samam624/ProjectTreebeard/MSV1/README.md

# MSV1: analog 555-timer probe

The first generation, from April 2026: an interdigitated comb electrode read by 555 timers, an RC
low-pass filter and a comparator. It showed soil moisture could be measured this way, and that the
analog output squeezed most of the useful range together.

| | |
| --- | --- |
| **Hardware** | [Probe PCB](hardware/) |
| **Write-up** | [Course report](<EEC284_Final_Paper (2).pdf>) (EEC 284, UC Davis) |
