samam624/ProjectTreebeard/MSV3/bootloader/README.md

# MSV3 recoverable OTA bootloader

`scripts/build_msv3_release.ps1` builds a board-specific Adafruit nRF52
bootloader from the pinned upstream 0.11.0 source and creates the production
application packages. The release configuration enables:

- single-bank application updates, using the Adafruit bootloader's default and bench-proven path;
- BLE recovery when no valid application exists (`DEFAULT_TO_OTA_DFU`);
- NIST P-256 signed DFU packages, with UF2 deliberately disabled;
- DFU compatibility tag `0x3356`, so generic Adafruit `0x0052` packages are rejected;
- the real active-high status LED on P1.10 and no nonexistent DFU buttons;
- SoftDevice S140 6.1.1 and its required internal-RC LFCLK boot path.

`DEFAULT_TO_OTA_DFU` currently makes automatic BLE recovery and bootloader USB CDC/DFU mutually
exclusive in the pinned upstream implementation. That is a known limitation, not the desired final
product behavior. The maintainer requires a future path that keeps both USB and BLE OTA while
preserving all recovery and authentication guarantees; see
`MSV3/docs/MSV3_USB_AND_BLE_OTA_COEXISTENCE_REQUIREMENT_2026-09-14.md`.

**Release 1.0.4 is the first build that addresses this, and it is BUILT BUT NOT INSTALLED.** No
probe runs it and none may until it passes the full acceptance list on probe 99. It runs **both
transports at once**: whenever the bootloader is in DFU mode and VBUSDETECT shows a cable, USB CDC
serial DFU is up for as long as the cable is there -- no timer, no window to miss, no mode to select
-- and BLE OTA runs on top of it rather than instead of it. With no cable, usb_init() is never
called and behavior is byte-for-byte 1.0.3. CDC only, never UF2: mass storage writes unsigned images
by definition and would route around signed-init verification, the device-type check and the version
floor. Mechanism, risks and the bench plan:
`MSV3/docs/MSV3_USB_AND_BLE_OTA_COEXISTENCE_DESIGN_2026-09-14.md`.

What made this safe is `dfu_transport_claim()`. Single-bank DFU erases the application before Init
authentication, and `dfu_register_callback()` holds a single `m_data_pkt_cb`, so two transports
feeding one bank would destroy the image with no recoverable copy on either side. The arbiter gives
the session to the first transport that presents traffic while the state machine is idle and refuses
the other until `dfu_init()` resets ownership -- the serial side silently consumes and drops the
packet so the host retries, the BLE side answers `NRF_ERROR_INVALID_STATE`. Do not add a third
caller of the DFU packet handlers without going through it.

The 1.0.4 patch is verified three ways, because they catch different failures. The source sentinel
(`MSV3_USB_BLE_COEXIST` in `src/main.c`) catches a patch that silently failed to apply. Two link-map
checks catch a patch that applied and still did not reach the binary -- one for
`msv3_usb_attach_if_vbus`, one for `dfu_transport_claim`. That second class is not hypothetical: the
first 1.0.4 build linked with no USB helper symbol at all because it had been inlined, exactly as
`check_dfu_mode()` already is. The helper is `noinline` for that reason. A source sentinel cannot
tell "compiled in" from "`#define` still sitting in the file".

Cost: FLASH 32,888 B (84.52%) on 1.0.3 to 33,208 B (85.34%) on 1.0.4, leaving about 5.7 KB in the
38 KB region. There is room for a fix, not for another feature.

MSV3 release 1.0.2 added an on-device monotonic application-version floor after a signed BLE
activation. Release 1.0.3 retains that protection and reserves the final eight bytes of RAM at
`0x2003FFF8` for the application's watchdog-loop recovery counter. The application linker reserves
the same address. Guard 2 must not be enabled with bootloader 1.0.2 or older.

That rule is now ENFORCED rather than merely written down, in two places. Every image
stamps `MSV3-GUARD2:1` or `MSV3-GUARD2:0` into itself, and `scripts/msv3_fleet.py` reads it
back out of a package: `ble_ota_update.py` refuses to transfer a guard-enabled image to a
probe whose `bootloader` in `MSV3/fleet.json` predates 1.0.3, and
`MSV3/scripts/arduino_msv3_probe.ps1` refuses to build one. Measured 2026-09-09 from
`vector[0]` of each release hex: 1.0.1 and 1.0.2 boot with MSP `0x20040000`, so the retained
record is the first memory their stacks descend into; 1.0.3 boots with MSP `0x2003FFF8`.
An image built before the marker existed carries none, and is accepted only on a bootloader
that already reserves the record, or when its image SHA-256 is pinned in that probe's
`legacy_package_sha256`.

The private key defaults to `MSV3/.secrets/msv3-dfu-signing-private.pem`, which
is ignored by Git. The generated bootloader contains its public key, so losing
the private key after the SWD pads are coated would make future signed updates
impossible. The build now fails if the key is missing instead of silently making
an incompatible one. Use `-GenerateSigningKey` only when deliberately establishing
a new trust root that will be installed over SWD, and make an offline backup before
coating a production board.

Generated release artifacts and a SHA-256 manifest go under
`MSV3/bootloader/generated/<version>/`. The future OTA package is signed. The
separately named `initial-install-from-stock` package is deliberately unsigned
because the existing stock bootloader cannot parse Adafruit's signed extended
init packet; use it exactly once to migrate an accessible board, then retain it
only as a factory/SWD-adjacent artifact.

The application version is explicit in every package. Stock Adafruit 0.11.0 and MSV3 1.0.1 do not
persist it. MSV3 1.0.2+ stores a monotonic floor in the bootloader settings page and refuses a
lower signed application after authenticating its init packet. Equality is deliberately allowed
so the exact known-good rescue package remains reinstallable. `MSV3/fleet.json` keeps a second,
host-side version floor and must be updated after every successful transfer.

Single-bank DFU erases the running application before writing its replacement, so
an interrupted update does not preserve the old application. It does remain
recoverable: an erased or invalid application makes the bootloader advertise its
BLE DFU service indefinitely. Release 1.0.0's experimental dual-bank image must not
be installed; on the bench it accepted and validated the application transfer but
failed the subsequent bank-0 boot validation.

Do not update this bootloader over BLE. Install it once over SWD before coating, finish
provisioning with a signed BLE application install so the anti-rollback floor is seeded, verify the
running DIS build ID and advancing wake counter, archive the equality-version rescue package, and
back up the signing key offline. The current production checklist is
`MSV3/docs/MSV3_FINAL_OTA_PRECOATING_HANDOFF_2026-09-08.md`.
