samam624/ProjectTreebeard/MSV4/hardware/MSV4_Probe_Enclosures/README.md

# MSV4 low-profile probe enclosures

This directory contains four printable, electronics-only enclosures derived
from the actual `../MSV4.step` assembly:

- **Integrated solar** - an MSV2-style lid with a bonded 36 x 30 mm panel
  recessed into its top.
- **Arm solar** - an MSV3-style articulated mount with two printable arms and
  a 36 x 30 mm panel frame.
- **Minimum-profile integrated solar** - a screwless two-piece enclosure with
  a thin closed back/base and a bonded solar lid. It has no gasket, screws,
  inserts, or moving parts. A PCB-shaped groove in the base registers the board
  during assembly.
- **Minimum-profile arm solar** - the same bonded, PCB-groove body fit with the
  proven external pivot bosses, arms, and panel frame. Its plain lid has no
  panel pocket. The body has no case screws or gasket; the articulated mount
  still uses its four pivot screws and inserts.

All four enclosure bases have a teardrop window centered over the upper D1 LED
package on the back of the PCB. The point faces upward toward the antenna/top
edge. Fill this window flush with optically clear epoxy after assembly to make
the status LED visible without leaving an open water path.

All variants leave the sensing blade exposed. Version 5 follows the actual PCB
shoulders into a 20.4 mm-wide neck around the 18 mm blade. In side profile, the
top and bottom faces slope down to a 3.0 mm-thick shell around the 1.6 mm PCB,
instead of ending in a full-thickness rectangular wall. The central body is
33.2 mm wide; only the front screw shoulder reaches 36.6 mm to carry the front
pair of M2 screws. Overall length is 53.7 mm.

Version 5.3 changes how the two screw-closed variants go together and how all
three look:

- The case screws go in from the back (the base, the face with the LED
  teardrop). Each head sits in a recessed 90-degree countersink in the base
  back, and the inserts are now in the lid. The lid top has no screw holes.
- The arm pivot bosses on the base and the pivot lugs on the panel frame are
  flat on the back of their part, so both print flat on the bed.
- The outer perimeter of every back and top face has a 45-degree chamfer:
  0.6 mm on the screw-case backs, 1.2 mm on the arm lid top, 0.8 mm on the
  integrated lid top, and 0.8 / 0.4 mm on the minimum-profile back / top. Each
  is as large as the screw-head recesses or the panel-pocket rim beside it
  allow; they are the `...Chamfer` parameters in the generator.

The top-side cavity roof is 7.0 mm above the PCB. Version 5.2 raised it from
4.0 mm because the battery actually fitted is a 3 mm-thick 301020-class cell
that rests on top-side components, not the 2 mm cell first assumed. The base is not sized around the battery: its floor follows the actual
bottom-side component envelope from `MSV4.step`, with 0.354 mm clearance below
the lowest SWD/LED geometry and a 1.2 mm closed floor. The battery belongs
above the PCB.

The renders below are from version 5 and show the earlier, 3 mm lower lids
with lid-side screws, round pivot mounts, and unchamfered edges.

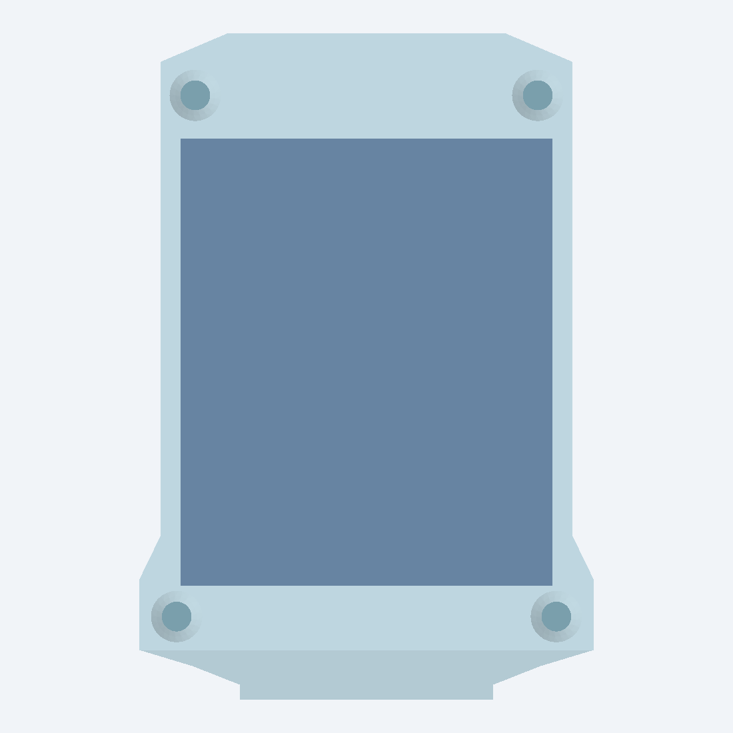
[picture p20: MSV4/hardware/MSV4_Probe_Enclosures/renders/integrated_v5_top.png]
Low-profile integrated solar enclosure


Low-profile arm solar enclosure

Minimum-profile integrated solar enclosure

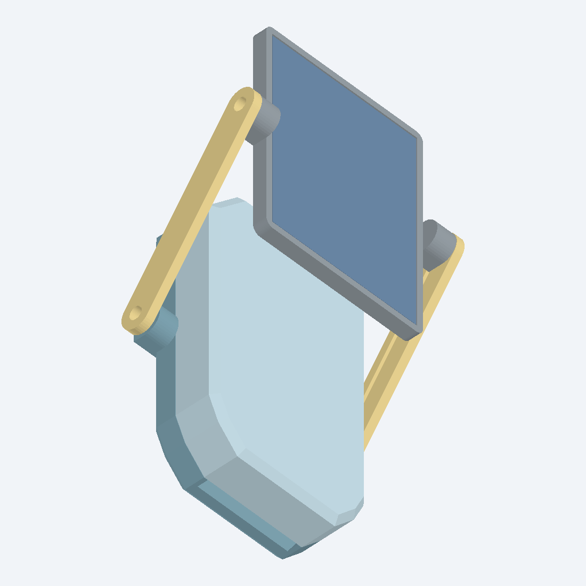
[picture p21: MSV4/hardware/MSV4_Probe_Enclosures/renders/minimum_profile_arm_v5_5_isometric.png]
Minimum-profile arm solar enclosure v5.5


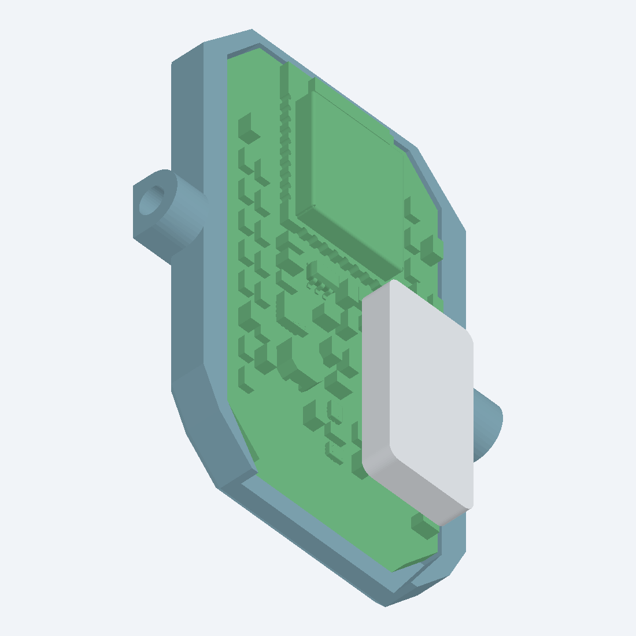
[picture p22: MSV4/hardware/MSV4_Probe_Enclosures/renders/minimum_profile_arm_v5_5_fit_open_isometric.png]
Minimum-profile arm open PCB fit check


## Deliverables

`output/` holds one drag-and-drop print file per enclosure and nothing else:

- `MSV4_arm_solar_PRINT.3mf`
- `MSV4_integrated_solar_PRINT.3mf`
- `MSV4_minimum_profile_solar_PRINT.3mf`
- `MSV4_minimum_profile_arm_solar_PRINT.3mf` - the minimum-profile body with the
  same proven PCB-shaped registration groove, four broad PCB support pads,
  pivot geometry, arms, and panel frame
  as the earlier variants (added 2026-10-30, not yet printed). The lid is plain
  at the arm-lid height with one 3 mm wire exit on the left. There are no case
  screws or gasket; tape the body closed for a fit test, then bond the seam.
  The normal release validator checks this variant and rejects the duplicate
  thin shelves/fins that were present in its first draft.

Each imports into Bambu Studio or OrcaSlicer as separate, named, pre-oriented
objects. See `PRINTING.md` before printing.

`output/reference/` holds everything else: the STEP bodies and assemblies, the
fit-check assemblies, the design and validation reports, and the optional TPU
gasket.

## Recommended development workflow

Start with the two reopenable, screw-closed versions while the electronics are
still being developed:

1. Print and test the **integrated solar** enclosure as the static-panel,
   non-arm baseline.
2. Print and test the **arm solar** enclosure to determine whether adjustable
   panel angle produces enough practical charging benefit to justify the extra
   parts, hardware, assembly time, and potential weather-sealing points.
3. Compare charging performance, placement flexibility, durability, water
   resistance, handling, and overall bulk while firmware, sensing behavior,
   battery operation, and solar charging are still being finalized.
4. Move to the permanently bonded **minimum-profile integrated solar**
   enclosure only after those systems are stable enough that routine access to
   the PCB is no longer needed.

The minimum-profile arm variant is the glued-seam/no-body-screw experiment. Do
not treat it as the default until one physical fit and leak test confirms it.

The normal assemblies contain the enclosure parts plus a clearly named
do-not-print solar-panel reference. The fit-check assemblies additionally
contain the corrected PCB and an illustrative 10 x 20 x 3 mm top-side battery
placement reference. The minimum-profile fit check also includes a red E73
antenna keepout reference. The STEP assemblies open directly in Fusion 360
and preserve separate assembly solids; no Fusion conversion is required.

## Design basis

The source STEP contains 233 solids. Its exported PCB substrate is 0.41148 mm
thick, while the MSV4 fabrication files specify 1.60 mm FR4. The fit-check
models preserve the top surface and move the bottom-side components down by
1.18852 mm. This avoids false clearances from the thin raw export.

The reconstructed 1.60 mm substrate is checked bidirectionally against the
original STEP footprint. The mismatch volume is 0 mm3. The validator also
checks the complete straight blade through both halves of the split throat;
the collision volume is 0 mm3 in both variants.

Measured and checked version 5.3 clearances are:

- 0.35 mm at each PCB side
- 3.898 mm above the tallest top component within the 7.0 mm roof envelope
- 0.354 mm below the lowest corrected bottom component
- 0.250 mm below the illustrative top-side battery placement
- 2.100 mm between that 3.2 mm battery reference and the internal roof; this
  spare headroom is intentional for the first fit print and is expected to be
  reduced afterwards
- 0.10 mm nominal PCB rail clamp interference
- 2.833 mm minimum arm sweep clearance over the lid
- 0 mm3 battery-to-component, panel-to-pocket, and reference-to-shell collision
- every screw-head recess wall closed against the back chamfer, and the lid
  top closed above all eight screws

The integrated-panel central case is 13.90 mm thick and the arm-mount central
case is 12.50 mm thick. The arm pivot bosses end on the base back plane and add
no thickness. These stacks retain a 1.2 mm closed
floor, a 1.0 mm arm-lid roof, and a 0.8 mm solar-pocket back wall, so the
extra battery room comes entirely from height: none of those skins had 3 mm
to give.

The minimum-profile enclosure is 13.65 mm thick overall and 32.4 x 50.2 mm in
plan. Its base provides a 1.0 mm closed back below the component cavity. The
groove follows the real PCB head and shoulder with 0.25 mm XY clearance. Four
3 x 4 mm rounded pads rise directly from the floor and support the bare PCB
underside at Z = -1.60 mm; they avoid the six bottom-side components clustered
near the LED end. The lowest corrected back-side component retains 0.304 mm
floor clearance. The panel ends at Y = 140.00 mm; the E73 antenna keepout begins at
Y = 140.75 mm, giving a checked 0.75 mm plan-view separation.

The minimum-profile arm body uses that same 32.4 x 50.2 mm plan, registration
groove, and four floor-tied support pads, with the proven pivot bosses bringing only the local maximum width to
40.2 mm. Its closed body is 12.25 mm thick. Validation finds 0 mm3 PCB,
component, base/lid, wire-path, or arm-sweep collision, and explicitly finds
0 mm3 of the rejected draft's duplicate interior shelves and compression fins.

The solar-panel pocket is 36.4 x 30.4 x 1.6 mm. The physical panel thickness
was not supplied. Measure it before committing to a final print and change
`solarPanelRecessDepth` in `design/generate_enclosures.mjs` if necessary.
Version 5.1 places the two 1.6 mm lead passages as a centered pair, 4.0 mm
apart, to match the rear terminals on the new 2.5 V panels. This centered
layout is shared by the integrated lid, minimum-profile lid, and arm frame.

On the arm variant, both leads enter the case through a single 3.0 mm hole in
the negative-X side wall of the lid at the pivot station, as on MSV3. It
replaces two 1.6 mm holes that stopped 0.05 mm short of the PCB compression
rail and so never opened into the cavity. The panel frame sits 3 mm higher
than in version 5.1 so the panel keeps its height above the taller lid.

The panel frame is 2.6 mm thick, too thin to hold an M2 insert, so its pivot
lugs cannot be flush with both faces. They are flat on the frame back and rise
2.8 mm above the panel face at the two side edges. The pivot axis is therefore
1.4 mm higher than in version 5.2 (Z = 18.4 mm), the frame itself has not
moved, and the arms are 0.8 mm longer between centers.

## Water resistance

The design keeps the useful MSV3 features: continuous PCB retention, a split
close-fit blade throat, blind insert pockets, base-owned arm pivots, covered
wire passages, and a gasket land. The lid is now one continuous top skin. This
removes the old two-level, scalloped roof that looked like an inverted tray.
With the screws entering from the back, that skin is also unbroken by
fasteners; the screw bores are open only on the base back.

The seal path is a 0.80 mm-wide by 0.55 mm-deep groove in the seam face of the
base. It moved there from the lid in version 5.3 because the lid's insert
pockets would have broken into it. Use silicone cord,
formed-in-place RTV, or the supplied 0.8 mm TPU gasket. The gasket is open only
at the blade exit, where the split throat must be sealed with neutral-cure RTV
or a suitable potting compound. Seal the panel perimeter and wire passages as
described in the print guide.

This is a waterproof-oriented FDM design, not an IP-rated housing. Leak-test an
empty enclosure before installing electronics.

Both minimum-profile enclosures have a closed back but no body gasket or case
fasteners.
After confirming the board is fully seated in its base groove, bond and seal
the complete base-to-lid seam with electronics-compatible epoxy or outdoor
polyurethane adhesive. Seal the panel perimeter, wire passages, probe exit,
and LED window before leak testing.

## Fasteners

The integrated and arm cases use:

- 4 x M2 x 8 mm, 90-degree countersunk flat-head screws (both versions)
- 4 x M2 heat-set inserts, nominally 3 mm OD x 3 mm long

The screws are driven from the back. Each head pocket in the base back is a
4.2 mm x 0.4 mm recess above a 90-degree countersink, so a standard 3.8 mm
head finishes level with or up to 0.3 mm below the back face. The insert
pilots are in the lid seam face: blind, 2.90 mm diameter x 3.20 mm deep, with
tip relief to 4.2 mm above the seam. The arm variant
adds four M2 x 5-6 mm pivot screws and four more inserts of the same size.
Insert brands vary; verify one sacrificial pocket before installing all of them.
The minimum-profile integrated enclosure uses no screws, inserts, gasket, or
other hardware; its lid is permanently bonded to the base. The minimum-profile
arm enclosure also bonds its lid, but still needs the four pivot screws and
inserts listed above for the articulated mount.

## Regeneration and verification

From this directory:

```powershell
node design/generate_enclosures.mjs
node tools/validate_enclosures.mjs
```

The validator checks solid counts, source-PCB fidelity, component collisions,
fastener openings, arm sweep, assembly overlap, and that every object in each
print file is a watertight mesh sitting on the bed. The current report is
`output/reference/MSV4_enclosure_validation_report.json`.

If native Fusion archives are desired later, run
`fusion/MSV4_Enclosure_Assemblies/MSV4_Enclosure_Assemblies.py` from Fusion's
Utilities > Scripts and Add-Ins dialog. It imports the checked STEP assemblies
and writes F3D plus Fusion-translated STEP files to
`output/reference/fusion_exports/`.
