samam624/ProjectTreebeard/docs/SWD_FLASHER.md

# ESP32-S3 as an SWD flasher for nRF52840

`arduino/MSV2_ESP32_SWD_Flasher` turns a spare ESP32-S3 devkit into a standalone
SWD debug adapter for nRF52840 targets — built for and bench-validated against
a bare Ebyte E73-2G4M08S1C module (the MCU used on MSV3), and equally usable
against XIAO nRF52840 Sense probes. It bit-bangs the ARM SWD protocol from
scratch on three GPIOs — no OpenOCD, no J-Link, no external debug probe
hardware needed. Useful for boards with no USB/DFU bootloader at all, or a
broken one.

**Status: fully working, end to end, on real hardware (2026-08-20).** On a
bare Ebyte E73-2G4M08S1C module (hand-held pad contact, no soldering):
`id`/`probe` confirmed a real, unprotected nRF52840 (`DPIDR = 0x2BA01477`,
`AP0 IDR = 0x24770011`, correct 1MB/4KB-page flash geometry); the chip's prior
content was an incomplete MBR-only fragment, not a working bootloader; a full
mass erase plus 5-region bootloader install (`pca10056_bootloader-0.11.0_s140_6.1.1.hex`)
completed with every segment verified; and after `run`, the chip booted into
the new bootloader and enumerated correctly as `NRF52BOOT` with matching
`INFO_UF2.TXT` (version, board ID, and SoftDevice all exactly as flashed). A
test application (`arduino/MSV3_E73_LED_Test`, blinks the D2 LED on P1.10)
was then compiled for `adafruit:nrf52:pca10056`, converted to `.uf2`, and
drag-and-dropped onto the `NRF52BOOT` drive — it booted and the LED blinked,
confirming the bootloader can actually accept and run new firmware, not just
enumerate. See "Bring-up history" below for the issues hit and fixed along
the way.

## Wiring

3.3V logic on both sides — no level shifting.

| ESP32-S3 GPIO | Signal | Target (nRF52840) |
|---|---|---|
| GPIO5 | SWCLK | SWCLK |
| GPIO6 | SWDIO | SWDIO |
| GPIO7 | nRESET | RESET |
| GND | GND | GND |

Do **not** connect target VDD to the ESP32-S3. The target keeps powering itself
(its own USB/battery) — this adapter only drives debug signals.

On a bare E73-2G4M08S1C module, SWDIO/SWCLK/RESET are castellated pads on the
module itself (check Ebyte's E73-2G4M08S1C datasheet pinout for exact pad
locations). On a XIAO nRF52840 Sense, they're unpopulated test points on the
underside of the board instead — check Seeed's pinout diagram for that case.

## Building and flashing the adapter itself

```powershell
.\scripts\arduino_swd_flasher.ps1 -Action compile
.\scripts\arduino_swd_flasher.ps1 -Action upload -Port COM3
```

Swap `COM3` for whatever `.\scripts\arduino_swd_flasher.ps1 -Action board-list`
reports — ports shift.

## Talking to it

It's a plain USB-serial command console at 115200 baud (native USB CDC, so a
reset is a real USB disconnect/reconnect — same caveat as the display receiver,
see `flash-esp32-display`). Use `scripts/serial_capture.py` if you need a
capture that survives a reset; a live interactive session (`arduino-cli monitor`
or a terminal program) is fine for the id/halt/rd/wr commands since those don't
reset the adapter itself.

```
help                    - list commands
id                      - connect (read-only) and report DPIDR / AP IDR / flash geometry
probe                   - loop checking for SWD contact, for hand-held wiring bring-up
halt                    - hardware-reset target, then halt the core
run                     - resume core execution, release debug
reset                   - pulse nRESET only, no SWD traffic
rd <hexaddr>            - read one 32-bit word
wr <hexaddr> <hexval>   - write one 32-bit word (raw, expert use — this is a
                          direct AHB bus write, no safety net)
erase CONFIRM           - mass-erase the entire target flash
flash <hexaddr> <declen> - receive <declen> raw bytes over serial (chunked,
                          acked), then erase+program+verify at <hexaddr>,
                          with live progress lines
mem                     - report free heap AND largest contiguous block
                          (the second number is what actually bounds
                          `flash`'s image buffer)
restart                 - soft-reboot this adapter (clears heap fragmentation
                          from a long interactive session; doesn't touch the
                          target)
```

### Hand-held test-point contact (no soldering)

If you're holding wire tips against a board's SWD test pads instead of
soldering, `id`/`erase`/`flash` aren't the right first tool — a momentary
contact drop mid-transaction just looks like a generic failure, with no signal
about whether the wiring is right or you just need to press harder. Use
`probe` instead: it retries a lightweight connect check ~7x/second and only
prints on a state change, so you can watch it live while adjusting pressure.

Open a live terminal against the port (`arduino-cli monitor -p COM3 -c
baudrate=115200`, or PuTTY, or the Arduino IDE's Serial Monitor — any of these
work fine here since, unlike a flash/reset capture, this is a plain ongoing
session with no port renumbering involved), type `probe`, then press the wires
against the pads:

```
probe: watching for SWD contact. Send any character to stop.
probe: still no response (attempt 20)
>>> CONTACT MADE (attempt 34) DPIDR = 0x2BA01477
>>> contact lost
>>> CONTACT MADE (attempt 41) DPIDR = 0x2BA01477
```

A real target should report the *same* DPIDR value every time contact is
made — if it comes back with different nonzero garbage on different attempts,
that's a wiring/contact problem (e.g. SWCLK and SWDIO swapped, or a marginal
short), not a working connection, even though `probe` reported "contact." Once
you're getting solid, repeatable contact, send Enter to stop `probe` and move
on to `id` for the full picture (flash size, page count, etc.).

### Typical bring-up sequence on a new target

1. Wire it up, power the target normally, run `id`. Confirm `DPIDR`, the AP CSW
   readback matches what was written, and FICR page size/flash size look like a
   real nRF52840 (1MB flash / 4KB pages), not `0xFFFFFFFF` (see APPROTECT note
   below).
2. `rd`/`wr` a scratch RAM address (e.g. `0x20000000`) to sanity-check memory
   access before touching flash.
3. `erase CONFIRM`, then `id` again to confirm the chip still responds.
4. Flash a real image (see below), or a small known-good test region with
   `flash <hexaddr> <declen>` first if you just want to sanity-check the write
   path.

### Flashing a compiled Arduino sketch (single region, address 0)

Export a `.bin` from `arduino-cli compile --export-binaries` — that's a flat
image meant to run from address 0, not an Intel HEX file with embedded
addresses, so `scripts/swd_flash_hex.py` doesn't apply here. Instead, issue
`flash 0 <length>` yourself in an interactive session and send the raw file
bytes right after the `flash: send raw binary now` prompt (any short script
that writes the file to the serial port works; match the byte count exactly,
since the device only reads that many bytes before returning to command mode).

This is only relevant for a chip with **no bootloader** (or one you're
deliberately bypassing). Once a target has a working bootloader installed
(see below), flashing new applications to *that* chip no longer needs SWD at
all — see "Flashing an application once the bootloader is installed" further
down.

### Flashing a bootloader (multi-region .hex, e.g. restoring USB/DFU)

A bootloader image isn't one flat block — it's several disjoint regions (MBR,
SoftDevice, bootloader code, a settings page, and a UICR register that tells
the chip's own MBR where the bootloader lives). `scripts/swd_flash_hex.py`
parses a `.hex` file into its contiguous segments and drives one `flash` call
per segment, handling addresses automatically:

```powershell
python scripts/swd_flash_hex.py --port COM3 --hex arduino/MSV2_ESP32_SWD_Flasher/bootloaders/pca10056_bootloader-0.11.0_s140_6.1.1.hex --mass-erase
```

That bundled hex is Nordic's generic **pca10056** (nRF52840-DK) board profile
from [Adafruit_nRF52_Bootloader](https://github.com/adafruit/Adafruit_nRF52_Bootloader)
(MIT licensed) — the right starting point for a **bare nRF52840 module with
no board-specific bootloader of its own** (this project's actual hardware is
an Ebyte E73-2G4M08S1C module, not a XIAO board — see
`bootloaders/README.md` for why `pca10056` and not a XIAO-specific build).
The same overall recipe (bit-banged SWD probe → mass erase → program the hex)
is independently confirmed working for bare E73-2G4M08S1C modules in
[this Nordic DevZone thread](https://devzone.nordicsemi.com/f/nordic-q-a/93841/first-time-noob---flashing-bootloader-onto-e73-2g4m08s1c-nrf52840-modules)
and (for a XIAO board specifically) in
[this bootloader-recovery write-up](https://www.pavelp.cz/posts/eng-xiao-nrf52840-bootloader-recovery/).
Every image built on this bootloader project writes the same 5-region shape:

| Address | Size | Contents |
|---|---|---|
| 0x00000000 | 2.8 KB | MBR |
| 0x00001000 | 149 KB | SoftDevice (S140 7.3.0) |
| 0x000F4000 | 33 KB | Bootloader code |
| 0x000FD800 | 88 B | Bootloader settings page |
| 0x10001014 | 8 B | UICR (bootloader address pointer) |

**Always mass-erase before writing a bootloader from scratch** (`--mass-erase`
above, or `erase CONFIRM` yourself first) — per the write-up above, skipping
this leaves whatever old application was at address 0 in place; it keeps
executing after the bootloader write and can corrupt the bootloader again.
This is why `flash`'s own per-call erase isn't a substitute: it only erases
the region it's about to write, not the rest of the chip.
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
