samam624/ProjectTreebeard/assets/plant_gifs/color_zigzag_pot.gif

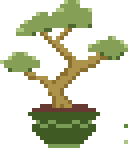
assets/plant_gifs/color_zigzag_pot.gif
