samam624/ProjectTreebeard/assets/plant_gifs/cup_plant.gif

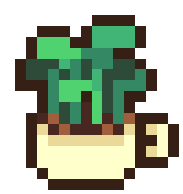
assets/plant_gifs/cup_plant.gif
