samam624/ProjectTreebeard/assets/plant_gifs/spindly.gif

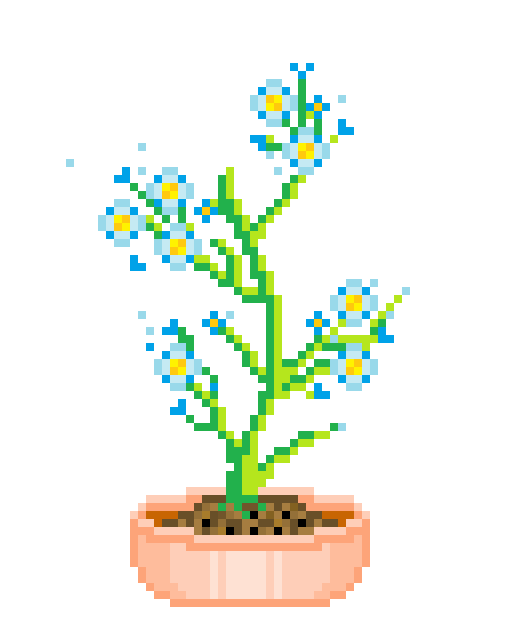
assets/plant_gifs/spindly.gif
