samam624/ProjectTreebeard/assets/plant_gifs/sprout_pot.gif

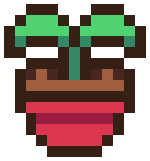
assets/plant_gifs/sprout_pot.gif
