samam624/ProjectTreebeard/cloud/docs/ALOCASIA_GP_WATERINGS_2026-10-11.png

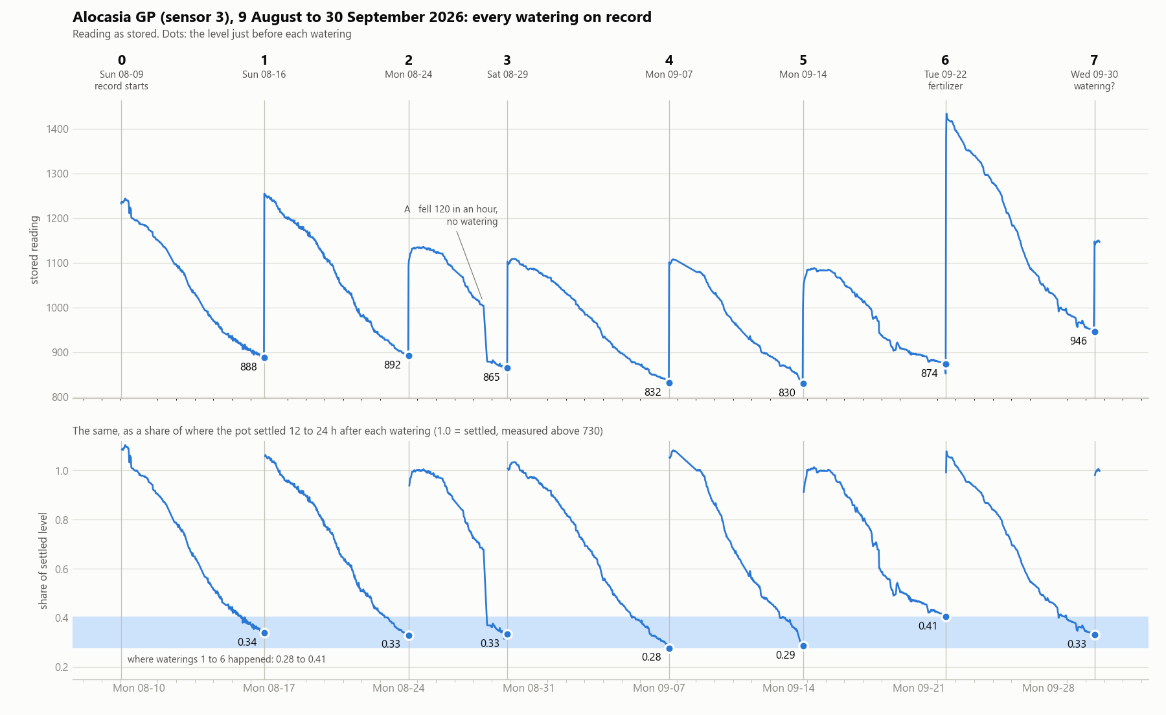
cloud/docs/ALOCASIA_GP_WATERINGS_2026-10-11.png
