samam624/ProjectTreebeard/cloud/docs/MOISTURE_PERCENT_DRYDOWNS_2026-10-11.png

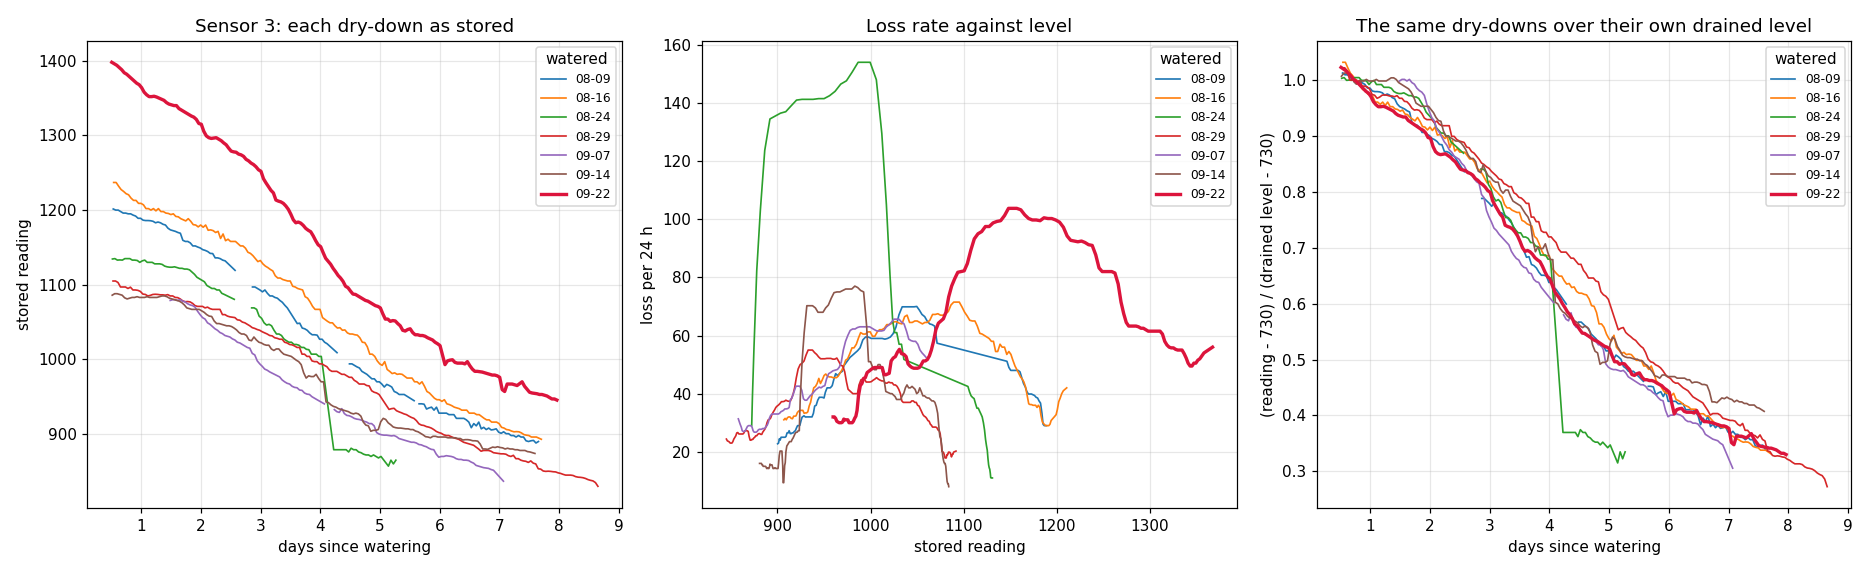
cloud/docs/MOISTURE_PERCENT_DRYDOWNS_2026-10-11.png
