samam624/ProjectTreebeard/cloud/web/plant-dashboard/assets/plant_gifs/cactus_cluster.gif

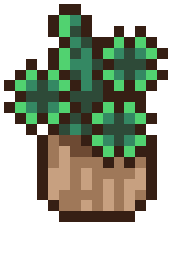
cloud/web/plant-dashboard/assets/plant_gifs/cactus_cluster.gif
