samam624/ProjectTreebeard/cloud/web/plant-dashboard/assets/plant_gifs/color_hanging_clump.gif

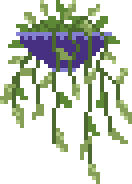
cloud/web/plant-dashboard/assets/plant_gifs/color_hanging_clump.gif
