samam624/ProjectTreebeard/data/sensor_logs/latest/sensor10_vs_mass.png

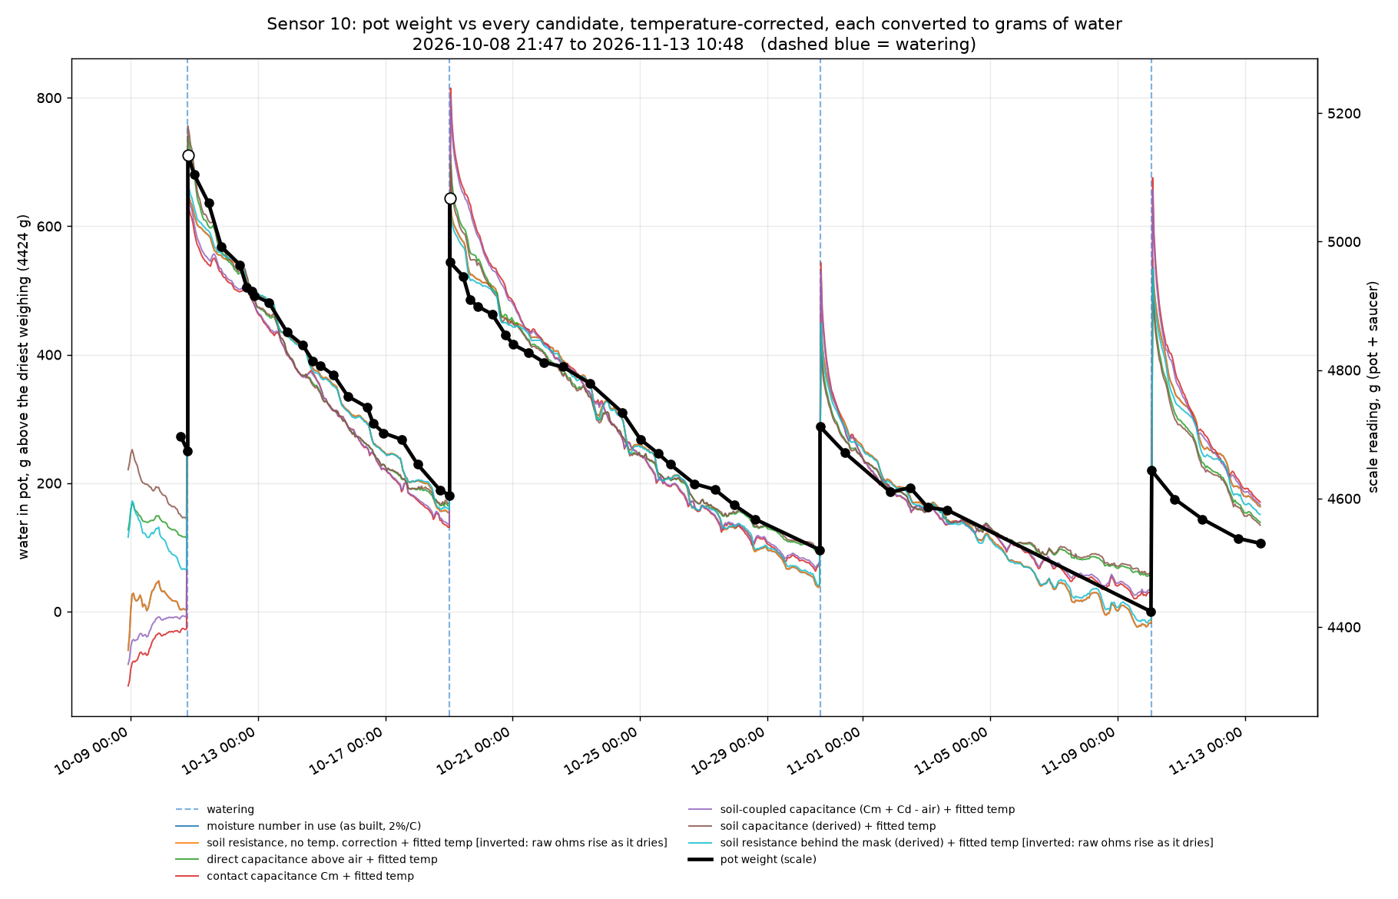
data/sensor_logs/latest/sensor10_vs_mass.png
