samam624/ProjectTreebeard/data/sensor_logs/latest/sensor11_mass_vs_moisture.png

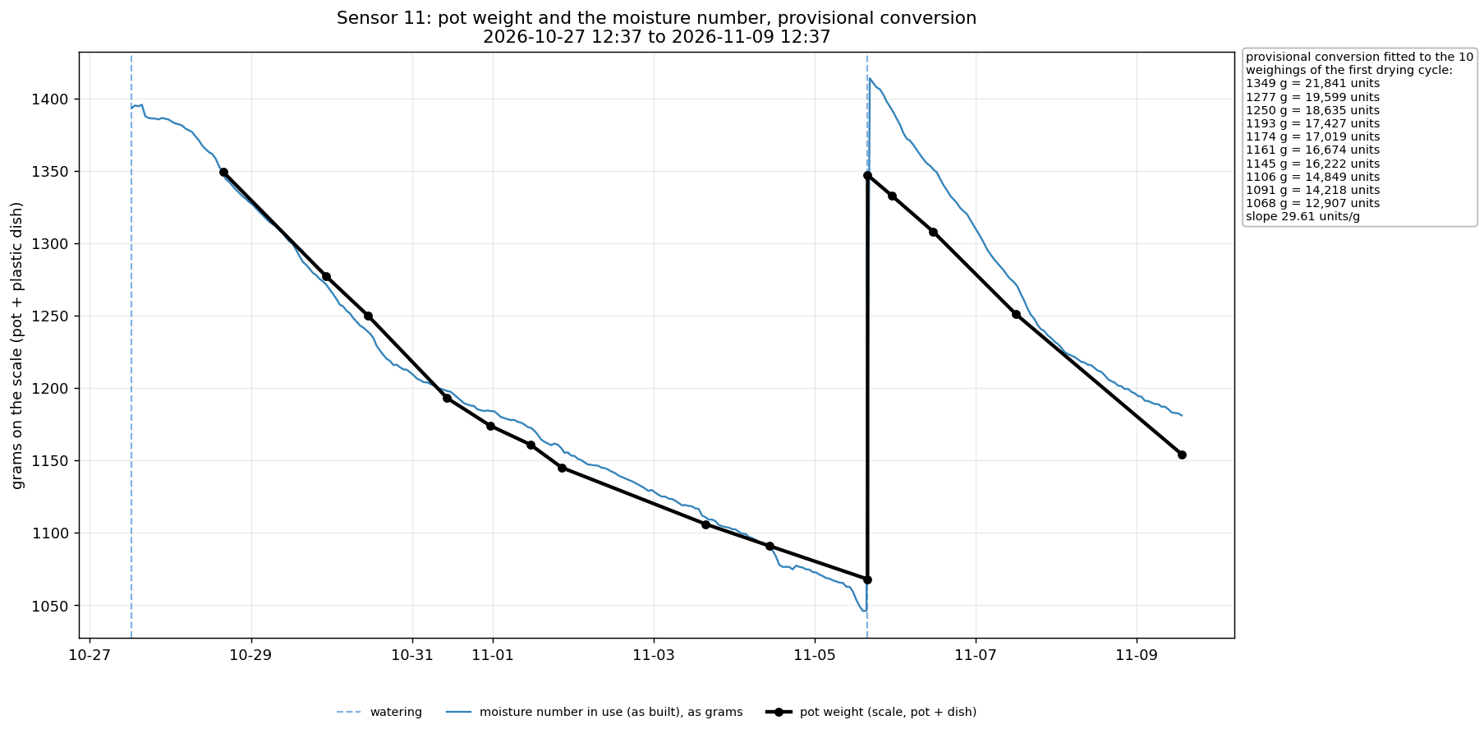
data/sensor_logs/latest/sensor11_mass_vs_moisture.png
