samam624/ProjectTreebeard/data/sensor_logs/msv4_cuptest_cm_vs_cd_2026-10-14.png

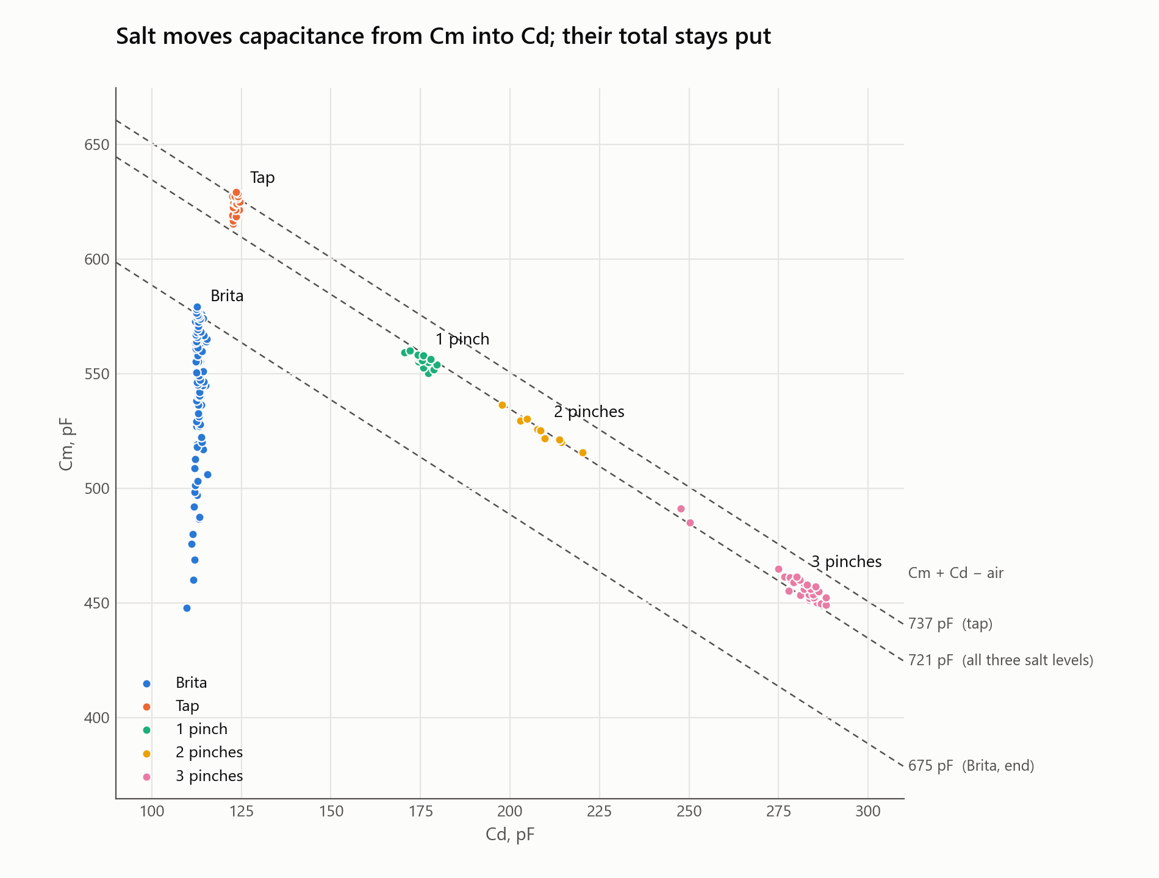
data/sensor_logs/msv4_cuptest_cm_vs_cd_2026-10-14.png
