samam624/ProjectTreebeard/data/sensor_logs/msv4_cuptest_salt_ladder_2026-10-14.png

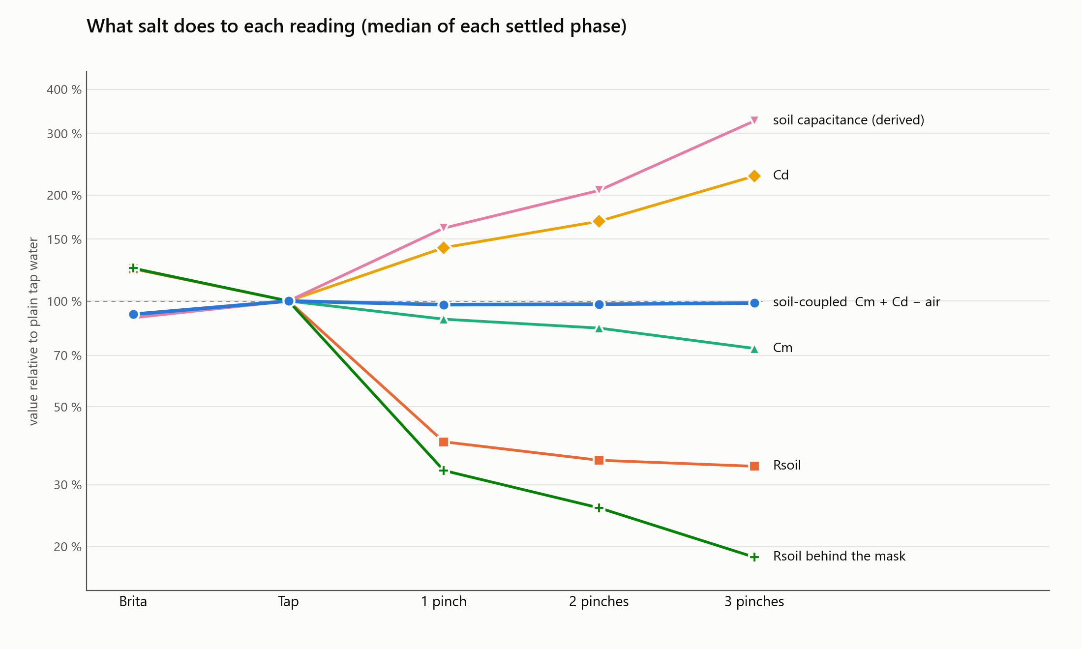
data/sensor_logs/msv4_cuptest_salt_ladder_2026-10-14.png
