samam624/ProjectTreebeard/data/sensor_logs/msv4_mass_vs_cm.png

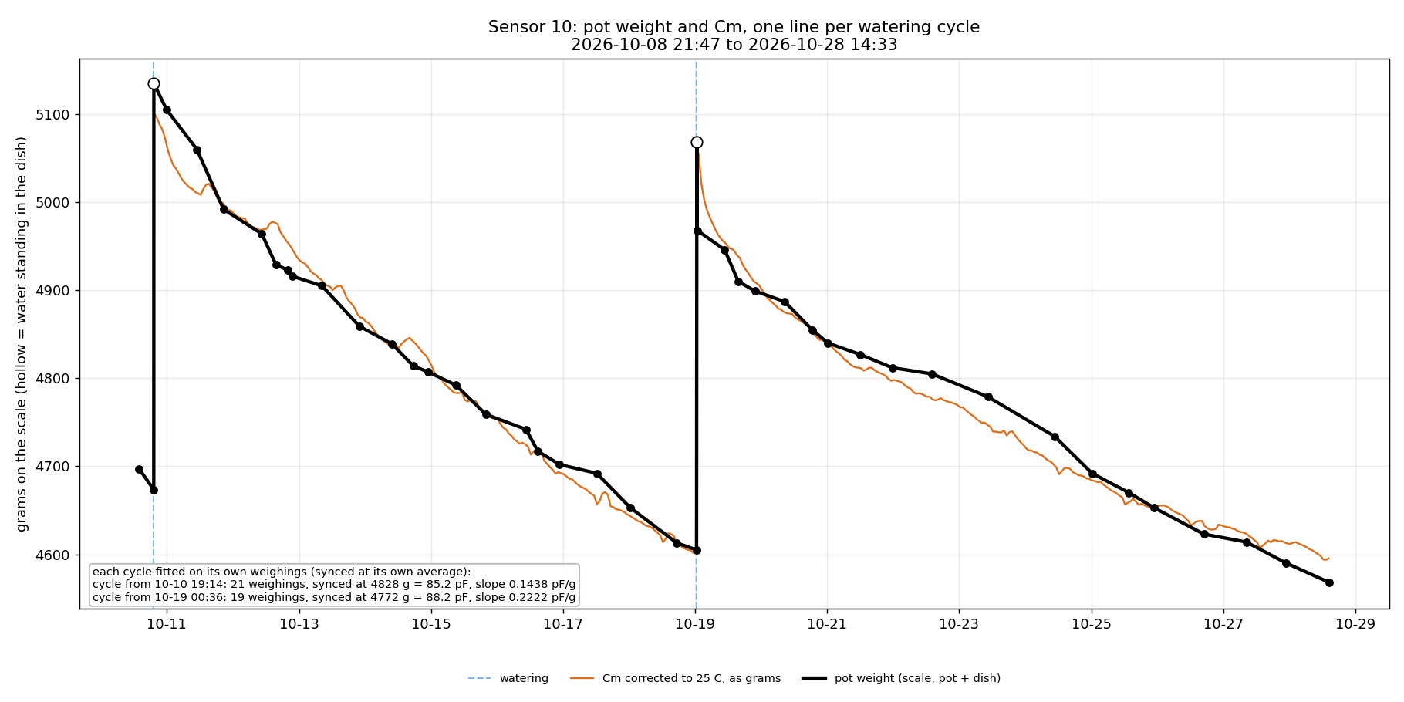
data/sensor_logs/msv4_mass_vs_cm.png
