samam624/ProjectTreebeard/data/sensor_logs/msv4_moisture_vs_mass.png

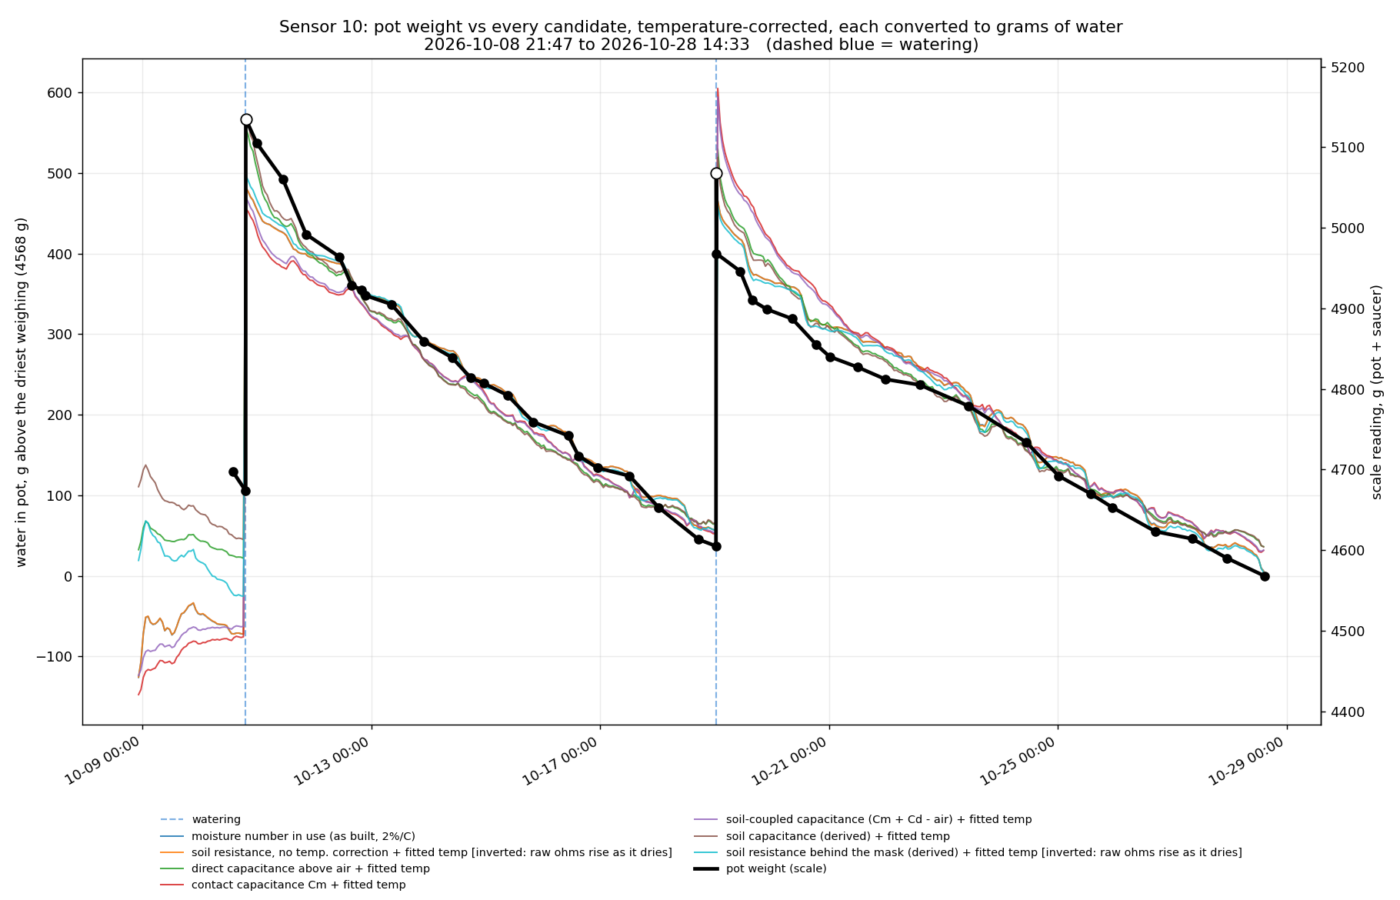
data/sensor_logs/msv4_moisture_vs_mass.png
