samam624/ProjectTreebeard/data/sensor_logs/msv4_moisture_vs_mass_2026-10-12d.png

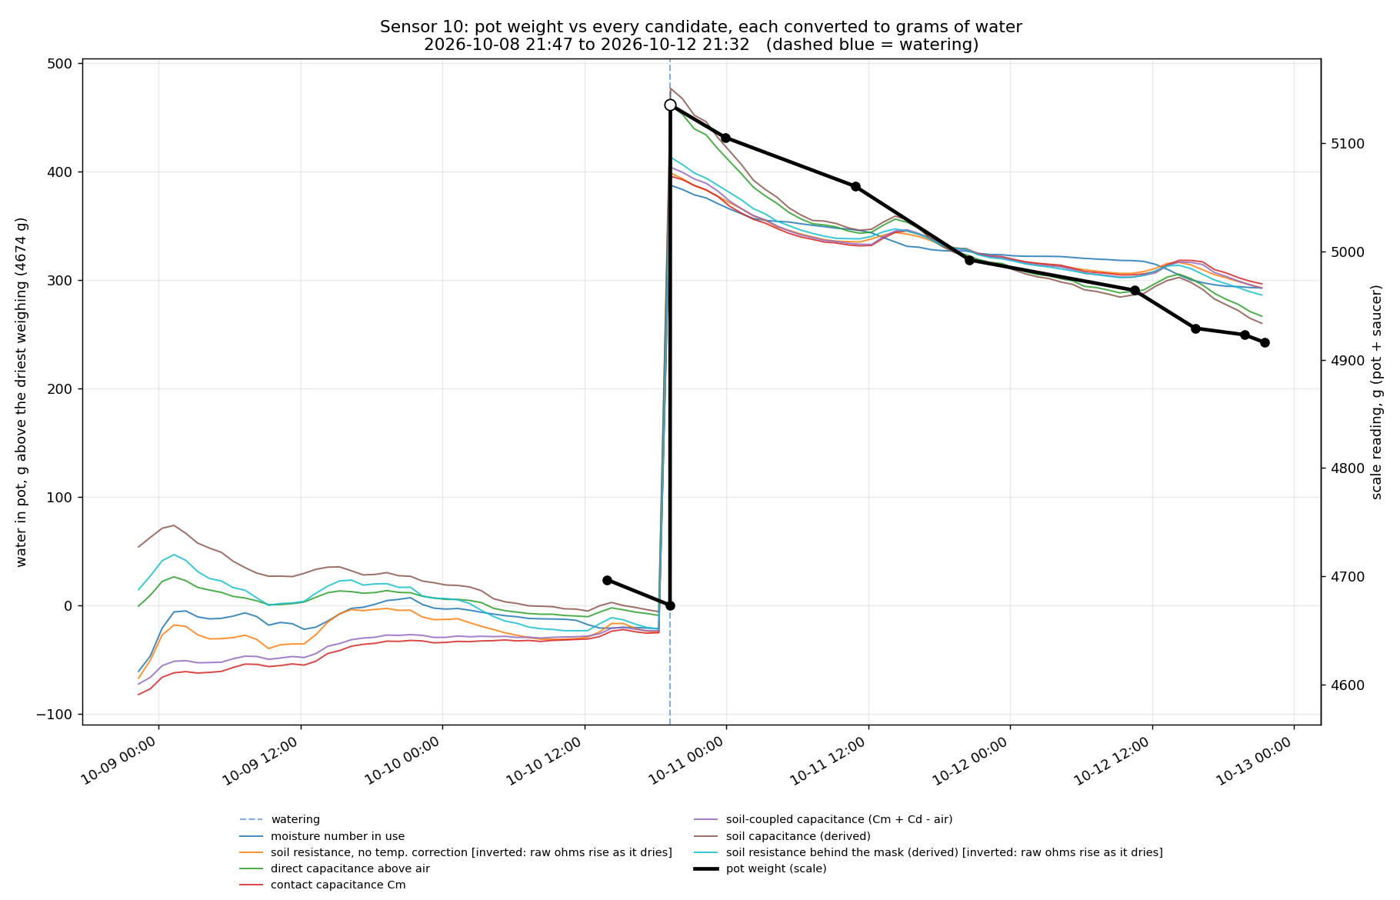
data/sensor_logs/msv4_moisture_vs_mass_2026-10-12d.png
