samam624/ProjectTreebeard/data/sensor_logs/msv4_moisture_vs_mass_corrected_2026-10-12.png

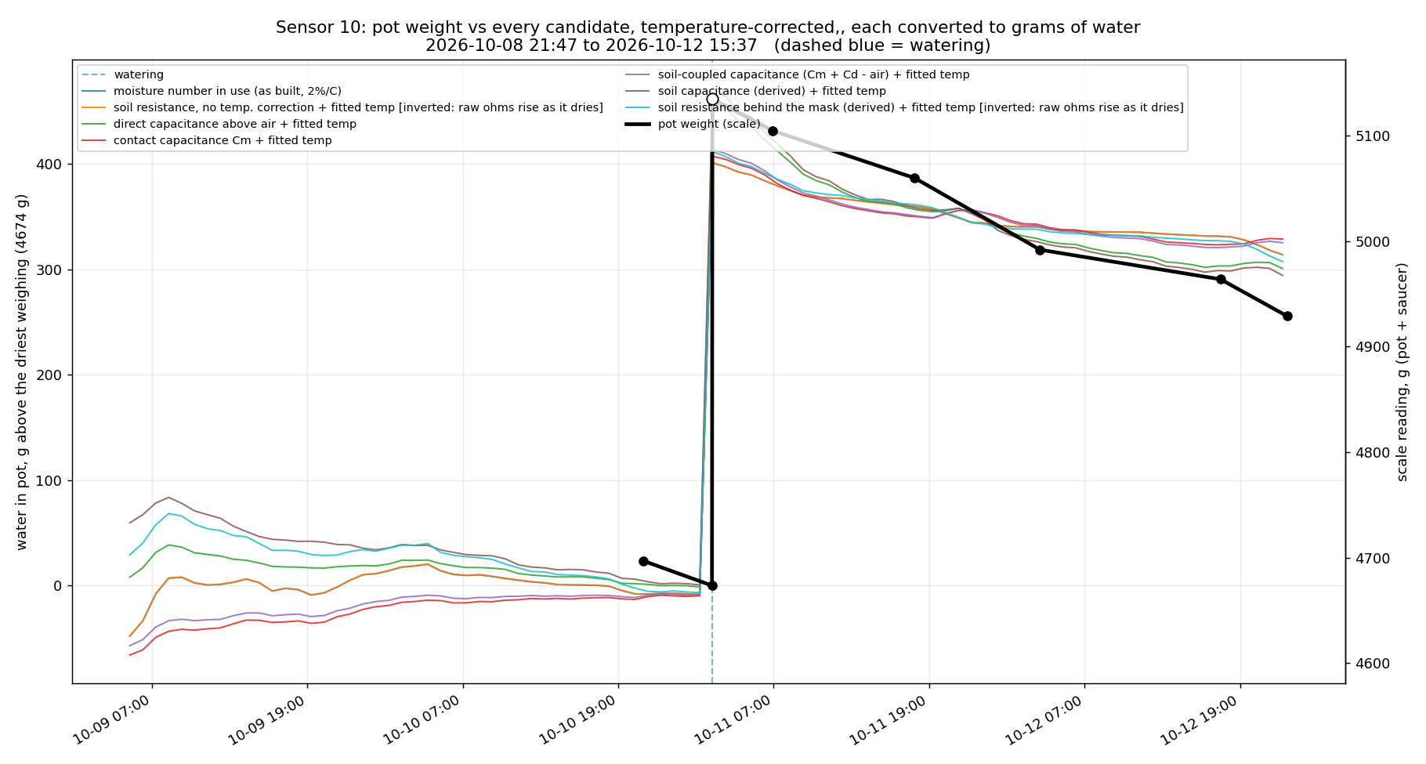
data/sensor_logs/msv4_moisture_vs_mass_corrected_2026-10-12.png
