samam624/ProjectTreebeard/data/sensor_logs/msv4_rawsweep_loop_2026-10-15.png

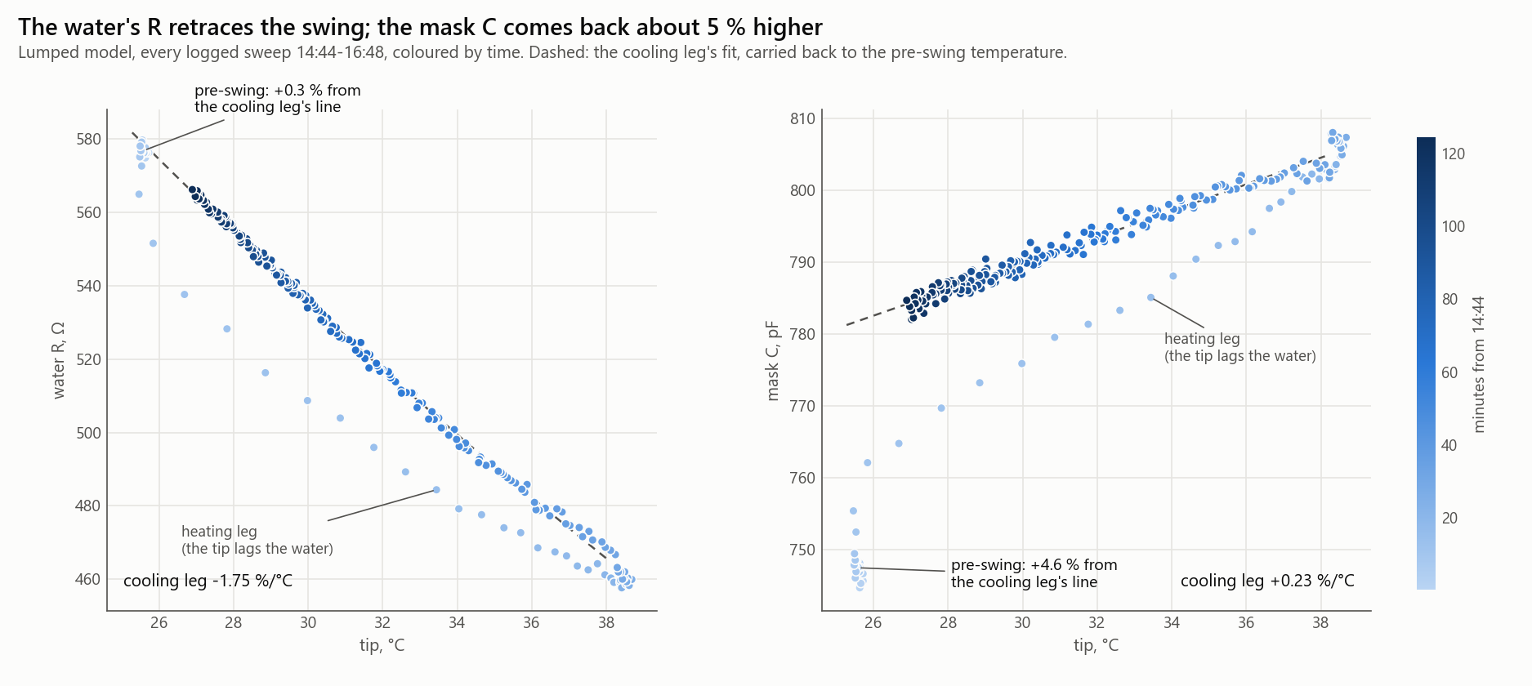
data/sensor_logs/msv4_rawsweep_loop_2026-10-15.png
