samam624/ProjectTreebeard/data/sensor_logs/msv4_sensor11_single_rc_sweeps.png

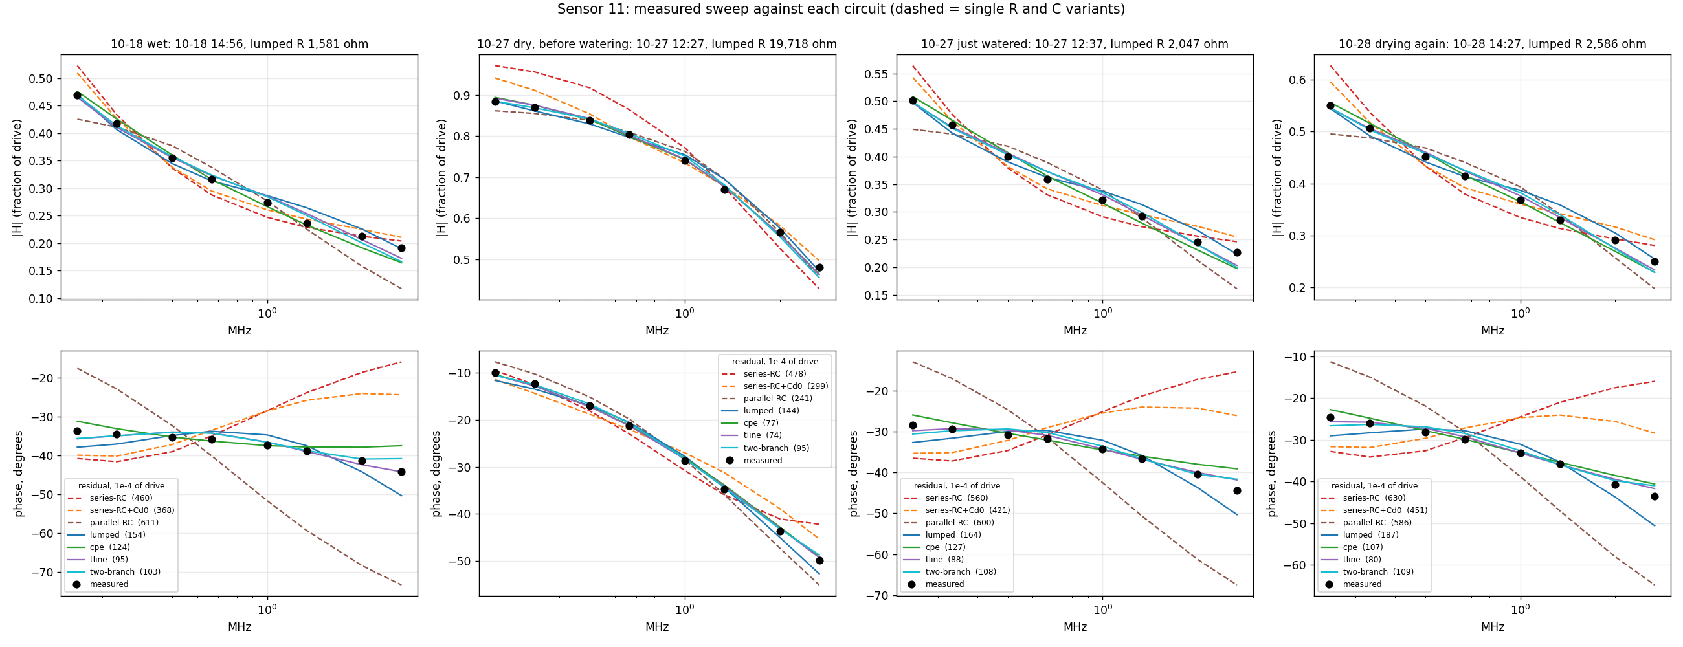
data/sensor_logs/msv4_sensor11_single_rc_sweeps.png
