samam624/ProjectTreebeard/data/sensor_logs/msv4_soil_cap_res_vs_water_clean_2026-10-14.png

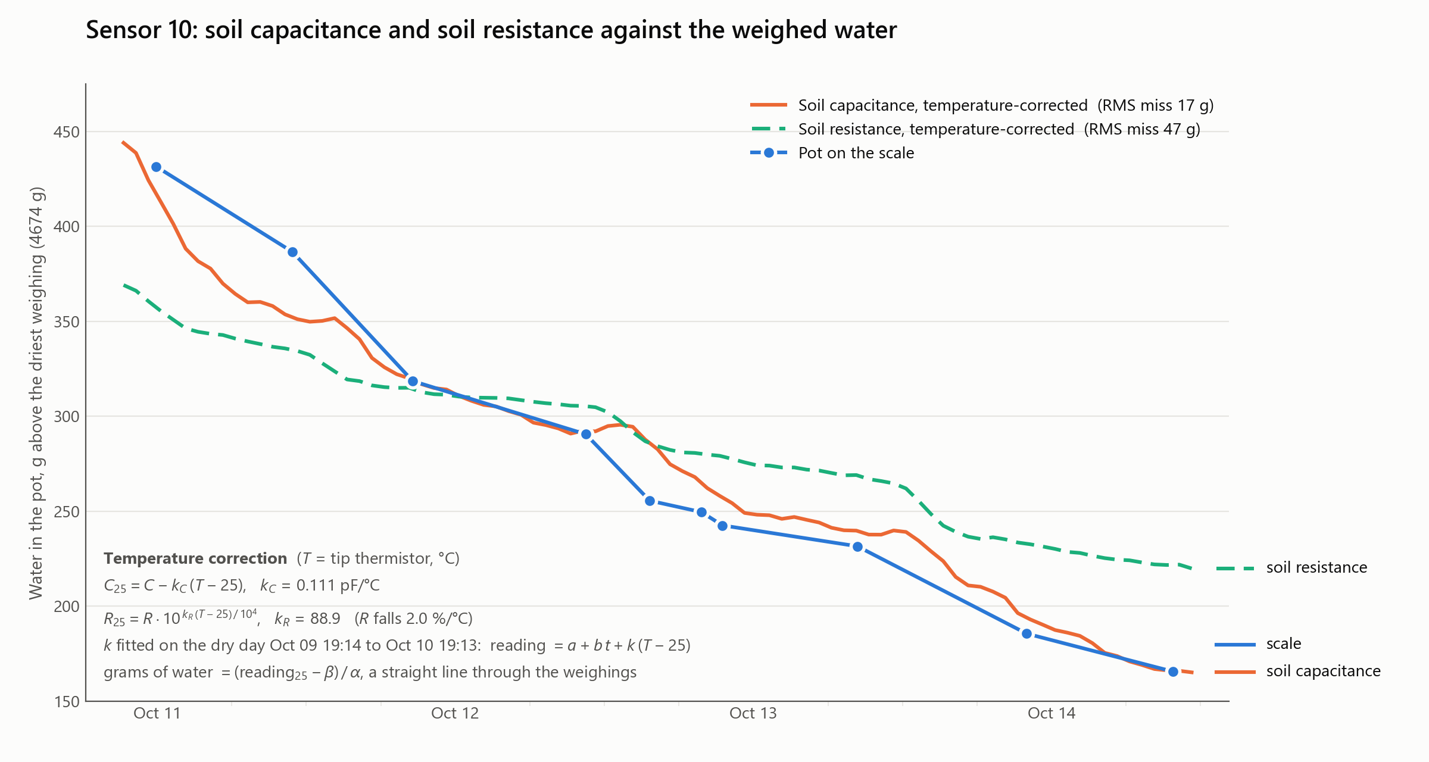
data/sensor_logs/msv4_soil_cap_res_vs_water_clean_2026-10-14.png
