samam624/ProjectTreebeard/DisplayCenter/assets/plant_gifs/monstera.gif

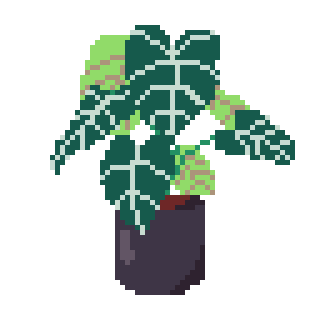
DisplayCenter/assets/plant_gifs/monstera.gif
