samam624/ProjectTreebeard/DisplayCenter/assets/YELL-ORG-RED-PLANTER.png

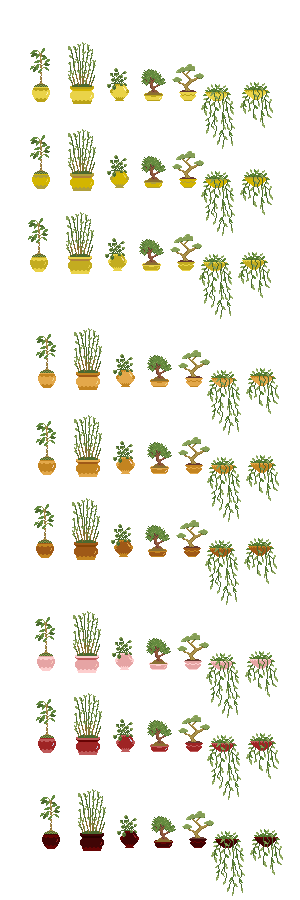
DisplayCenter/assets/YELL-ORG-RED-PLANTER.png
