samam624/ProjectTreebeard/DisplayCenter/docs/PUMP_DRIVER_SCHEMATIC.png

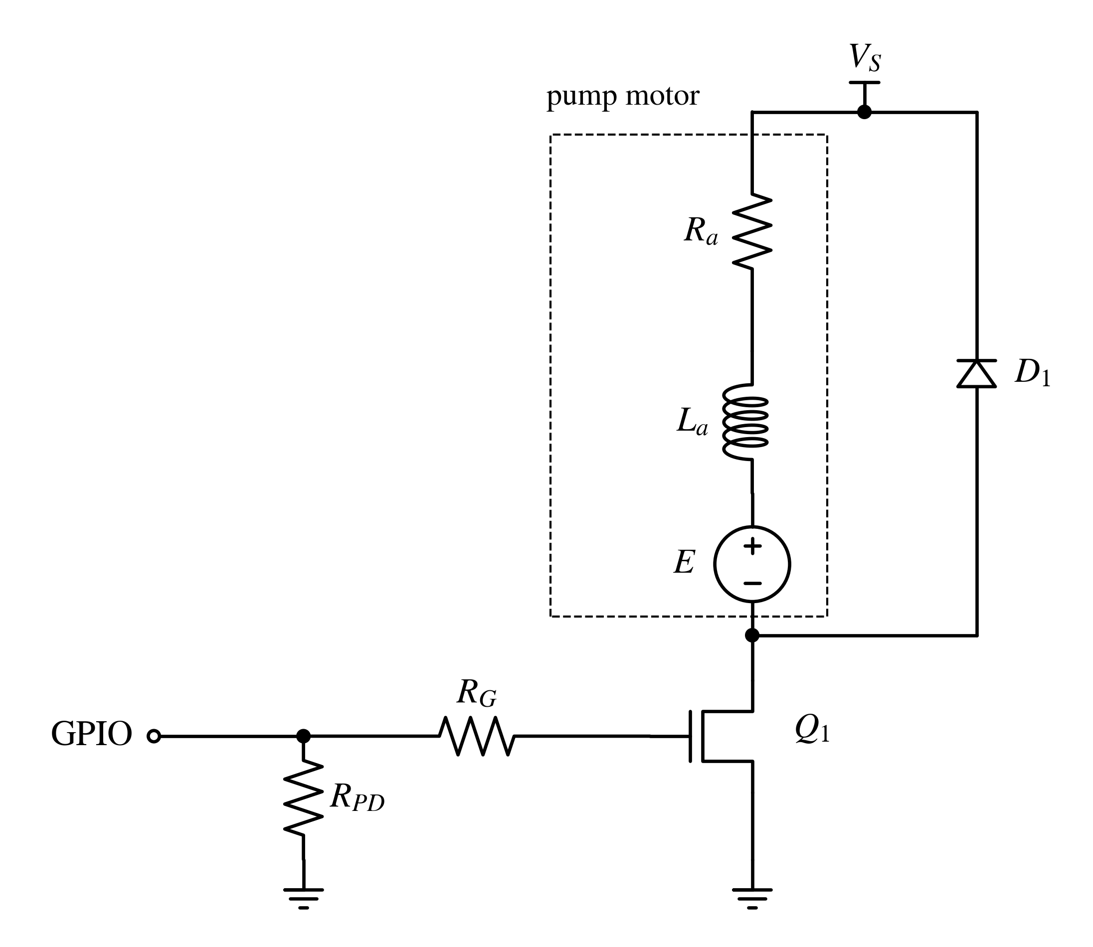
DisplayCenter/docs/PUMP_DRIVER_SCHEMATIC.png
