samam624/ProjectTreebeard/DisplayCenter/docs/WATER_NOW_DISPLAY_AS_BUILT_2026-10-11.png

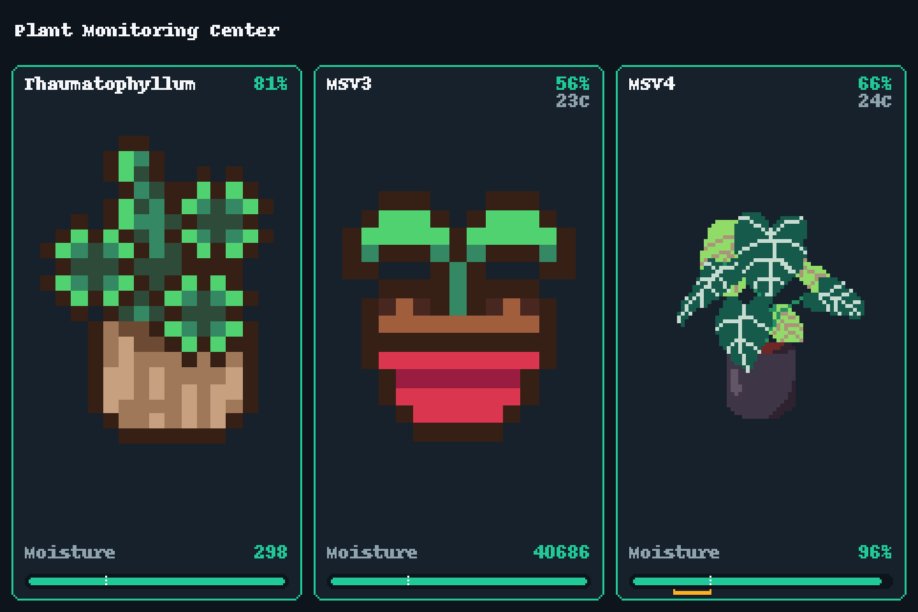
DisplayCenter/docs/WATER_NOW_DISPLAY_AS_BUILT_2026-10-11.png
