samam624/ProjectTreebeard/DisplayCenter/docs/WATER_NOW_METER_MOCKUP_2026-10-11.png

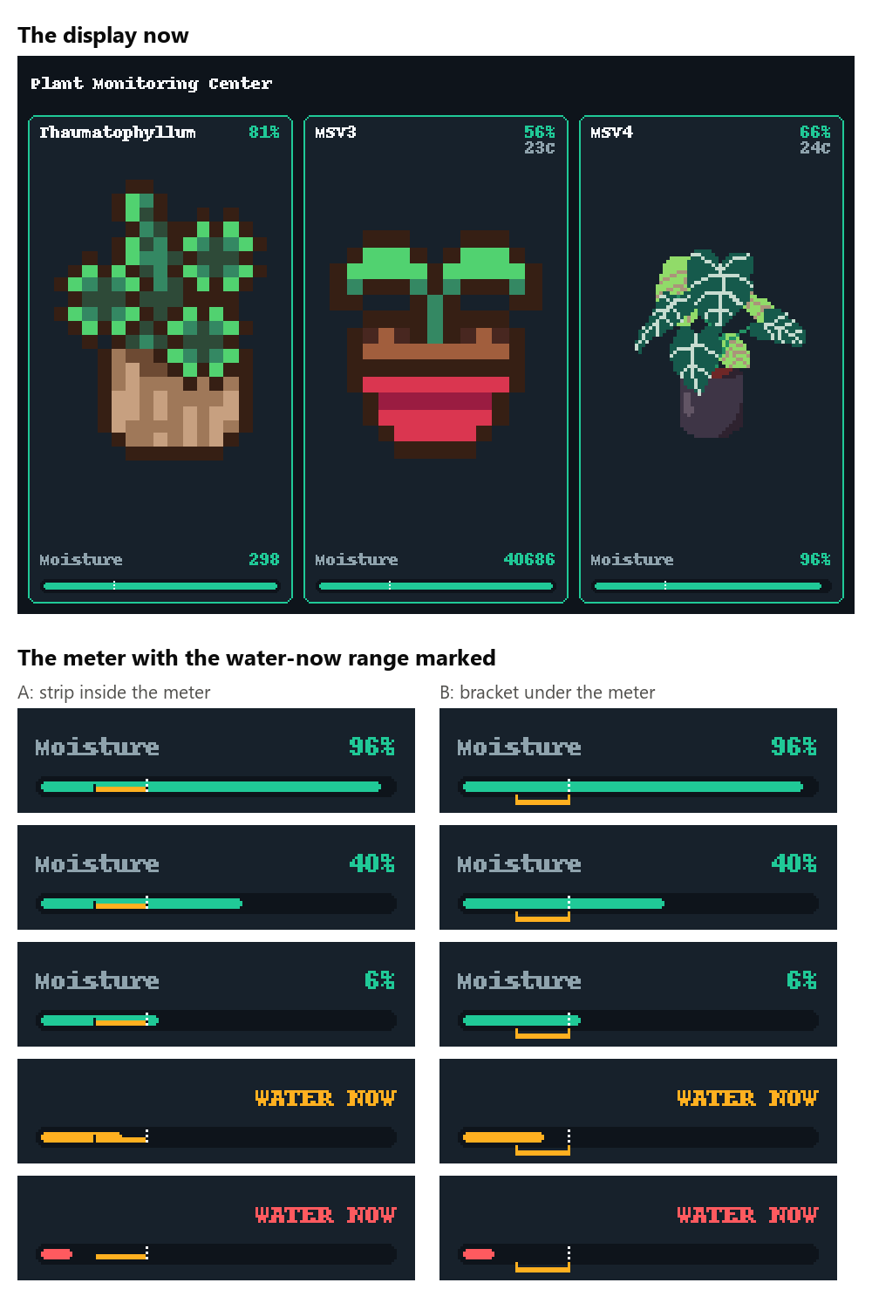
DisplayCenter/docs/WATER_NOW_METER_MOCKUP_2026-10-11.png
