samam624/ProjectTreebeard/DisplayCenter/esp32_plant_sprite_pack/isolated_pngs_original/cup_plant_frame_02.png

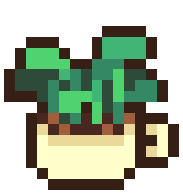
DisplayCenter/esp32_plant_sprite_pack/isolated_pngs_original/cup_plant_frame_02.png
