samam624/ProjectTreebeard/DisplayCenter/esp32_plant_sprite_pack/isolated_pngs_original/wide_planter_frame_01.png

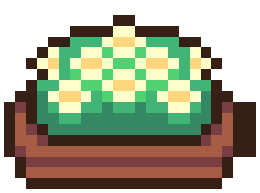
DisplayCenter/esp32_plant_sprite_pack/isolated_pngs_original/wide_planter_frame_01.png
