samam624/ProjectTreebeard/DisplayCenter/hardware/MSV2_ESP32_DisplayCenter/pcb/images/DisplayCenter_schematic_overview.png

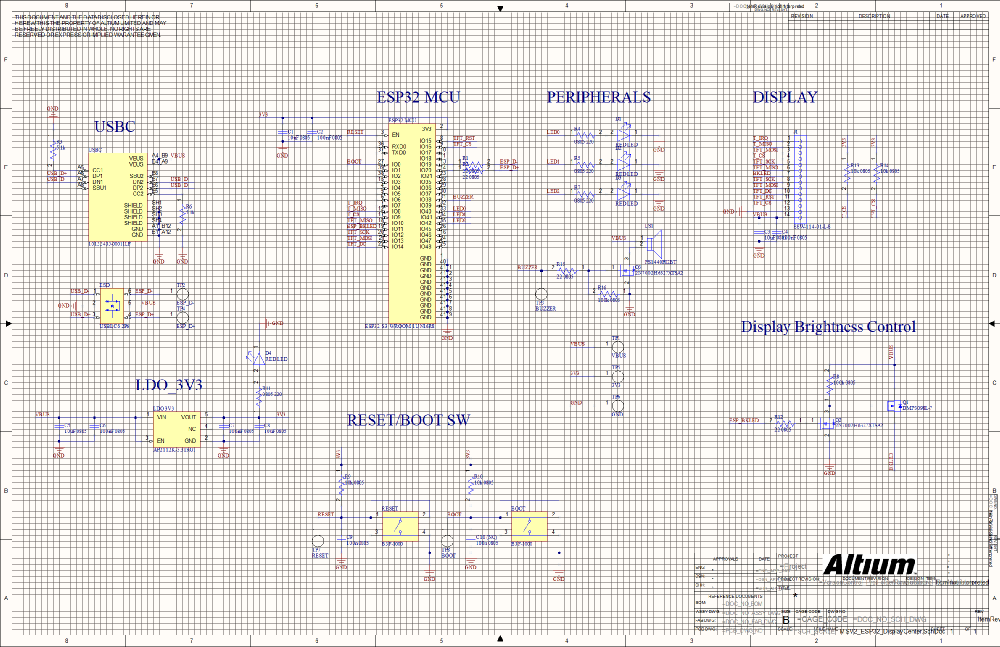
DisplayCenter/hardware/MSV2_ESP32_DisplayCenter/pcb/images/DisplayCenter_schematic_overview.png
