samam624/ProjectTreebeard/DisplayCenter/hardware/MSV2_ESP32_DisplayCenter/V2/design/renders/antenna_reference_bottom.png

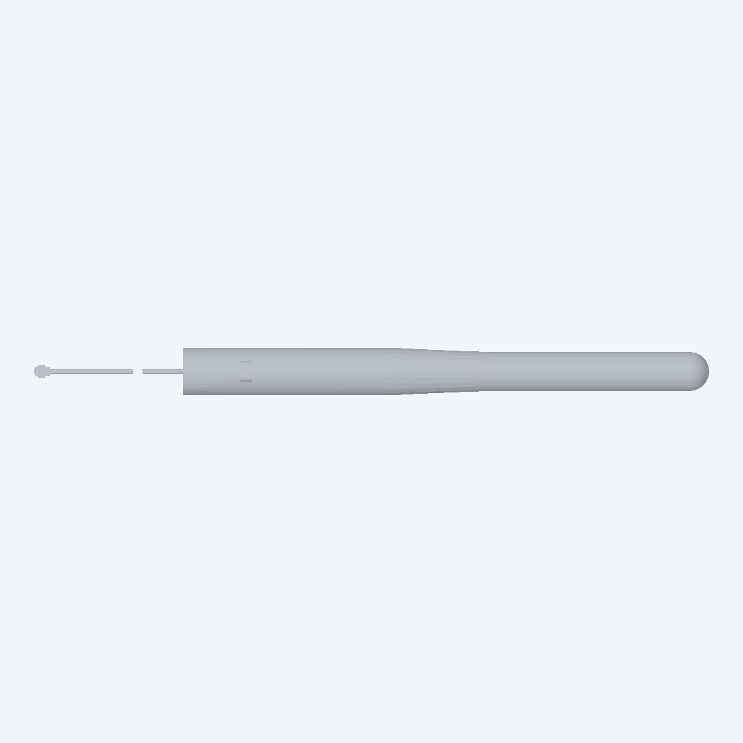
DisplayCenter/hardware/MSV2_ESP32_DisplayCenter/V2/design/renders/antenna_reference_bottom.png
