samam624/ProjectTreebeard/DisplayCenter/hardware/MSV2_ESP32_DisplayCenter/V2/design/renders/antenna_reference_isometric.png

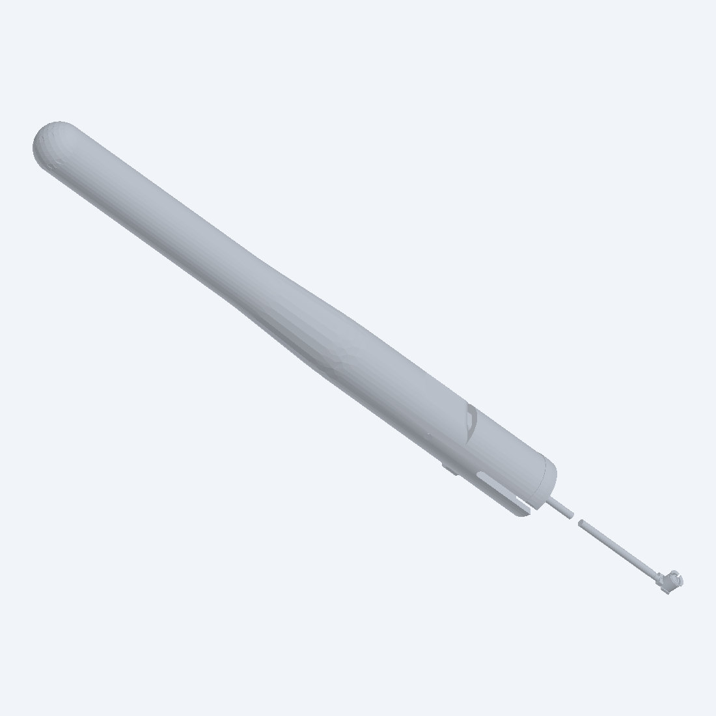
DisplayCenter/hardware/MSV2_ESP32_DisplayCenter/V2/design/renders/antenna_reference_isometric.png
