samam624/ProjectTreebeard/DisplayCenter/hardware/MSV2_ESP32_DisplayCenter/V2/design/renders/screen_bezel_top_reference_bottom.png

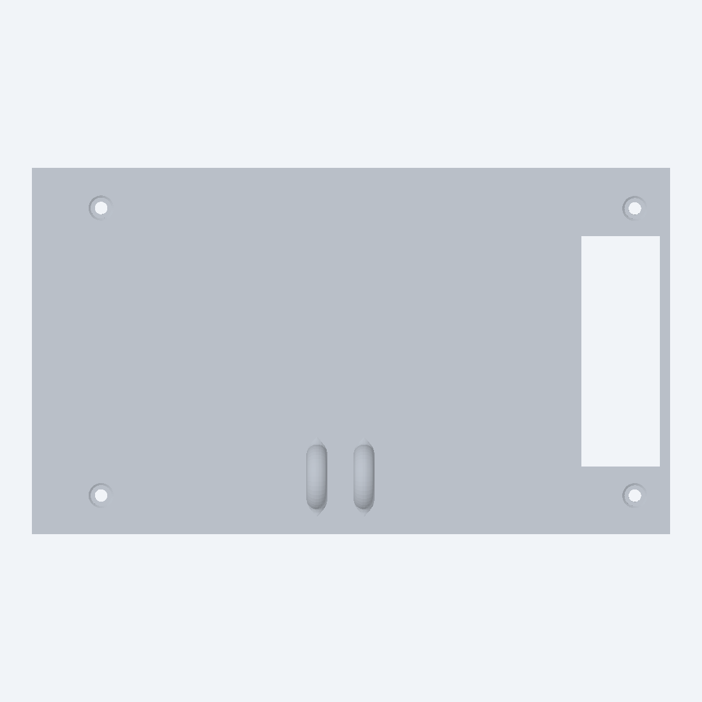
DisplayCenter/hardware/MSV2_ESP32_DisplayCenter/V2/design/renders/screen_bezel_top_reference_bottom.png
