samam624/ProjectTreebeard/DisplayCenter/hardware/MSV2_ESP32_DisplayCenter/V2/renders/desktop_deployed_v1_isometric.png

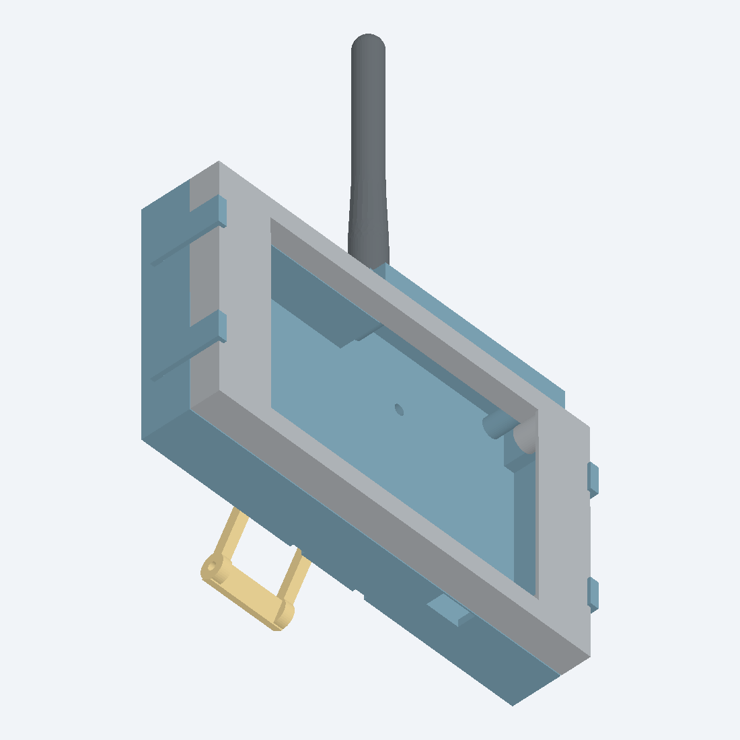
DisplayCenter/hardware/MSV2_ESP32_DisplayCenter/V2/renders/desktop_deployed_v1_isometric.png
