samam624/ProjectTreebeard/DisplayCenter/hardware/MSV2_ESP32_DisplayCenter/V2/renders/desktop_enclosure_p1s_pla_v1_isometric.png

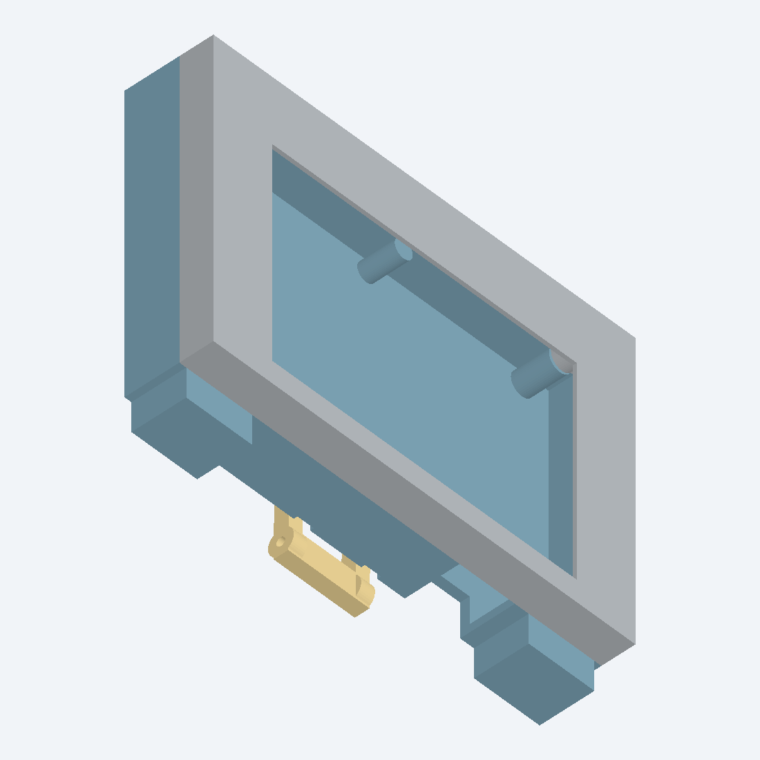
DisplayCenter/hardware/MSV2_ESP32_DisplayCenter/V2/renders/desktop_enclosure_p1s_pla_v1_isometric.png
