samam624/ProjectTreebeard/DisplayCenter/hardware/MSV2_ESP32_DisplayCenter/V2/renders/desktop_enclosure_v6_top.png

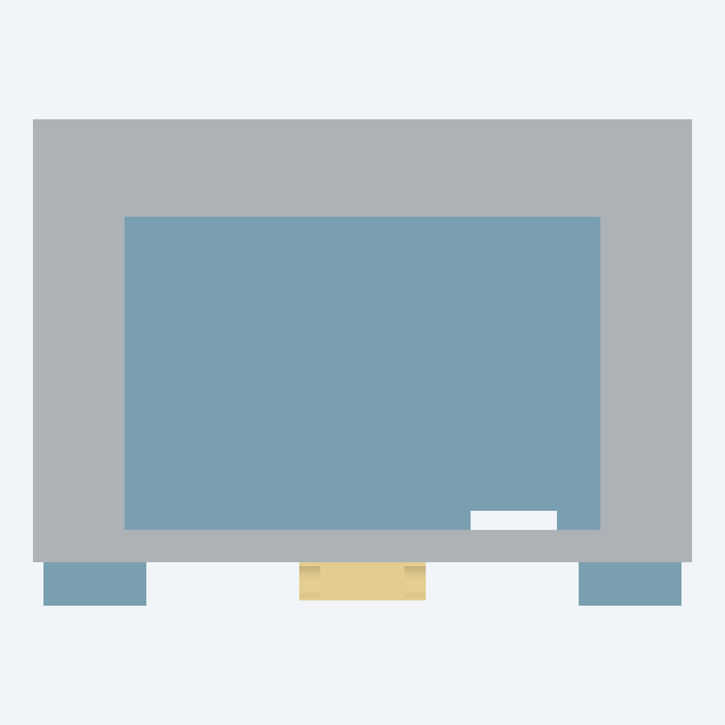
DisplayCenter/hardware/MSV2_ESP32_DisplayCenter/V2/renders/desktop_enclosure_v6_top.png
