samam624/ProjectTreebeard/DisplayCenter/hardware/MSV2_ESP32_DisplayCenter/V2/renders/desktop_fit_check_v1_bottom.png

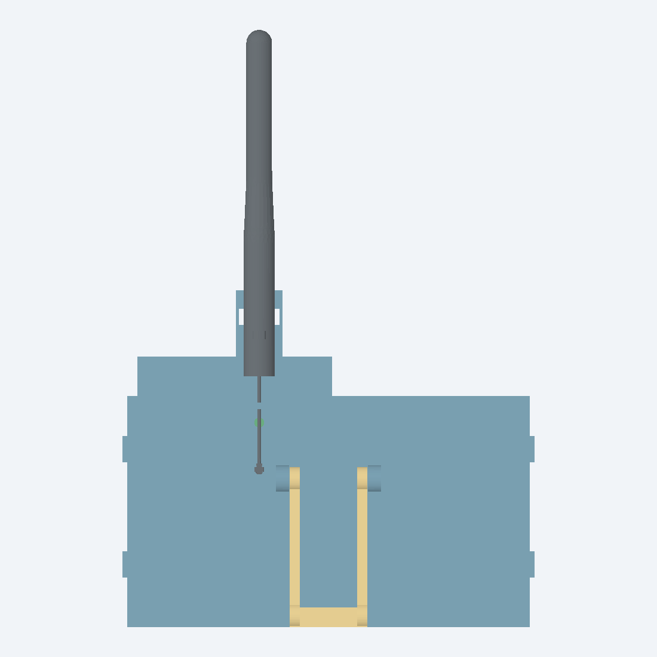
DisplayCenter/hardware/MSV2_ESP32_DisplayCenter/V2/renders/desktop_fit_check_v1_bottom.png
