samam624/ProjectTreebeard/esp32_plant_sprite_pack/isolated_pngs_original/cactus_cluster_frame_04.png

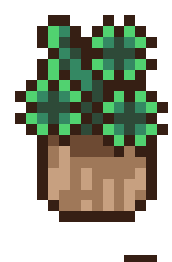
esp32_plant_sprite_pack/isolated_pngs_original/cactus_cluster_frame_04.png
