samam624/ProjectTreebeard/esp32_plant_sprite_pack/isolated_pngs_original/sprout_pot_frame_02.png

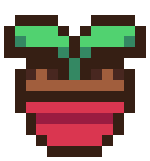
esp32_plant_sprite_pack/isolated_pngs_original/sprout_pot_frame_02.png
