samam624/ProjectTreebeard/esp32_plant_sprite_pack/isolated_pngs_original/wide_planter_frame_02.png

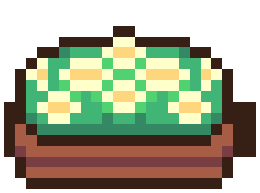
esp32_plant_sprite_pack/isolated_pngs_original/wide_planter_frame_02.png
