samam624/ProjectTreebeard/hardware/MSV2_ESP32_DisplayCenter/V2/renders/desktop_exploded_v1_bottom.png

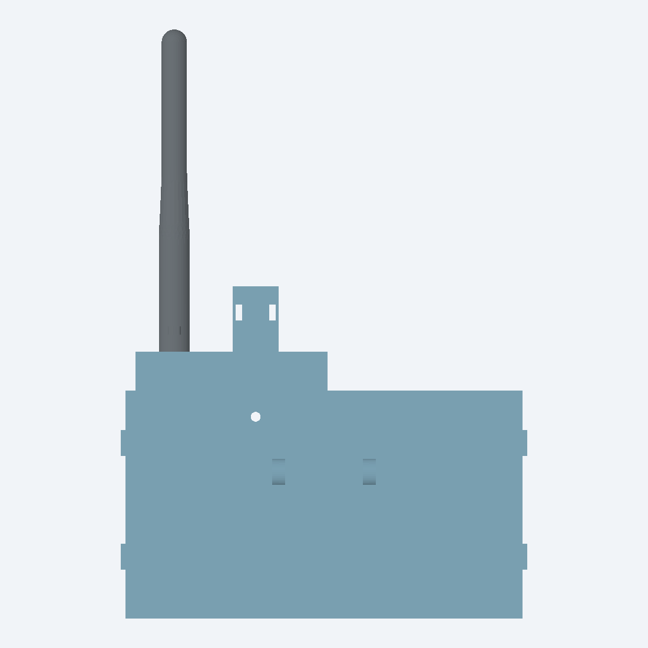
hardware/MSV2_ESP32_DisplayCenter/V2/renders/desktop_exploded_v1_bottom.png
