samam624/ProjectTreebeard/hardware/MSV2_ESP32_DisplayCenter/V2/renders/rear_shell_v1_isometric.png

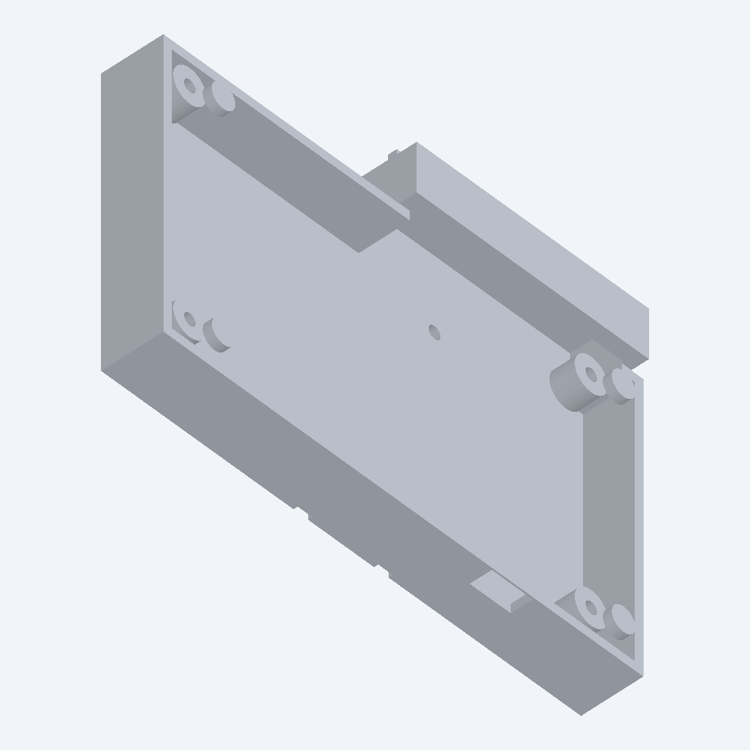
hardware/MSV2_ESP32_DisplayCenter/V2/renders/rear_shell_v1_isometric.png
