samam624/ProjectTreebeard/hardware/MSV3_Probe_PCB_Enclosure/renders/base_isometric.png

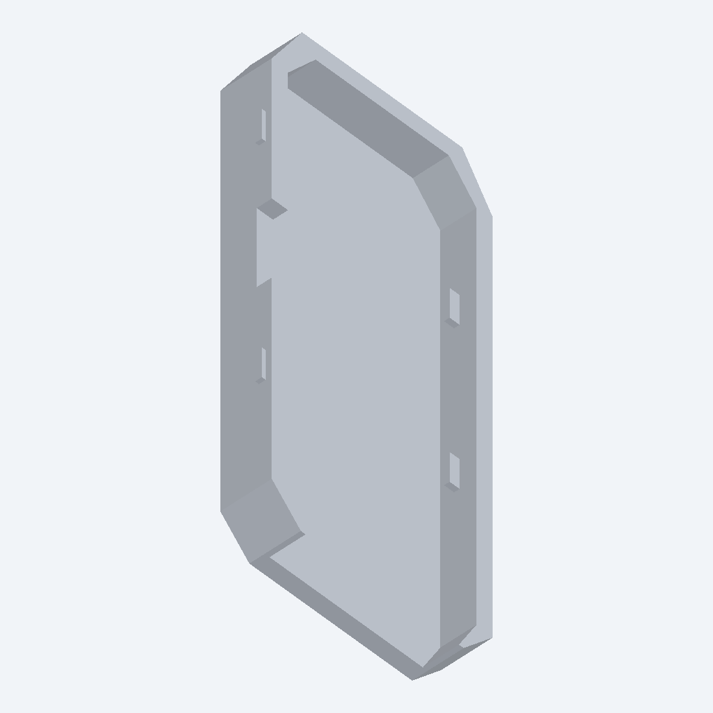
hardware/MSV3_Probe_PCB_Enclosure/renders/base_isometric.png
