samam624/ProjectTreebeard/hardware/MSV3_Probe_PCB_Enclosure/renders/exploded_isometric.png

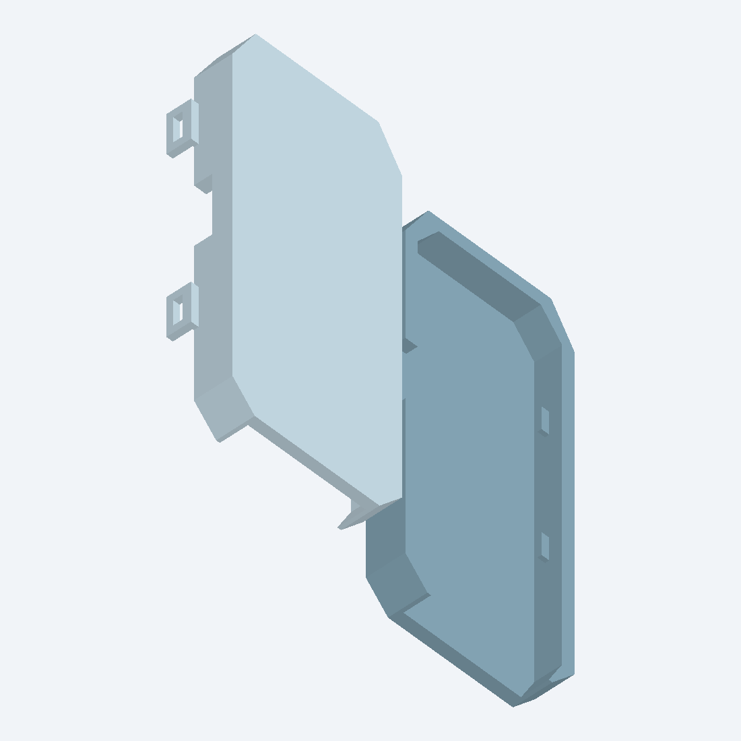
hardware/MSV3_Probe_PCB_Enclosure/renders/exploded_isometric.png
