samam624/ProjectTreebeard/hardware/MSV3_Probe_PCB_Enclosure/renders/exploded_solar_top.png

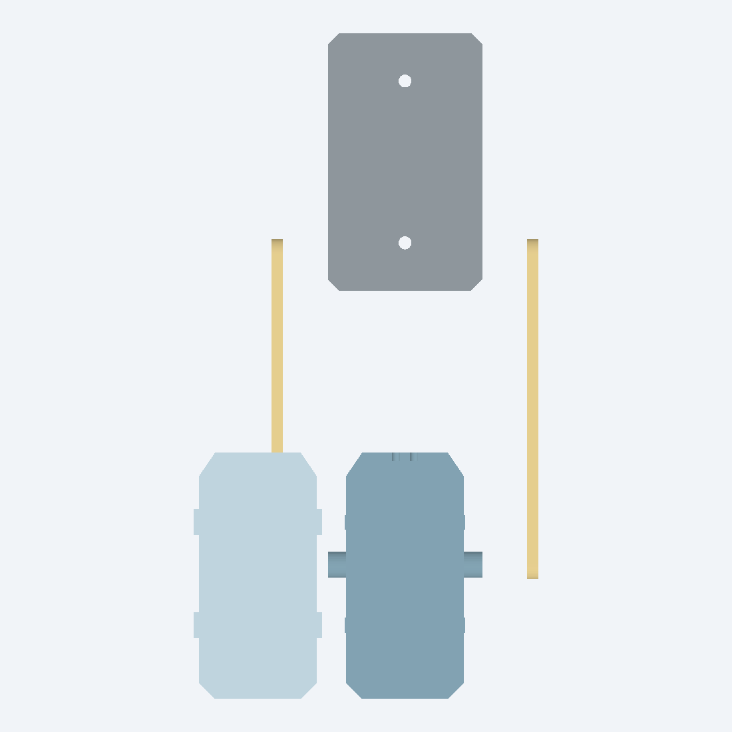
hardware/MSV3_Probe_PCB_Enclosure/renders/exploded_solar_top.png
