samam624/ProjectTreebeard/hardware/MSV3_Probe_PCB_Enclosure/renders/exploded_v5_bottom.png

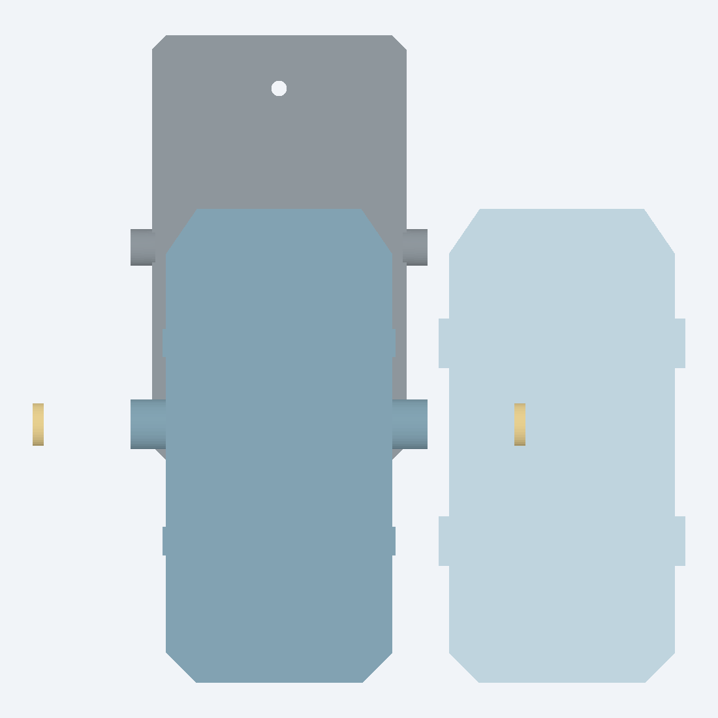
hardware/MSV3_Probe_PCB_Enclosure/renders/exploded_v5_bottom.png
