samam624/ProjectTreebeard/hardware/MSV3_Probe_PCB_Enclosure/renders/exploded_v7_bottom.png

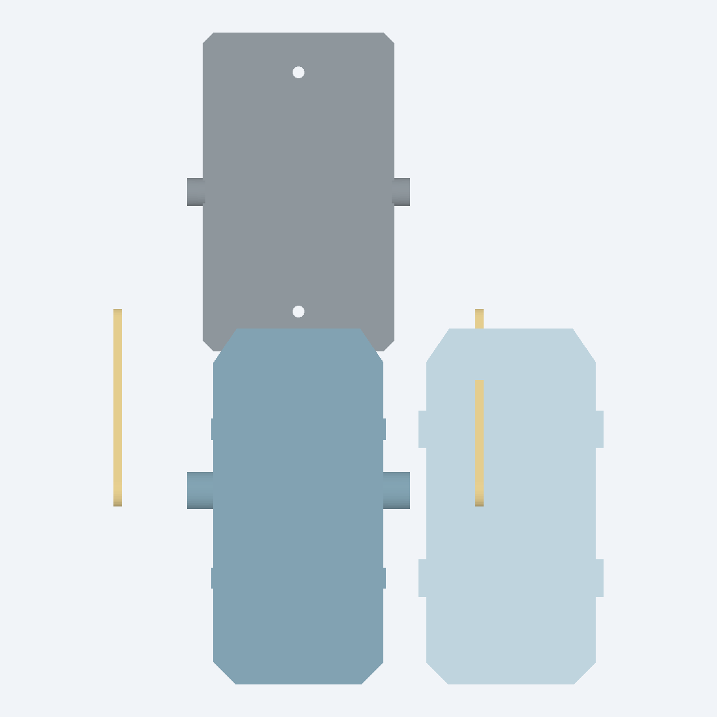
hardware/MSV3_Probe_PCB_Enclosure/renders/exploded_v7_bottom.png
