samam624/ProjectTreebeard/hardware/MSV3_Probe_PCB_Enclosure/renders/m2_blended_side_closure/blended_case_isometric.png

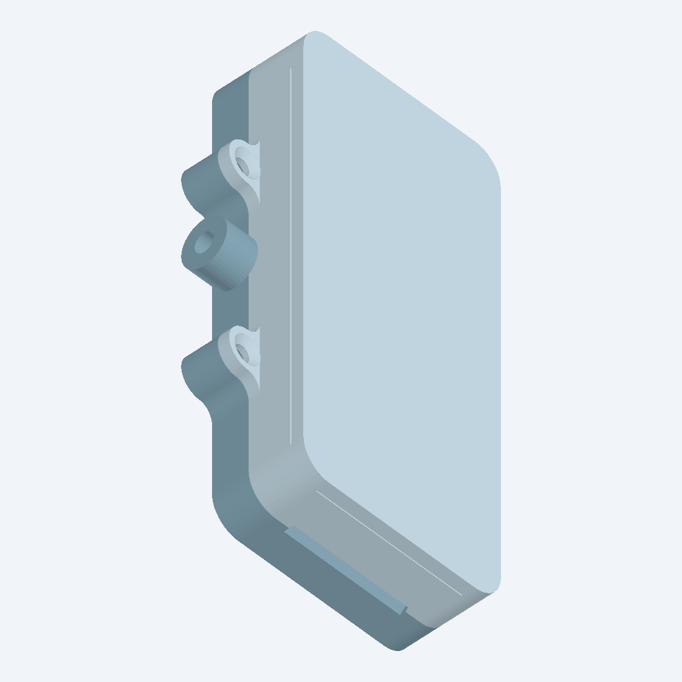
hardware/MSV3_Probe_PCB_Enclosure/renders/m2_blended_side_closure/blended_case_isometric.png
