samam624/ProjectTreebeard/hardware/MSV3_Probe_PCB_Enclosure/renders/pcb_top.png

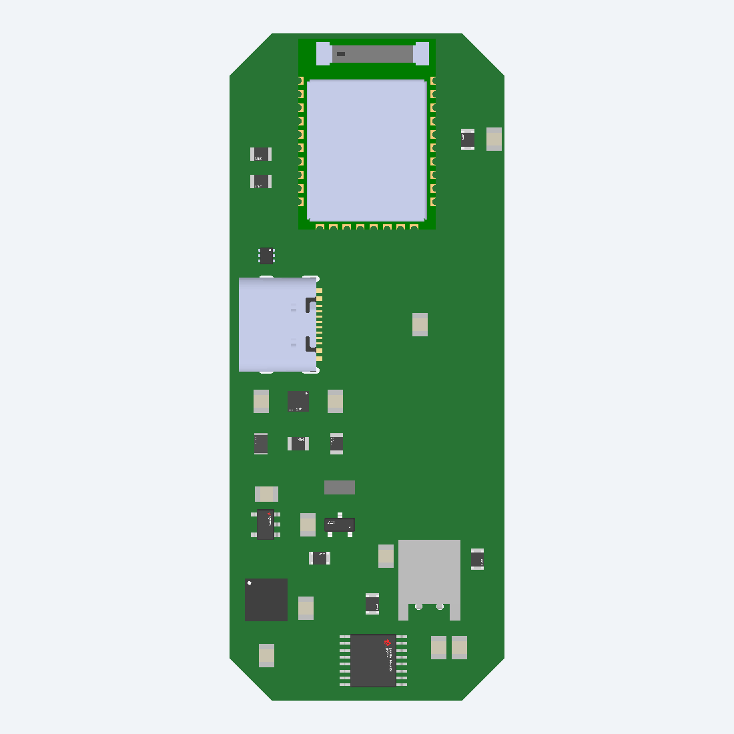
hardware/MSV3_Probe_PCB_Enclosure/renders/pcb_top.png
