samam624/ProjectTreebeard/MSV2/hardware/images/MSV2_schematic.png

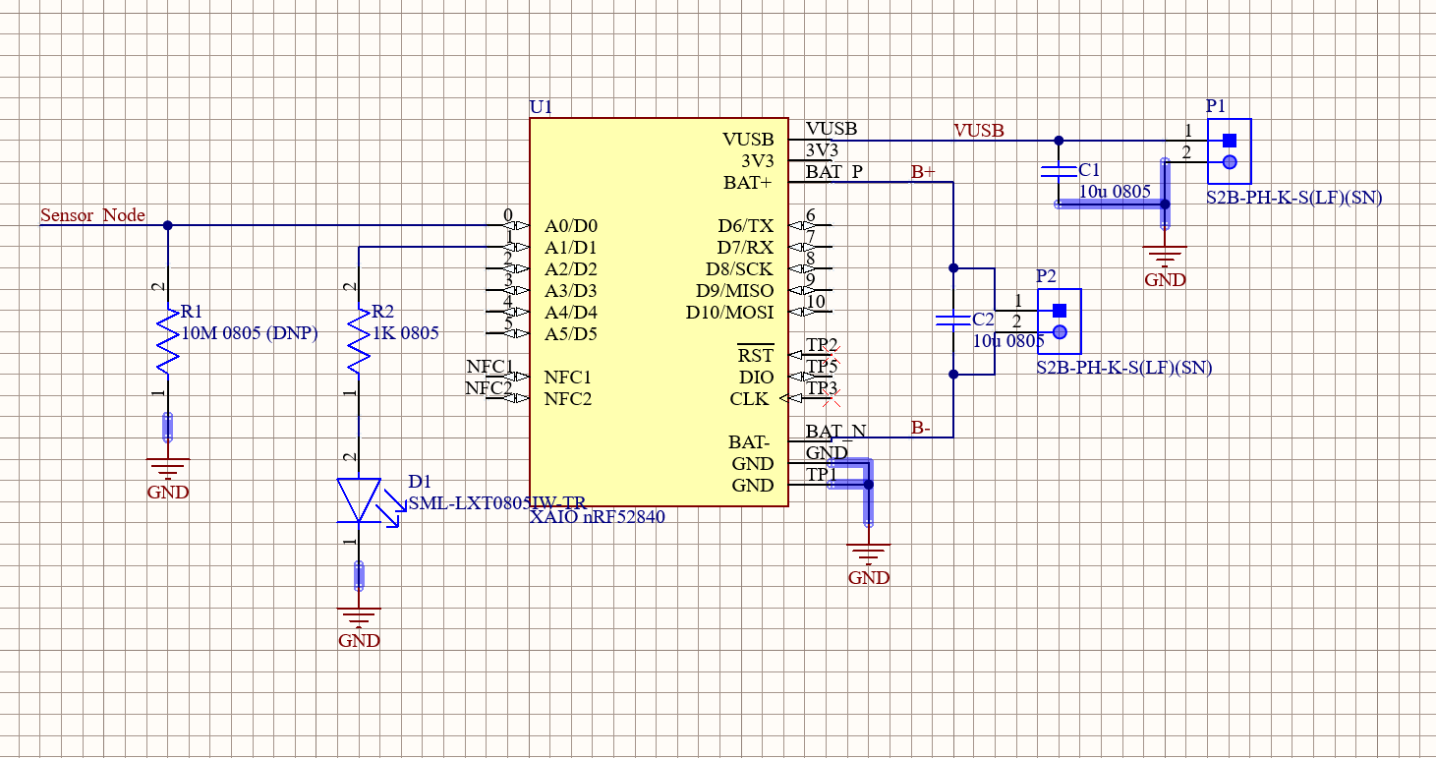
MSV2/hardware/images/MSV2_schematic.png
