samam624/ProjectTreebeard/MSV3/docs/MSV3_ALOCASIA_ELECTRODE_VS_CIRCUIT_2026-09-29.png

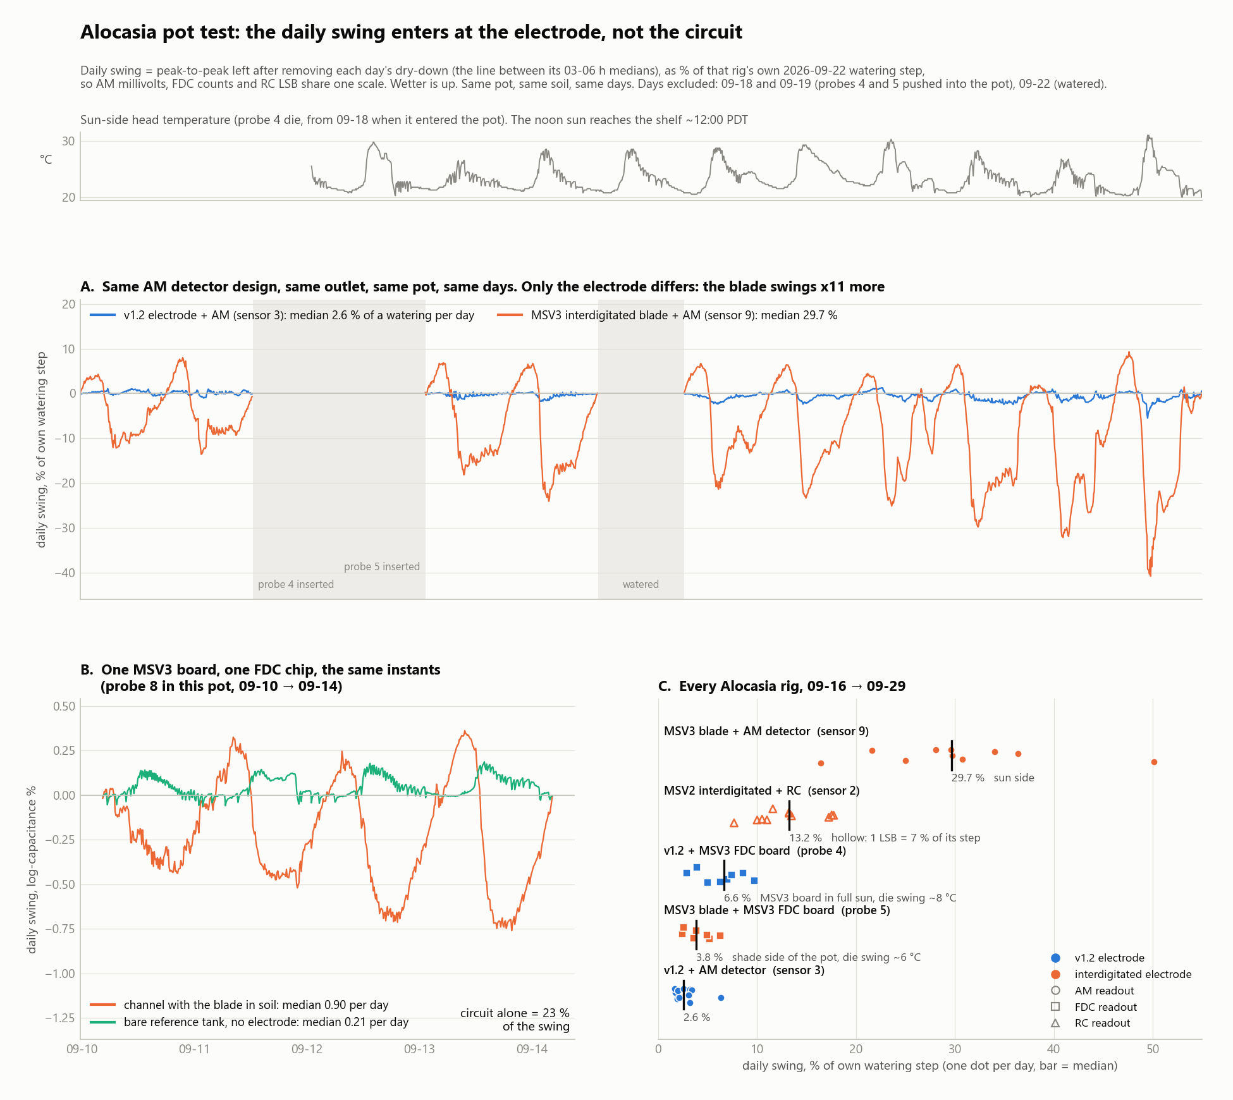
MSV3/docs/MSV3_ALOCASIA_ELECTRODE_VS_CIRCUIT_2026-09-29.png
