samam624/ProjectTreebeard/MSV3/docs/MSV3_MULTIPROBE_DAILY_SHAPES_2026-09-24.png

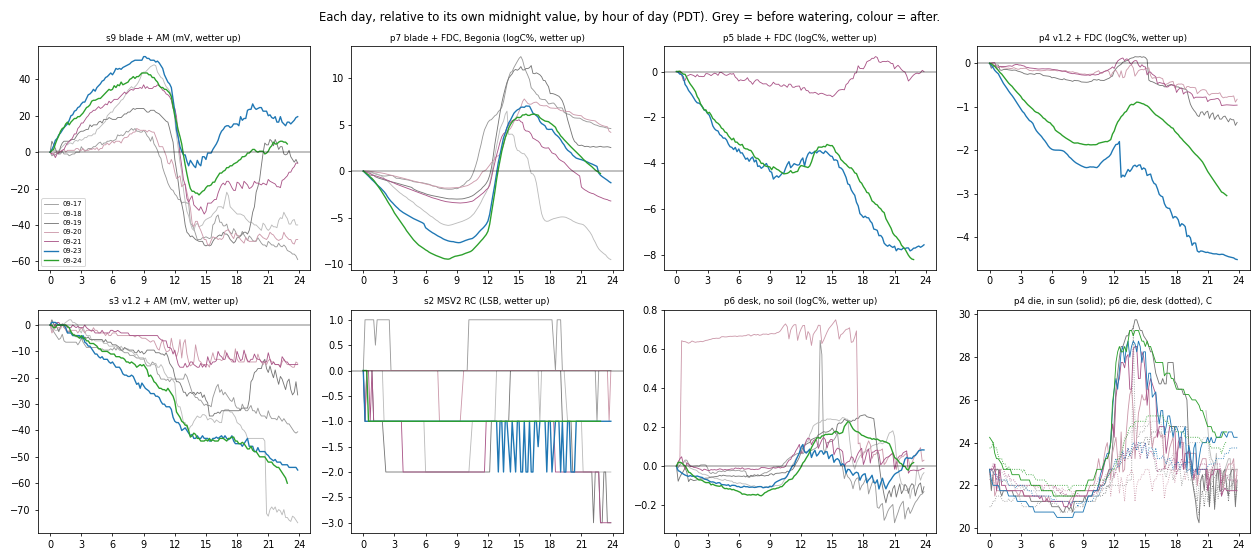
MSV3/docs/MSV3_MULTIPROBE_DAILY_SHAPES_2026-09-24.png
