samam624/ProjectTreebeard/MSV3/docs/MSV3_PROBE_BACK_ORIGINAL.png

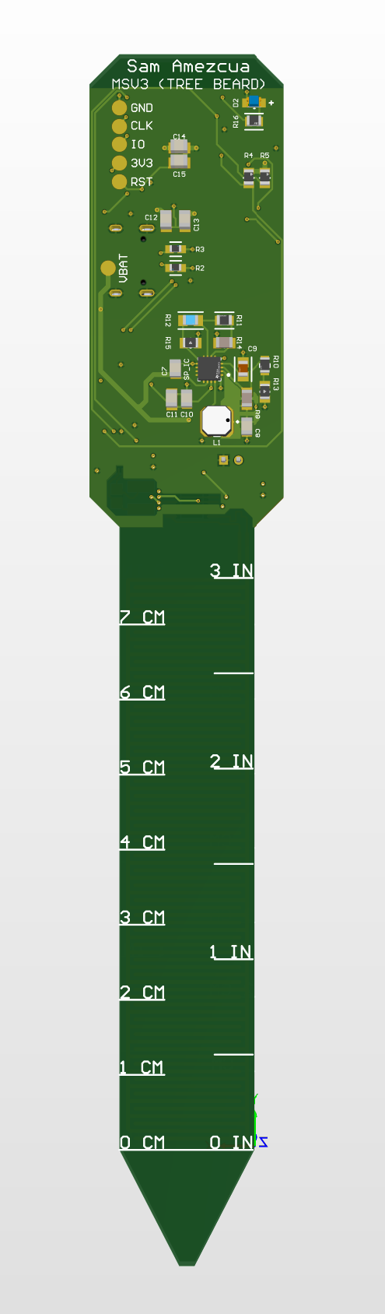
MSV3/docs/MSV3_PROBE_BACK_ORIGINAL.png
