samam624/ProjectTreebeard/MSV3/hardware/MSV3_Probe_PCB/images/MSV3_bq25504_solar_charger.png

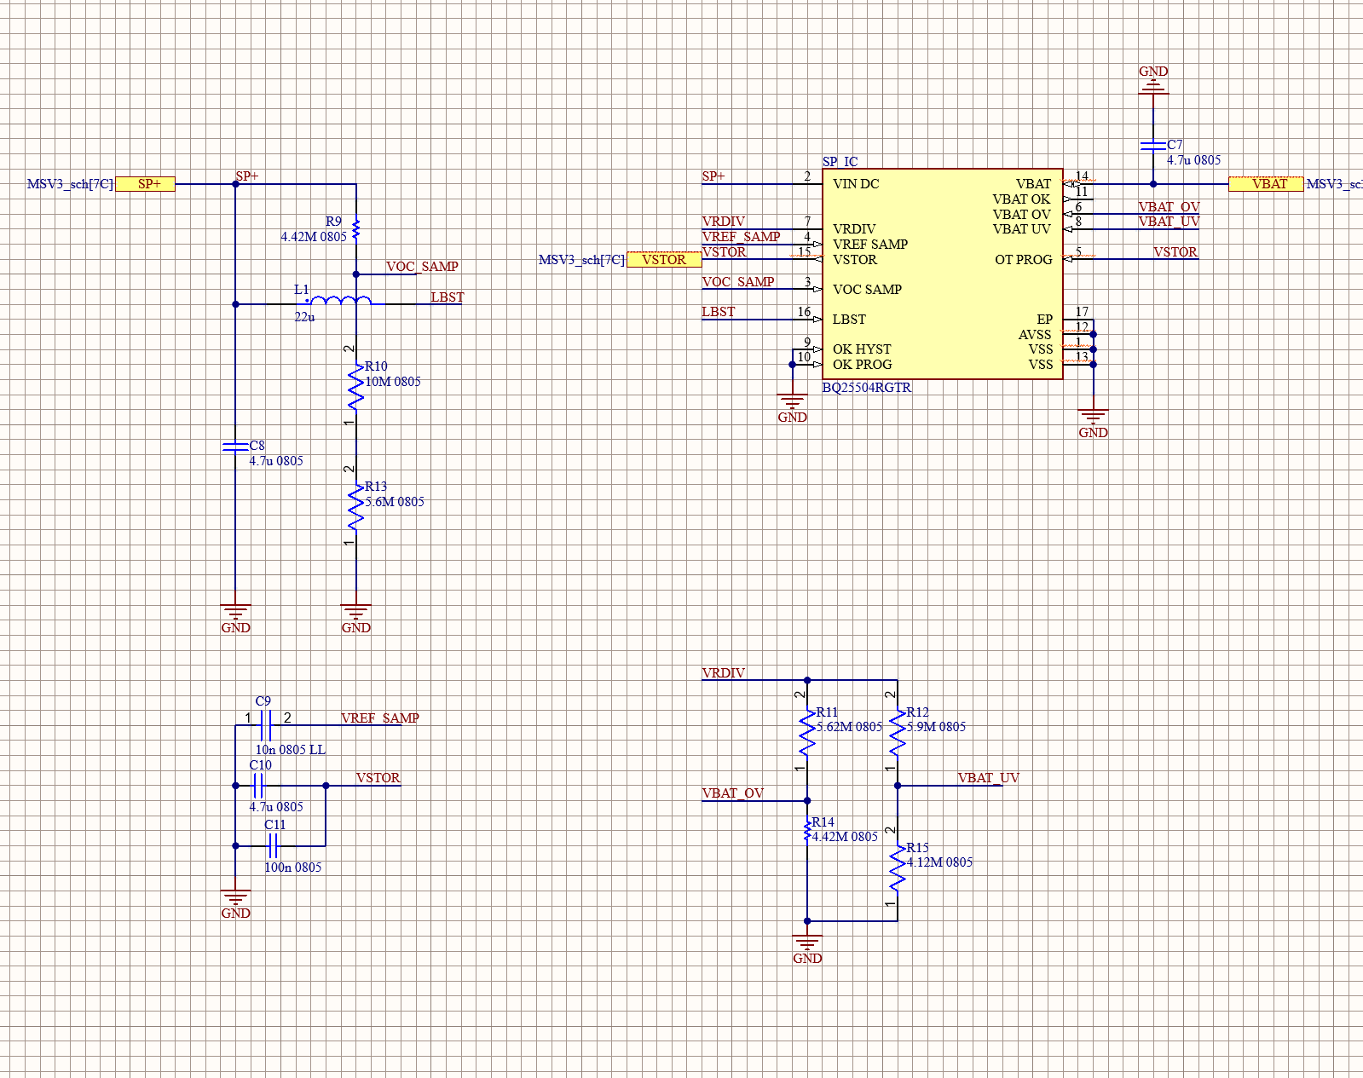
MSV3/hardware/MSV3_Probe_PCB/images/MSV3_bq25504_solar_charger.png
