samam624/ProjectTreebeard/MSV3/hardware/MSV3_Probe_PCB/images/MSV3_electrode_swap_mux.png

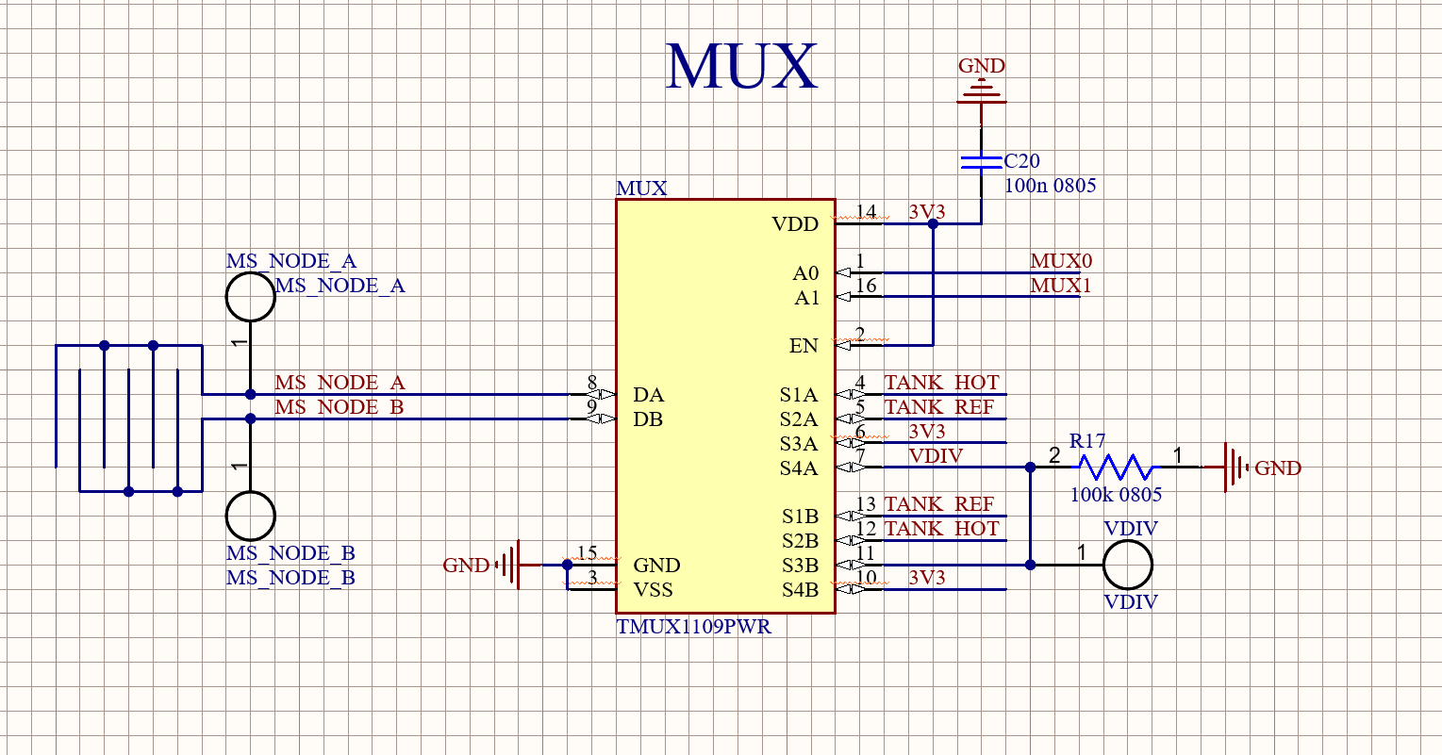
MSV3/hardware/MSV3_Probe_PCB/images/MSV3_electrode_swap_mux.png
