samam624/ProjectTreebeard/MSV3/hardware/MSV3_Probe_PCB/images/MSV3_pcb_3d_annotated.png

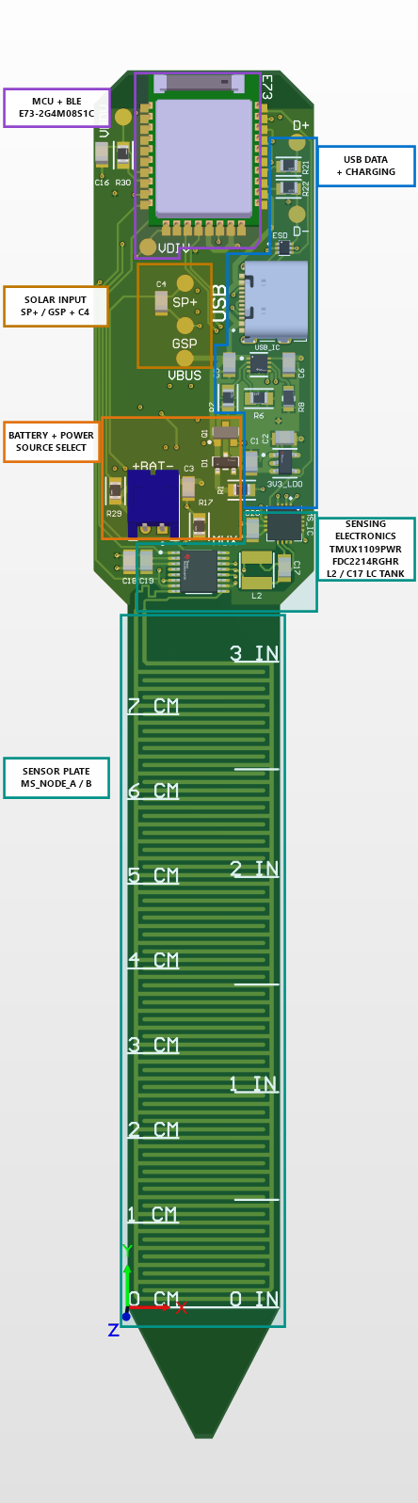
MSV3/hardware/MSV3_Probe_PCB/images/MSV3_pcb_3d_annotated.png
