samam624/ProjectTreebeard/MSV3/hardware/MSV3_Probe_PCB_Enclosure/renders/exploded_solar_bottom.png

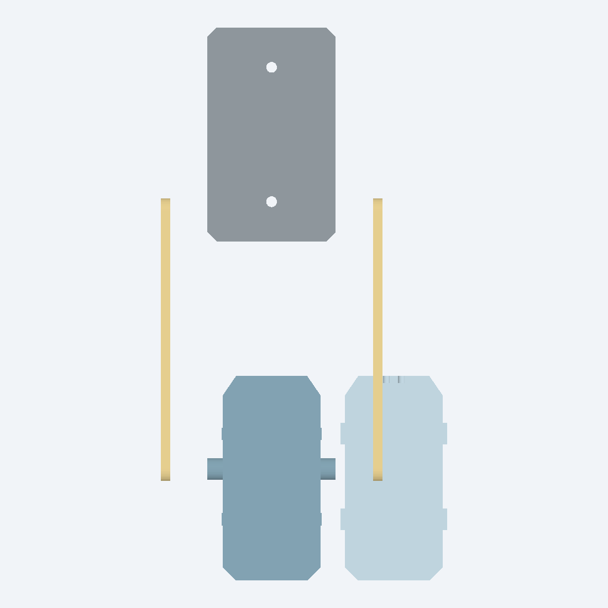
MSV3/hardware/MSV3_Probe_PCB_Enclosure/renders/exploded_solar_bottom.png
