samam624/ProjectTreebeard/MSV3/hardware/MSV3_Probe_PCB_Enclosure/renders/m2_blended_side_closure_v6/closed_v6_top.png

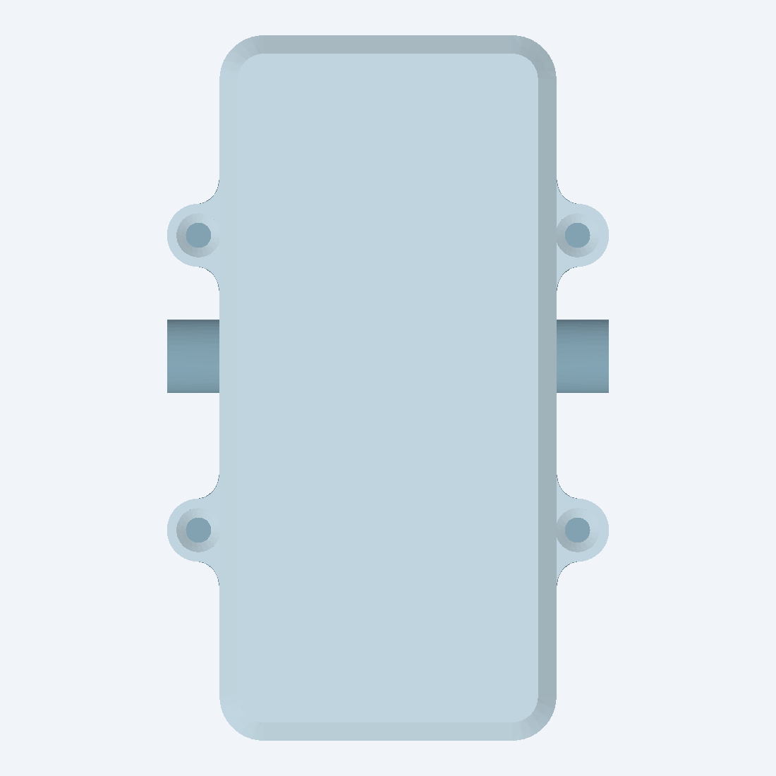
MSV3/hardware/MSV3_Probe_PCB_Enclosure/renders/m2_blended_side_closure_v6/closed_v6_top.png
