samam624/ProjectTreebeard/MSV3/hardware/MSV3_Probe_PCB_Enclosure/renders/solar_frame_v5_isometric.png

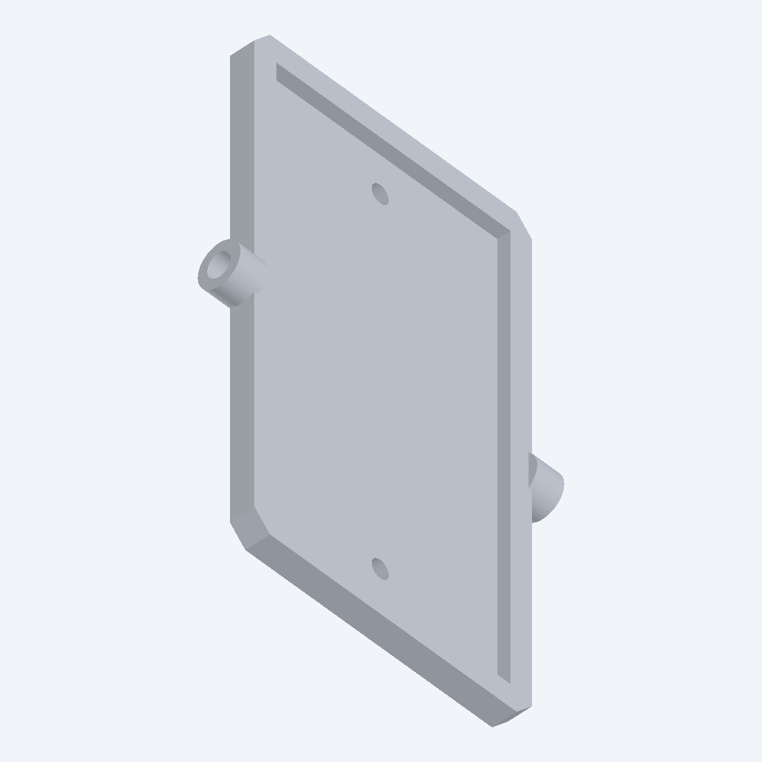
MSV3/hardware/MSV3_Probe_PCB_Enclosure/renders/solar_frame_v5_isometric.png
