samam624/ProjectTreebeard/MSV4/docs/ELECTRODE_CROSS_SECTIONS_2026-09-30_SLIDE.png

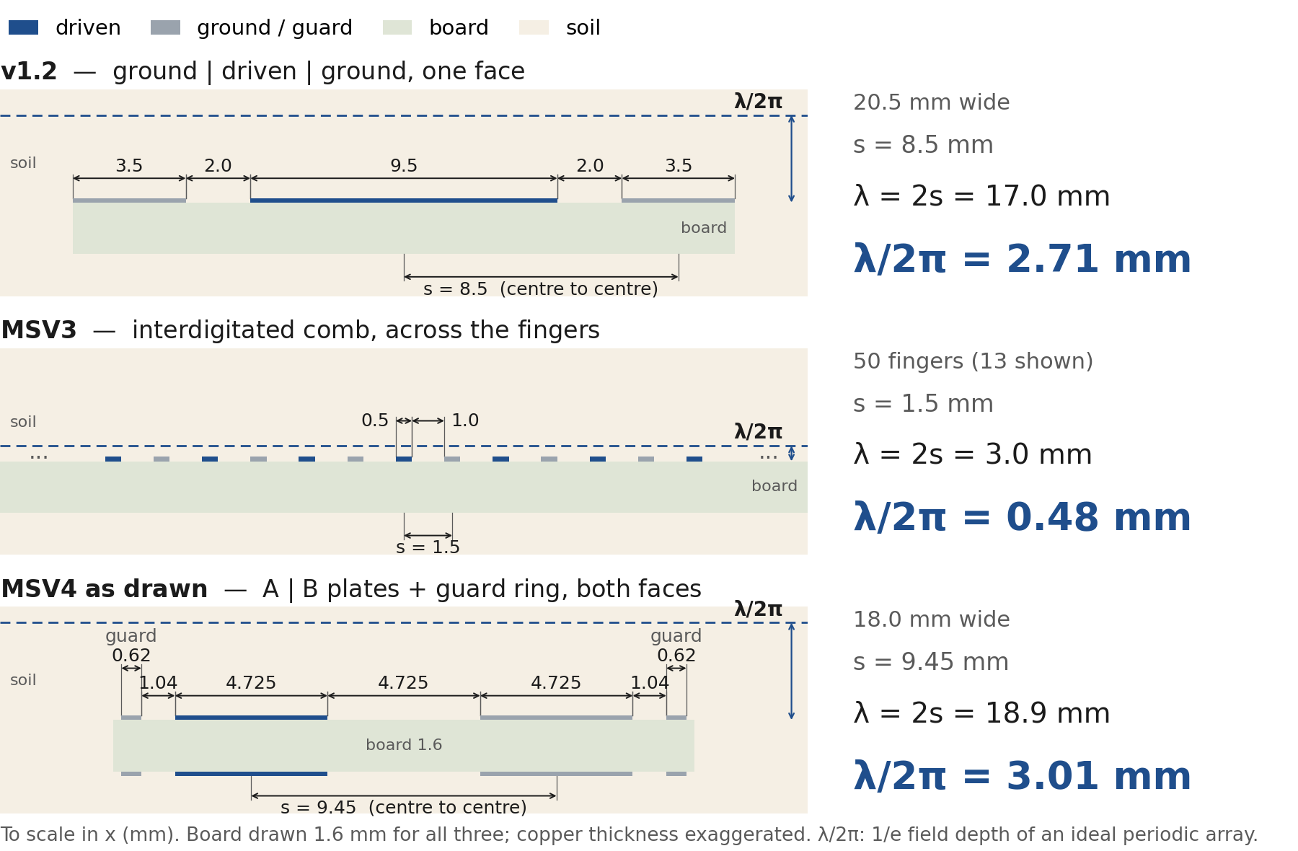
MSV4/docs/ELECTRODE_CROSS_SECTIONS_2026-09-30_SLIDE.png
