samam624/ProjectTreebeard/MSV4/docs/MSV4_SENSING_DEPTH_EQUATION_VS_SIM_2026-09-30.png

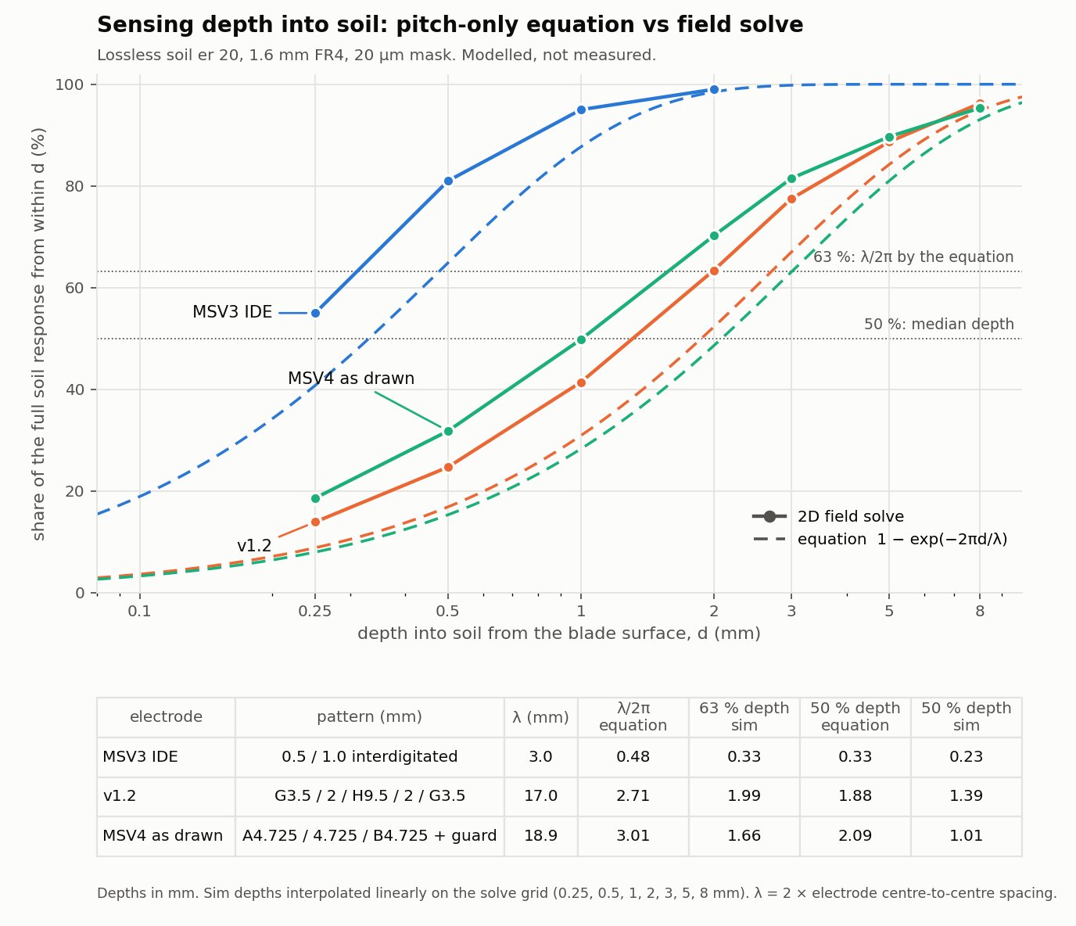
MSV4/docs/MSV4_SENSING_DEPTH_EQUATION_VS_SIM_2026-09-30.png
