samam624/ProjectTreebeard/MSV4/docs/msv4_sensor10_daily_staircase_2026-10-27.png

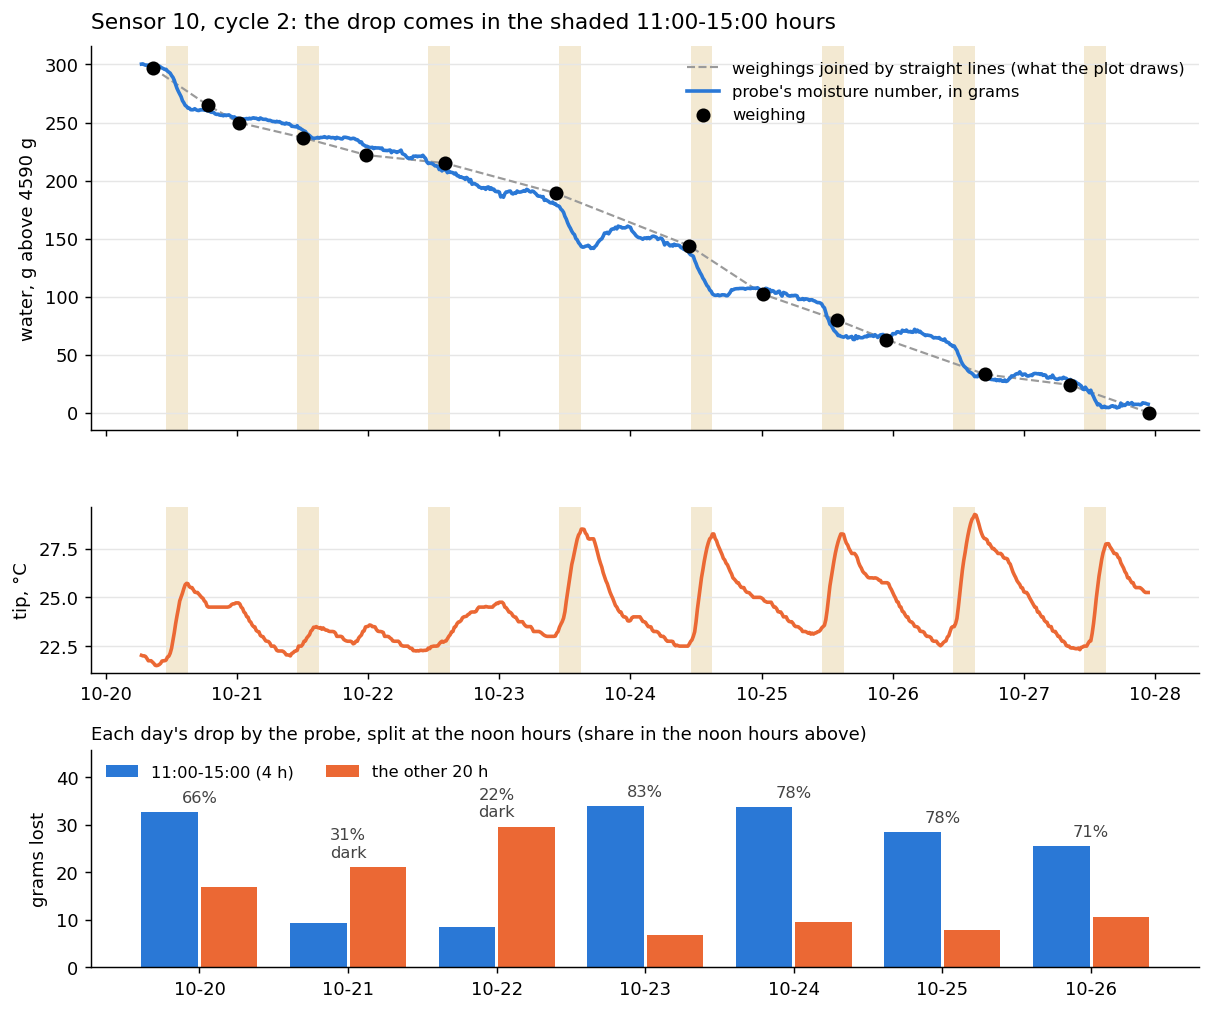
MSV4/docs/msv4_sensor10_daily_staircase_2026-10-27.png
