samam624/ProjectTreebeard/MSV4/docs/msv4_sensor11_cycle_2026-10-27.png

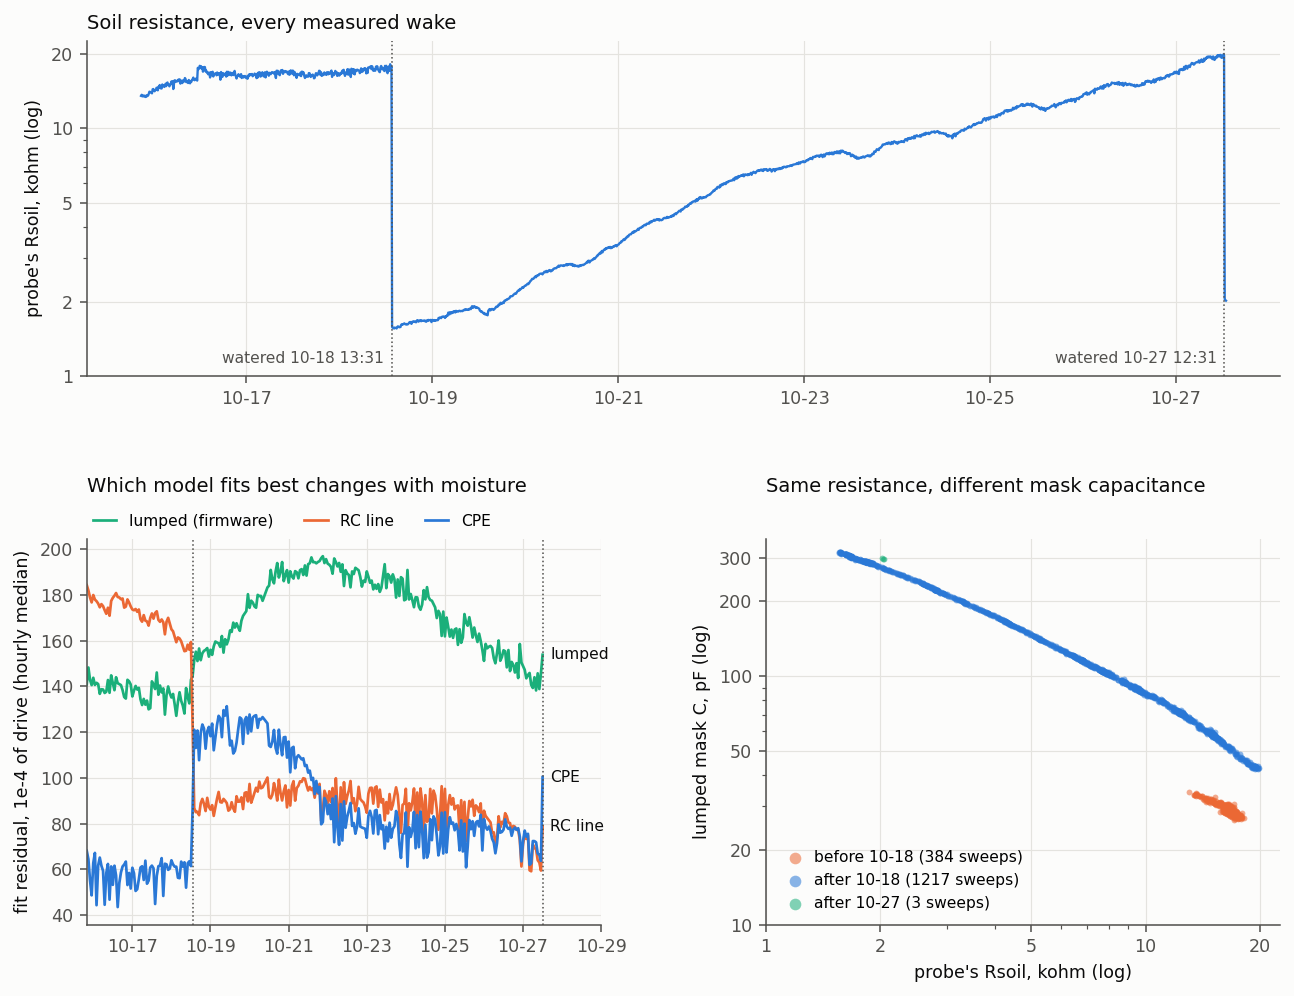
MSV4/docs/msv4_sensor11_cycle_2026-10-27.png
