samam624/ProjectTreebeard/MSV4/docs/MSV4_SENSOR_SMALL_SIGNAL_SCHEMATIC.png

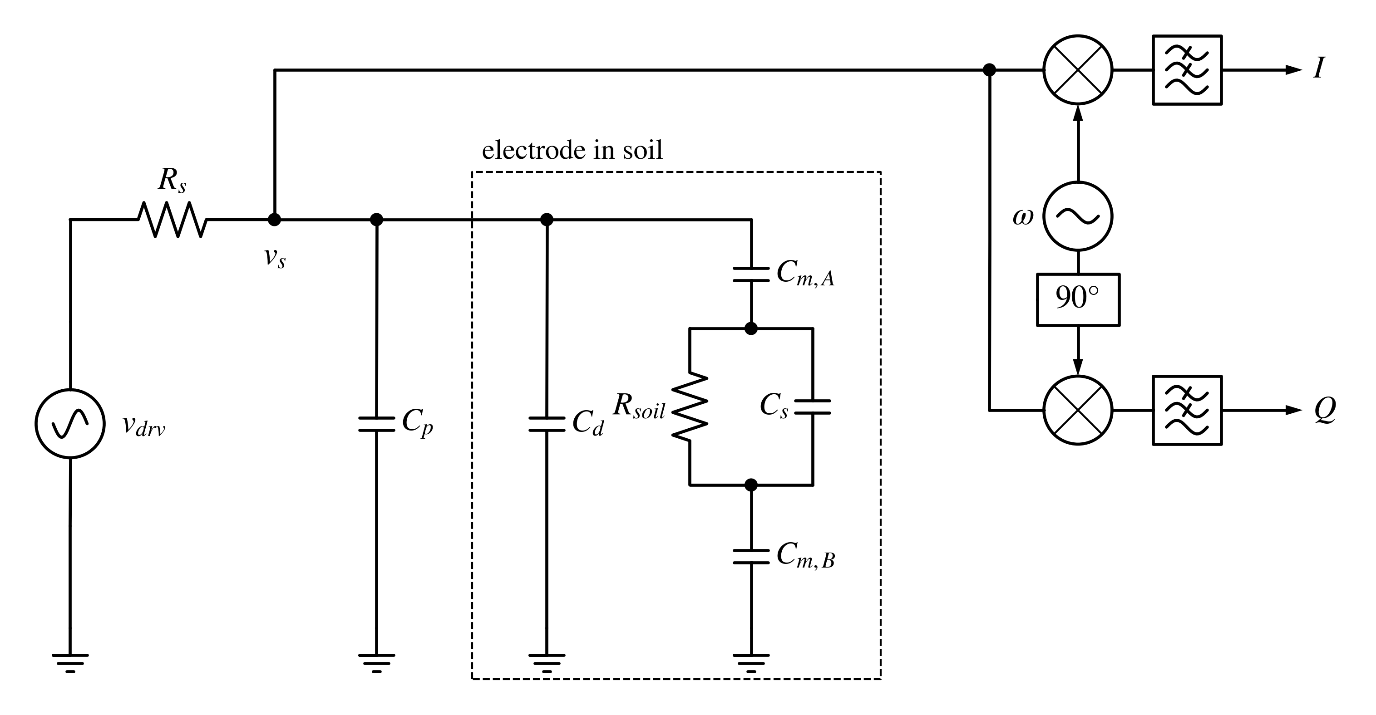
MSV4/docs/MSV4_SENSOR_SMALL_SIGNAL_SCHEMATIC.png
