samam624/ProjectTreebeard/MSV4/docs/MSV4_SMALL_SIGNAL_MODEL_IQ_2026-09-29.png

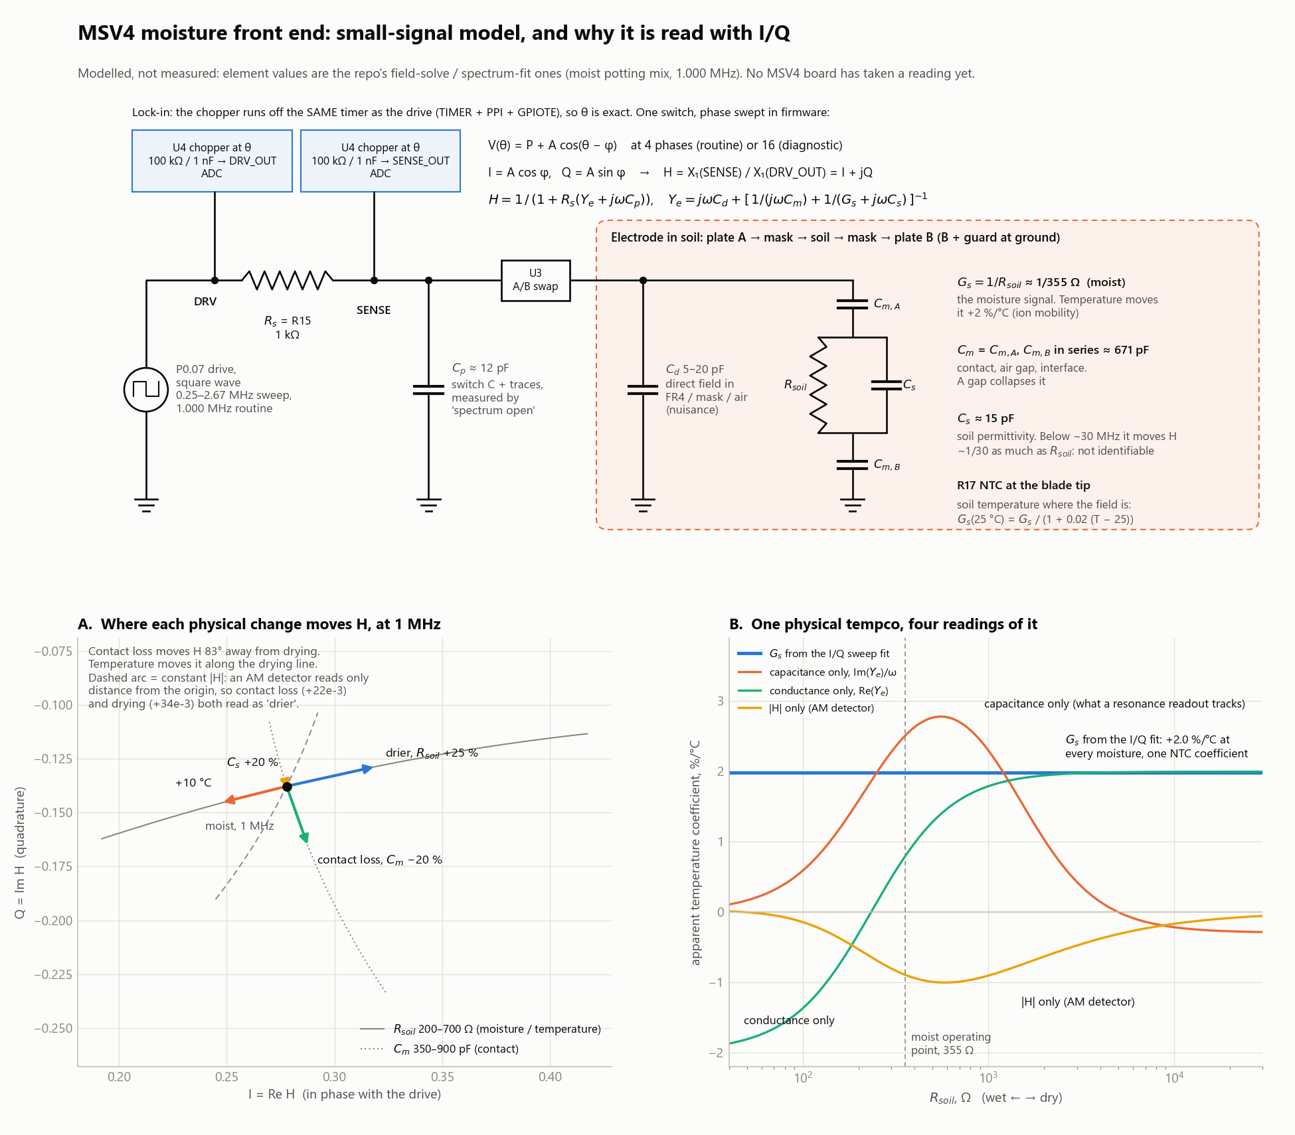
MSV4/docs/MSV4_SMALL_SIGNAL_MODEL_IQ_2026-09-29.png
