samam624/ProjectTreebeard/MSV4/hardware/MSV4_Probe_Enclosures/renders/arm_v5_fit_top.png

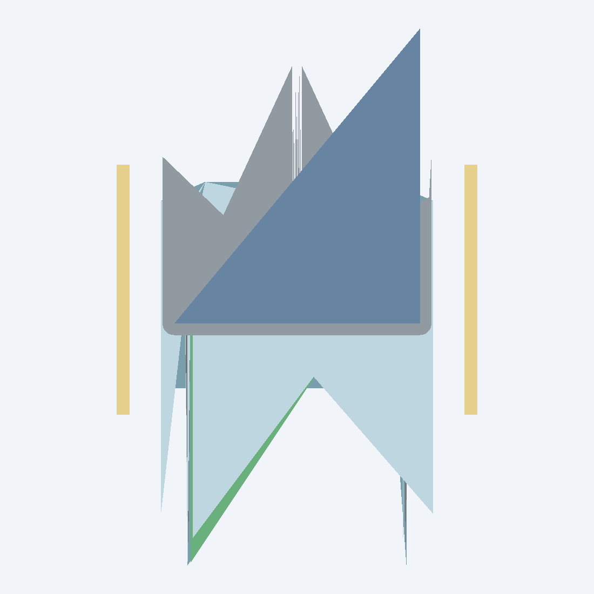
MSV4/hardware/MSV4_Probe_Enclosures/renders/arm_v5_fit_top.png
