samam624/ProjectTreebeard/MSV4/hardware/MSV4_Probe_Enclosures/renders/minimum_profile_arm_v5_5_fit_open_top.png

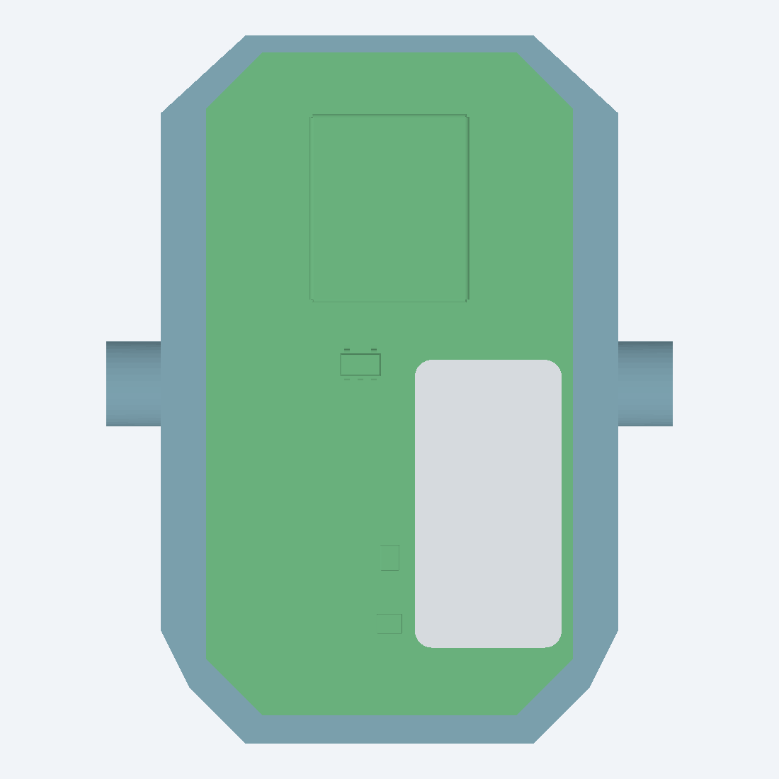
MSV4/hardware/MSV4_Probe_Enclosures/renders/minimum_profile_arm_v5_5_fit_open_top.png
