samam624/ProjectTreebeard/MSV4/hardware/MSV4_Probe_Enclosures/renders/minimum_profile_v5_fit_isometric.png

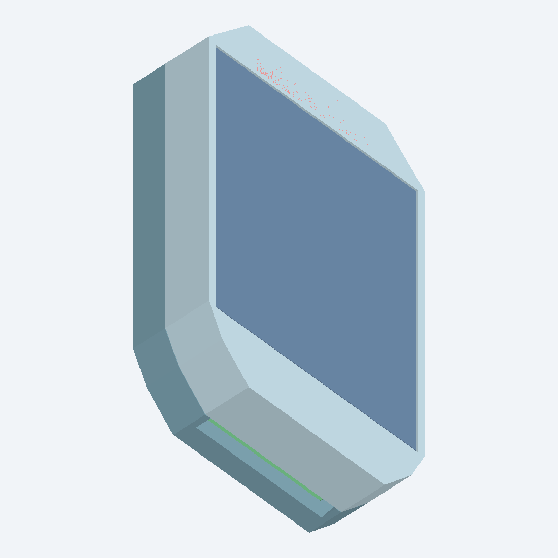
MSV4/hardware/MSV4_Probe_Enclosures/renders/minimum_profile_v5_fit_isometric.png
