samam624/ProjectTreebeard/MSV4/hardware/MSV4_Probe_PCB/images/MSV4_pcb_3d_detail.png

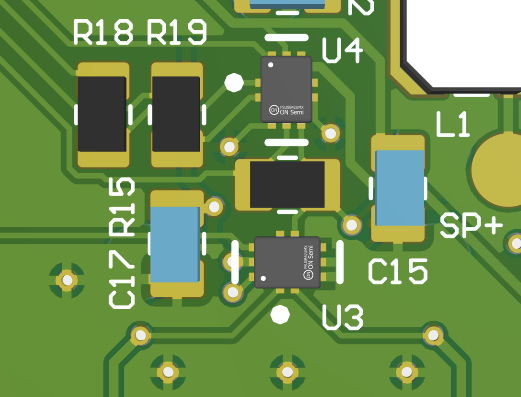
MSV4/hardware/MSV4_Probe_PCB/images/MSV4_pcb_3d_detail.png
