samam624/ProjectTreebeard/MSV4/hardware/MSV4_Probe_PCB/images/MSV4_schematic_overview.png

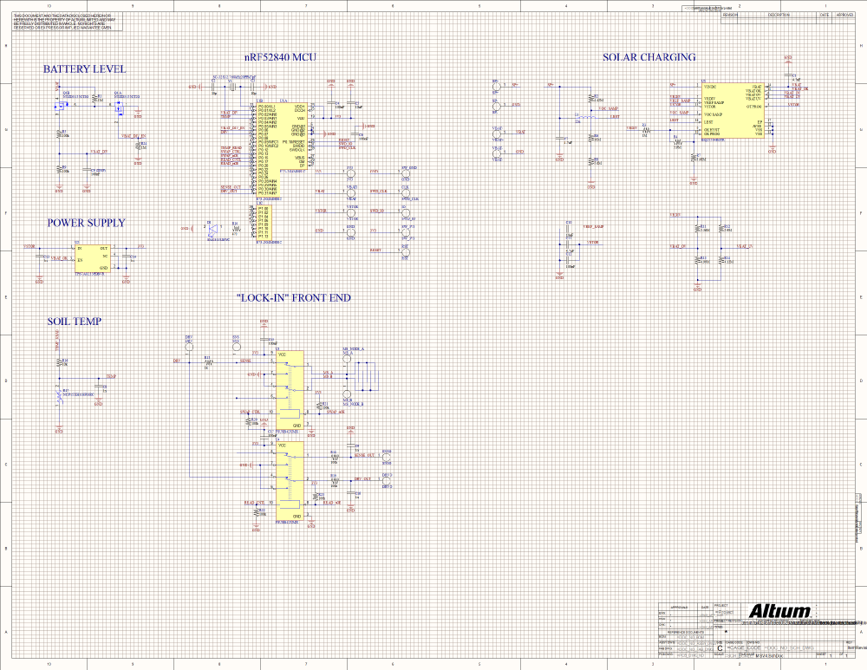
MSV4/hardware/MSV4_Probe_PCB/images/MSV4_schematic_overview.png
