samam624/ProjectTreebeard/MSV4/hardware/MSV4_Probe_PCB/images/MSV4_tip_ntc_3d.png

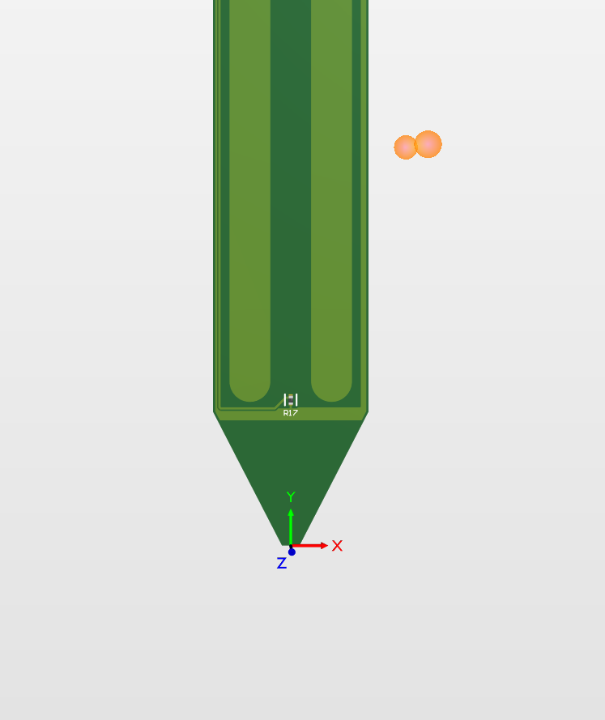
MSV4/hardware/MSV4_Probe_PCB/images/MSV4_tip_ntc_3d.png
