samam624/ProjectTreebeard/scripts/fixtures/msv2-pairing-qr.png

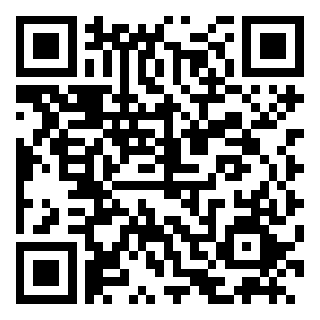
scripts/fixtures/msv2-pairing-qr.png
