samam624/ProjectTreebeard/web/plant-dashboard/assets/plant_gifs/color_hanging_vine.gif

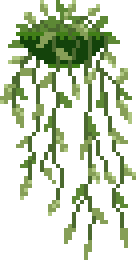
web/plant-dashboard/assets/plant_gifs/color_hanging_vine.gif
