samam624/ProjectTreebeard/hardware/procurement/lcsc_verified_parts.csv

Class | Value | Package | Spec | LCSC Part # | Manufacturer | Manufacturer Part Number | Status | Verified | Notes
C0G | 10pF | 0805 | 50V 5% C0G | C107107 | YAGEO | CC0805JRNPO9BN100 | in stock (515k) | 2026-09-19 | backup Walsin C123640. DEAD: Samsung C1785 CL21C100JBANNNC went Not Available 2026-09-19
C0G | 1nF | 0805 | 50V 5% C0G | C62774 | YAGEO | CC0805JRNPO9BN102 | in stock (991350; MOQ/multiple 50; $0.0097 at 50) | 2026-10-11 | backup Walsin C152850. DEAD: Samsung CL21C102JBCNNNL C19578151 Not Available
C0G | 10nF | 0805 | 50V 5% C0G | C97905 | muRata | GRM2195C1H103JA01D | ordered MSV3 2026-07-31 and MSV4 2026-09-19 | 2026-09-19 | low leakage (BQ25504 VREF_SAMP). backup muRata C441760 GRM2195C1H103FA01D (1%). DEAD: TDK C20487925 backordered
X7R | 100nF | 0805 | 50V 10% X7R | C49678 | YAGEO | CC0805KRX7R9BB104 | in stock (9.8M) | 2026-09-19
X7R | 1uF | 0805 | 50V 10% X7R | C28323 | Samsung Electro-Mechanics | CL21B105KBFNNNE | in stock | 2026-09-19
X7R | 10nF | 0805 | 50V 10% X7R | C83170 | YAGEO | CC0805KRX7R9BB103 | ordered 2026-07-31 | 2026-07-31 | NOT for low-leakage/timing nodes - use the C0G row
X5R | 4.7uF | 0805 | 25V 10% X5R | C1779 | Samsung Electro-Mechanics | CL21A475KAQNNNE | in stock (1.9M) | 2026-09-19
X5R | 10uF | 0805 | 16V 10% X5R | C1713 | Samsung Electro-Mechanics | CL21A106KOQNNNE | in stock (517k) | 2026-09-19
R | 470 ohm | 0805 | 1% 0.125W | C17710 | UNI-ROYAL | 0805W8F4700T5E | in stock (2.4M) | 2026-09-19 | JLC basic
R | 1k ohm | 0805 | 1% 0.125W | C2907232 | FOJAN | FRC0805F1001TS | in stock (7.8M) | 2026-09-19
R | 10k ohm | 0805 | 1% 0.125W | C2907219 | FOJAN | FRC0805F1002TS | in stock (6.9M) | 2026-09-19
R | 100k ohm | 0805 | 1% 0.125W | C149504 | UNI-ROYAL | 0805W8F1003T5E | in stock (3.5M) | 2026-09-19
R | 1M ohm | 0805 | 1% 0.125W | C2933280 | FOJAN | FRC0805F1004TS | in stock (2.1M) | 2026-09-19
R | 3.48M ohm | 0805 | 1% 0.125W | C483097 | YAGEO | RC0805FR-073M48L | in stock | 2026-09-19
R | 4.12M ohm | 0805 | 1% 0.125W | C55174802 | FOJAN | FRC0805F4124TS | in stock (4.8k) | 2026-09-19 | also Walsin C367866 WR08W4124FTL (ordered 2026-07-31)
R | 4.42M ohm | 0805 | 1% 0.125W | C483142 | YAGEO | RC0805FR-074M42L | in stock (3.8k) | 2026-09-19 | also RALEC C332857 (ordered 2026-07-31)
R | 4.99M ohm | 0805 | 1% 0.125W | C2091880 | VISHAY | CRCW08054M99FKEA | in stock (9.4k) | 2026-09-19
R | 5.36M ohm | 0805 | 1% 0.125W | C483171 | YAGEO | RC0805FR-075M36L | in stock (500) | 2026-09-19 | low stock - recheck
R | 5.6M ohm | 0805 | 1% 0.125W | C2933468 | FOJAN | FRC0805F5604TS | ordered 2026-07-31 | 2026-07-31
R | 5.9M ohm | 0805 | 1% 0.125W | C3013223 | FOJAN | FRC0805F5904TS | in stock (3.9k) | 2026-09-19 | also VISHAY C313940 (ordered 2026-07-31)
R | 10M ohm | 0805 | 1% 0.125W | C26108 | UNI-ROYAL | 0805W8F1005T5E | in stock (216k) | 2026-09-19 | LCSC text match once returned a 10 milliohm shunt (C51934136) for "10M ohm" - never order this row without the C-number
EXACT | NTC 10k B3380 | 0402 | Murata NCP15 | C77131 | muRata | NCP15XH103F03RC | in stock (296k) | 2026-09-19 | Arrow lists NRND
EXACT | 22uH 650mA | 4x4 mm | Coilcraft LPS4018 | C5278935 | Coilcraft | LPS4018-223MRC | in stock (4.2k) | 2026-09-19 | manufacturer is Coilcraft (not Bourns)
EXACT | NTZD3155CT2G | SOT-563 | N+P MOSFET | C895156 | onsemi | NTZD3155CT2G | in stock (1.9k) | 2026-09-19
EXACT | TPS7A0233PDBVR | SOT-23-5 | 3.3V LDO | C2887324 | Texas Instruments | TPS7A0233PDBVR | in stock (9k) | 2026-09-19
EXACT | FSUSB42UMX | UMLP-10 | analog switch | C11145 | onsemi | FSUSB42UMX | in stock (20312; MOQ 1; $0.3453 at 10) | 2026-10-11
EXACT | BQ25504RGTR | VQFN-16 | harvester | C2876746 | Texas Instruments | BQ25504RGTR | in stock (225) | 2026-09-19 | RGTT = C157471 same die
EXACT | SC-32S 32.768kHz | 3215 | crystal 7pF 20ppm | C97604 | Seiko | SC-32S32.768KHZ20PPM7PF | in stock (151305; MOQ/multiple 5; $0.1888 at 5) | 2026-10-11
EXACT | E73-2G4M08S1C | 18x13 mm | nRF52840 ceramic ant | C356849 | EBYTE | E73-2G4M08S1C | BACKORDERED | 2026-09-19 | buy from Ebyte store; pick the 2G4M08S1C variant (nRF52840 ceramic 13x18)
EXACT | ESP32-S3-WROOM-1U-N16R8 | SMD module | U.FL | C3013946 | Espressif | ESP32-S3-WROOM-1U-N16R8 | ordered 2026-09-19 | 2026-09-19
EXACT | 2N7002 | SOT-23 | N-MOSFET | C8545 | JSCJ | 2N7002 | in stock | 2026-09-19
EXACT | AP2112K-3.3TRG1 | SOT-23-5 | 3.3V LDO | C51118 | Diodes Inc. | AP2112K-3.3TRG1 | in stock (131k) | 2026-09-19
EXACT | B3F-1000 | THT 6x6 | tact switch | C93157 | OMRON | B3F-1000 | in stock | 2026-09-19
EXACT | 2.4GHz PCB antenna | 50x10 mm | IPEX gen 1 (U.FL) | C454914 | ZIISOR (Ebyte) | TX2400-PCB-5010 | in stock (176) | 2026-09-19 | DEAD: HJ Tech C1693678 and C1509197 (404 / no match)
EXACT | Blue LED | 0805 | 3.3V rail with 470 ohm | C497961 | HONGLITRONIC | HL-PSC-2012H203BC | ordered 2026-07-31 | 2026-07-31 | proven on MSV3; alt NationStar C84259 NCD0805B2. DEAD: Bivar SM0805UBWC C5919230 backordered
EXACT | USBLC6-2P6 | SOT-666 | USB ESD | C15999 | ST | USBLC6-2P6 | ordered 2026-07-31 | 2026-07-31
