samam624/ProjectTreebeard/generated/MSV4.csv

Comment | Designator | Footprint | LCSC Part # | Quantity | Manufacturer | Manufacturer Part Number | Description | Component Type | Resistance | Capacitance | Tolerance | Power Rating | Voltage Rating | Dielectric | TCR | Technology | Package | Procurement Class | Do Not Substitute | Lifecycle | Supplier | Supplier Part Number
4.7uF 10% 25V X5R 0805 MLCC | C1, C7, C11 | TB_C_0805_2012M |  | 3 |  |  | Generic 0805 MLCC preset; edit Capacitance only for normal use | Capacitor |  | 4.7uF | 10% |  | 25V | X5R |  | MLCC | 0805 (2012 Metric) | Commodity - fuzzy match until BOM freeze | No
10p 5% 50V C0G/NP0 0805 MLCC | C2, C3 | TB_C_0805_2012M |  | 2 |  |  | Generic 0805 MLCC preset; edit Capacitance only for normal use | Capacitor |  | 10p | 5% |  | 50V | C0G/NP0 |  | MLCC | 0805 (2012 Metric) | Commodity - fuzzy match until BOM freeze | No
100nF 10% 50V X7R 0805 MLCC | C4, C6, C12, C15, C17 | TB_C_0805_2012M |  | 5 |  |  | Generic 0805 MLCC preset; edit Capacitance only for normal use | Capacitor |  | 100nF | 10% |  | 50V | X7R |  | MLCC | 0805 (2012 Metric) | Commodity - fuzzy match until BOM freeze | No
10uF 10% 16V X5R 0805 MLCC | C5 | TB_C_0805_2012M |  | 1 |  |  | Generic 0805 MLCC preset; edit Capacitance only for normal use | Capacitor |  | 10uF | 10% |  | 16V | X5R |  | MLCC | 0805 (2012 Metric) | Commodity - fuzzy match until BOM freeze | No
1n 5% 50V C0G/NP0 0805 MLCC | C8, C9, C16 | TB_C_0805_2012M |  | 3 |  |  | Generic 0805 MLCC preset; edit Capacitance only for normal use | Capacitor |  | 1n | 5% |  | 50V | C0G/NP0 |  | MLCC | 0805 (2012 Metric) | Commodity - fuzzy match until BOM freeze | No
10nF 5% 50V C0G/NP0 0805 MLCC | C10 | TB_C_0805_2012M |  | 1 |  |  | Generic 0805 MLCC preset; edit Capacitance only for normal use | Capacitor |  | 10nF | 5% |  | 50V | C0G/NP0 |  | MLCC | 0805 (2012 Metric) | Commodity - fuzzy match until BOM freeze | No
1u 10% 50V X7R 0805 MLCC | C13, C14 | TB_C_0805_2012M |  | 2 |  |  | Generic 0805 MLCC preset; edit Capacitance only for normal use | Capacitor |  | 1u | 10% |  | 50V | X7R |  | MLCC | 0805 (2012 Metric) | Commodity - fuzzy match until BOM freeze | No
SM0805UBWC | D1 | FP-SM0805UBWC-MFG |  | 1 | Bivar | SM0805UBWC | LED BLUE CLEAR 0805 SMD |  |  |  |  |  |  |  |  |  |  | Exact manufacturer part | Yes | Volume Production | DigiKey | 492-1330-6-ND
LPS4018-223MRC | L1 | IND_LPS4018-223MRC |  | 1 | Bourns | LPS4018-223MRC | 22 uH Shielded Drum Core Inductor 650 mA 360mOhm Max Nonstandard |  |  |  |  |  |  |  |  |  |  | Exact manufacturer part | Yes
NTZD3155CT2G | Q1 | ONSC-SOT-563-6-463A-01_V |  | 1 | onsemi | NTZD3155CT2G | Small Signal MOSFET, Complementary 20 V, 540 mA / -430 mA, with ESD Protection, 6-Pin SOT-563, Pb-Free, Tape and Reel |  |  |  |  |  |  |  |  |  |  | Exact manufacturer part | Yes | Volume Production | Arrow Electronics | NTZD3155CT2G
1M 1% 0.125W 150V 100ppm/C 0805 thick-film resistor | R1, R3, R24 | TB_R_0805_2012M |  | 3 |  |  | Generic 0805 thick-film resistor; edit Resistance only for normal use | Resistor | 1M |  | 1% | 0.125W | 150V |  | 100ppm/C | Thick Film | 0805 (2012 Metric) | Commodity - fuzzy match until BOM freeze | No
4.42M 1% 0.125W 150V 100ppm/C 0805 thick-film resistor | R2 | TB_R_0805_2012M |  | 1 |  |  | Generic 0805 thick-film resistor; edit Resistance only for normal use | Resistor | 4.42M |  | 1% | 0.125W | 150V |  | 100ppm/C | Thick Film | 0805 (2012 Metric) | Commodity - fuzzy match until BOM freeze | No
5.9M 1% 0.125W 150V 100ppm/C 0805 thick-film resistor | R4, R12 | TB_R_0805_2012M |  | 2 |  |  | Generic 0805 thick-film resistor; edit Resistance only for normal use | Resistor | 5.9M |  | 1% | 0.125W | 150V |  | 100ppm/C | Thick Film | 0805 (2012 Metric) | Commodity - fuzzy match until BOM freeze | No
100k 1% 0.125W 150V 100ppm/C 0805 thick-film resistor | R5, R9, R18, R19, R20, R21, R22, R23 | TB_R_0805_2012M |  | 8 |  |  | Generic 0805 thick-film resistor; edit Resistance only for normal use | Resistor | 100k |  | 1% | 0.125W | 150V |  | 100ppm/C | Thick Film | 0805 (2012 Metric) | Commodity - fuzzy match until BOM freeze | No
10M 1% 0.125W 150V 100ppm/C 0805 thick-film resistor | R6 | TB_R_0805_2012M |  | 1 |  |  | Generic 0805 thick-film resistor; edit Resistance only for normal use | Resistor | 10M |  | 1% | 0.125W | 150V |  | 100ppm/C | Thick Film | 0805 (2012 Metric) | Commodity - fuzzy match until BOM freeze | No
3.48M 1% 0.125W 150V 100ppm/C 0805 thick-film resistor | R7 | TB_R_0805_2012M |  | 1 |  |  | Generic 0805 thick-film resistor; edit Resistance only for normal use | Resistor | 3.48M |  | 1% | 0.125W | 150V |  | 100ppm/C | Thick Film | 0805 (2012 Metric) | Commodity - fuzzy match until BOM freeze | No
5.6M 1% 0.125W 150V 100ppm/C 0805 thick-film resistor | R8 | TB_R_0805_2012M |  | 1 |  |  | Generic 0805 thick-film resistor; edit Resistance only for normal use | Resistor | 5.6M |  | 1% | 0.125W | 150V |  | 100ppm/C | Thick Film | 0805 (2012 Metric) | Commodity - fuzzy match until BOM freeze | No
470 1% 0.125W 150V 100ppm/C 0805 thick-film resistor | R10 | TB_R_0805_2012M |  | 1 |  |  | Generic 0805 thick-film resistor; edit Resistance only for normal use | Resistor | 470 |  | 1% | 0.125W | 150V |  | 100ppm/C | Thick Film | 0805 (2012 Metric) | Commodity - fuzzy match until BOM freeze | No
5.36M 1% 0.125W 150V 100ppm/C 0805 thick-film resistor | R11 | TB_R_0805_2012M |  | 1 |  |  | Generic 0805 thick-film resistor; edit Resistance only for normal use | Resistor | 5.36M |  | 1% | 0.125W | 150V |  | 100ppm/C | Thick Film | 0805 (2012 Metric) | Commodity - fuzzy match until BOM freeze | No
4.99M 1% 0.125W 150V 100ppm/C 0805 thick-film resistor | R13 | TB_R_0805_2012M |  | 1 |  |  | Generic 0805 thick-film resistor; edit Resistance only for normal use | Resistor | 4.99M |  | 1% | 0.125W | 150V |  | 100ppm/C | Thick Film | 0805 (2012 Metric) | Commodity - fuzzy match until BOM freeze | No
4.12M 1% 0.125W 150V 100ppm/C 0805 thick-film resistor | R14 | TB_R_0805_2012M |  | 1 |  |  | Generic 0805 thick-film resistor; edit Resistance only for normal use | Resistor | 4.12M |  | 1% | 0.125W | 150V |  | 100ppm/C | Thick Film | 0805 (2012 Metric) | Commodity - fuzzy match until BOM freeze | No
1k 1% 0.125W 150V 100ppm/C 0805 thick-film resistor | R15 | TB_R_0805_2012M |  | 1 |  |  | Generic 0805 thick-film resistor; edit Resistance only for normal use | Resistor | 1k |  | 1% | 0.125W | 150V |  | 100ppm/C | Thick Film | 0805 (2012 Metric) | Commodity - fuzzy match until BOM freeze | No
10k 1% 0.125W 150V 100ppm/C 0805 thick-film resistor | R16 | TB_R_0805_2012M |  | 1 |  |  | Generic 0805 thick-film resistor; edit Resistance only for normal use | Resistor | 10k |  | 1% | 0.125W | 150V |  | 100ppm/C | Thick Film | 0805 (2012 Metric) | Commodity - fuzzy match until BOM freeze | No
NCP15XH103F03RC | R17 | FP-NCP15-NCU15-0_05-IPC_C |  | 1 | Murata | NCP15XH103F03RC | NTC Thermistor for Temperature Sensor, 0402, 10kO, 1%, 0.1mA, 5V |  |  |  |  |  |  |  |  |  |  | Exact manufacturer part | Yes | Not Recommended for New Design | Arrow Electronics | NCP15XH103F03RC
E73-2G4M08S1C | U1 | E73-2G4M08S1C |  | 1 | EBYTE | E73-2G4M08S1C | nRF52840 2.4GHZ SMD Wireless Module |  |  |  |  |  |  |  |  |  |  | Exact manufacturer part | Yes
TPS7A0233PDBVR | U2 | FP-DBV0005A-IPC_B |  | 1 | Texas Instruments | TPS7A0233PDBVR | IC REG LINEAR 3.3V 200MA SOT23-5 |  |  |  |  |  |  |  |  |  |  | Exact manufacturer part | Yes | Volume Production | Mouser | 595-TPS7A0233PDBVR
FSUSB42UMX | U3, U4 | FP-523BC-MFG |  | 2 | onsemi | FSUSB42UMX | IC USB SWITCH DPDT 10UMLP |  |  |  |  |  |  |  |  |  |  | Exact manufacturer part | Yes | Volume Production | Arrow Electronics | FSUSB42UMX
BQ25504RGTR | U | FP-RGT0016C-IPC_B |  | 1 | Texas Instruments | BQ25504RGTR | IC ENERGY HARV CTRLR BATT 16QFN |  |  |  |  |  |  |  |  |  |  | Exact manufacturer part | Yes | Volume Production | Arrow Electronics | BQ25504RGTR
SC-32S32.768kHz20PPM7pF | Y1 | SC-32S_SMD3215_2P | C97604 | 1 | Seiko | SC-32S32.768KHZ20PPM7PF | 32.768 kHz 7 pF +/-20 ppm SMD3215-2P crystal resonator |  |  |  |  |  |  |  |  |  |  | Exact manufacturer part | Yes | Unknown | LCSC | C97604
