samam624/ProjectTreebeard/hardware/MSV2_ESP32_DisplayCenter/V2/output/MSV3_display_fit_check_assembly.step

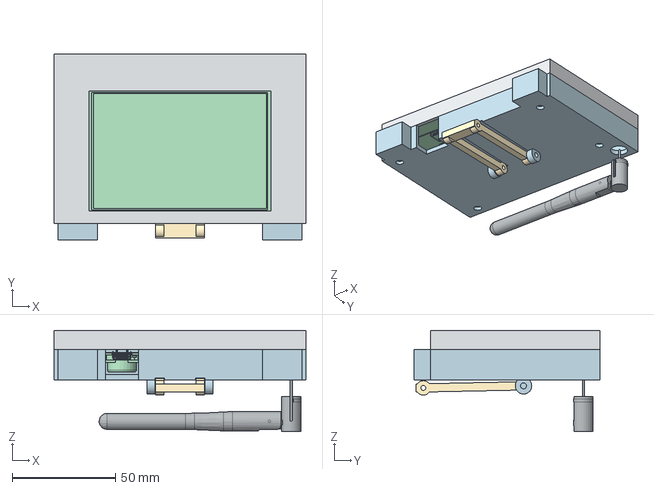
[picture p144: CAD file, 2026-08-20]
hardware/MSV2_ESP32_DisplayCenter/V2/output/MSV3_display_fit_check_assembly.step
122.0 x 90.0 x 49.1 mm
