samam624/ProjectTreebeard/hardware/MSV3_Probe_PCB_Enclosure/3D Print/MSV3_brain_enclosure_assembly_MSV3_brain_enclosure_assembly_MSV3 Solar Panel Frame_1_Body1.stl

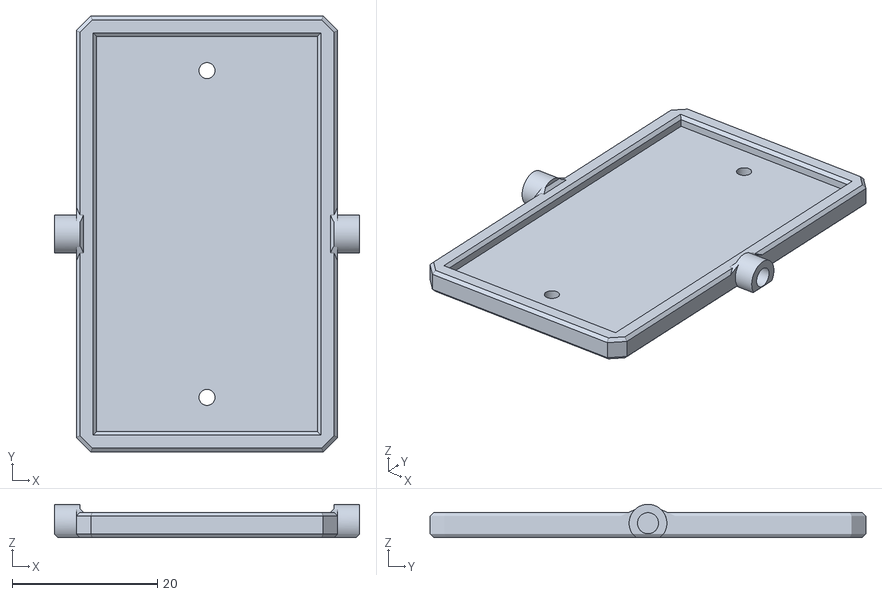
[picture p145: CAD file, 2026-08-20]
hardware/MSV3_Probe_PCB_Enclosure/3D Print/MSV3_brain_enclosure_assembly_MSV3_brain_enclosure_assembly_MSV3 Solar Panel Frame_1_Body1.stl
42.0 x 60.0 x 4.60
