samam624/ProjectTreebeard/hardware/MSV3_Probe_PCB_Enclosure/MSV3_brain_enclosure_assembly.step

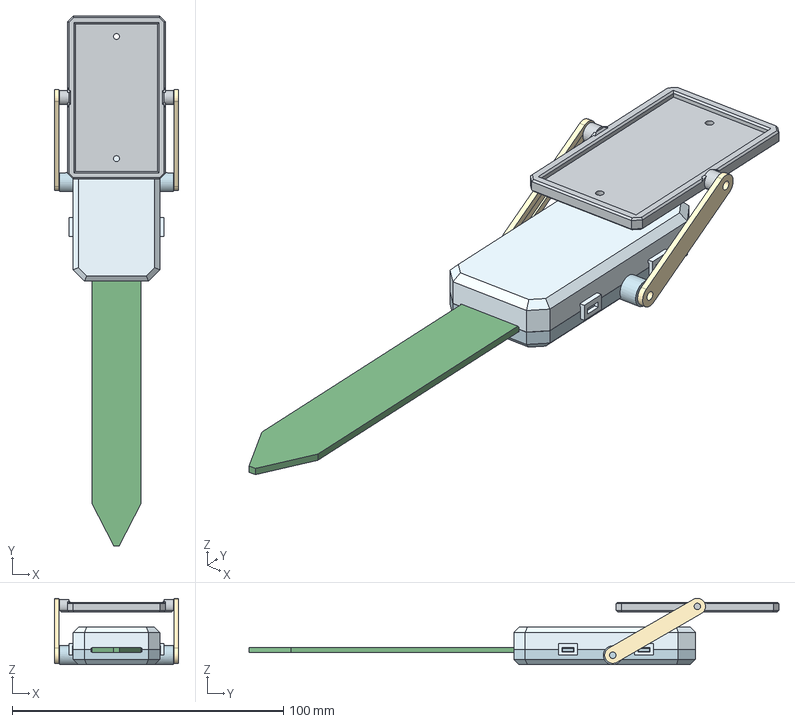
[picture p146: CAD file, 2026-08-24]
hardware/MSV3_Probe_PCB_Enclosure/MSV3_brain_enclosure_assembly.step
45.7 x 195.2 x 24.5 mm
