samam624/ProjectTreebeard/hardware/MSV3_Probe_PCB_Enclosure/3D Print/MSV3_brain_enclosure_assembly_MSV3_brain_enclosure_assembly_MSV3 Brain Enclosure Base_1_Body1.3mf

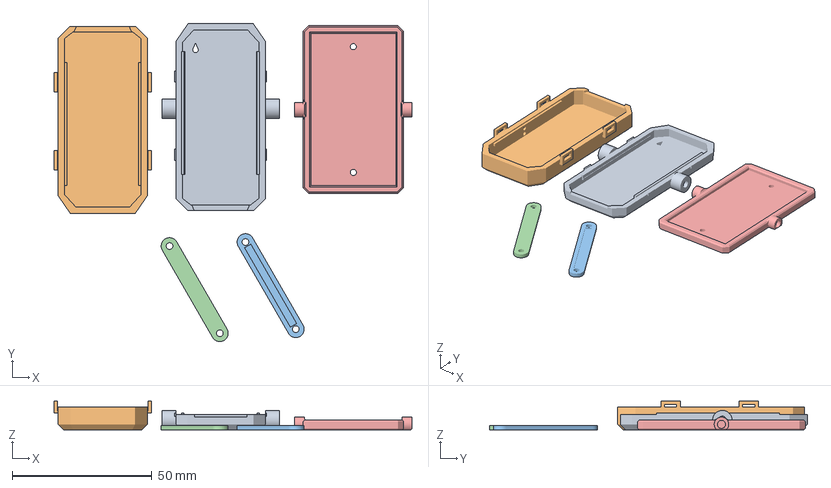
[picture p148: CAD file, 2026-08-20]
hardware/MSV3_Probe_PCB_Enclosure/3D Print/MSV3_brain_enclosure_assembly_MSV3_brain_enclosure_assembly_MSV3 Brain Enclosure Base_1_Body1.3mf
128.1 x 113.9 x 10.4 mm
MSV3_brain_enclosure_assembly_MSV3_brain_enclosure_assembly_MSV3 Brain Enclosure Base_1_Body1.stl
MSV3_brain_enclosure_assembly_MSV3_brain_enclosure_assembly_MSV3 Brain Enclosure Lid_1_Body1.stl
MSV3_brain_enclosure_assembly_MSV3_brain_enclosure_assembly_MSV3 Solar Arm Left_1_Body1.stl
MSV3_brain_enclosure_assembly_MSV3_brain_enclosure_assembly_MSV3 Solar Arm Right_1_Body1.stl
MSV3_brain_enclosure_assembly_MSV3_brain_enclosure_assembly_MSV3 Solar Panel Frame_1_Body1.stl
