samam624/ProjectTreebeard/MSV3/hardware/MSV3_Probe_PCB_Enclosure/3D Print/MSV3_brain_enclosure_assembly_MSV3_brain_enclosure_assembly_MSV3 Solar Arm Left_1_Body1.stl

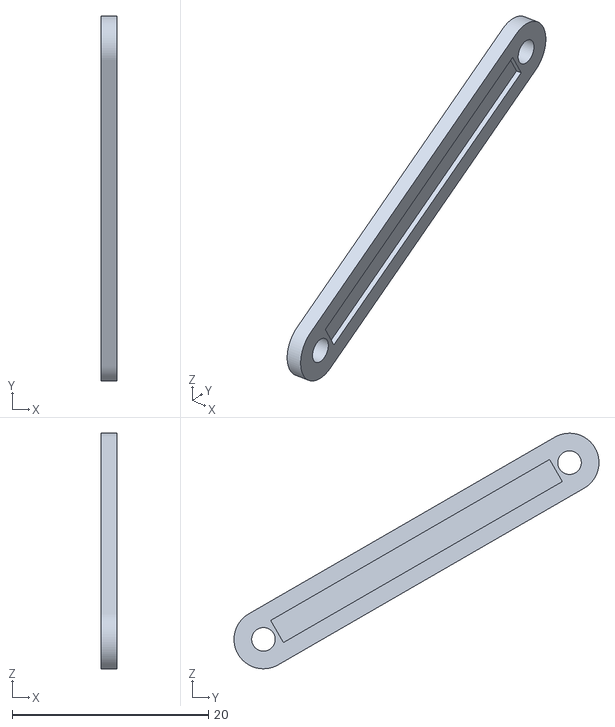
[picture p149: CAD file, 2026-08-29]
MSV3/hardware/MSV3_Probe_PCB_Enclosure/3D Print/MSV3_brain_enclosure_assembly_MSV3_brain_enclosure_assembly_MSV3 Solar Arm Left_1_Body1.stl
1.60 x 37.2 x 24.0
