samam624/ProjectTreebeard/hardware/MSV3_Probe_PCB_Enclosure/3D Print/MSV3_brain_enclosure_assembly_MSV3_brain_enclosure_assembly_MSV3 Solar Arm Right_1_Body1.stl

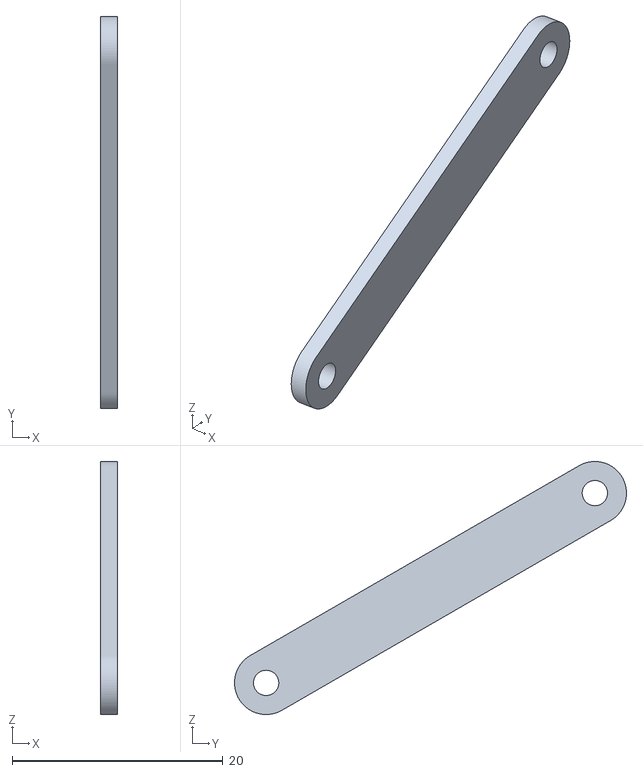
[picture p150: CAD file, 2026-08-20]
hardware/MSV3_Probe_PCB_Enclosure/3D Print/MSV3_brain_enclosure_assembly_MSV3_brain_enclosure_assembly_MSV3 Solar Arm Right_1_Body1.stl
1.60 x 37.2 x 24.0
