samam624/ProjectTreebeard/hardware/MSV3_Probe_PCB_Enclosure/3D Print/MSV3_brain_enclosure_assembly_MSV3_brain_enclosure_assembly_MSV3 Brain Enclosure Lid_1_Body1.stl

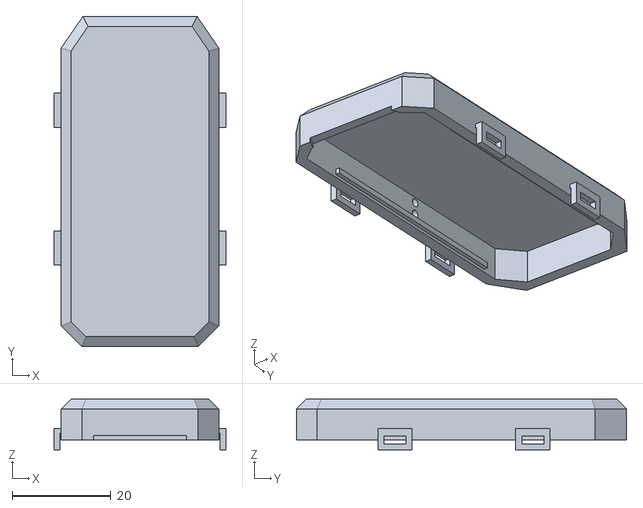
[picture p152: CAD file, 2026-08-20]
hardware/MSV3_Probe_PCB_Enclosure/3D Print/MSV3_brain_enclosure_assembly_MSV3_brain_enclosure_assembly_MSV3 Brain Enclosure Lid_1_Body1.stl
34.9 x 67.0 x 10.4
