samam624/ProjectTreebeard/MSV4/hardware/MSV4_Probe_Enclosures/output/reference/MSV4_minimum_profile_integrated_solar_assembly.step

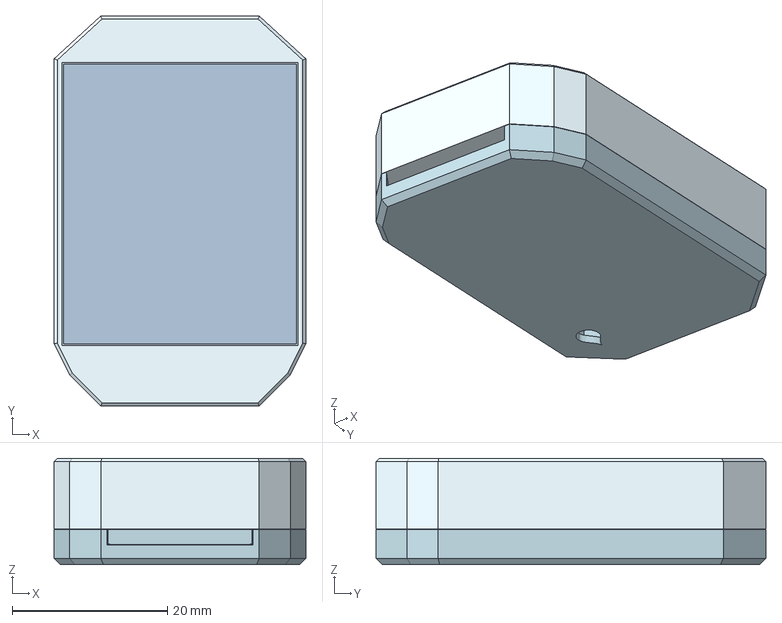
[picture p153: CAD file, 2026-11-03]
MSV4/hardware/MSV4_Probe_Enclosures/output/reference/MSV4_minimum_profile_integrated_solar_assembly.step
32.4 x 50.2 x 13.7 mm
