samam624/ProjectTreebeard/DisplayCenter/hardware/MSV2_ESP32_DisplayCenter/V2/output/MSV3_display_fit_check_assembly.step

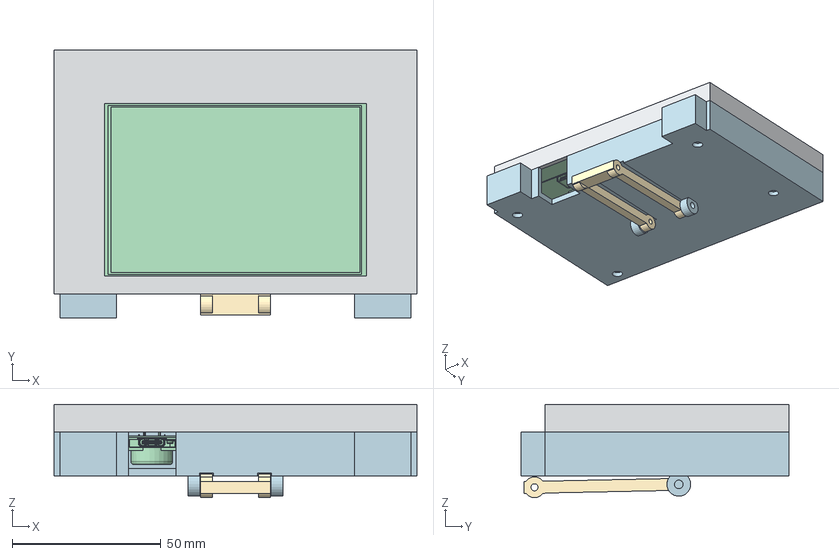
[picture p154: CAD file, 2026-09-25]
DisplayCenter/hardware/MSV2_ESP32_DisplayCenter/V2/output/MSV3_display_fit_check_assembly.step
122.0 x 90.0 x 31.4 mm
