samam624/ProjectTreebeard/MSV4/hardware/MSV4_Probe_Enclosures/output/reference/MSV4_minimum_profile_arm_solar_enclosure_assembly.step

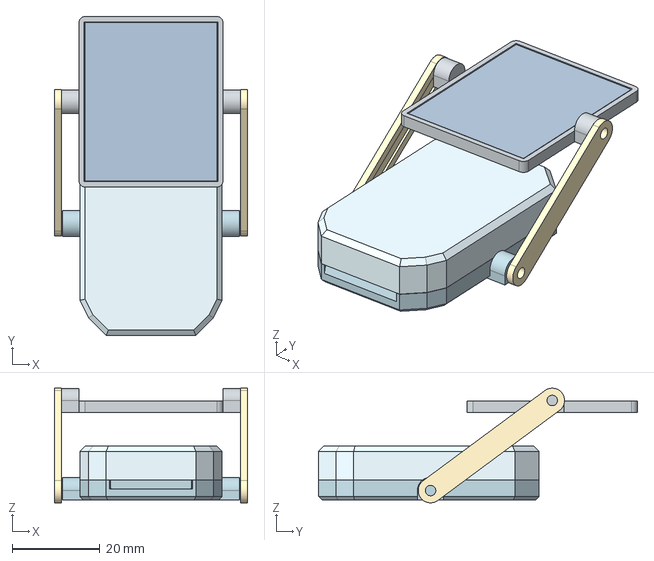
[picture p155: CAD file, 2026-11-03]
MSV4/hardware/MSV4_Probe_Enclosures/output/reference/MSV4_minimum_profile_arm_solar_enclosure_assembly.step
44.0 x 72.6 x 26.1 mm
