samam624/ProjectTreebeard/MSV3/hardware/MSV3_Probe_PCB_Enclosure/output/MSV3_brain_enclosure_assembly.step

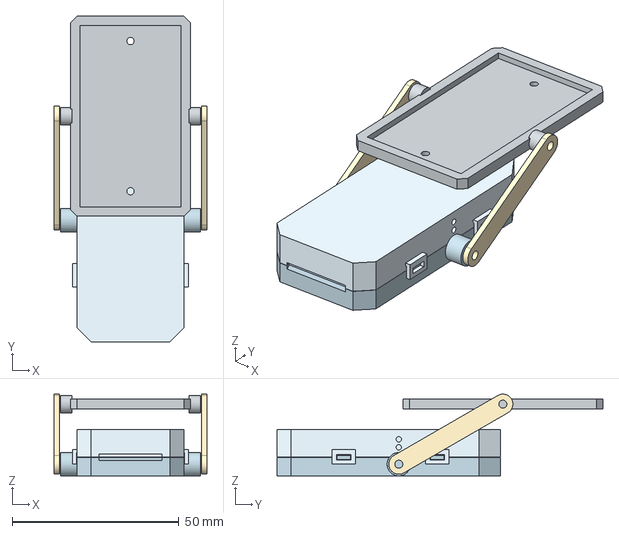
[picture p156: CAD file, 2026-11-14]
MSV3/hardware/MSV3_Probe_PCB_Enclosure/output/MSV3_brain_enclosure_assembly.step
45.7 x 97.7 x 24.5 mm
