samam624/ProjectTreebeard/MSV4/hardware/MSV4_Probe_Enclosures/output/reference/MSV4_integrated_solar_enclosure_assembly.step

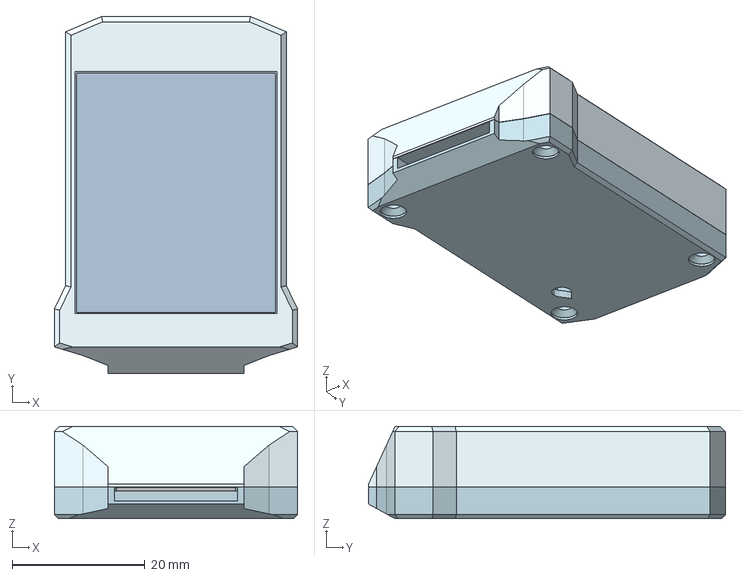
[picture p157: CAD file, 2026-10-09]
MSV4/hardware/MSV4_Probe_Enclosures/output/reference/MSV4_integrated_solar_enclosure_assembly.step
36.6 x 53.7 x 13.9 mm
