samam624/ProjectTreebeard/MSV4/hardware/MSV4_Probe_Enclosures/output/MSV4_integrated_solar_enclosure_assembly.step

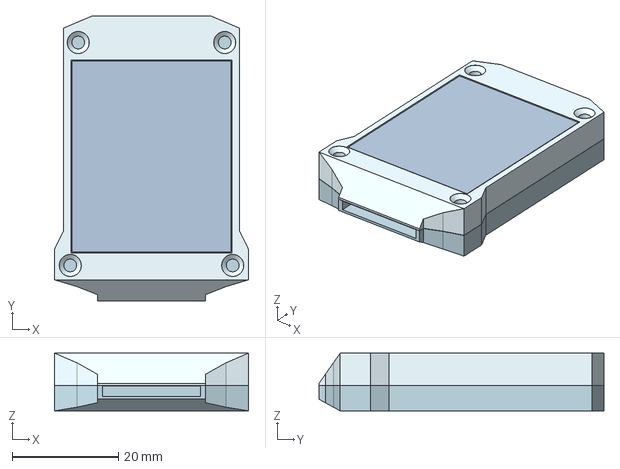
[picture p158: CAD file, 2026-10-01]
MSV4/hardware/MSV4_Probe_Enclosures/output/MSV4_integrated_solar_enclosure_assembly.step
36.6 x 53.7 x 10.9 mm
