samam624/ProjectTreebeard/MSV4/hardware/MSV4_Probe_Enclosures/output/MSV4_arm_solar_enclosure_assembly.step

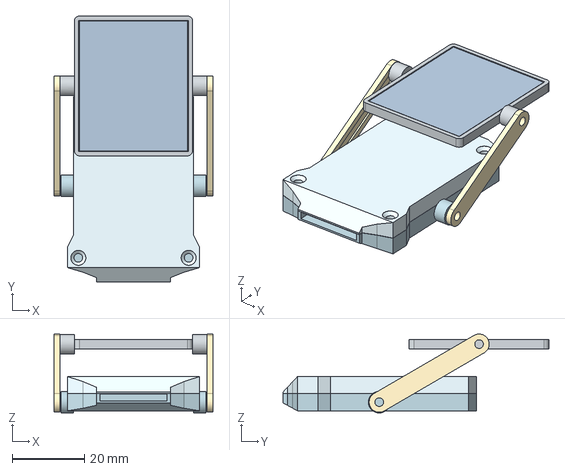
[picture p160: CAD file, 2026-10-01]
MSV4/hardware/MSV4_Probe_Enclosures/output/MSV4_arm_solar_enclosure_assembly.step
44.0 x 73.8 x 21.9 mm
