samam624/ProjectTreebeard/MSV4/hardware/MSV4_Probe_Enclosures/output/reference/MSV4_arm_solar_enclosure_assembly.step

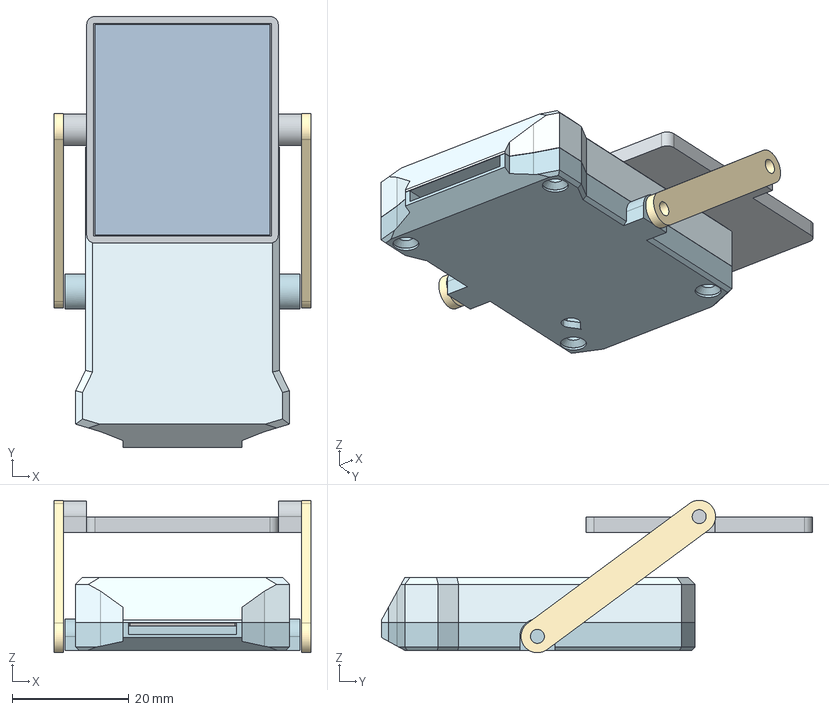
[picture p161: CAD file, 2026-10-09]
MSV4/hardware/MSV4_Probe_Enclosures/output/reference/MSV4_arm_solar_enclosure_assembly.step
44.0 x 73.8 x 26.1 mm
