samam624/ProjectTreebeard/DisplayCenter/hardware/MSV2_ESP32_DisplayCenter/3D_Print/base_enclosure_bot.3mf

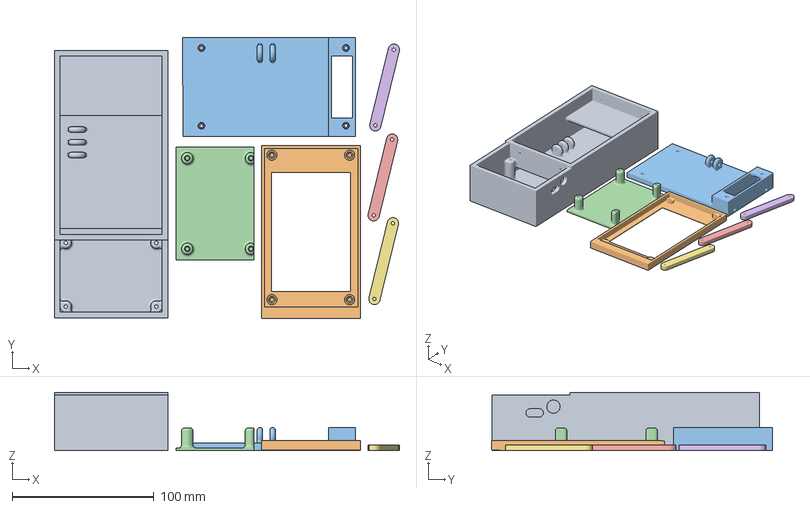
[picture p162: CAD file, 2026-11-14]
DisplayCenter/hardware/MSV2_ESP32_DisplayCenter/3D_Print/base_enclosure_bot.3mf
243.7 x 198.4 x 41.2 mm
base_enclosure_bot.stl
display_enclosure_top.stl
display_enclosure_bot.stl
base_enclosure_top.stl
lower_arm_L.stl x 3
