samam624/ProjectTreebeard/DisplayCenter/hardware/MSV2_ESP32_DisplayCenter/V2/MSV3_desktop_display.step

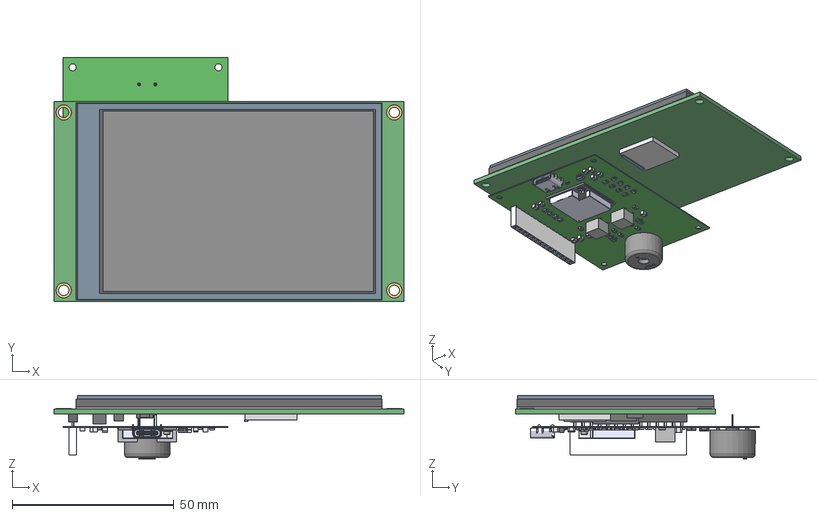
[picture p163: CAD file, 2026-08-29]
DisplayCenter/hardware/MSV2_ESP32_DisplayCenter/V2/MSV3_desktop_display.step
108.0 x 75.3 x 19.5 mm
