samam624/ProjectTreebeard/DisplayCenter/hardware/MSV2_ESP32_DisplayCenter/V2/output/MSV3_display_front_cover.step

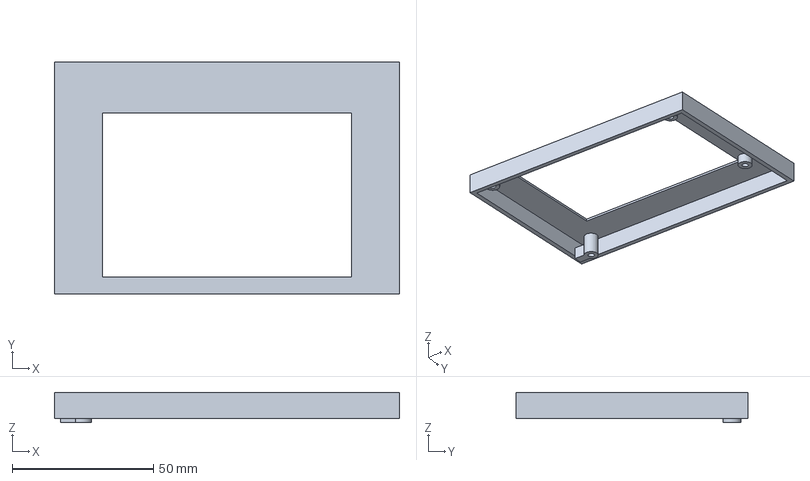
[picture p164: CAD file, 2026-09-25]
DisplayCenter/hardware/MSV2_ESP32_DisplayCenter/V2/output/MSV3_display_front_cover.step
122.0 x 82.0 x 10.6 mm
