samam624/ProjectTreebeard/hardware/MSV2_ESP32_DisplayCenter/3D_Print/display_enclosure_top_81326.stl

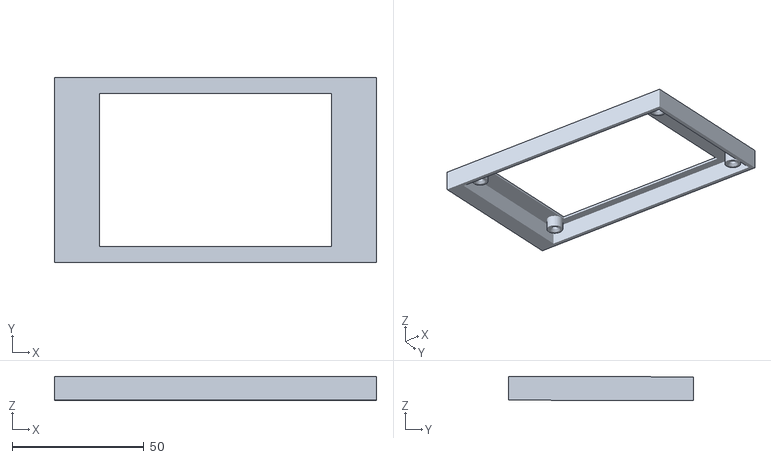
[picture p165: CAD file, 2026-08-13]
hardware/MSV2_ESP32_DisplayCenter/3D_Print/display_enclosure_top_81326.stl
122.0 x 70.0 x 9.18
