samam624/ProjectTreebeard/hardware/MSV2_ESP32_DisplayCenter/V2/design/reference_solids/screen_bezel_top.step

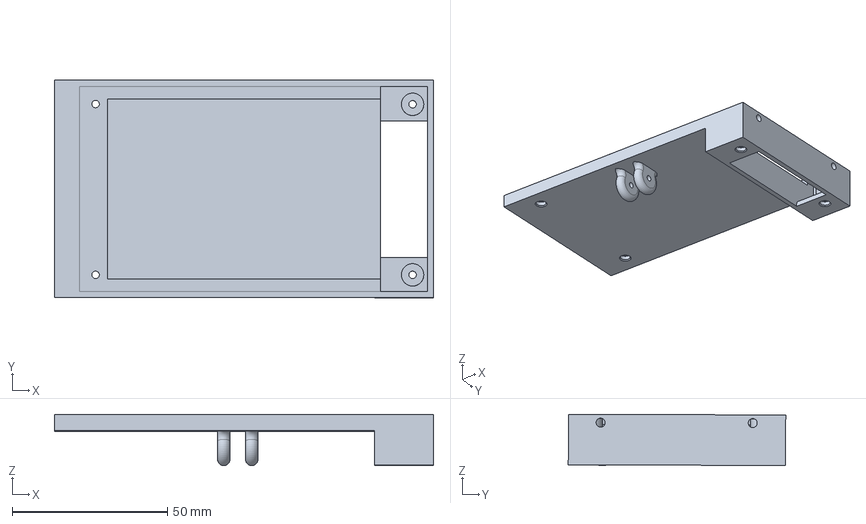
[picture p166: CAD file, 2026-08-20]
hardware/MSV2_ESP32_DisplayCenter/V2/design/reference_solids/screen_bezel_top.step
122.0 x 70.0 x 16.5 mm
