samam624/ProjectTreebeard/hardware/MSV2_ESP32_DisplayCenter/V2/MSV3_desktop_display_test.step

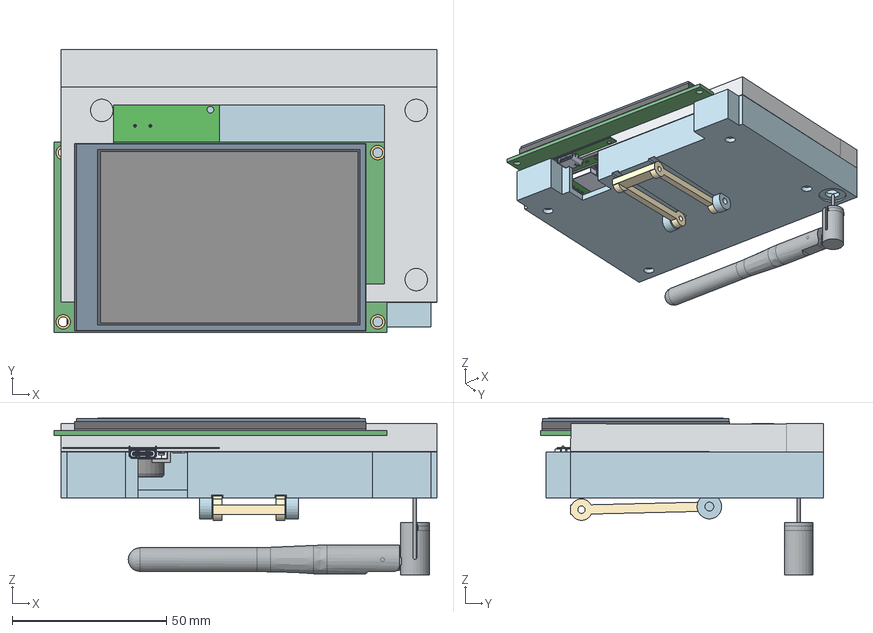
[picture p167: CAD file, 2026-08-20]
hardware/MSV2_ESP32_DisplayCenter/V2/MSV3_desktop_display_test.step
124.3 x 91.8 x 50.9 mm
