samam624/ProjectTreebeard/hardware/MSV3_Probe_PCB_Enclosure/output/m2_blended_side_closure/MSV3_brain_enclosure_base_M2_blended_side_inserts_print.stl

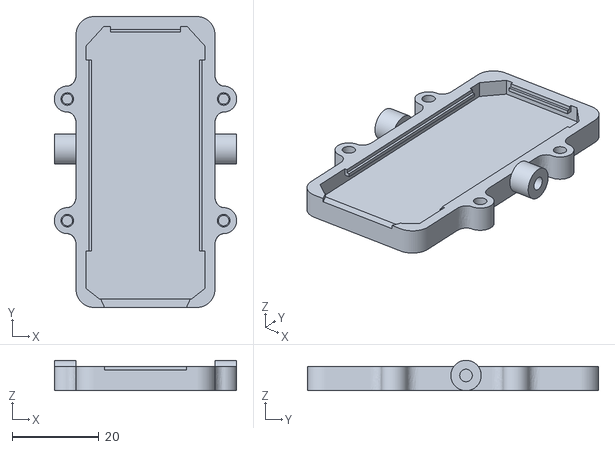
[picture p168: CAD file, 2026-08-24]
hardware/MSV3_Probe_PCB_Enclosure/output/m2_blended_side_closure/MSV3_brain_enclosure_base_M2_blended_side_inserts_print.stl
42.0 x 67.0 x 7.00
