samam624/ProjectTreebeard/MSV3/hardware/MSV3_Probe_PCB_Enclosure/MSV3_Probe_PCB.step

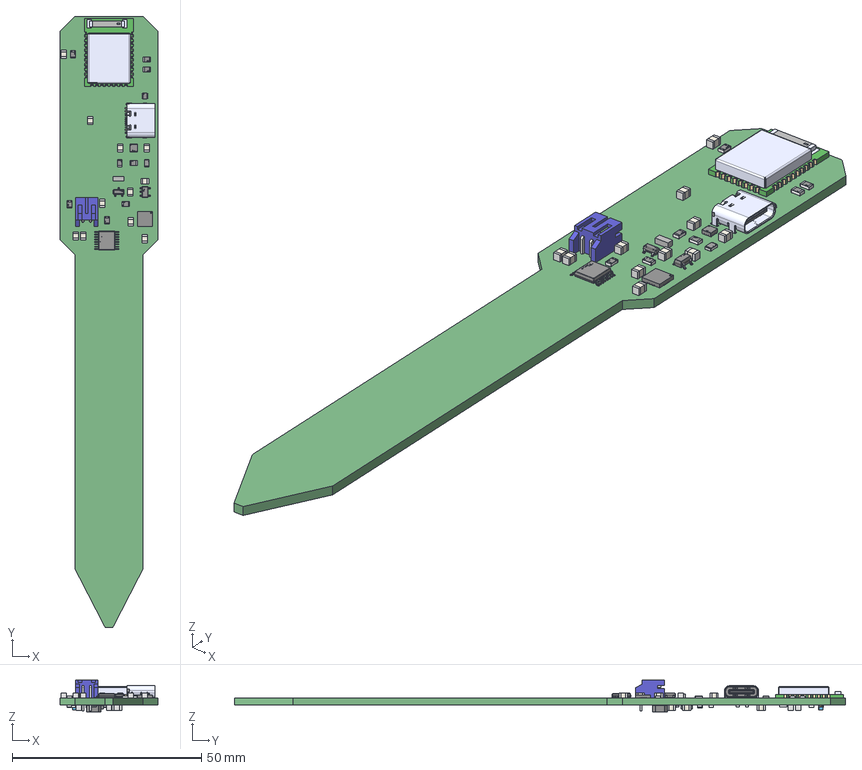
[picture p169: CAD file, 2026-08-29]
MSV3/hardware/MSV3_Probe_PCB_Enclosure/MSV3_Probe_PCB.step
26.0 x 161.5 x 8.41 mm
