samam624/ProjectTreebeard/MSV3/hardware/MSV3_Probe_PCB_Enclosure/output/m2_blended_side_closure/MSV3_M2_BACK_VIEW_LEFT_OPPOSITE_USB_V6_slicer_pack/MSV3_base_BACK_VIEW_LEFT_WIRES_WATER_DROP_V6_print.stl

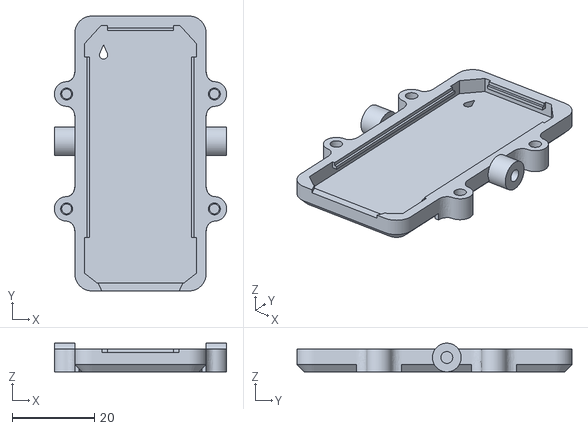
[picture p170: CAD file, 2026-11-14]
MSV3/hardware/MSV3_Probe_PCB_Enclosure/output/m2_blended_side_closure/MSV3_M2_BACK_VIEW_LEFT_OPPOSITE_USB_V6_slicer_pack/MSV3_base_BACK_VIEW_LEFT_WIRES_WATER_DROP_V6_print.stl
42.0 x 67.0 x 7.00
