samam624/ProjectTreebeard/MSV3/hardware/MSV3_Probe_PCB_Enclosure/output/MSV3_brain_enclosure_exploded.step

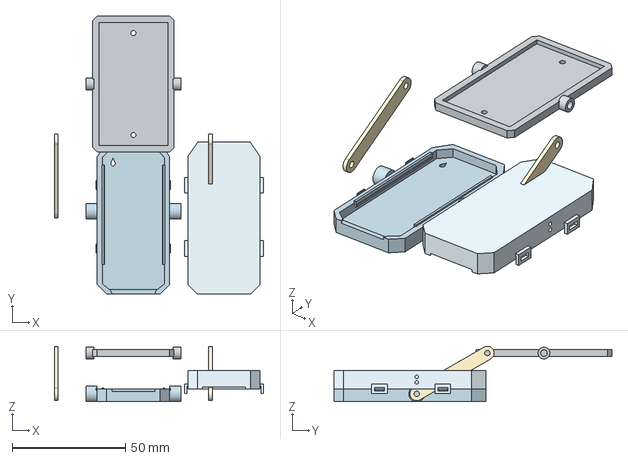
[picture p172: CAD file, 2026-11-14]
MSV3/hardware/MSV3_Probe_PCB_Enclosure/output/MSV3_brain_enclosure_exploded.step
92.3 x 122.7 x 24.5 mm
