samam624/ProjectTreebeard/MSV4/hardware/MSV4_Probe_Enclosures/output/MSV4_minimum_profile_arm_solar_PRINT.3mf

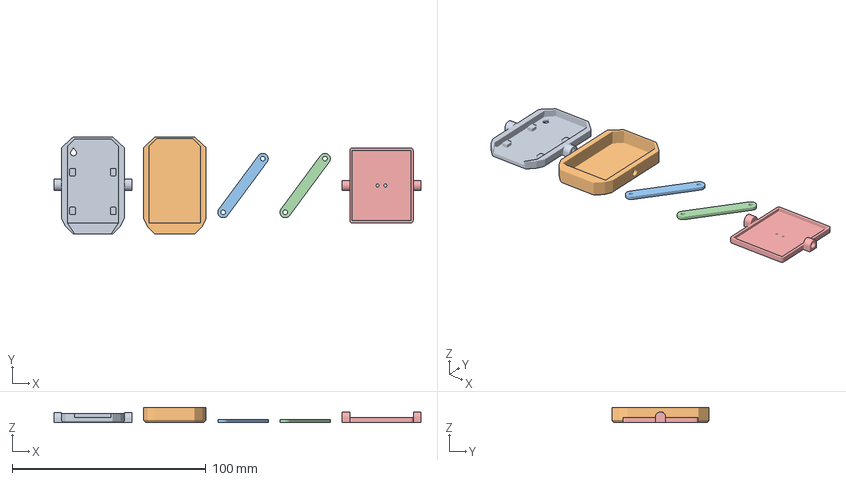
[picture p173: CAD file, 2026-11-03]
MSV4/hardware/MSV4_Probe_Enclosures/output/MSV4_minimum_profile_arm_solar_PRINT.3mf
189.6 x 50.2 x 7.70 mm
Base
Lid
Solar Arm Left
Solar Arm Right
Solar Panel Frame
