samam624/ProjectTreebeard/MSV4/hardware/MSV4_Probe_Enclosures/output/reference/minimum_profile_arm_v5_5/MSV4_minimum_profile_arm_lid_v5_5_print.stl

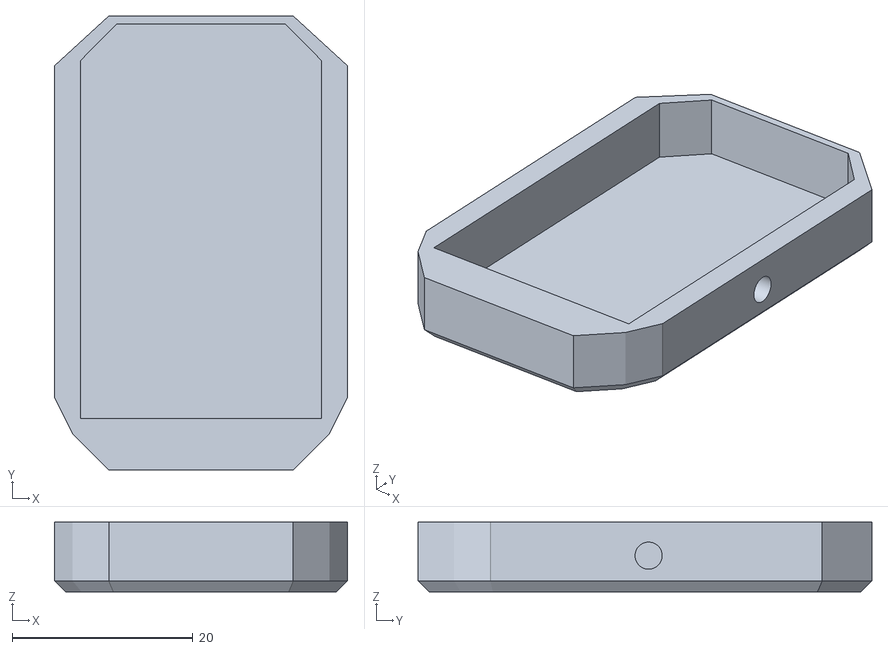
[picture p174: CAD file, 2026-11-03]
MSV4/hardware/MSV4_Probe_Enclosures/output/reference/minimum_profile_arm_v5_5/MSV4_minimum_profile_arm_lid_v5_5_print.stl
32.4 x 50.2 x 7.70
