samam624/ProjectTreebeard/MSV4/hardware/MSV4_Probe_Enclosures/output/reference/MSV4_minimum_profile_arm_solar_enclosure_fit_check_open.step

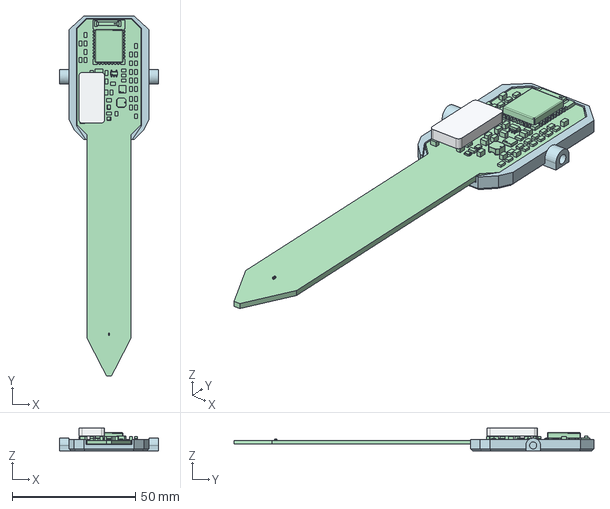
[picture p175: CAD file, 2026-11-03]
MSV4/hardware/MSV4_Probe_Enclosures/output/reference/MSV4_minimum_profile_arm_solar_enclosure_fit_check_open.step
40.2 x 146.2 x 9.15 mm
