samam624/ProjectTreebeard/DisplayCenter/hardware/MSV2_ESP32_DisplayCenter/V2/display_enclosure.step

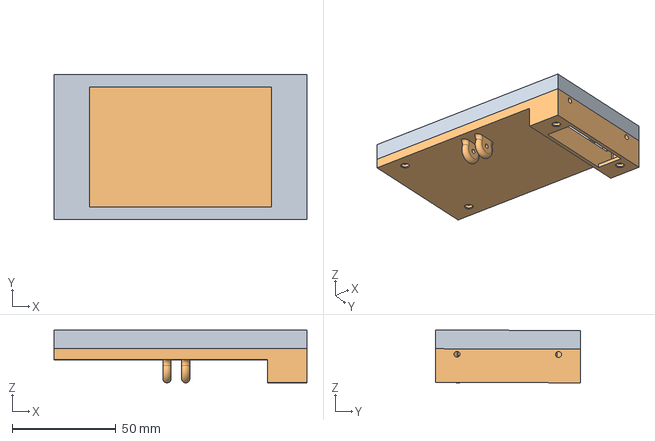
[picture p176: CAD file, 2026-08-29]
DisplayCenter/hardware/MSV2_ESP32_DisplayCenter/V2/display_enclosure.step
122.0 x 70.0 x 25.5 mm
