samam624/ProjectTreebeard/DisplayCenter/hardware/MSV2_ESP32_DisplayCenter/V2/output/MSV3_display_rear_shell.step

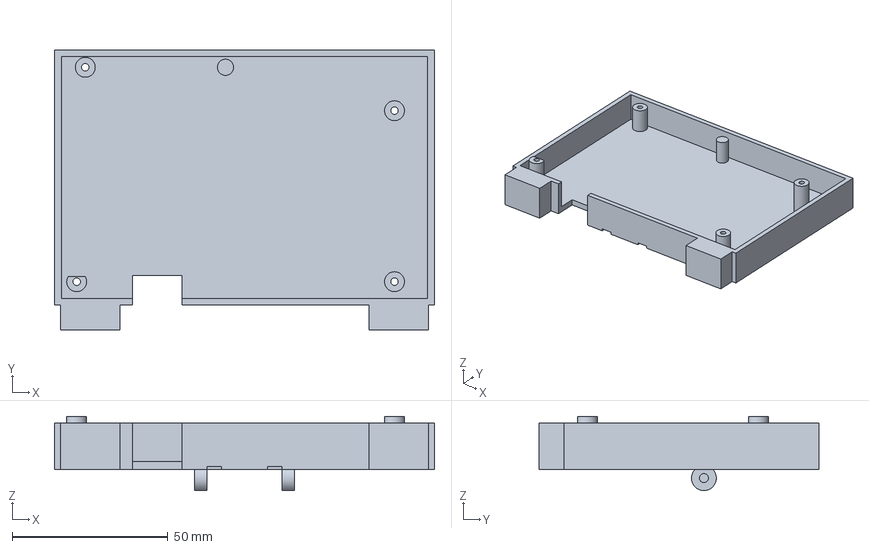
[picture p177: CAD file, 2026-09-25]
DisplayCenter/hardware/MSV2_ESP32_DisplayCenter/V2/output/MSV3_display_rear_shell.step
122.0 x 90.0 x 23.8 mm
