samam624/ProjectTreebeard/MSV3/hardware/MSV3_Probe_PCB_Enclosure/output/MSV3_brain_enclosure_base_print.stl

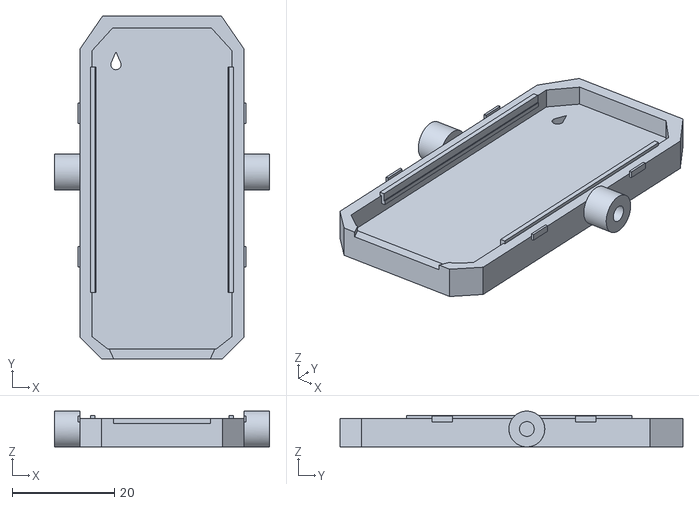
[picture p179: CAD file, 2026-11-14]
MSV3/hardware/MSV3_Probe_PCB_Enclosure/output/MSV3_brain_enclosure_base_print.stl
42.0 x 67.0 x 7.00
