samam624/ProjectTreebeard/MSV4/hardware/MSV4_Probe_Enclosures/output/MSV4_minimum_profile_solar_PRINT.3mf

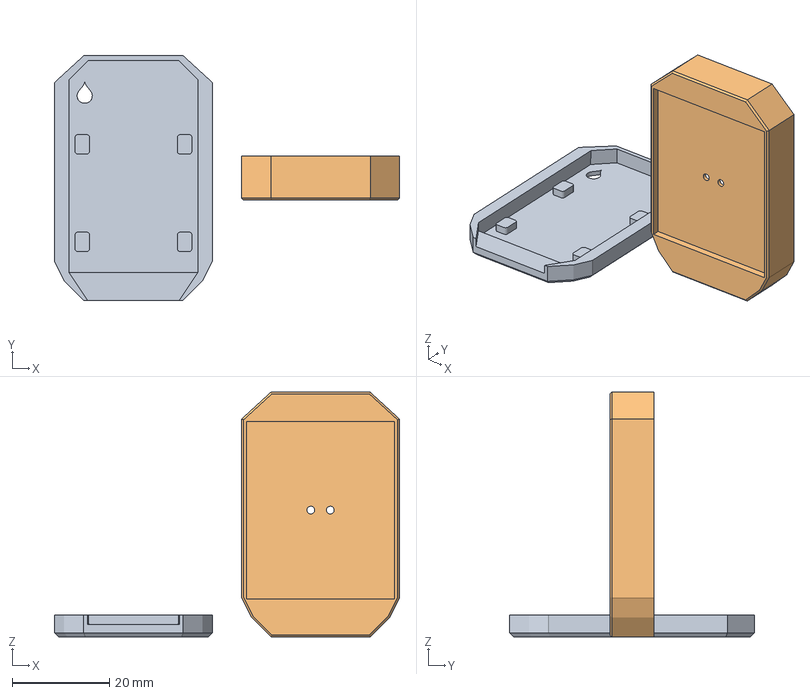
[picture p180: CAD file, 2026-11-03]
MSV4/hardware/MSV4_Probe_Enclosures/output/MSV4_minimum_profile_solar_PRINT.3mf
70.8 x 50.2 x 50.2 mm
Base
Lid
