samam624/ProjectTreebeard/MSV4/hardware/MSV4_Probe_Enclosures/output/reference/minimum_profile_arm_v5_5/MSV4_solar_arm_right_v5_5_print.stl

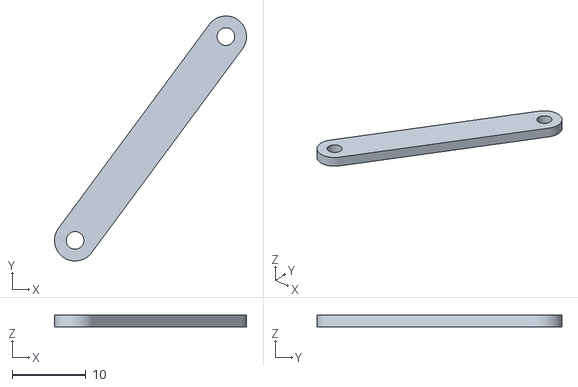
[picture p181: CAD file, 2026-11-03]
MSV4/hardware/MSV4_Probe_Enclosures/output/reference/minimum_profile_arm_v5_5/MSV4_solar_arm_right_v5_5_print.stl
26.1 x 33.3 x 1.60
