samam624/ProjectTreebeard/DisplayCenter/hardware/MSV2_ESP32_DisplayCenter/3D_Print/display_enclosure_top.stl

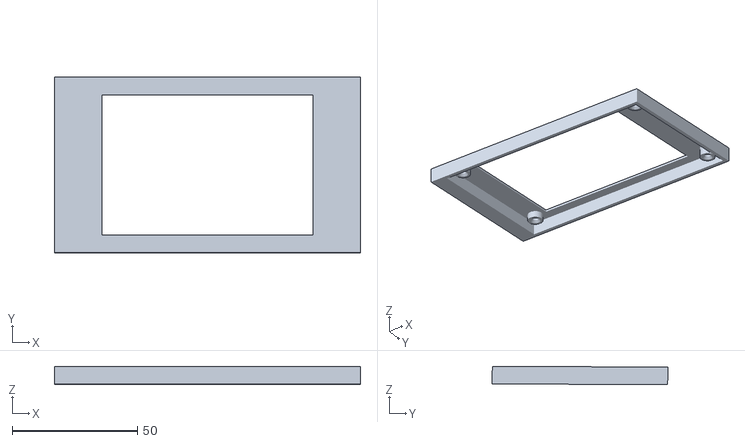
[picture p183: CAD file, 2026-08-29]
DisplayCenter/hardware/MSV2_ESP32_DisplayCenter/3D_Print/display_enclosure_top.stl
122.0 x 70.0 x 7.18
