samam624/ProjectTreebeard/DisplayCenter/hardware/MSV2_ESP32_DisplayCenter/V2/output/p1s_0p4_pla_v1/MSV2_DisplayCenter_P1S_0p4_PLA_front_and_stand_v1.3mf

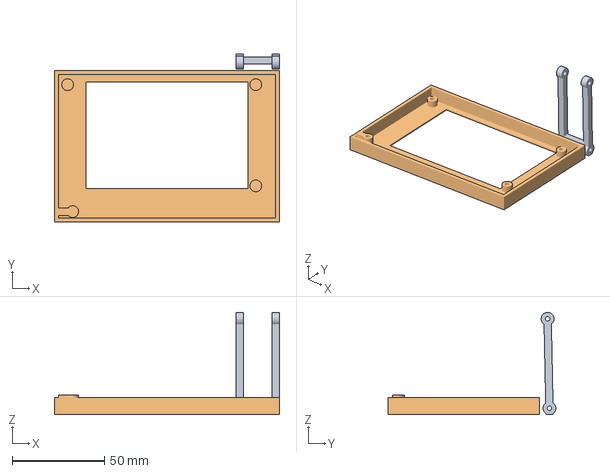
[picture p184: CAD file, 2026-09-25]
DisplayCenter/hardware/MSV2_ESP32_DisplayCenter/V2/output/p1s_0p4_pla_v1/MSV2_DisplayCenter_P1S_0p4_PLA_front_and_stand_v1.3mf
122.0 x 91.0 x 55.5 mm
MSV3_display_kickstand_print.stl
MSV3_display_front_cover_print.stl
