samam624/ProjectTreebeard/hardware/MSV2_ESP32_DisplayCenter/3D_Print/base_enclosure_top.stl

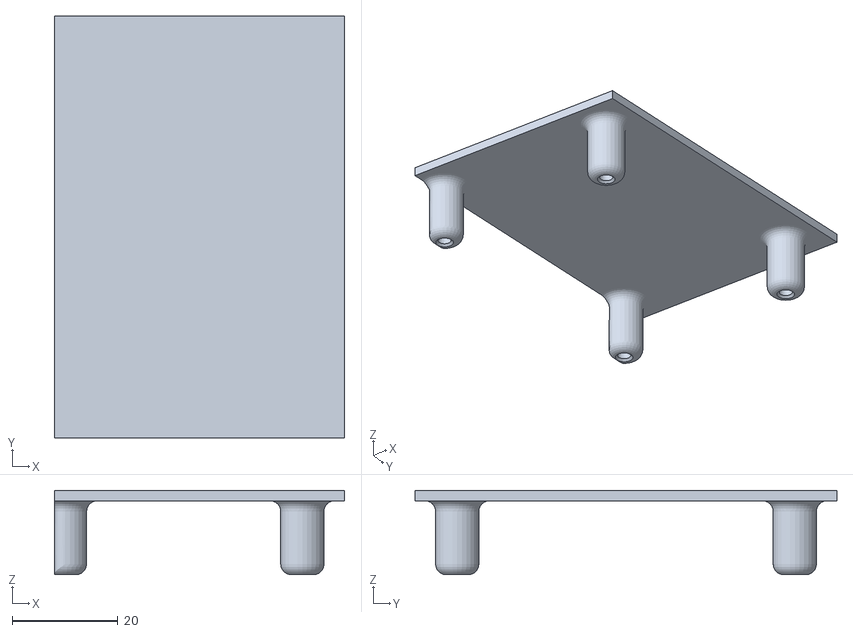
[picture p185: CAD file, 2026-07-28]
hardware/MSV2_ESP32_DisplayCenter/3D_Print/base_enclosure_top.stl
55.0 x 80.0 x 16.0
