samam624/ProjectTreebeard/hardware/MSV2_ESP32_DisplayCenter/V2/output/MSV3_display_enclosure_deployed.step

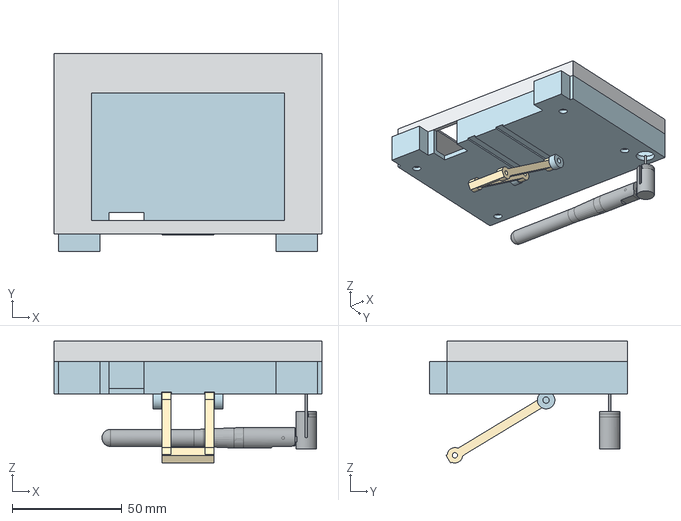
[picture p186: CAD file, 2026-08-20]
hardware/MSV2_ESP32_DisplayCenter/V2/output/MSV3_display_enclosure_deployed.step
122.0 x 90.0 x 55.5 mm
