samam624/ProjectTreebeard/hardware/MSV3_Probe_PCB_Enclosure/output/MSV3_solar_panel_frame_print.stl

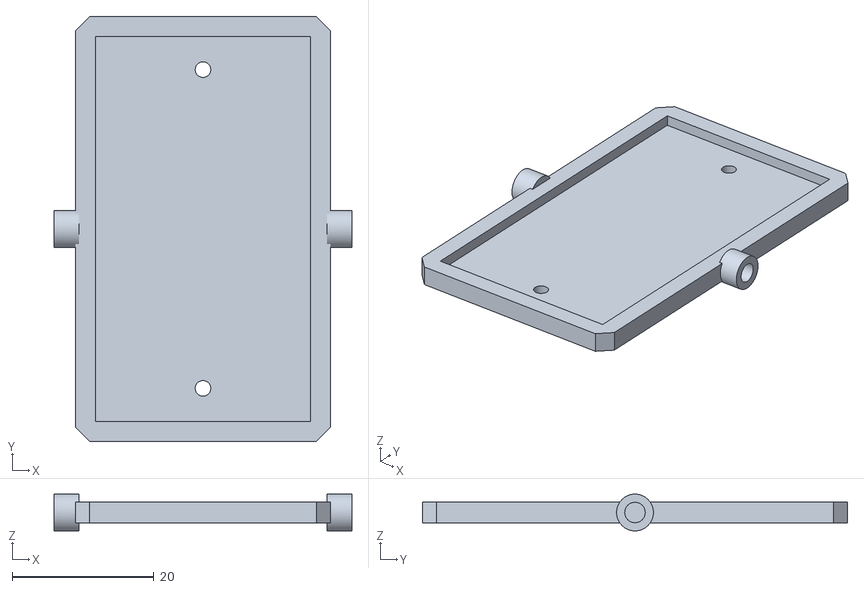
[picture p187: CAD file, 2026-08-20]
hardware/MSV3_Probe_PCB_Enclosure/output/MSV3_solar_panel_frame_print.stl
42.0 x 60.0 x 5.20
