samam624/ProjectTreebeard/MSV3/hardware/MSV3_Probe_PCB_Enclosure/output/m2_blended_side_closure/MSV3_brain_enclosure_fit_check_M2_blended_side.step

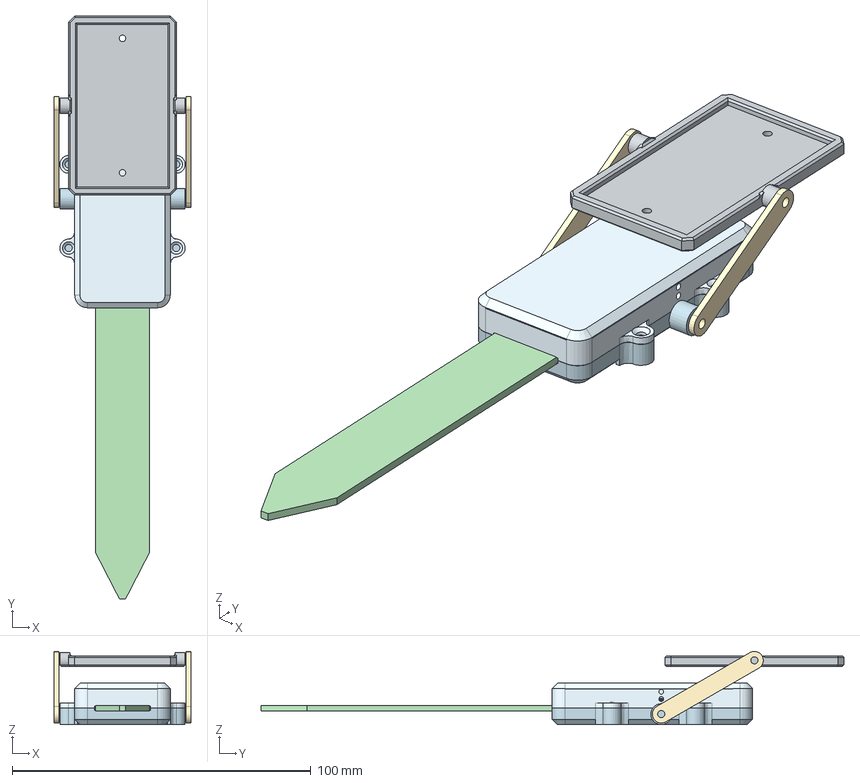
[picture p188: CAD file, 2026-11-14]
MSV3/hardware/MSV3_Probe_PCB_Enclosure/output/m2_blended_side_closure/MSV3_brain_enclosure_fit_check_M2_blended_side.step
45.7 x 195.2 x 24.5 mm
