samam624/ProjectTreebeard/MSV4/hardware/MSV4_Probe_Enclosures/output/MSV4_arm_solar_PRINT.3mf

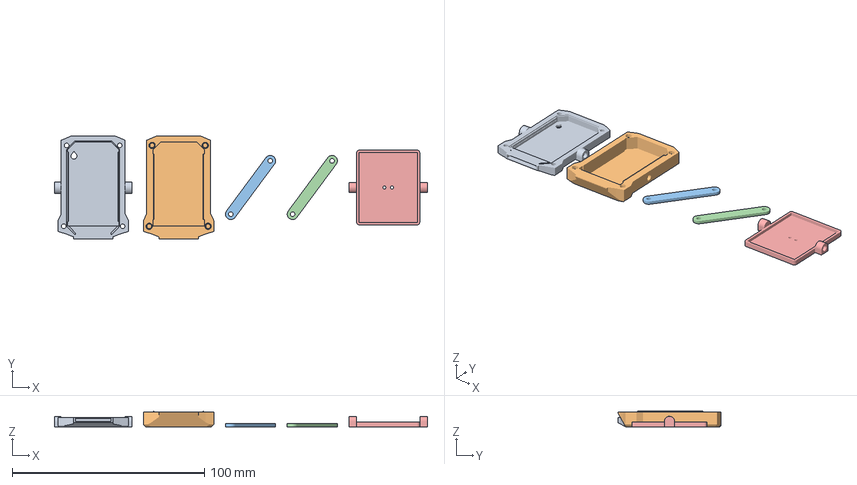
[picture p189: CAD file, 2026-10-09]
MSV4/hardware/MSV4_Probe_Enclosures/output/MSV4_arm_solar_PRINT.3mf
193.8 x 53.7 x 8.10 mm
Base
Lid
Solar Arm Left
Solar Arm Right
Solar Panel Frame
