samam624/ProjectTreebeard/MSV4/hardware/MSV4_Probe_Enclosures/output/reference/minimum_profile_arm_v5_5/MSV4_solar_panel_frame_v5_5_print.stl

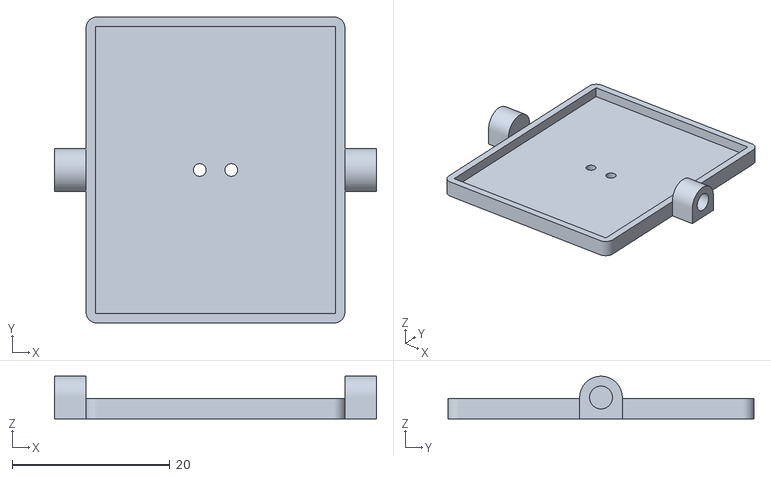
[picture p190: CAD file, 2026-11-03]
MSV4/hardware/MSV4_Probe_Enclosures/output/reference/minimum_profile_arm_v5_5/MSV4_solar_panel_frame_v5_5_print.stl
40.8 x 38.8 x 5.40
