samam624/ProjectTreebeard/MSV4/hardware/MSV4_Probe_Enclosures/output/reference/MSV4_minimum_profile_arm_solar_base.step

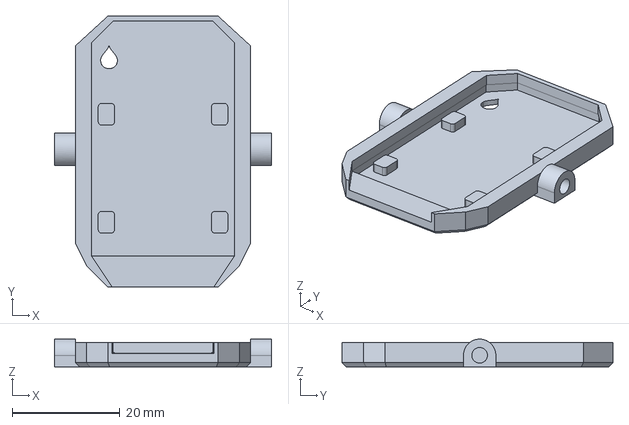
[picture p191: CAD file, 2026-11-03]
MSV4/hardware/MSV4_Probe_Enclosures/output/reference/MSV4_minimum_profile_arm_solar_base.step
40.2 x 50.2 x 5.15 mm
