samam624/ProjectTreebeard/DisplayCenter/hardware/MSV2_ESP32_DisplayCenter/3D_Print/lower_arm_L.stl

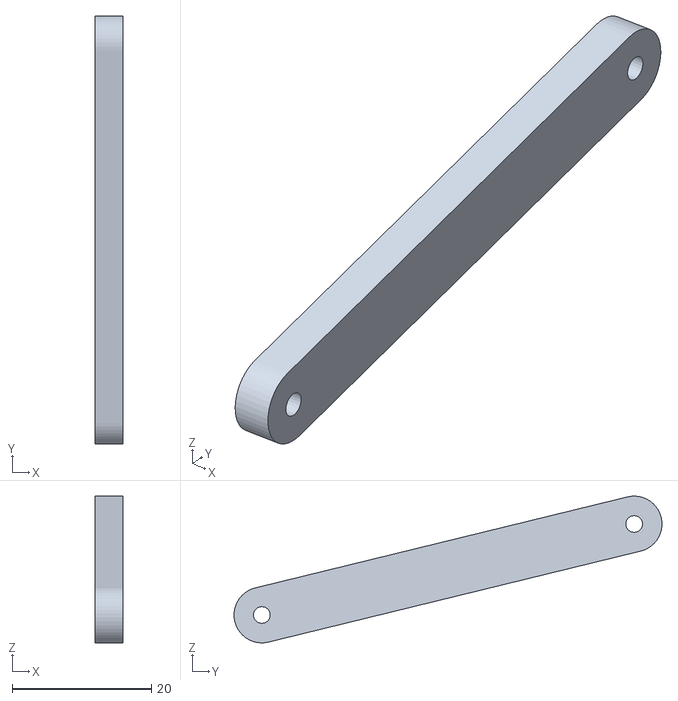
[picture p192: CAD file, 2026-08-29]
DisplayCenter/hardware/MSV2_ESP32_DisplayCenter/3D_Print/lower_arm_L.stl
4.00 x 61.4 x 21.1
