samam624/ProjectTreebeard/hardware/MSV2_ESP32_DisplayCenter/3D_Print/base_enclosure_bot.stl

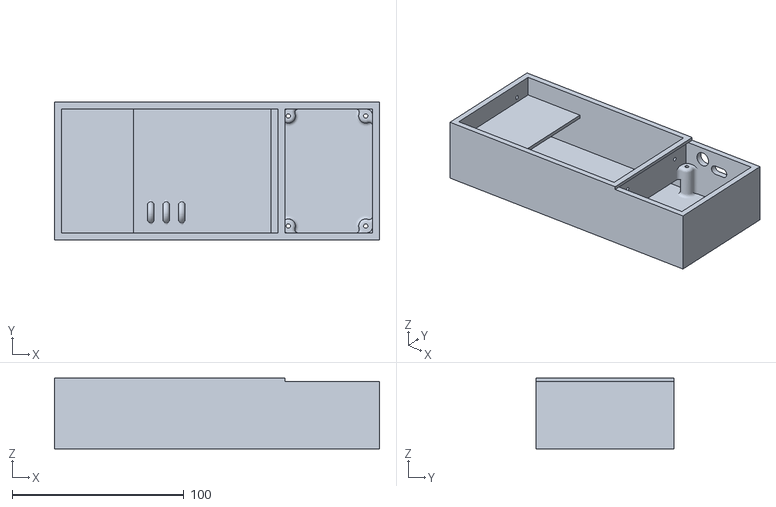
[picture p193: CAD file, 2026-07-28]
hardware/MSV2_ESP32_DisplayCenter/3D_Print/base_enclosure_bot.stl
189.0 x 80.0 x 41.2
