samam624/ProjectTreebeard/hardware/MSV2_ESP32_DisplayCenter/V2/output/MSV3_display_enclosure_exploded.step

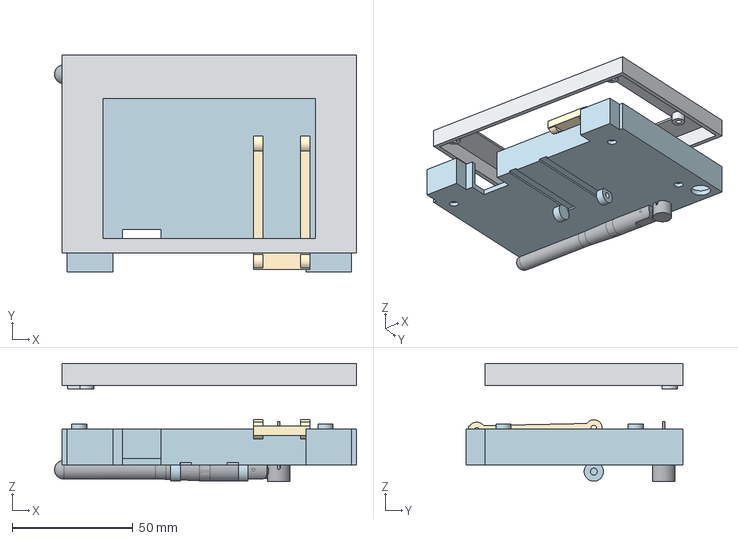
[picture p194: CAD file, 2026-08-20]
hardware/MSV2_ESP32_DisplayCenter/V2/output/MSV3_display_enclosure_exploded.step
125.2 x 90.0 x 49.1 mm
