samam624/ProjectTreebeard/MSV3/hardware/MSV3_Probe_PCB_Enclosure/output/m2_blended_side_closure/MSV3_brain_enclosure_case_closed_M2_blended_side.step

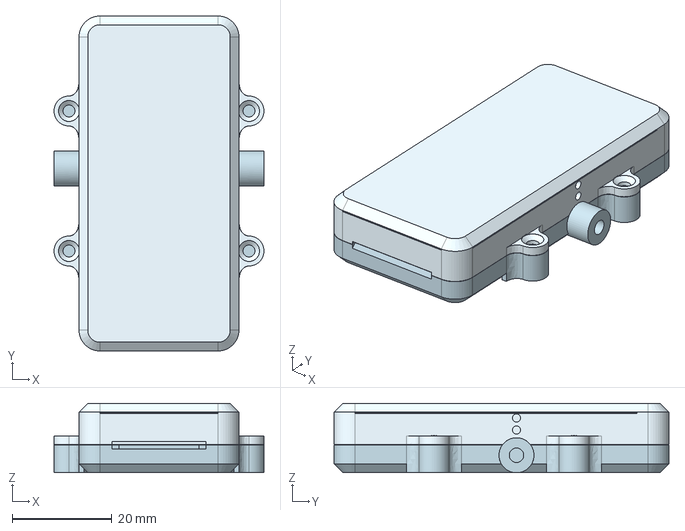
[picture p195: CAD file, 2026-11-14]
MSV3/hardware/MSV3_Probe_PCB_Enclosure/output/m2_blended_side_closure/MSV3_brain_enclosure_case_closed_M2_blended_side.step
42.0 x 67.0 x 13.9 mm
