samam624/ProjectTreebeard/MSV4/hardware/MSV4_Probe_Enclosures/output/MSV4_integrated_solar_PRINT.3mf

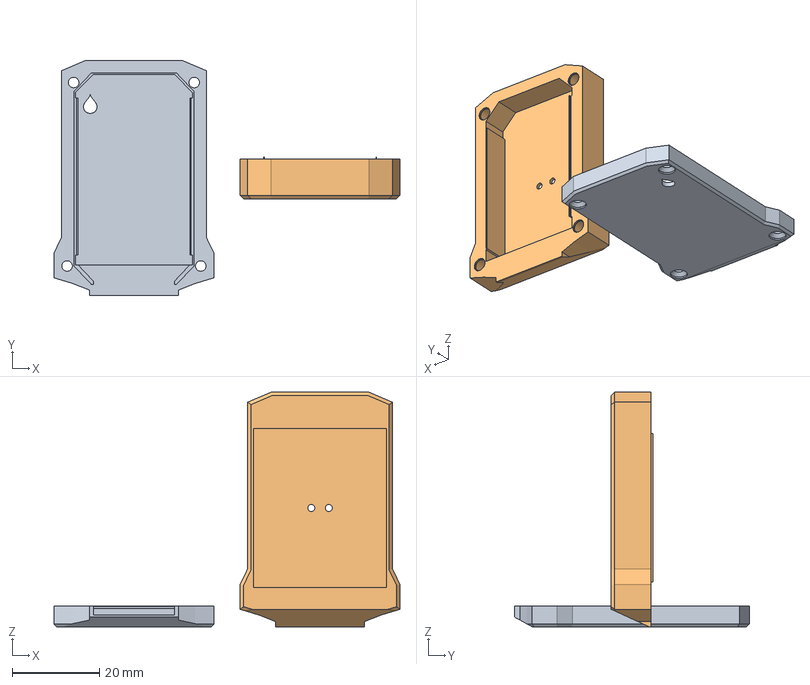
[picture p196: CAD file, 2026-10-09]
MSV4/hardware/MSV4_Probe_Enclosures/output/MSV4_integrated_solar_PRINT.3mf
79.2 x 53.7 x 53.7 mm
Base
Lid
