samam624/ProjectTreebeard/DisplayCenter/hardware/MSV2_ESP32_DisplayCenter/3D_Print/upper_arm.stl

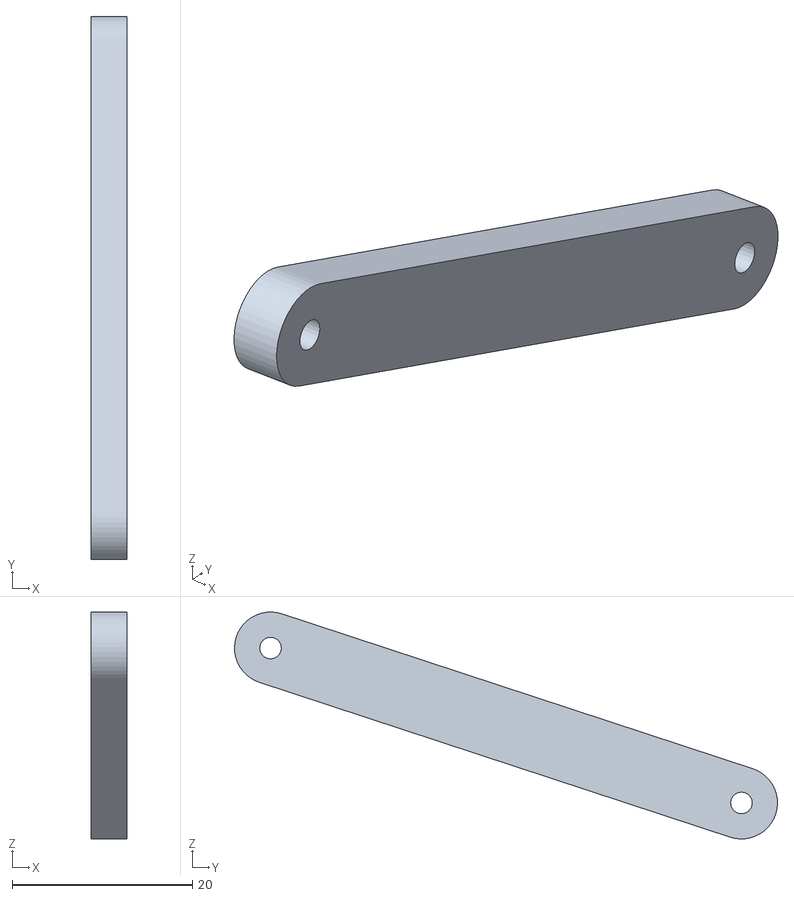
[picture p198: CAD file, 2026-08-29]
DisplayCenter/hardware/MSV2_ESP32_DisplayCenter/3D_Print/upper_arm.stl
4.00 x 60.2 x 25.2
