samam624/ProjectTreebeard/DisplayCenter/hardware/MSV2_ESP32_DisplayCenter/V2/output/MSV3_display_kickstand.step

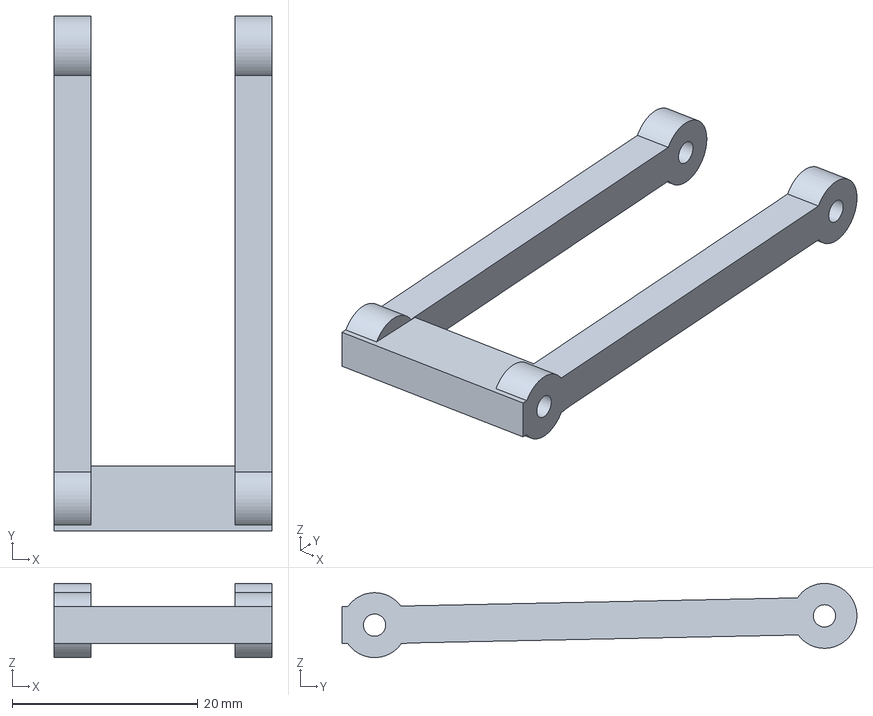
[picture p199: CAD file, 2026-09-25]
DisplayCenter/hardware/MSV2_ESP32_DisplayCenter/V2/output/MSV3_display_kickstand.step
23.5 x 55.5 x 8.00 mm
