samam624/ProjectTreebeard/MSV3/hardware/MSV3_Probe_PCB_Enclosure/output/MSV3_brain_enclosure_lid.step

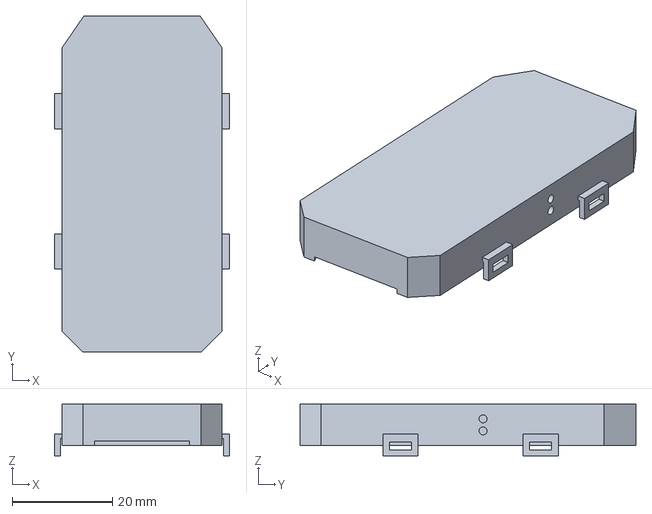
[picture p200: CAD file, 2026-11-14]
MSV3/hardware/MSV3_Probe_PCB_Enclosure/output/MSV3_brain_enclosure_lid.step
34.9 x 67.0 x 10.3 mm
