samam624/ProjectTreebeard/MSV4/hardware/MSV4_Probe_Enclosures/output/MSV4_solar_arm_left.step

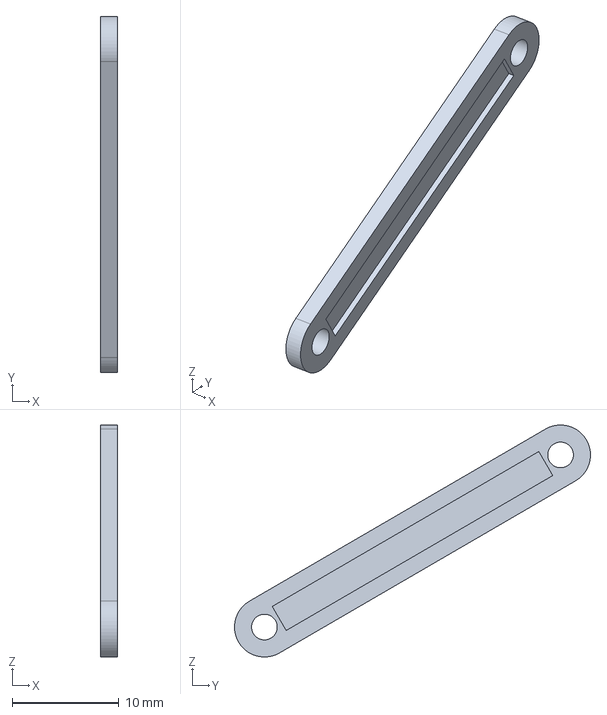
[picture p201: CAD file, 2026-10-01]
MSV4/hardware/MSV4_Probe_Enclosures/output/MSV4_solar_arm_left.step
1.60 x 33.3 x 21.7 mm
