samam624/ProjectTreebeard/DisplayCenter/hardware/MSV2_ESP32_DisplayCenter/3D_Print/MSV2_ESP32_DisplayCenter.step

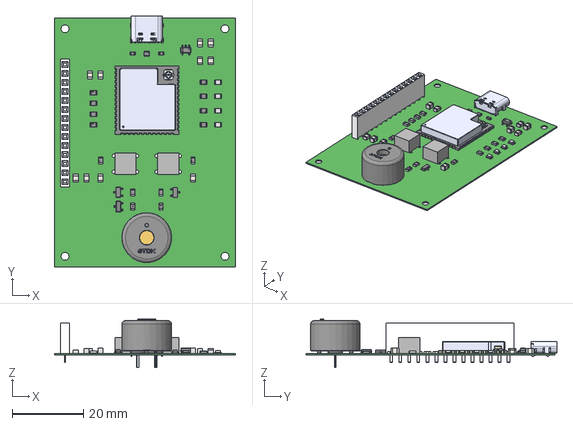
[picture p203: CAD file, 2026-08-29]
DisplayCenter/hardware/MSV2_ESP32_DisplayCenter/3D_Print/MSV2_ESP32_DisplayCenter.step
51.0 x 70.6 x 13.5 mm
