samam624/ProjectTreebeard/DisplayCenter/hardware/MSV2_ESP32_DisplayCenter/V2/output/MSV3_display_kickstand_print.stl

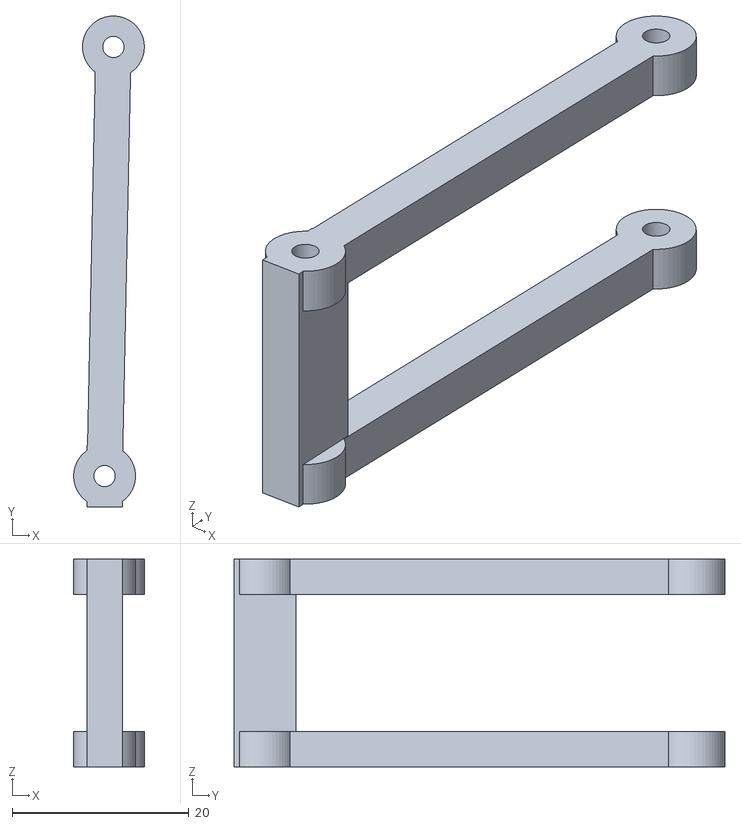
[picture p205: CAD file, 2026-08-29]
DisplayCenter/hardware/MSV2_ESP32_DisplayCenter/V2/output/MSV3_display_kickstand_print.stl
8.00 x 55.5 x 23.5
