samam624/ProjectTreebeard/MSV4/hardware/MSV4_Probe_Enclosures/output/MSV4_arm_solar_enclosure_fit_check.step

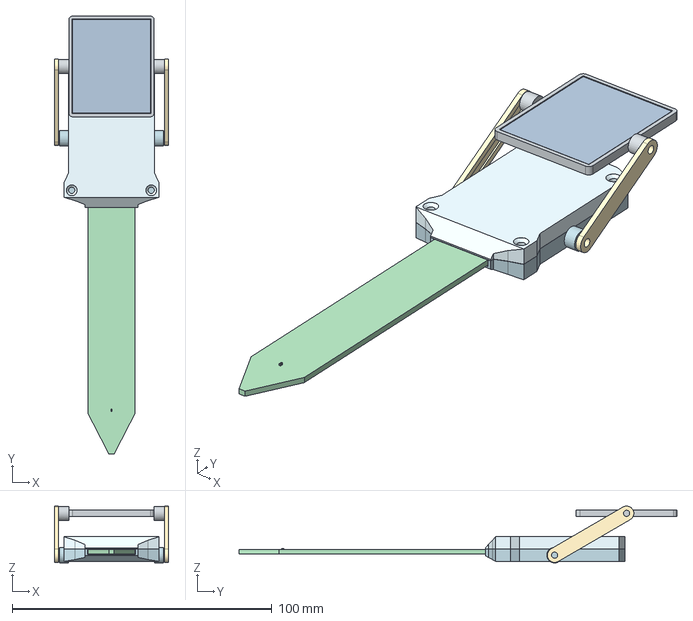
[picture p206: CAD file, 2026-10-01]
MSV4/hardware/MSV4_Probe_Enclosures/output/MSV4_arm_solar_enclosure_fit_check.step
44.0 x 168.6 x 21.9 mm
