samam624/ProjectTreebeard/MSV4/hardware/MSV4_Probe_Enclosures/output/reference/MSV4_minimum_profile_integrated_solar_fit_check.step

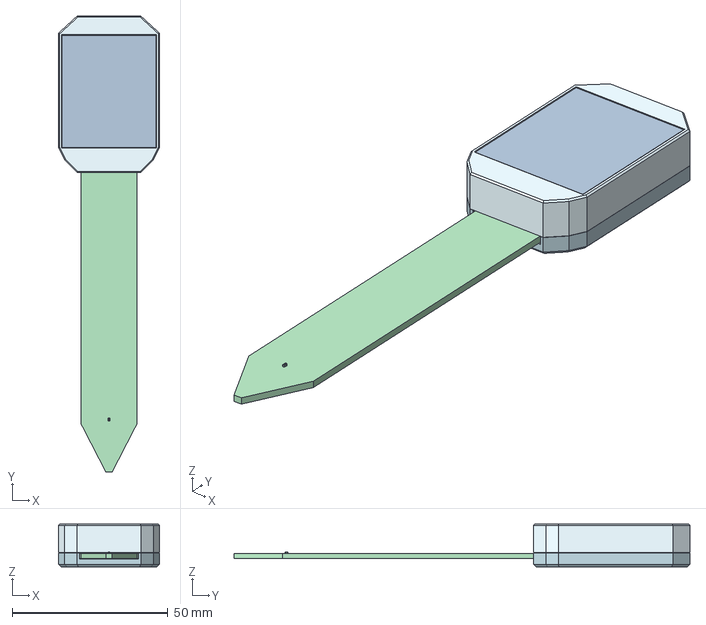
[picture p207: CAD file, 2026-11-03]
MSV4/hardware/MSV4_Probe_Enclosures/output/reference/MSV4_minimum_profile_integrated_solar_fit_check.step
32.4 x 146.2 x 13.7 mm
