samam624/ProjectTreebeard/DisplayCenter/hardware/MSV2_ESP32_DisplayCenter/V2/output/MSV3_display_pcb_alignment_check.step

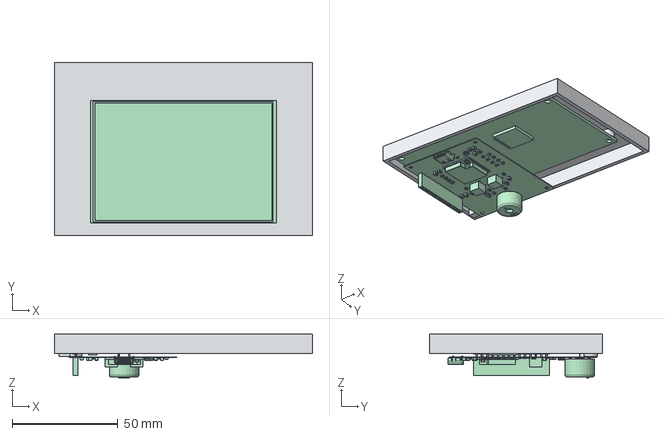
[picture p208: CAD file, 2026-08-29]
DisplayCenter/hardware/MSV2_ESP32_DisplayCenter/V2/output/MSV3_display_pcb_alignment_check.step
122.0 x 82.0 x 20.6 mm
