samam624/ProjectTreebeard/MSV4/hardware/MSV4_Probe_Enclosures/output/reference/MSV4_integrated_solar_base.step

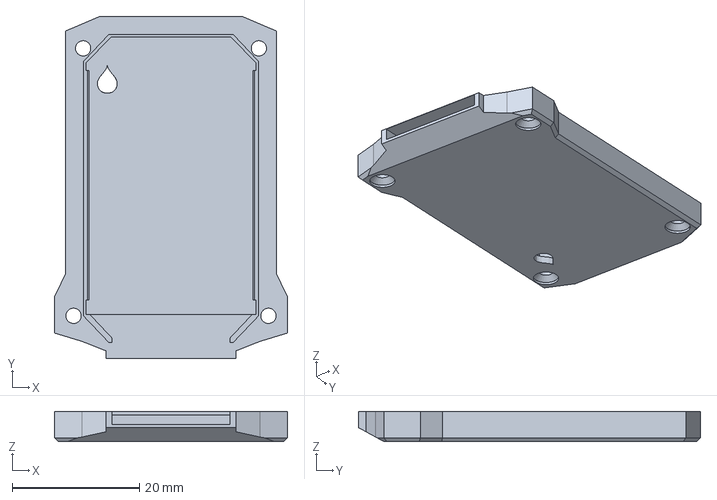
[picture p210: CAD file, 2026-10-09]
MSV4/hardware/MSV4_Probe_Enclosures/output/reference/MSV4_integrated_solar_base.step
36.6 x 53.7 x 4.75 mm
