samam624/ProjectTreebeard/DisplayCenter/hardware/MSV2_ESP32_DisplayCenter/V2/output/MSV3_display_antenna_positioned.step

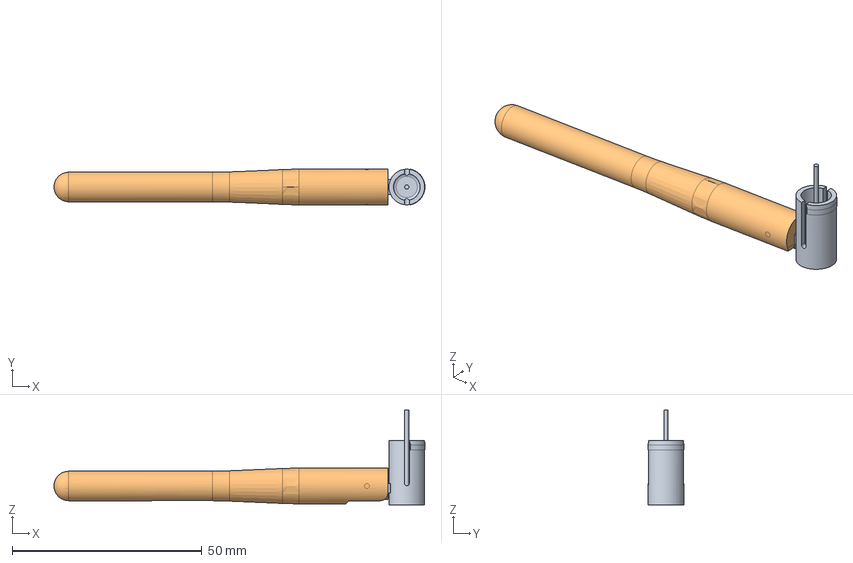
[picture p211: CAD file, 2026-08-29]
DisplayCenter/hardware/MSV2_ESP32_DisplayCenter/V2/output/MSV3_display_antenna_positioned.step
97.8 x 9.40 x 25.0 mm
