samam624/ProjectTreebeard/MSV4/hardware/MSV4_Probe_Enclosures/output/MSV4_case_gasket.step

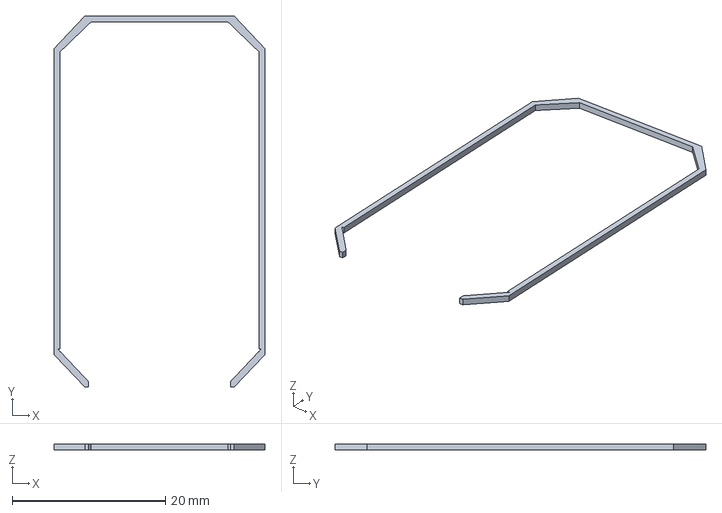
[picture p212: CAD file, 2026-10-01]
MSV4/hardware/MSV4_Probe_Enclosures/output/MSV4_case_gasket.step
27.5 x 48.4 x 0.8 mm
