samam624/ProjectTreebeard/MSV4/hardware/MSV4_Probe_Enclosures/output/MSV4_minimum_profile_integrated_solar_lid.step

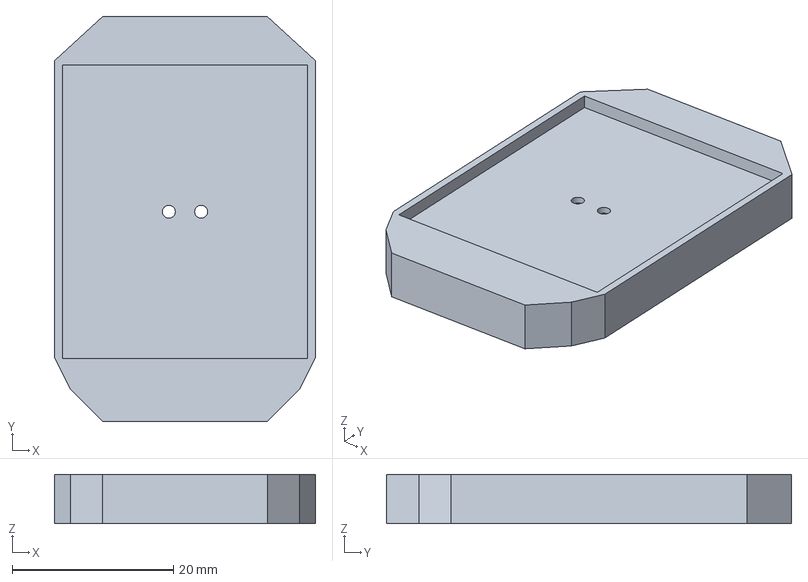
[picture p213: CAD file, 2026-10-01]
MSV4/hardware/MSV4_Probe_Enclosures/output/MSV4_minimum_profile_integrated_solar_lid.step
32.4 x 50.2 x 6.10 mm
