samam624/ProjectTreebeard/MSV4/hardware/MSV4_Probe_Enclosures/output/reference/MSV4_arm_solar_enclosure_fit_check.step

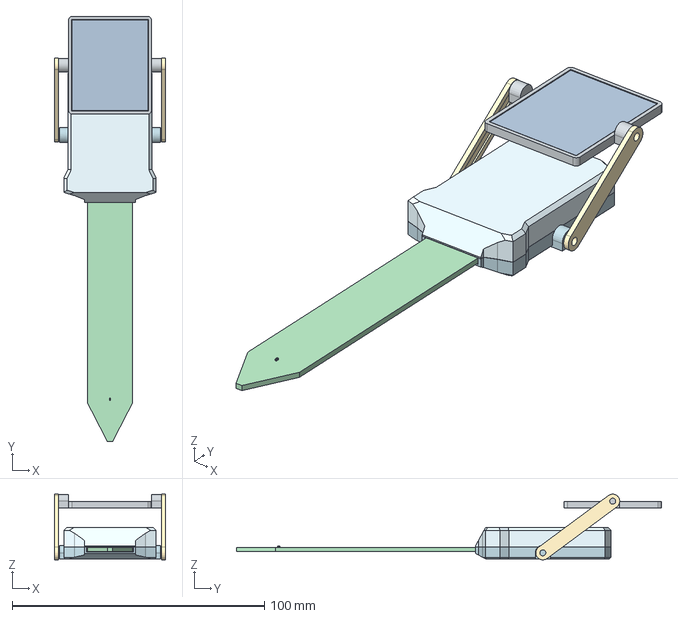
[picture p214: CAD file, 2026-10-09]
MSV4/hardware/MSV4_Probe_Enclosures/output/reference/MSV4_arm_solar_enclosure_fit_check.step
44.0 x 168.6 x 26.1 mm
