samam624/ProjectTreebeard/MSV4/hardware/MSV4_Probe_Enclosures/output/MSV4_integrated_solar_enclosure_fit_check.step

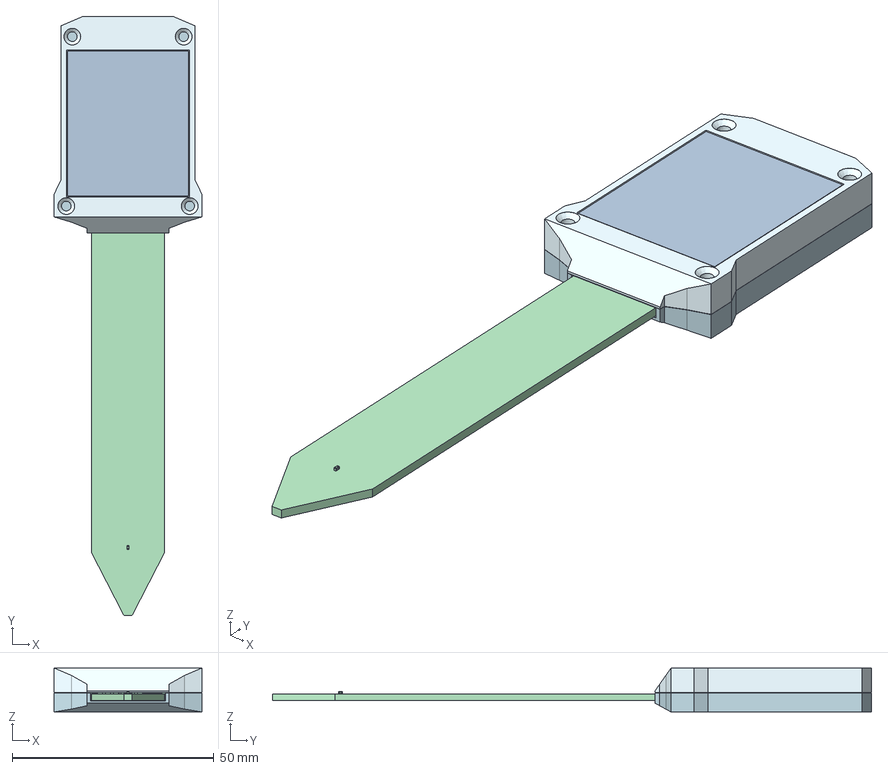
[picture p215: CAD file, 2026-10-01]
MSV4/hardware/MSV4_Probe_Enclosures/output/MSV4_integrated_solar_enclosure_fit_check.step
36.6 x 148.5 x 10.9 mm
