samam624/ProjectTreebeard/MSV4/hardware/MSV4_Probe_Enclosures/output/reference/MSV4_integrated_solar_lid.step

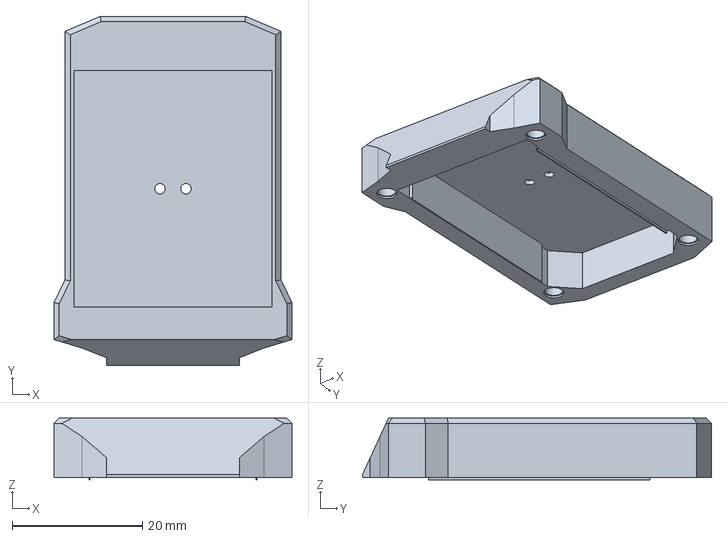
[picture p216: CAD file, 2026-10-09]
MSV4/hardware/MSV4_Probe_Enclosures/output/reference/MSV4_integrated_solar_lid.step
36.6 x 53.7 x 9.50 mm
