samam624/ProjectTreebeard/MSV4/hardware/MSV4_Probe_Enclosures/output/MSV4_arm_solar_lid.step

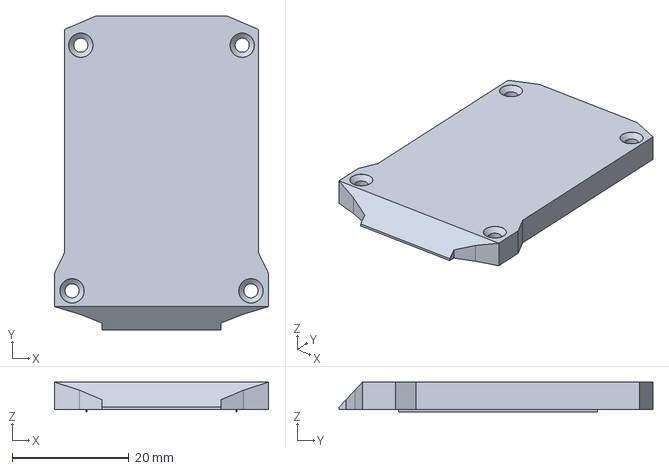
[picture p217: CAD file, 2026-10-01]
MSV4/hardware/MSV4_Probe_Enclosures/output/MSV4_arm_solar_lid.step
36.6 x 53.7 x 5.10 mm
