samam624/ProjectTreebeard/MSV4/hardware/MSV4_Probe_Enclosures/output/reference/MSV4_minimum_profile_integrated_solar_lid.step

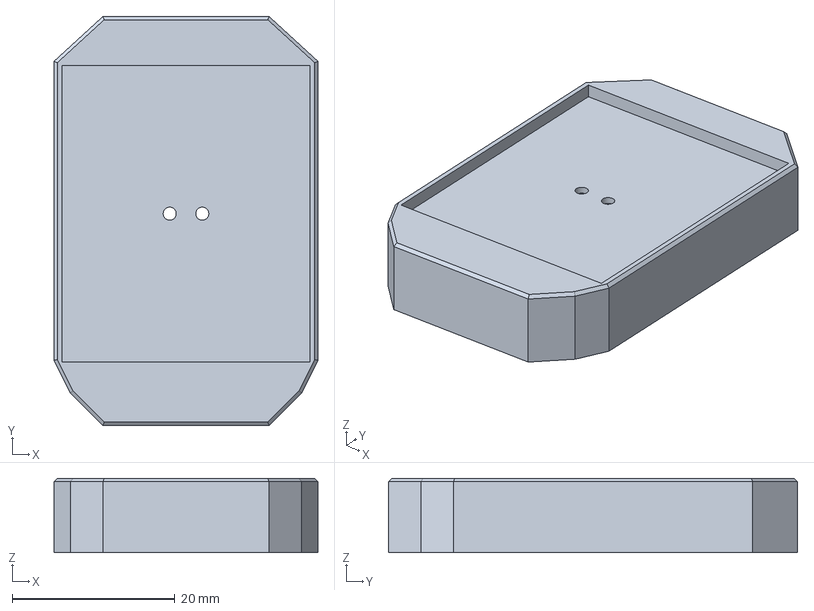
[picture p219: CAD file, 2026-10-09]
MSV4/hardware/MSV4_Probe_Enclosures/output/reference/MSV4_minimum_profile_integrated_solar_lid.step
32.4 x 50.2 x 9.10 mm
