samam624/ProjectTreebeard/MSV4/hardware/MSV4_Probe_Enclosures/output/MSV4_minimum_profile_integrated_solar_fit_check.step

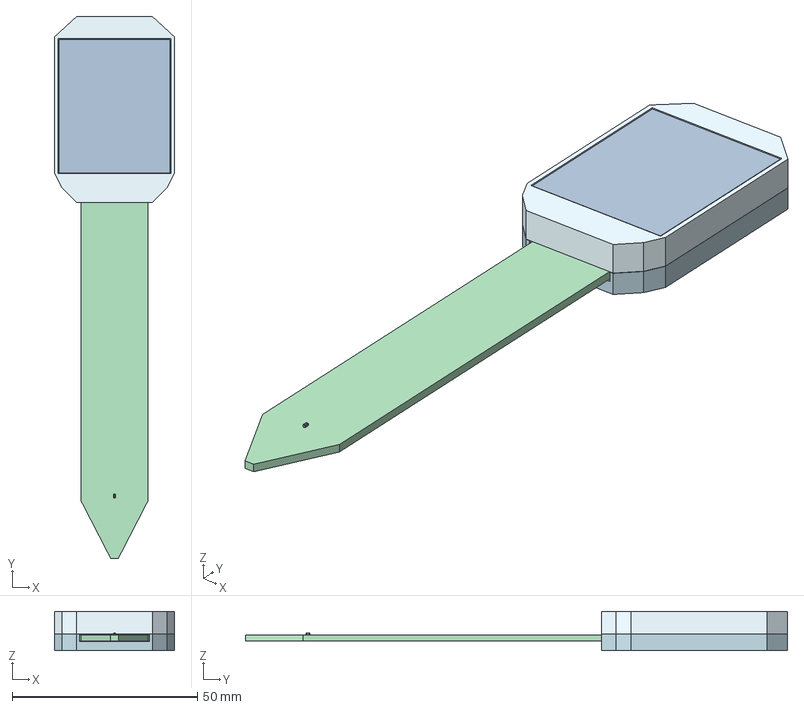
[picture p220: CAD file, 2026-10-01]
MSV4/hardware/MSV4_Probe_Enclosures/output/MSV4_minimum_profile_integrated_solar_fit_check.step
32.4 x 146.2 x 10.7 mm
