samam624/ProjectTreebeard/MSV4/hardware/MSV4_Probe_Enclosures/output/reference/MSV4_arm_solar_lid.step

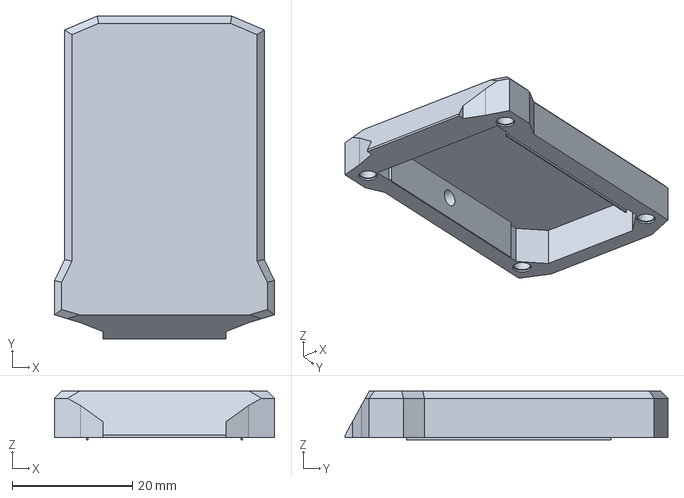
[picture p221: CAD file, 2026-10-09]
MSV4/hardware/MSV4_Probe_Enclosures/output/reference/MSV4_arm_solar_lid.step
36.6 x 53.7 x 8.10 mm
