samam624/ProjectTreebeard/MSV4/hardware/MSV4_Probe_Enclosures/output/MSV4_arm_solar_base.step

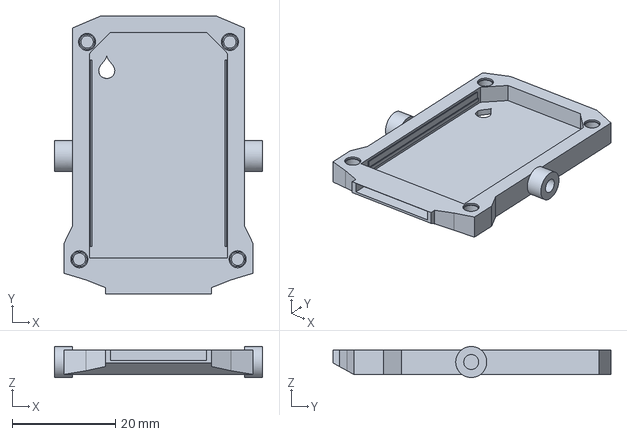
[picture p222: CAD file, 2026-10-01]
MSV4/hardware/MSV4_Probe_Enclosures/output/MSV4_arm_solar_base.step
40.2 x 53.7 x 5.99 mm
