samam624/ProjectTreebeard/MSV4/hardware/MSV4_Probe_Enclosures/output/reference/MSV4_integrated_solar_enclosure_fit_check.step

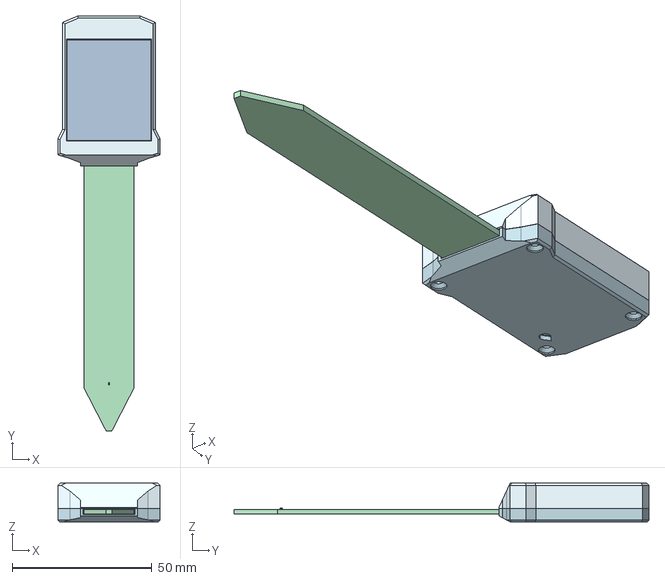
[picture p223: CAD file, 2026-10-09]
MSV4/hardware/MSV4_Probe_Enclosures/output/reference/MSV4_integrated_solar_enclosure_fit_check.step
36.6 x 148.5 x 13.9 mm
