samam624/ProjectTreebeard/MSV4/hardware/MSV4_Probe_Enclosures/output/MSV4_integrated_solar_lid_rear_edge_print.stl

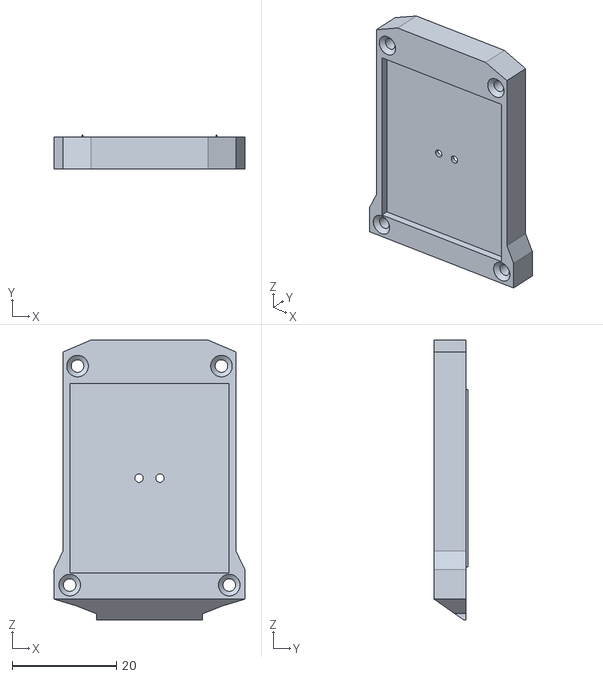
[picture p224: CAD file, 2026-10-01]
MSV4/hardware/MSV4_Probe_Enclosures/output/MSV4_integrated_solar_lid_rear_edge_print.stl
36.6 x 6.50 x 53.7
