samam624/ProjectTreebeard/MSV4/hardware/MSV4_Probe_Enclosures/output/reference/MSV4_arm_solar_base.step

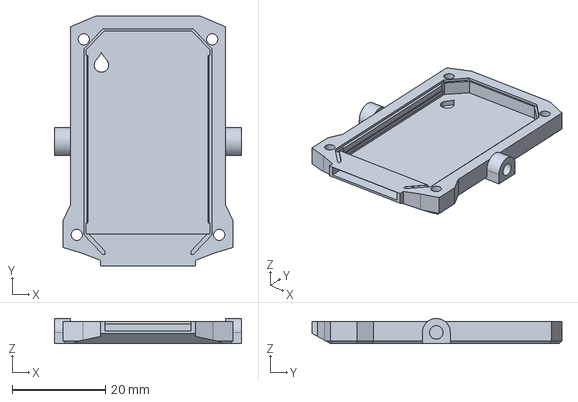
[picture p225: CAD file, 2026-10-09]
MSV4/hardware/MSV4_Probe_Enclosures/output/reference/MSV4_arm_solar_base.step
40.2 x 53.7 x 5.40 mm
