samam624/ProjectTreebeard/MSV4/hardware/MSV4_Probe_Enclosures/output/MSV4_integrated_solar_base_print.stl

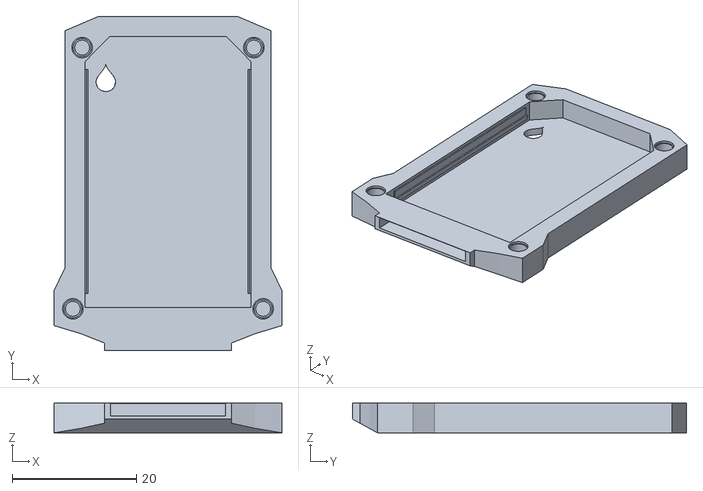
[picture p226: CAD file, 2026-09-25]
MSV4/hardware/MSV4_Probe_Enclosures/output/MSV4_integrated_solar_base_print.stl
36.6 x 53.7 x 4.75
