samam624/ProjectTreebeard/(list of files, cad)

Other CAD files:
DisplayCenter/hardware/MSV2_ESP32_DisplayCenter/V2/output/p1s_0p4_pla_v1/MSV3_display_front_cover_print.stl
MSV3/hardware/MSV3_Probe_PCB_Enclosure/3D Print/MSV3_enclosure_V1.gcode.3mf
DisplayCenter/hardware/MSV2_ESP32_DisplayCenter/3D_Print/P1S_MSV2_DisplayCenterEnclosure.gcode.3mf
DisplayCenter/hardware/MSV2_ESP32_DisplayCenter/V2/output/p1s_0p4_pla_v1/MSV2_DisplayCenter_P1S_0p4_PLA_rear_shell_v1.3mf
hardware/MSV2_ESP32_DisplayCenter/3D_Print/display_enclosure_bot_081326.stl
hardware/MSV2_ESP32_DisplayCenter/V2/design/reference_solids/front_screen_bezel.step
hardware/MSV2_ESP32_DisplayCenter/V2/output/MSV3_display_front_cover_print.stl
MSV3/hardware/MSV3_Probe_PCB_Enclosure/output/m2_blended_side_closure/MSV3_M2_BACK_VIEW_LEFT_OPPOSITE_USB_V6_slicer_pack/MSV3_solar_arm_USB_SIDE_SOLID_V6_print.stl
MSV3/hardware/MSV3_Probe_PCB_Enclosure/output/m2_blended_side_closure/MSV3_M2_blended_side_slicer_pack/MSV3_solar_panel_frame_M2_blended_side_print.stl
DisplayCenter/hardware/MSV2_ESP32_DisplayCenter/V2/output/MSV3_display_rear_shell_print.stl
MSV3/hardware/MSV3_Probe_PCB_Enclosure/output/m2_blended_side_closure/MSV3_M2_blended_side_slicer_pack/MSV3_brain_enclosure_base_M2_blended_side_inserts_print.stl
MSV3/hardware/MSV3_Probe_PCB_Enclosure/output/MSV3_solar_arm_left.step
MSV3/hardware/MSV3_Probe_PCB_Enclosure/output/MSV3_brain_enclosure_base.step
hardware/MSV2_ESP32_DisplayCenter/3D_Print/display_enclosure_bot.stl
MSV3/hardware/MSV3_Probe_PCB_Enclosure/output/m2_blended_side_closure/MSV3_brain_enclosure_lid_M2_blended_side_countersunk.step
MSV4/hardware/MSV4_Probe_Enclosures/output/reference/MSV4_minimum_profile_arm_solar_lid.step
hardware/MSV2_ESP32_DisplayCenter/3D_Print/MSV2_ESP32_DisplayCenter.gcode.3mf
MSV3/hardware/MSV3_Probe_PCB_Enclosure/output/m2_blended_side_closure/MSV3_brain_enclosure_base_M2_blended_side_inserts.step
MSV3/hardware/MSV3_Probe_PCB_Enclosure/output/MSV3_solar_arm_right_print.stl
MSV4/hardware/MSV4_Probe_Enclosures/output/MSV4_solar_panel_frame_print.stl
hardware/MSV2_ESP32_DisplayCenter/3D_Print/lower_arm_R.stl
MSV3/hardware/MSV3_Probe_PCB_Enclosure/output/m2_blended_side_closure/MSV3_solar_arm_right_M2_blended_side_print.stl
MSV3/hardware/MSV3_Probe_PCB_Enclosure/output/MSV3_solar_arm_left_print.stl
DisplayCenter/hardware/MSV2_ESP32_DisplayCenter/V2/output/MSV3_display_front_bezel_print.stl
MSV3/hardware/MSV3_Probe_PCB_Enclosure/output/m2_blended_side_closure/MSV3_solar_arm_left_M2_blended_side_print.stl
MSV4/hardware/MSV4_Probe_Enclosures/output/MSV4_minimum_profile_integrated_solar_base.step
MSV3/hardware/MSV3_Probe_PCB_Enclosure/output/MSV3_solar_arm_right.step
MSV3/hardware/MSV3_Probe_PCB_Enclosure/output/MSV3_brain_enclosure_lid_print.stl
MSV4/hardware/MSV4_Probe_Enclosures/output/reference/MSV4_solar_panel_frame.step
DisplayCenter/hardware/MSV2_ESP32_DisplayCenter/V2/output/MSV3_display_front_bezel_reference.step
MSV3/hardware/MSV3_Probe_PCB_Enclosure/output/MSV3_solar_panel_frame.step
MSV4/hardware/MSV4_Probe_Enclosures/output/reference/MSV4_solar_arm_right.step
MSV4/hardware/MSV4_Probe_Enclosures/output/reference/MSV4_solar_arm_left.step
MSV4/hardware/MSV4_Probe_Enclosures/output/reference/MSV4_case_gasket.step
MSV4/hardware/MSV4_Probe_Enclosures/output/MSV4_solar_panel_frame.step
MSV4/hardware/MSV4_Probe_Enclosures/output/MSV4_integrated_solar_lid.step
MSV4/hardware/MSV4_Probe_Enclosures/output/reference/MSV4_case_gasket_TPU_optional.3mf
MSV4/hardware/MSV4_Probe_Enclosures/output/MSV4_minimum_profile_integrated_solar_lid_rear_edge_print.stl
MSV4/hardware/MSV4_Probe_Enclosures/output/MSV4_arm_solar_base_print.stl
MSV4/hardware/MSV4_Probe_Enclosures/output/MSV4_case_gasket_TPU_print.stl
MSV4/hardware/MSV4_Probe_Enclosures/output/MSV4_solar_arm_left_print.stl
MSV4/hardware/MSV4_Probe_Enclosures/output/MSV4_minimum_profile_integrated_solar_base_print.stl
DisplayCenter/hardware/MSV2_ESP32_DisplayCenter/3D_Print/MSV2_ESP32_DisplayCenter.3mf
DisplayCenter/hardware/MSV2_ESP32_DisplayCenter/V2/design/reference_solids/previous_rear_shell.step
hardware/MSV2_ESP32_DisplayCenter/V2/design/reference_solids/previous_rear_cover.step
hardware/MSV3_Probe_PCB_Enclosure/3D Print/MSV3_brain_enclosure_assembly_MSV3_brain_enclosure_assembly_MSV3 Brain Enclosure Base_1_Body1.stl
hardware/MSV3_Probe_PCB_Enclosure/output/MSV3_brain_enclosure_base_print.stl
hardware/MSV3_Probe_PCB_Enclosure/output/MSV3_solar_arm_left_print.stl
hardware/MSV3_Probe_PCB_Enclosure/output/MSV3_solar_arm_right.step
hardware/MSV3_Probe_PCB_Enclosure/output/MSV3_solar_arm_right_print.stl
hardware/MSV3_Probe_PCB_Enclosure/output/m2_blended_side_closure/MSV3_brain_enclosure_assembly_M2_blended_side.step
hardware/MSV3_Probe_PCB_Enclosure/output/m2_blended_side_closure/MSV3_brain_enclosure_lid_M2_blended_side_countersunk_print.stl
hardware/MSV3_Probe_PCB_Enclosure/output/m2_blended_side_closure/MSV3_solar_arm_right_M2_blended_side_print.stl
