samam624/ProjectTreebeard/DisplayCenter/docs/DISPLAYCENTER_BUILD2_ASSEMBLY_GUIDE_2026-11-11.html

DisplayCenter controller PCB · BOM of 2026-07-14 · second build

# DisplayCenter, build two

One receiver board: count what's left, kit it in placement order, paste and reflow the SMD parts, hand-solder the four through-hole parts, then power, flash and check it against the receiver already running. Ticks, bench readings and notes save to this page.

One board · ESP32-S3-WROOM-1U

Connecting to this page's store…

0/0

Steps done

36

SMD parts · paste + reflow

4

Through-hole · by iron

1

DNP pad, C10

## Watch for

- Start the enclosure print before you solder. The two plates take about 6 h 54 min on the P1S. Stage 10 has the details.
- 22 Ω and 220 Ω both come four to a board, both 0805. R1 R2 R12 R15 are 22 Ω; R4 R5 R7 R11 are 220 Ω (the LED resistors). Keep the two strips apart and labelled.
- Q1 is the P-channel DMP3098L, in the same SOT-23 as the two 2N7002s at Q2/Q3. Place it from its own bag first.
- Four parts are the last one in stock after build one: the USB-C receptacle, USBLC6-2P6, DMP3098L and AP2112K (the LCSC order added 2 spare AP2112Ks). Drop one of the others and the build waits for an order.
- R3 and R6 are 0603 (5.1 kΩ, USB-C CC). Everything else passive is 0805.
- C10 stays empty (marked NC on the silkscreen, beside BOOT). TP1–TP8 are bare test pads.
- The receiver on COM16 is the live one. Find the new board's port before uploading, and never point the upload at COM16.
- Antenna on the U.FL before the firmware runs. The 1U module has no antenna of its own, and the firmware starts BLE and Wi-Fi at boot.

## Bench notes

Anything odd: rework, a swapped part, the new receiver ID, a reading you want to come back to.

Bench notes

DisplayCenter/hardware/MSV2_ESP32_DisplayCenter/pcb/DisplayCenter_controller_fabrication_2026-07-14.zip (BOM .csv) pcb/images/DisplayCenter_pcb_layout.png · DisplayCenter_schematic_overview.png MSV4/procurement/MSV4_pull_from_MSV3_stock_5boards_2026-09-19.md (DigiKey leftovers) · MSV4_LCSC_order_5boards_2026-09-19.csv DisplayCenter/docs/ESP32_DISPLAY_FLASHING.md · DisplayCenter/README.md V2/output/p1s_0p4_pla_v1/PRINT_IN_BAMBU_STUDIO.md
