samam624/ProjectTreebeard/MSV4/docs/MSV4_BOARD_BUILD_CHECKLIST_2026-09-30.html

MSV4 probe PCB · final netlist 2026-09-18 · 5 boards on hand

# Build one board, bring it up, then the rest

Kit, place, reflow, power, flash and bring up one MSV4 board before committing parts to the other four. Ticks, bench readings and notes save to this page per board, and readings outside the expected range are flagged.

Board 1 2 3 4 5

Connecting to this page's store…

1

Board

0/0

Steps done

50

Parts / board

1

DNP pad, leave empty

## Watch for

- The pad labelled DNP stays empty. It is the 100 nF on VBAT_DIV; firmware reads the divider 2 ms after switching it on and assumes no cap.
- C10 must be the C0G 10 nF (Murata, MSV3 stock). It holds the MPPT reference, so leakage becomes charging error.
- Nine MΩ values sit next to each other on the BQ25504 ladders. Pull them in labelled strips.
- D1 is the MSV3 stock LED, not the footprint's part. Check its cathode mark before placing.
- Bench power needs an SP input, at 3.0 V or less. A cell alone never starts the BQ25504.
- SWD only through swd_flash_hex.py, which waits for 3 s of steady contact. No bare serial commands to the flasher.

## Bench notes

Anything odd: rework, a swapped part, a reading you want to come back to. Saved per board.

Bench notes

MSV4/hardware/reference/netlist/MSV4_sch_2026-09-18_final.NET COMPONENT_INDEX.md · PIN_NET_REFERENCE.md MSV4/docs/MSV4_BLE_BRINGUP_FIRMWARE_2026-09-18.md · MSV4_LAB_UI.md MSV4/procurement/MSV4_pull_from_MSV3_stock_5boards_2026-09-19.md
