samam624/ProjectTreebeard/DisplayCenter/hardware/MSV2_ESP32_DisplayCenter/V2/design/renders/pcb_assembly_reference_top.png

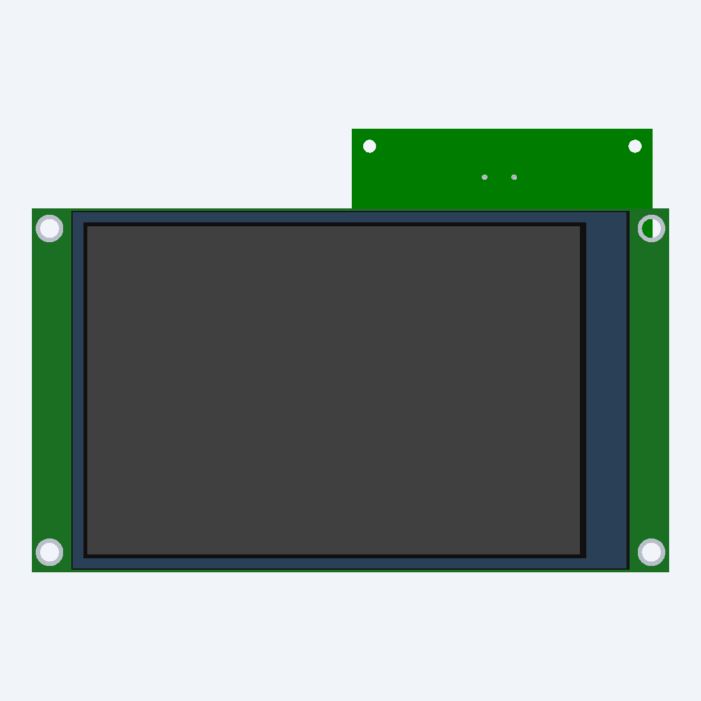
DisplayCenter/hardware/MSV2_ESP32_DisplayCenter/V2/design/renders/pcb_assembly_reference_top.png
