samam624/ProjectTreebeard/hardware/MSV2_ESP32_DisplayCenter/V2/design/renders/pcb_assembly_reference_isometric.png

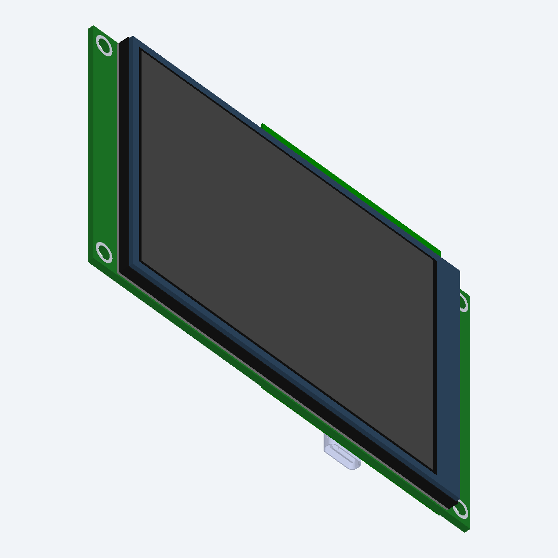
hardware/MSV2_ESP32_DisplayCenter/V2/design/renders/pcb_assembly_reference_isometric.png
