samam624/ProjectTreebeard/hardware/MSV3_Probe_PCB_Enclosure/renders/assembly_folded_v7_top.png

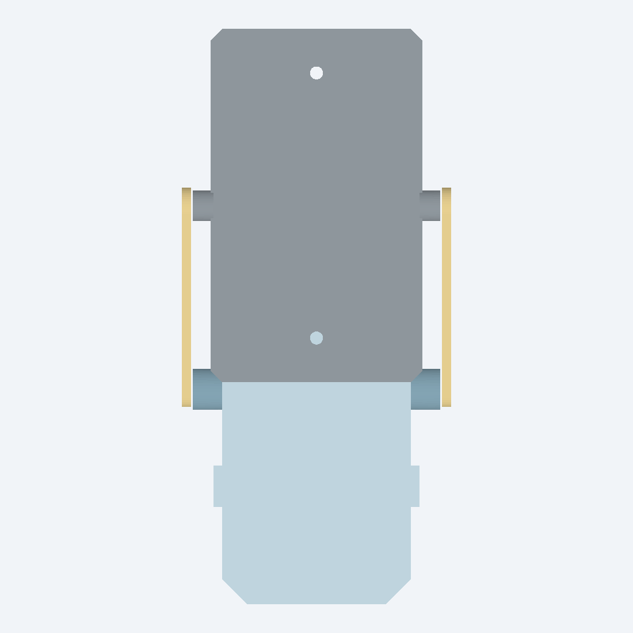
hardware/MSV3_Probe_PCB_Enclosure/renders/assembly_folded_v7_top.png
