samam624/ProjectTreebeard/hardware/MSV3_Probe_PCB_Enclosure/renders/assembly_solar_isometric.png

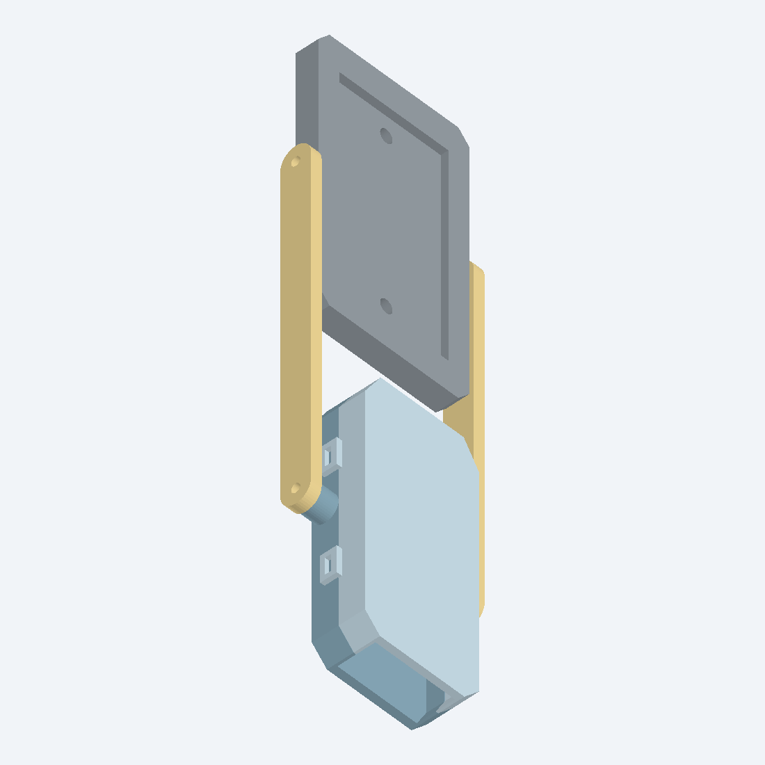
hardware/MSV3_Probe_PCB_Enclosure/renders/assembly_solar_isometric.png
