samam624/ProjectTreebeard/MSV3/hardware/MSV3_Probe_PCB_Enclosure/renders/assembly_folded_v7_isometric.png

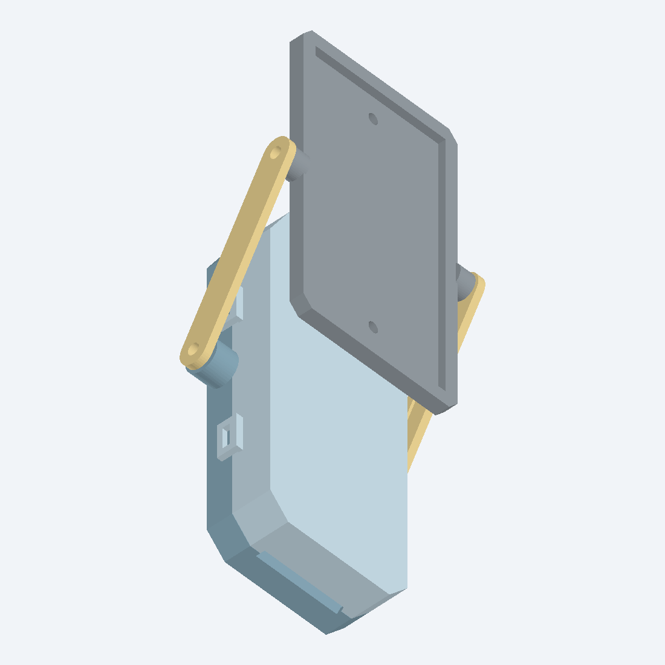
MSV3/hardware/MSV3_Probe_PCB_Enclosure/renders/assembly_folded_v7_isometric.png
