samam624/ProjectTreebeard/MSV4/generated/spectrum_fit_validation_2026-09-23.txt

MSV4 spectrum-fit validation against the 2D field solve -- 2026-09-23
Generated by: python MSV4/scripts/test_msv4_spectrum_fit.py field

Truth is the distributed 2D field solve (msv4_electrode_fieldsolve.py), not the lumped model,
so it carries the model error that makes Cs unidentifiable. Both fits see identical data.
dRsoil is each fit measured against its OWN baseline row.

Decision it supports: drop Cs, ship the 3-parameter fit. See the firmware comment block in
MSV4_Probe_Bringup_BLE.ino and the identifiability proof in test_msv4_spectrum_fit.py.

=== stage 2: truth generated from the 2D field solve (distributed physics) ===

baseline  (er 15, 0.020)
  4-param (current)      Rsoil    347.1 ohm  Cm   679.4 pF  Cs  20.91 pF  Cd 41.25 pF  rms 9.53e-03
  3-param (Cs=0)         Rsoil    368.8 ohm  Cm   659.2 pF  Cs   0.00 pF  Cd 61.53 pF  rms 9.53e-03

er +10%   (er 16.5)     
  4-param (current)      Rsoil    359.7 ohm  Cm   667.7 pF  Cs  10.32 pF  Cd 53.10 pF  rms 9.47e-03   dRsoil  +3.61%
  3-param (Cs=0)         Rsoil    370.9 ohm  Cm   657.5 pF  Cs   0.00 pF  Cd 63.27 pF  rms 9.47e-03   dRsoil  +0.55%

sigma +10% (0.022)      
  4-param (current)      Rsoil    318.3 ohm  Cm   684.9 pF  Cs  24.75 pF  Cd 40.71 pF  rms 8.53e-03   dRsoil  -8.32%
  3-param (Cs=0)         Rsoil    341.7 ohm  Cm   661.0 pF  Cs   0.00 pF  Cd 64.60 pF  rms 8.53e-03   dRsoil  -7.36%

5 um air gap            
  4-param (current)      Rsoil    318.2 ohm  Cm   386.4 pF  Cs  60.73 pF  Cd  0.00 pF  rms 4.80e-03   dRsoil  -8.34%
  3-param (Cs=0)         Rsoil    426.1 ohm  Cm   333.9 pF  Cs   0.00 pF  Cd 52.48 pF  rms 4.80e-03   dRsoil +15.51%

  Read the dRsoil column: Rsoil MUST move with sigma and MUST NOT move with er.
  Cm must collapse on the gap row. Whichever fit does that is the one to ship.
