samam624/ProjectTreebeard/MSV3/docs/MSV3_FOUR_BOARD_SWD_BRINGUP_2026-08-28.md

# MSV3 Four-Board SWD Bring-Up + EC-Check Analog Fix (2026-08-28)

> **2026-08-30 source warning:** The field production sketch was corrected to wait on
> `STATUS.CH0_UNREADCONV` after a temporary global-DRDY implementation stopped advertisements.
> The currently modified `MSV3_Probe_Bringup_Test.ino` still calls `fdcWaitForDrdy()` without
> explicitly enabling `ERROR_CONFIG.DRDY_2INT`. Reconcile it with the production readiness logic
> before treating its FDC read/stream/wake commands as authoritative. This warning concerns the
> current working-tree edit, not the 2026-08-28 binaries used for the four-board results below.

## Summary

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

## Four-board SWD + USB bring-up results

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

## `scripts/swd_flash_hex.py` — `--bootloader` one-shot mode

```powershell
python scripts/swd_flash_hex.py --port COM3 --bootloader
```

> **Superseded 2026-09-06.** Bare `--bootloader` is now an error. It defaulted to the STOCK
> Adafruit image, which on an MSV3 fleet probe would replace a signed bootloader and its
> anti-rollback floor with one that has neither. The 2026-08-28 run below was correct at the
> time — these were fresh boards being brought up on the stock loader. Today write either
> `--msv3 <version>` or `--bootloader --stock-bootloader`.

```powershell
```

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

Full detail: `docs/SWD_FLASHER.md`.

## EC-check (`DIV_NODE`/`VDIV`) analog fix

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

`arduino/MSV3_Probe_Bringup_Test/MSV3_Probe_Bringup_Test.ino` changes:

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

## Per-board hardware findings

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

## Testing methodology note

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

## Open items

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
