samam624/ProjectTreebeard/MSV3/docs/idrive-tuning-2026-09-03/fdcstream_raw.csv

idrive_code | sample_index | data_ch0 | status
16 | 0 | 20012933 | 0x8
16 | 1 | 20012891 | 0x8
16 | 2 | 20013378 | 0x8
16 | 3 | 20013416 | 0x8
16 | 4 | 20013256 | 0x8
16 | 5 | 20013327 | 0x8
16 | 6 | 20013445 | 0x8
16 | 7 | 20013359 | 0x8
16 | 8 | 20013298 | 0x8
16 | 9 | 20013455 | 0x8
16 | 10 | 20013397 | 0x8
16 | 11 | 20013682 | 0x8
16 | 12 | 20013279 | 0x8
16 | 13 | 20013416 | 0x8
16 | 14 | 20013199 | 0x8
16 | 15 | 20013084 | 0x8
16 | 16 | 20012971 | 0x8
16 | 17 | 20013023 | 0x8
16 | 18 | 20013294 | 0x8
16 | 19 | 20013416 | 0x8
16 | 20 | 20013307 | 0x8
16 | 21 | 20013071 | 0x8
16 | 22 | 20013019 | 0x8
16 | 23 | 20013042 | 0x8
16 | 24 | 20013237 | 0x8
16 | 25 | 20013009 | 0x8
16 | 26 | 20013241 | 0x8
16 | 27 | 20013317 | 0x8
16 | 28 | 20013269 | 0x8
16 | 29 | 20013227 | 0x8
16 | 30 | 20013189 | 0x8
16 | 31 | 20013227 | 0x8
16 | 32 | 20013074 | 0x8
16 | 33 | 20013241 | 0x8
16 | 34 | 20013084 | 0x8
16 | 35 | 20013269 | 0x8
16 | 36 | 20013327 | 0x8
16 | 37 | 20013260 | 0x8
16 | 38 | 20013596 | 0x8
16 | 39 | 20013426 | 0x8
16 | 40 | 20013625 | 0x8
16 | 41 | 20013644 | 0x8
16 | 42 | 20013928 | 0x8
16 | 43 | 20013563 | 0x8
16 | 44 | 20013829 | 0x8
16 | 45 | 20013455 | 0x8
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
