samam624/ProjectTreebeard/data/sensor_logs/msv4_moisture_validation.png

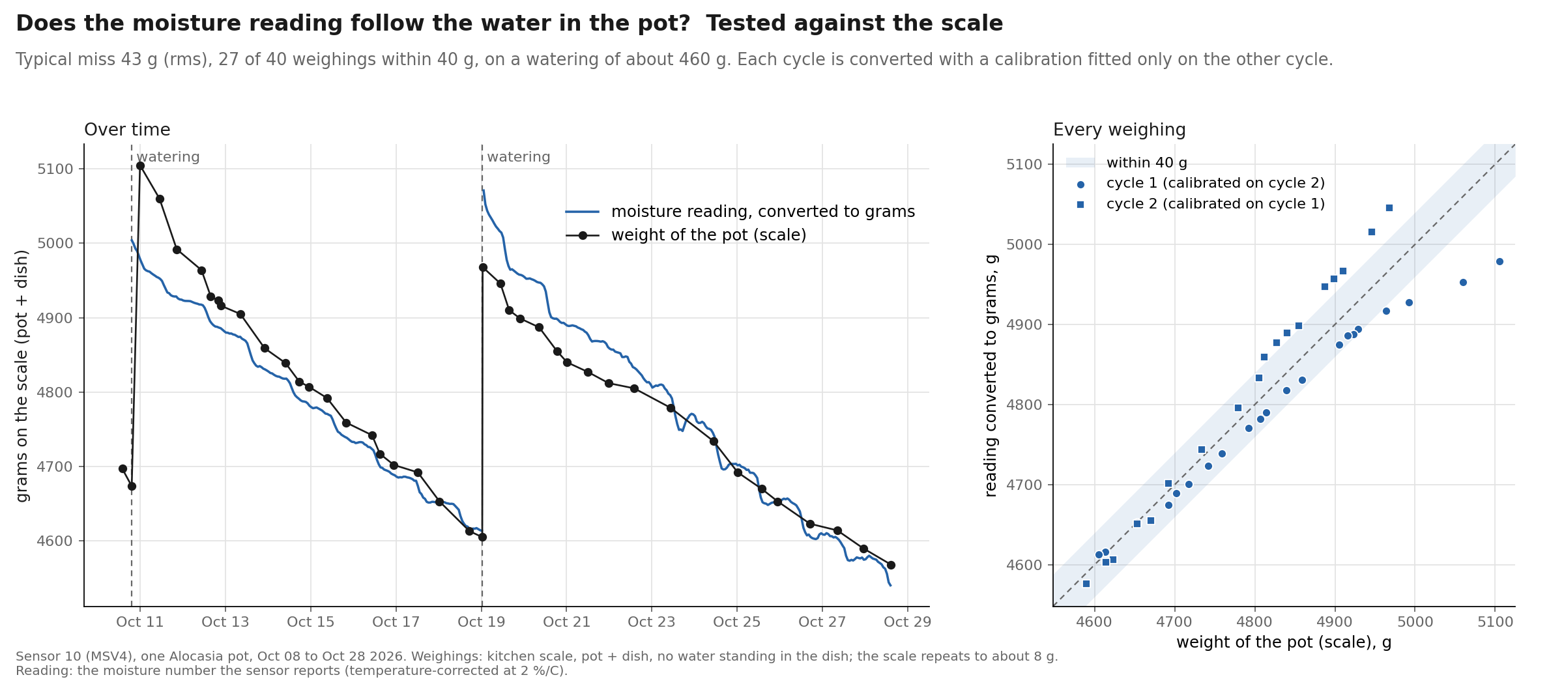
data/sensor_logs/msv4_moisture_validation.png
