samam624/ProjectTreebeard/MSV4/docs/ELECTRODE_CROSS_SECTIONS_2026-09-30.pdf

/2 = 2.71 mm

## v1.2 ground | driven | ground, single-sided

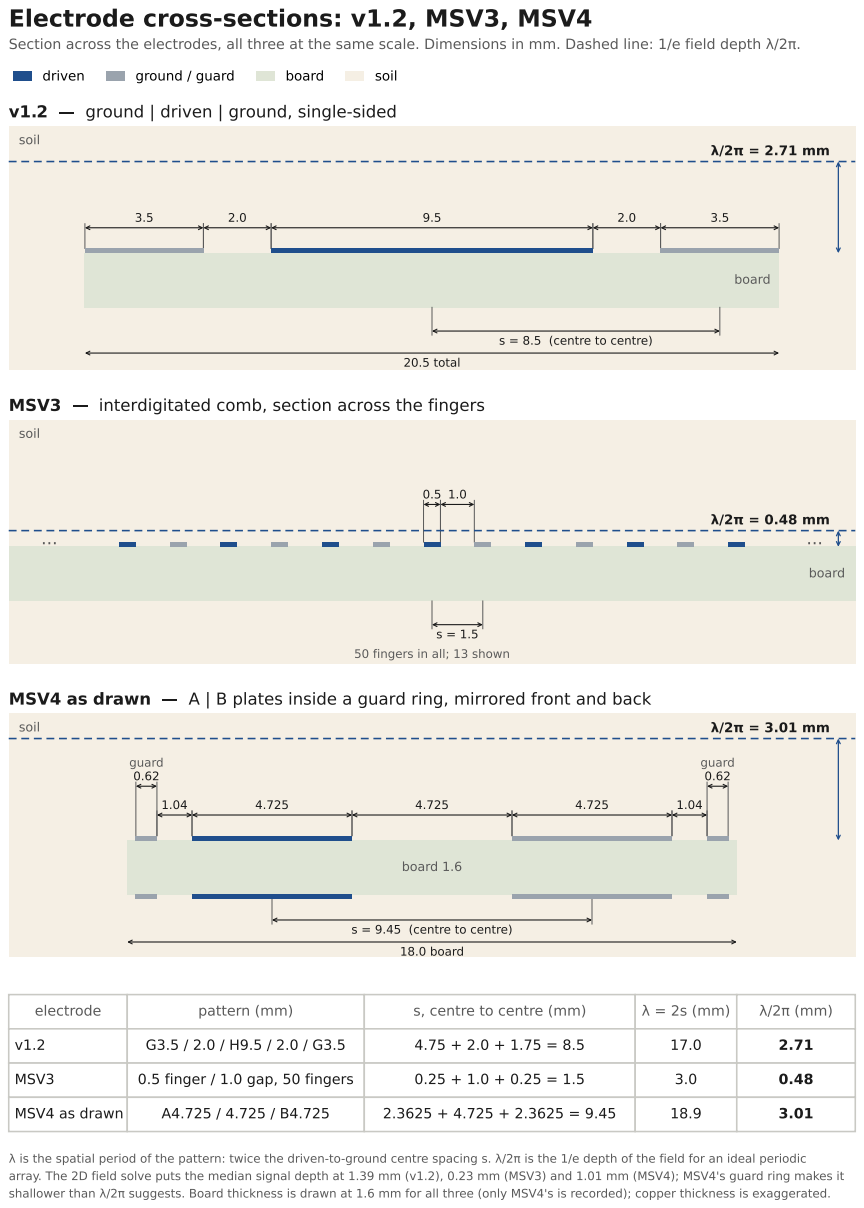
[picture p240: page 1]
soil; board; 20.5 total; MSV3; interdigitated comb, section across the fingers; board 1.6; guard; 18.0 board; MSV4 as drawn; A | B plates inside a guard ring, mirrored front and back; electrode; pattern (mm); s, centre to centre (mm); 0.5 finger / 1.0 gap, 50 fingers; driven; ground / guard

Electrode cross-sections: v1.2, MSV3, MSV4

Section across the electrodes, all three at the same scale. Dimensions in mm. Dashed line: 1/e field depth /2 .

s = 8.5 (centre to centre)

50 fingers in all; 13 shown

s = 9.45 (centre to centre)

is the spatial period of the pattern: twice the driven-to-ground centre spacing s. /2 is the 1/e depth of the field for an ideal periodic
array. The 2D field solve puts the median signal depth at 1.39 mm (v1.2), 0.23 mm (MSV3) and 1.01 mm (MSV4); MSV4's guard ring makes it
shallower than /2 suggests. Board thickness is drawn at 1.6 mm for all three (only MSV4's is recorded); copper thickness is exaggerated.
