samam624/ProjectTreebeard/MSV3/hardware/MSV3_Probe_PCB/MSV3_schematic_export_2026-07-26.pdf

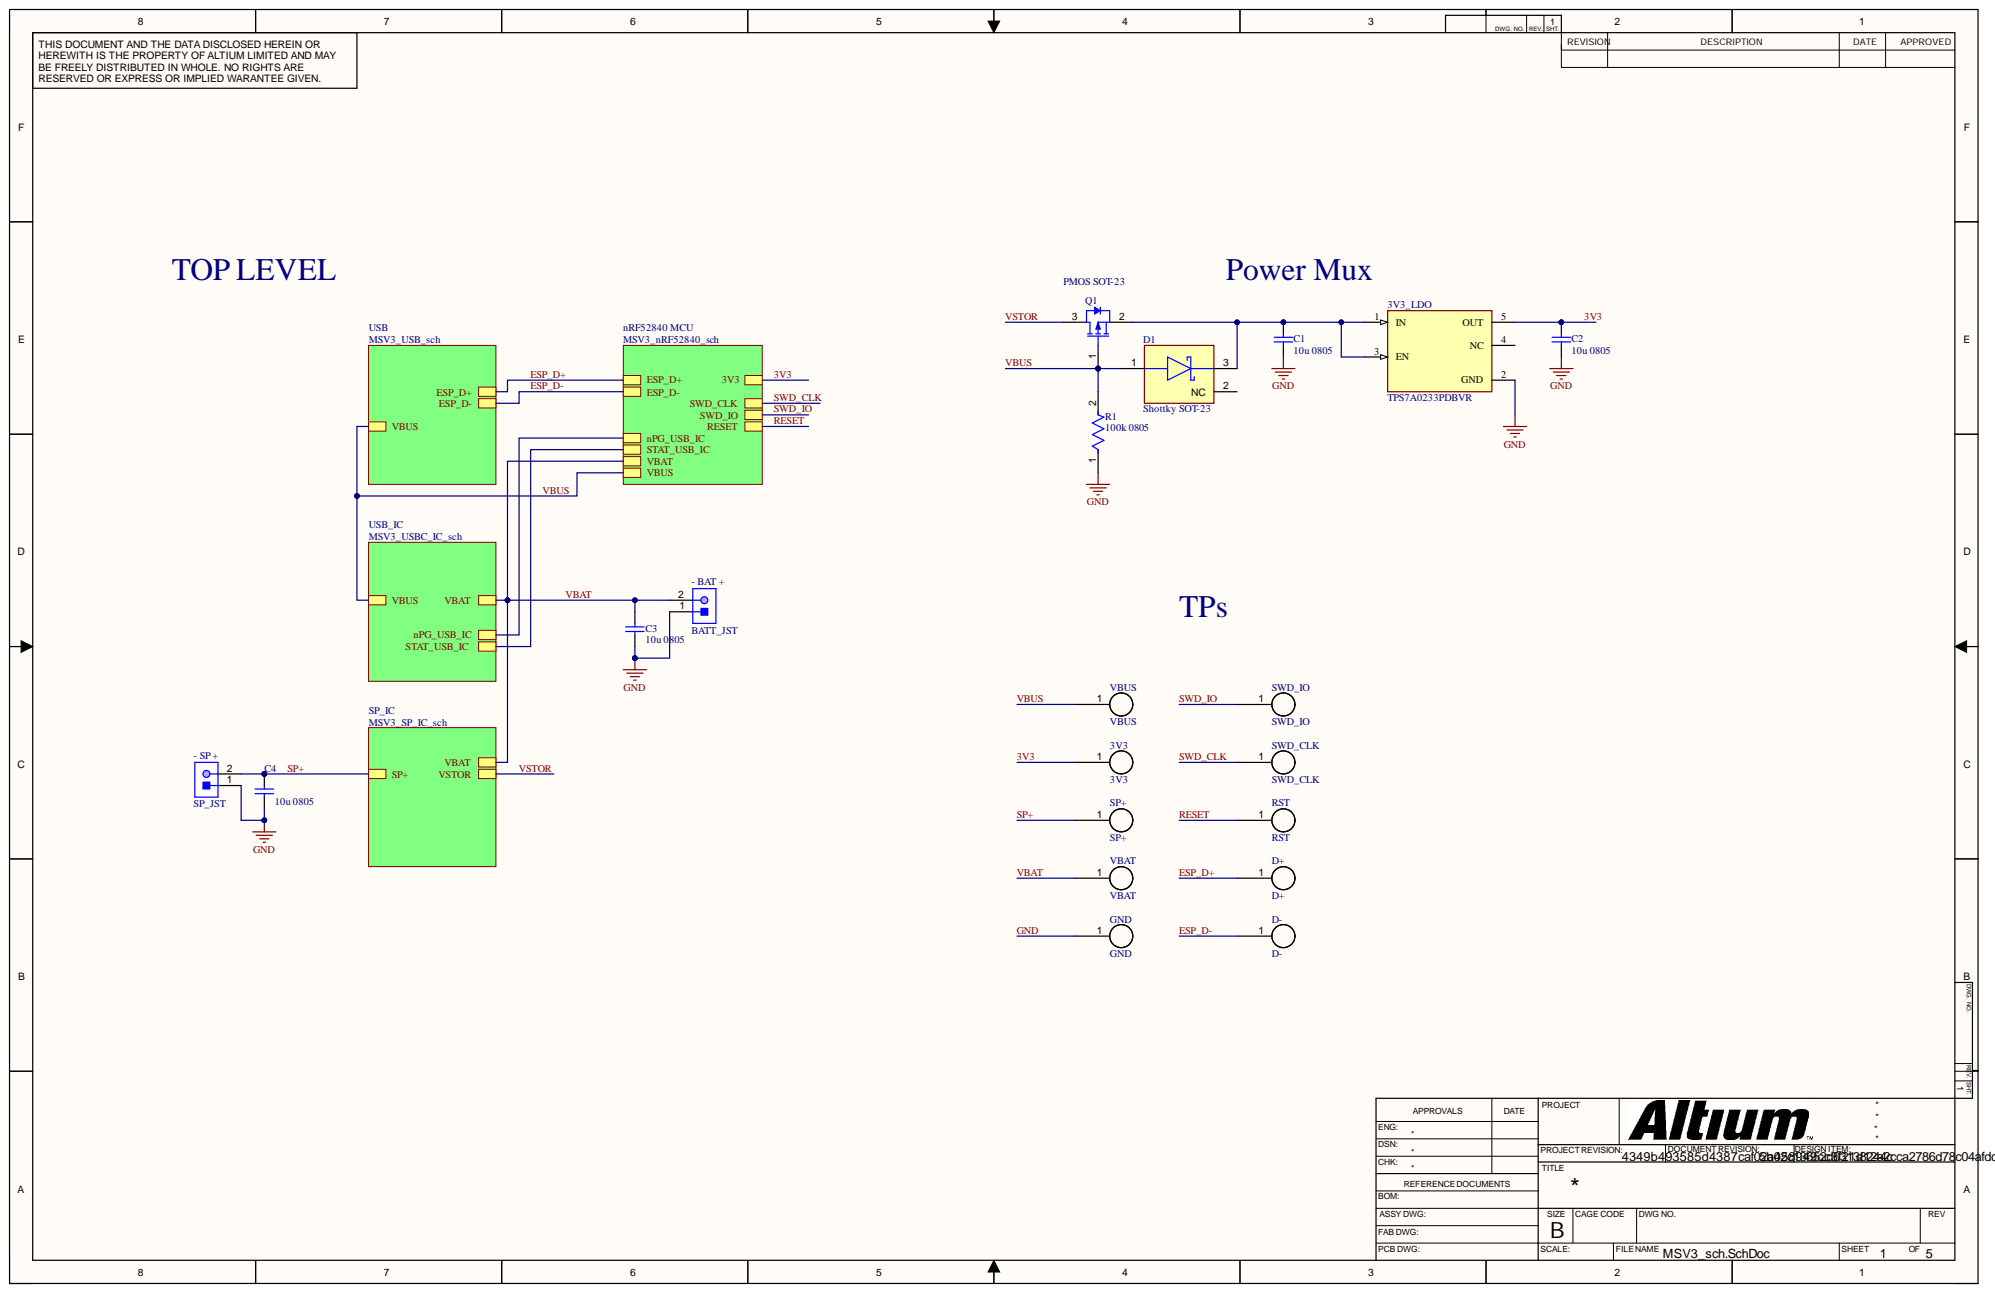
[picture p241: page 1]

8 | 7 | 6 | 5 | 4 | 3 | DWG. NO. | REV. | 1 SHT. | 2 | 1

THIS DOCUMENT AND THE DATA DISCLOSED HEREIN OR HEREWITH IS THE PROPERTY OF ALTIUM LIMITED AND MAY BE FREELY DISTRIBUTED IN WHOLE. NO RIGHTS ARE RESERVED OR EXPRESS OR IMPLIED WARANTEE GIVEN. | Power Mux PMOS SOT-23 Q1 3V3_LDO | REVISION | DESCRIPTION | DATE | APPROVED

VBUS

USB_IC MSV3_USBC_IC_sch | VBAT

REV. SHT. DWG. NO.

DATE | PROJECT | * * APPROVALS * *

ENG: *
CHK: * | | TITLE *

DSN: * | | PROJECT REVISION: | DOCUMENT REVISION: | DESIGN ITEM:

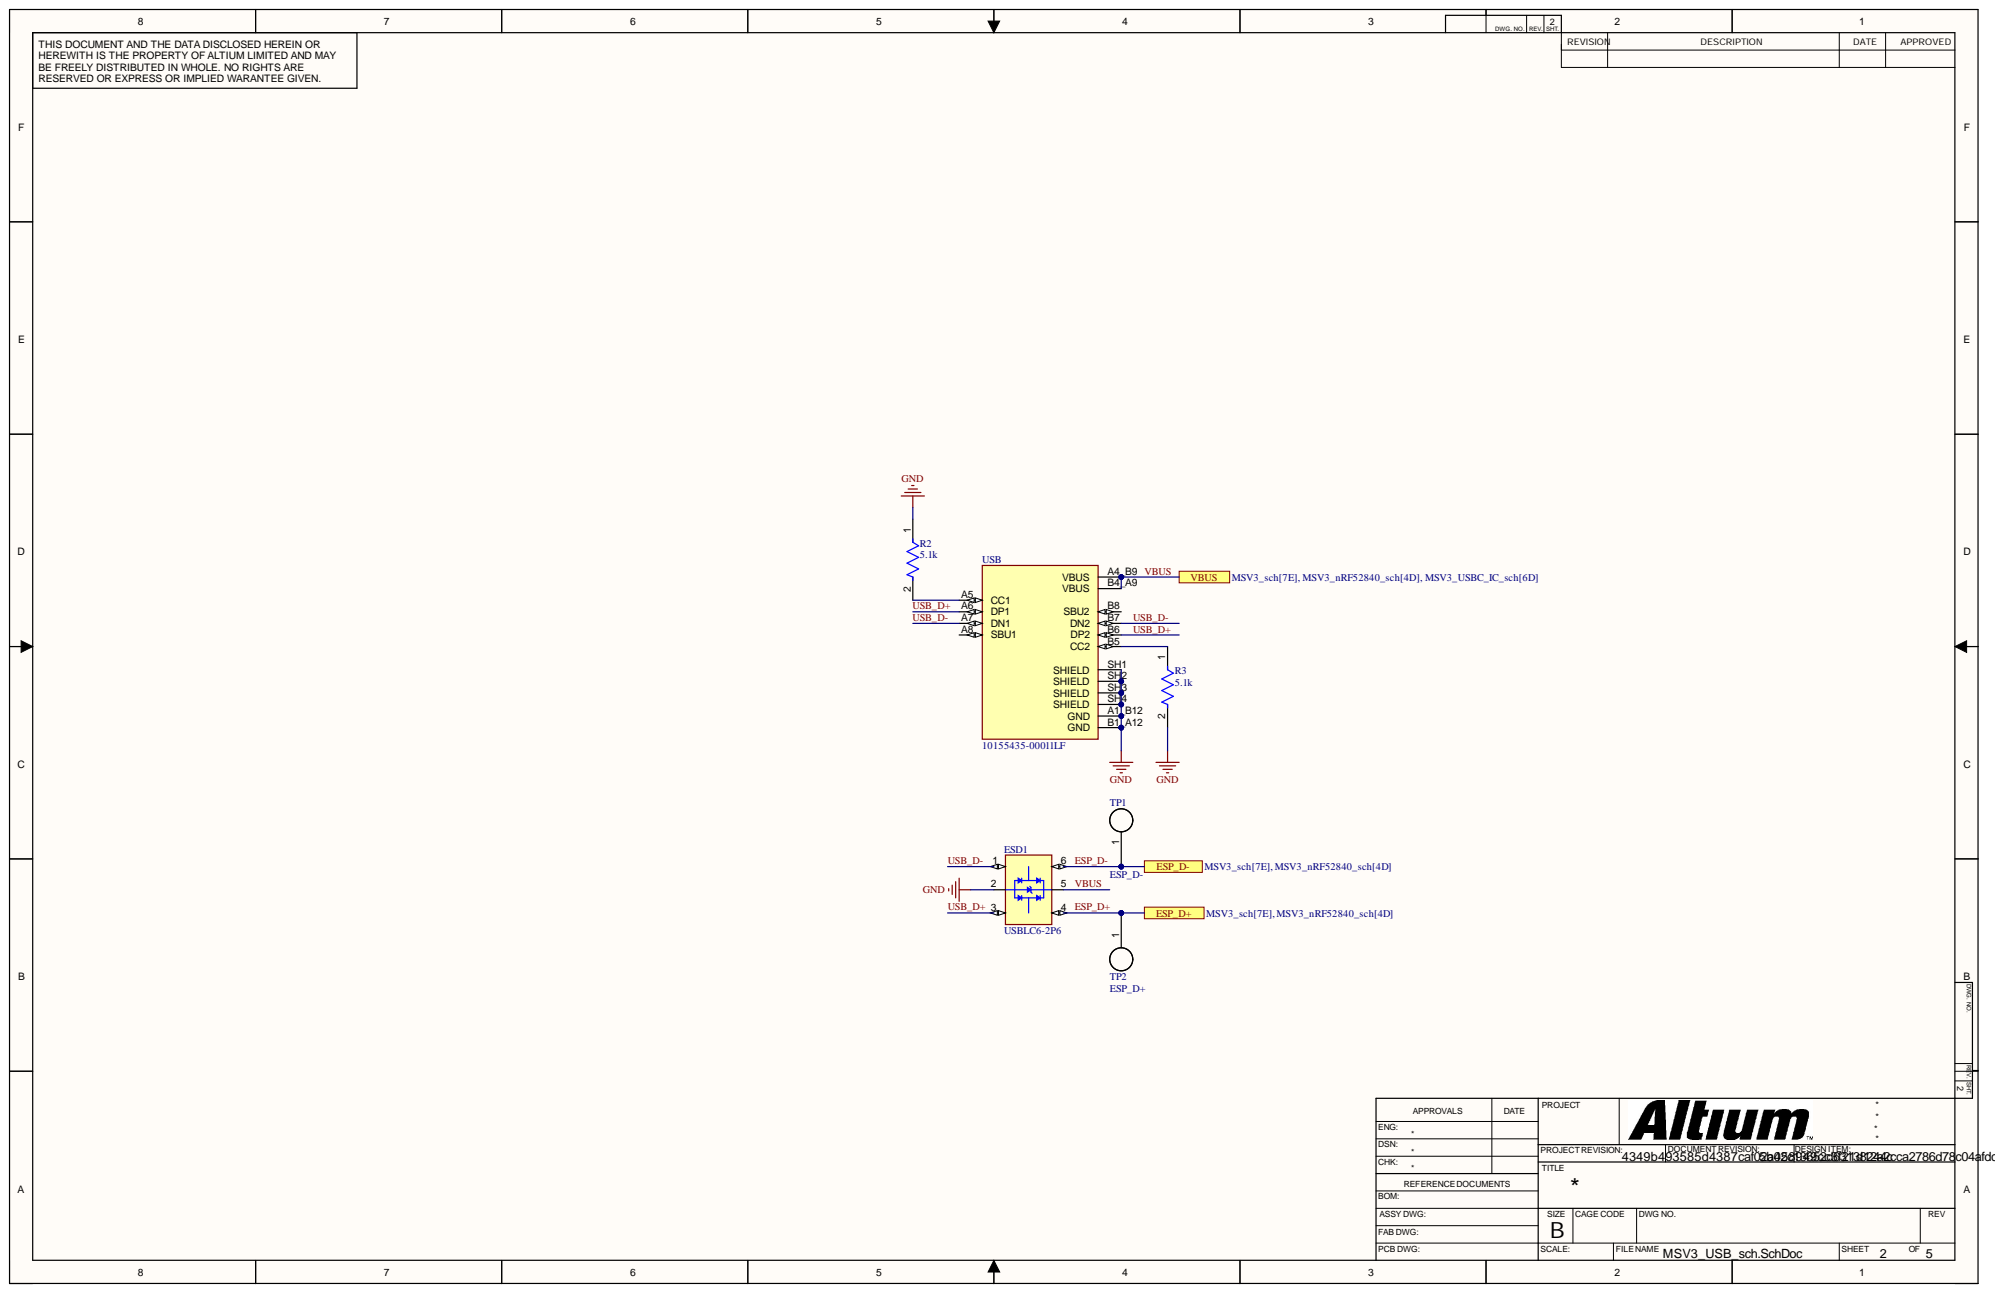
[picture p242: page 2]

8 | 7 | 6 | 5 | 4 | 3 | DWG. NO. | REV. | 2 SHT. | 2 | 1

THIS DOCUMENT AND THE DATA DISCLOSED HEREIN OR HEREWITH IS THE PROPERTY OF ALTIUM LIMITED AND MAY BE FREELY DISTRIBUTED IN WHOLE. NO RIGHTS ARE RESERVED OR EXPRESS OR IMPLIED WARANTEE GIVEN. | | REVISION | DESCRIPTION | DATE | APPROVED

REV. SHT. DWG. NO.

DATE | PROJECT | * * APPROVALS * *

ENG: *
CHK: * | | TITLE *

DSN: * | | PROJECT REVISION: | DOCUMENT REVISION: | DESIGN ITEM:

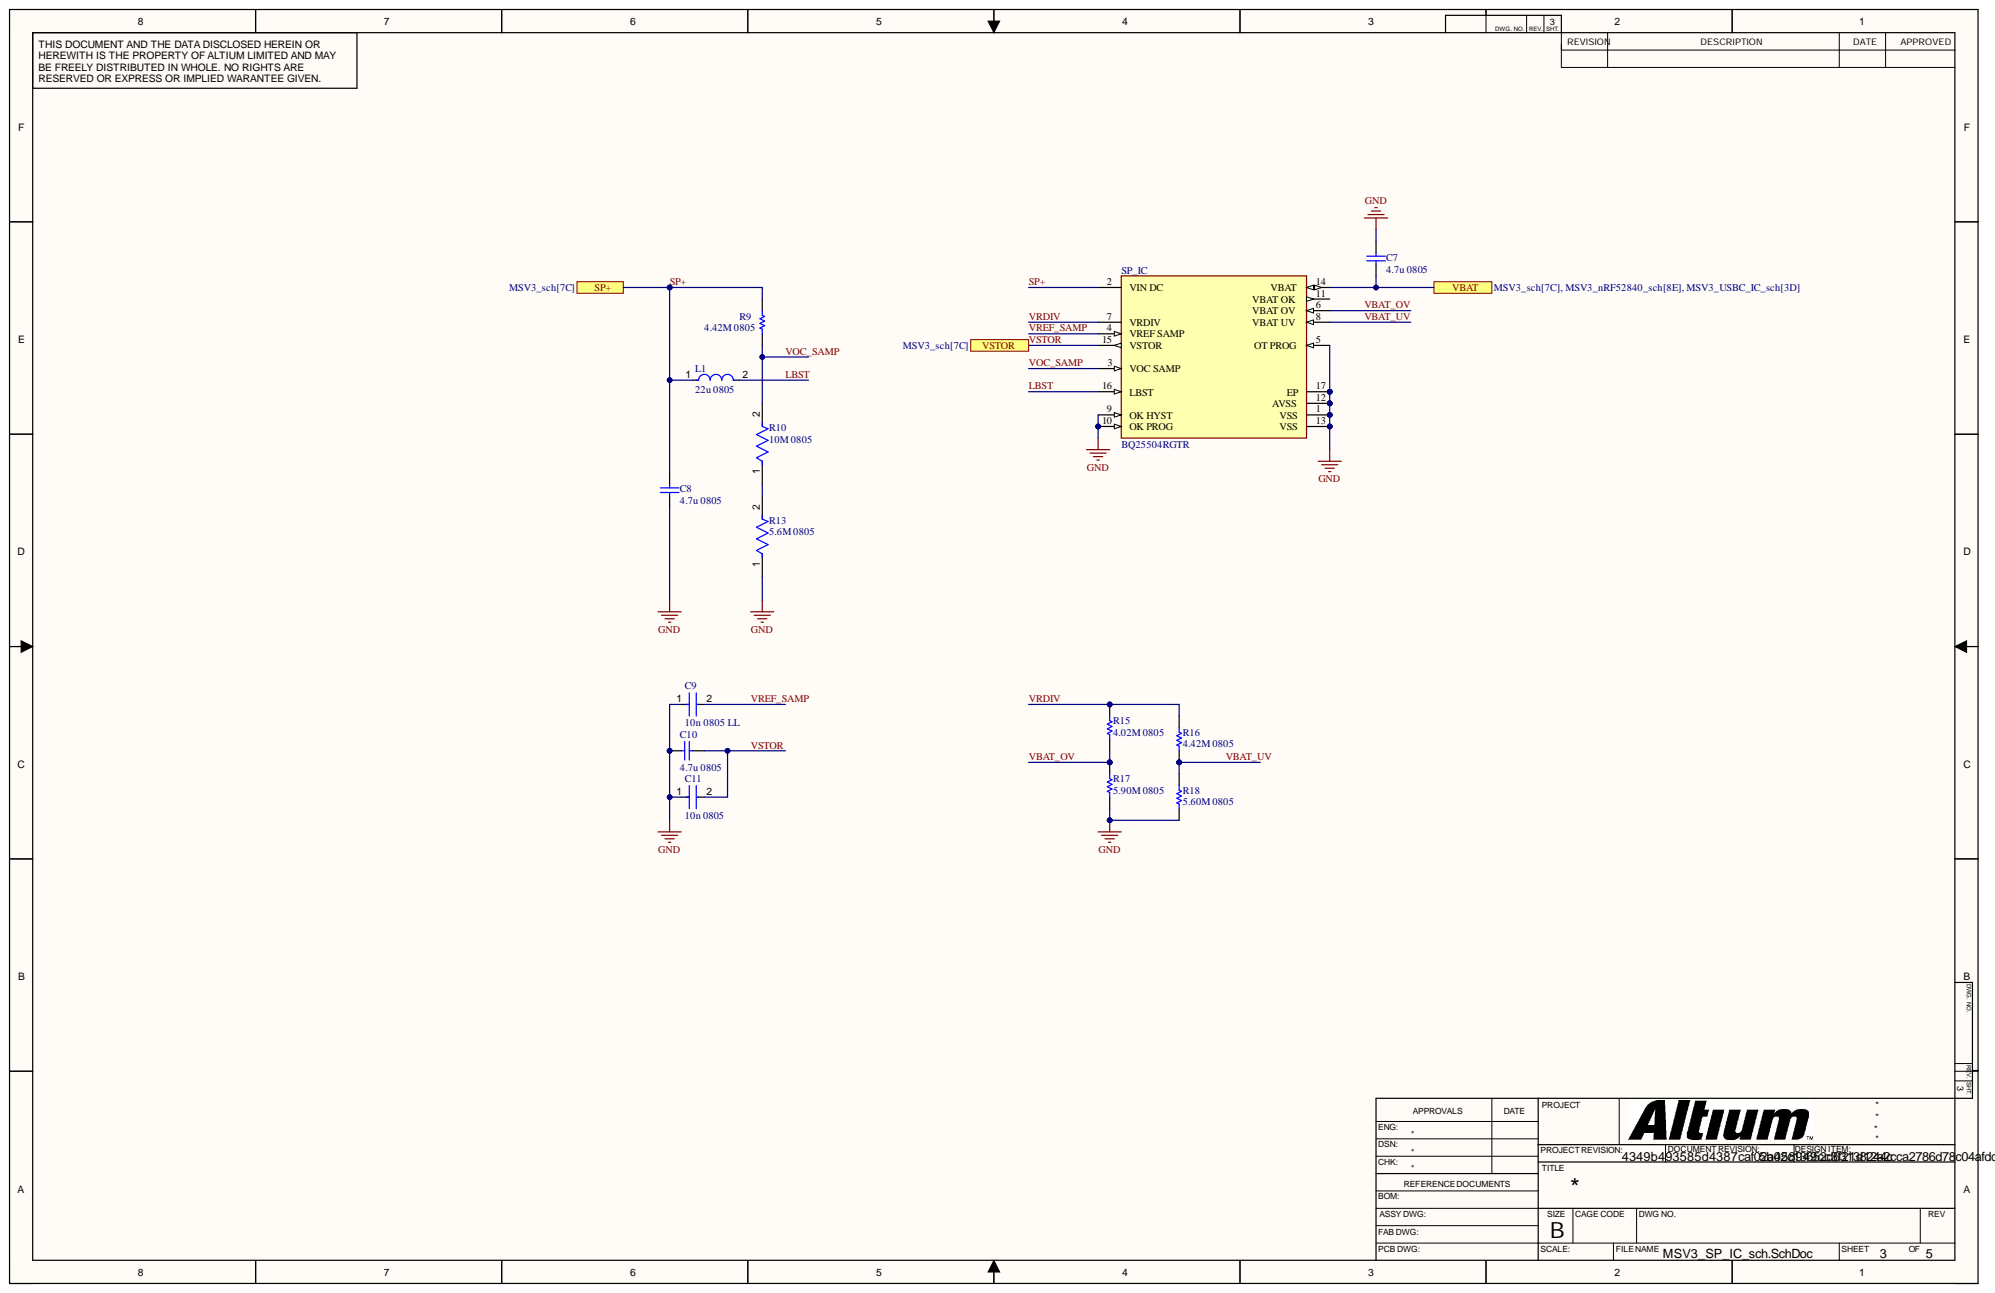
[picture p243: page 3]

T H I S D O C UME N T A N D T H E D AT A D I S C L O S E D H E R E I N O R H E R EWI T H I S T H E P R O P E R T Y O F A LT I UM L IMI T E D A N D MAY B E F R E E LY D I S T R I B U T E D I N WH O L E . N O R I G H T S A R E S O S S O G R E E R V E D R E X P R E R IMP L I E D WA R A N T E E I V E N . | G N 7 | REVISI O | N DESC R IPT I O N | DAT E | APPR OVED

REV. SHT. DWG. NO.

A P PROV A L S | DAT E | PROJE CT | ****

ENG : **
CHK : | | TIT L E *

DSN: | | PROJECT RE VISION : 4 3 4 9 b 4 | DOCUM ENT RE VISION : 9 3 5 8 5 d 4 3 8 7 c a f 052 ba 40 25 c81934695c2cd36f2311 | DE SIGN IT E M : 3d81224a42cc c a 2 7 8 6 d 7 8

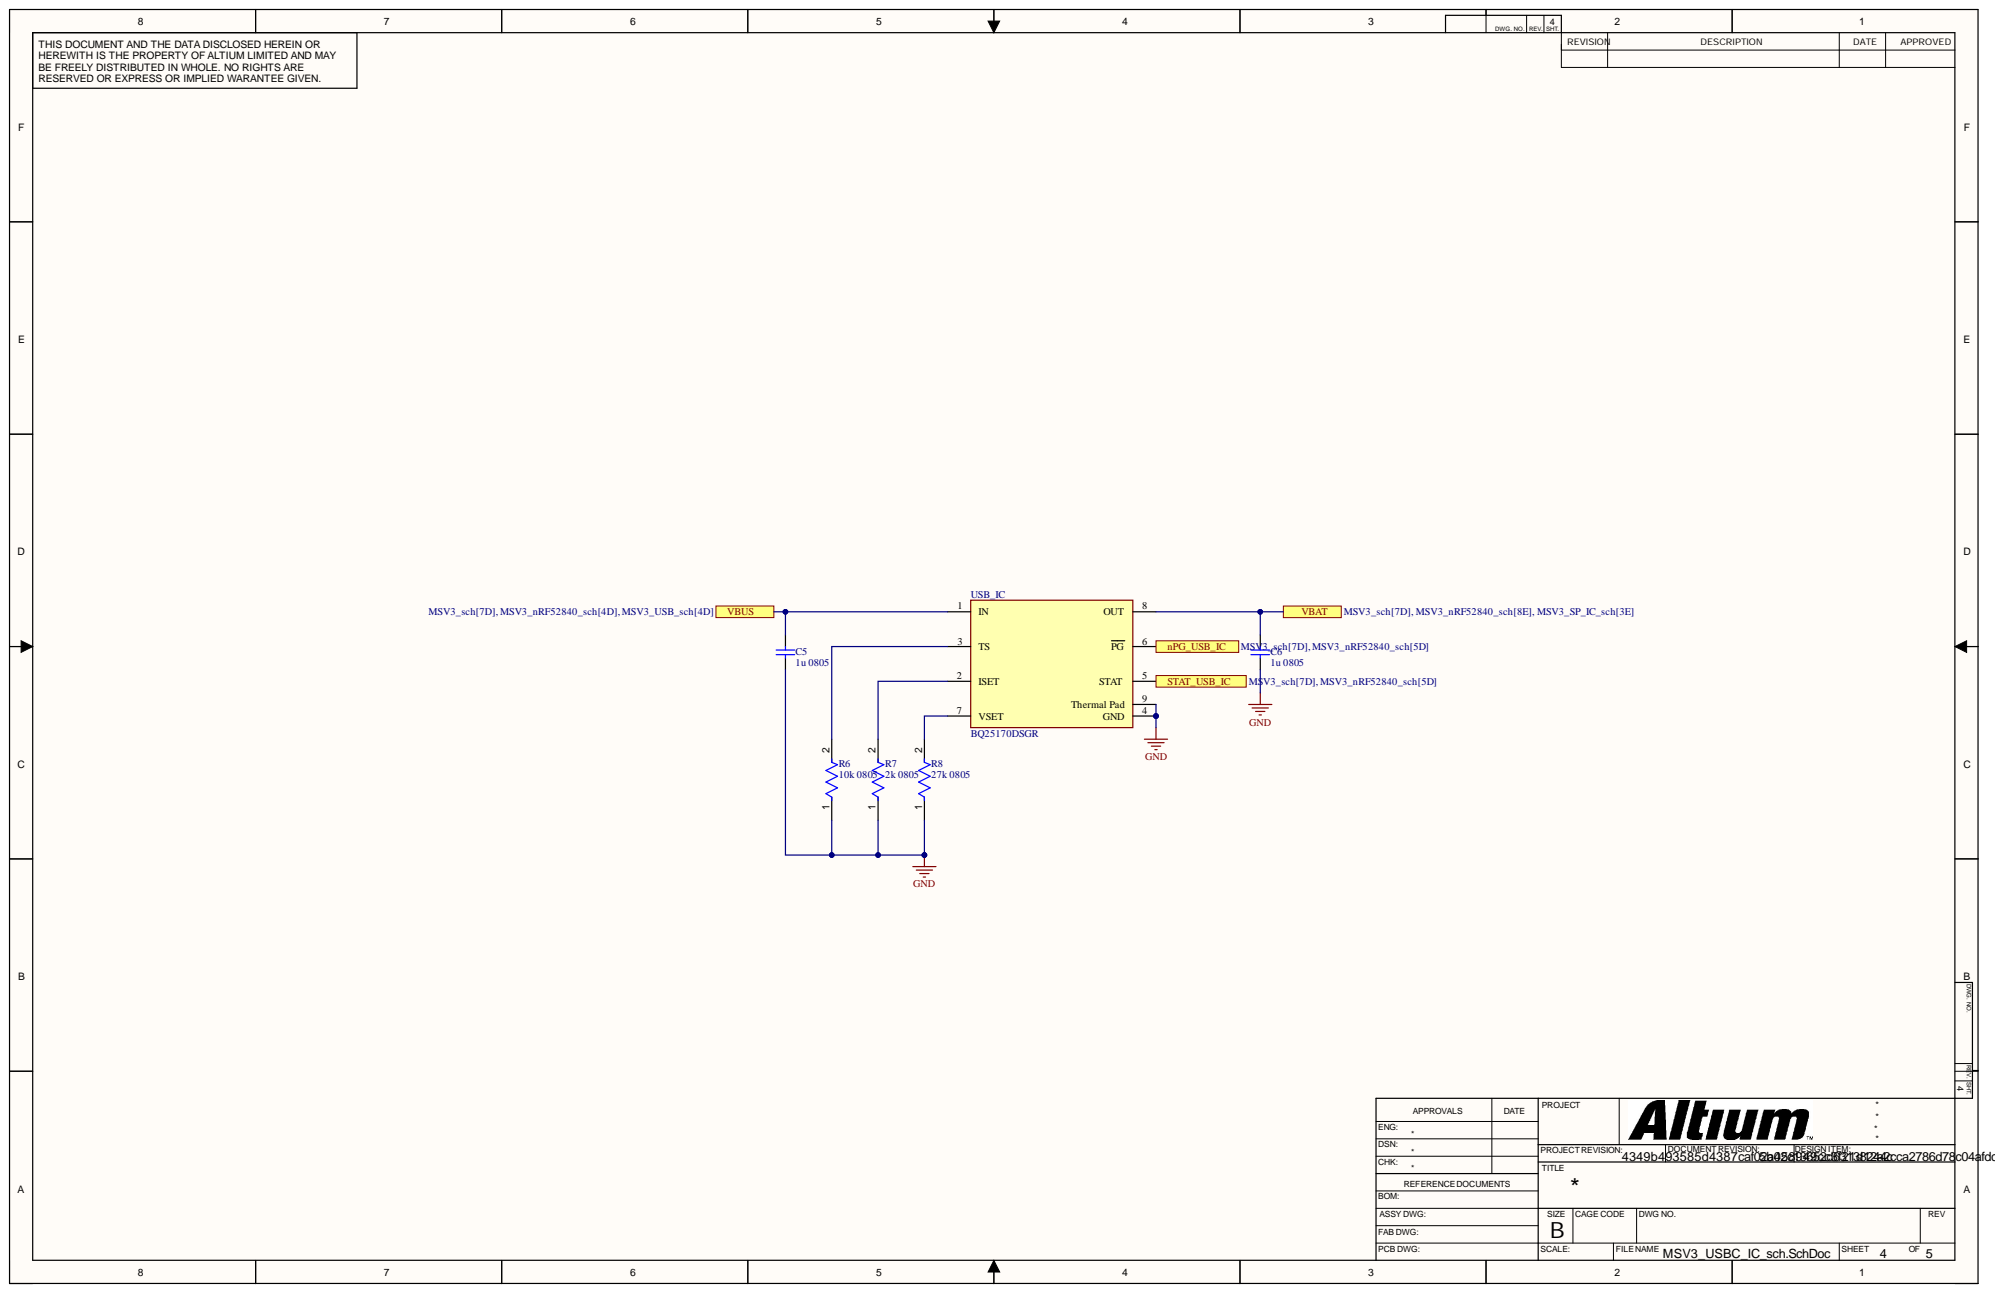
[picture p244: page 4]

8 | 7 | 6 | 5 | 4 | 3 | DWG. NO. | REV. | 4 SHT. | 2 | 1

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

REV. SHT. DWG. NO.

DATE | PROJECT | * * APPROVALS * *

ENG: *
CHK: * | | TITLE *

DSN: * | | PROJECT REVISION: | DOCUMENT REVISION: | DESIGN ITEM:

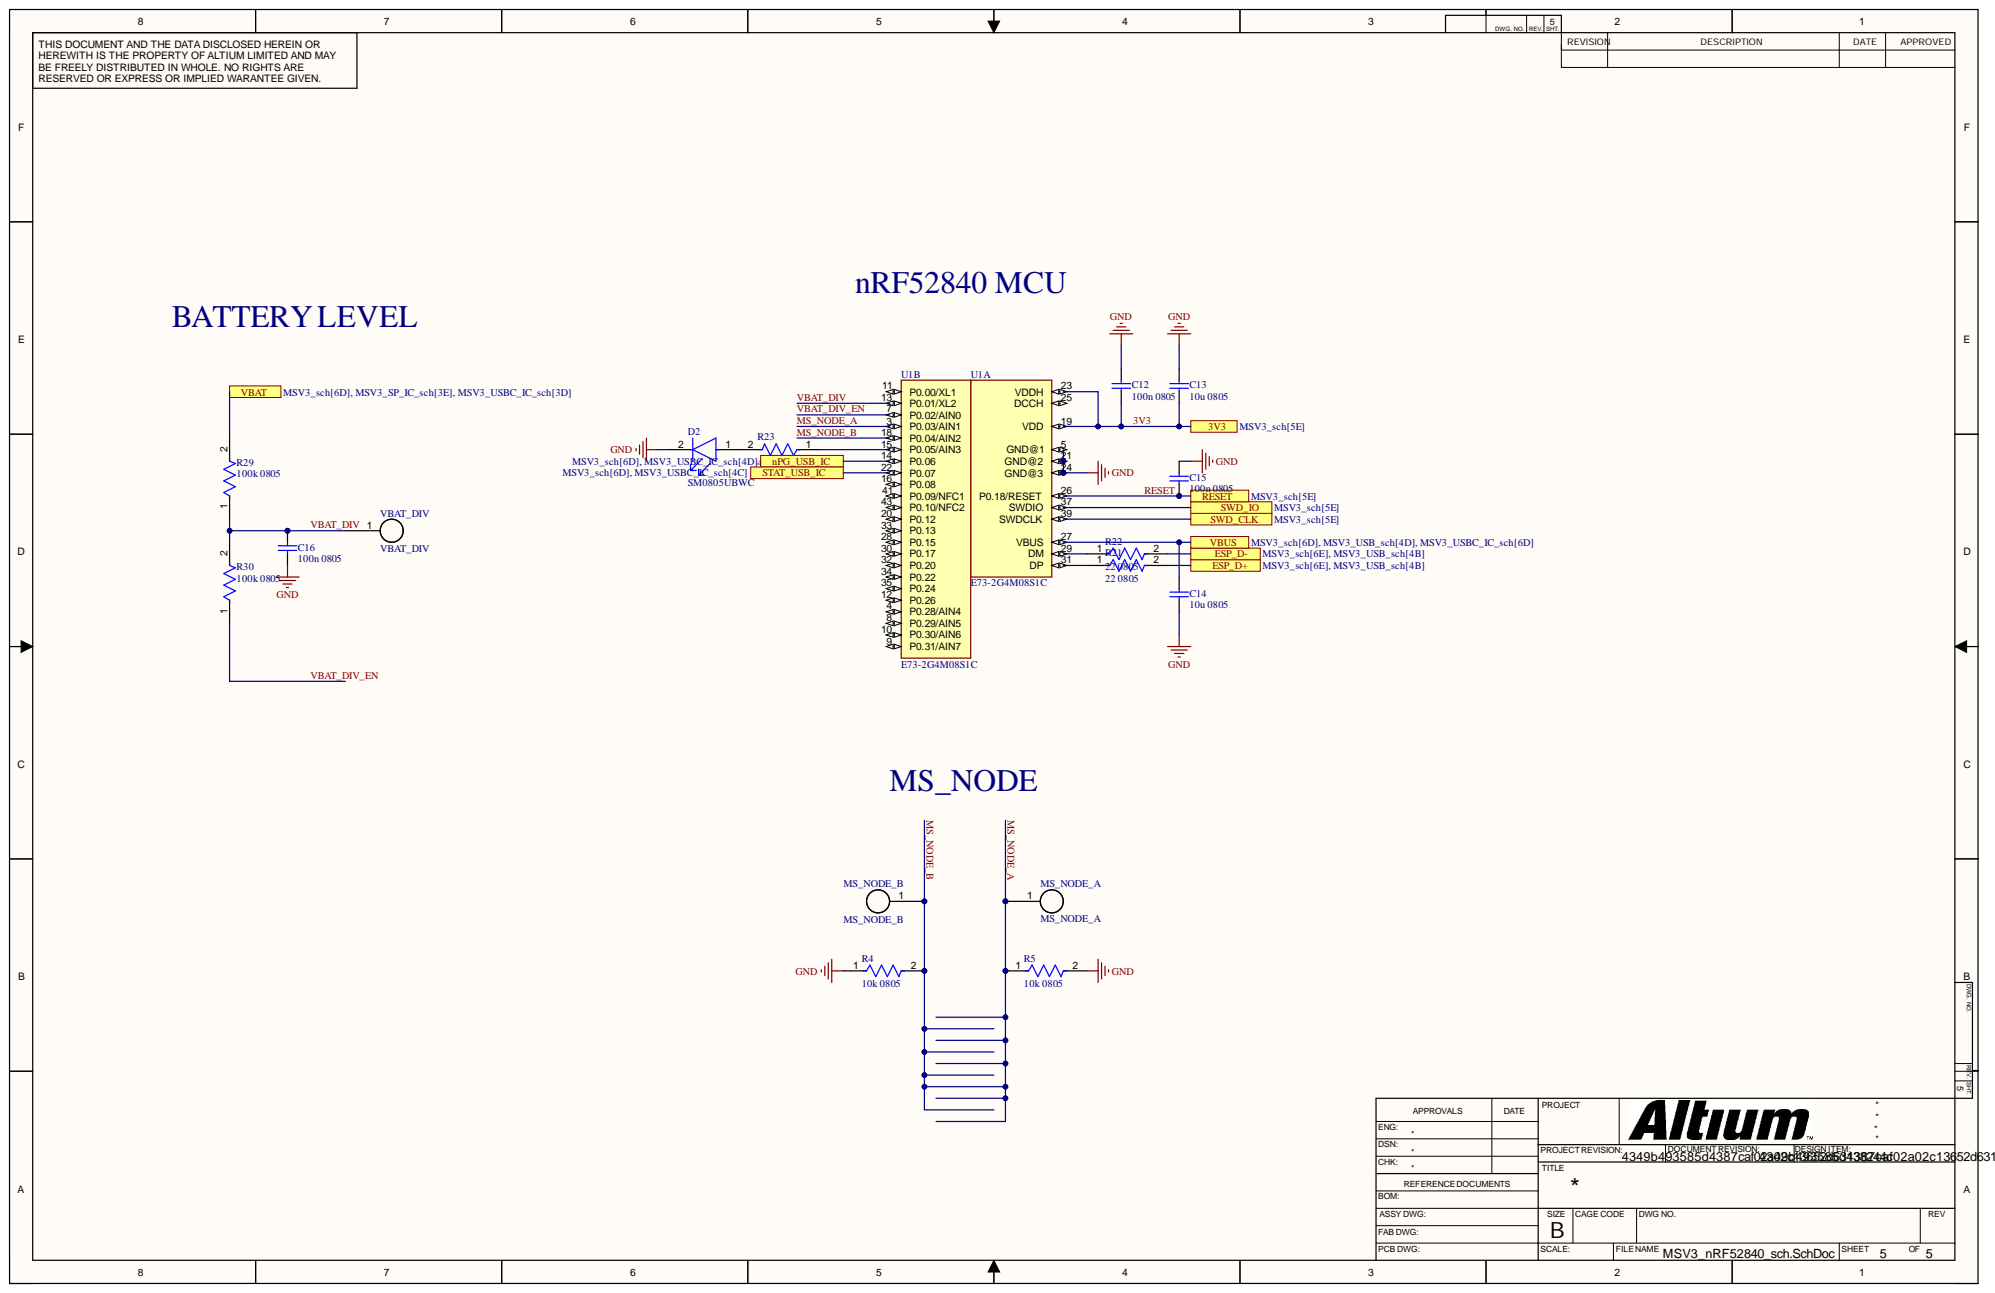
[picture p245: page 5]

8 | 7 | 6 | 5 | 4 | 3 | DWG. NO. | REV. | 5 SHT. | 2 | 1

THIS DOCUMENT AND THE DATA DISCLOSED HEREIN OR HEREWITH IS THE PROPERTY OF ALTIUM LIMITED AND MAY BE FREELY DISTRIBUTED IN WHOLE. NO RIGHTS ARE RESERVED OR EXPRESS OR IMPLIED WARANTEE GIVEN. | nRF52840 MCU GND GND | REVISION | DESCRIPTION | DATE | APPROVED

P0.00/XL1 11 P0.01/XL2 13 P0.02/AIN0 7 P0.03/AIN1 3 P0.04/AIN2 18 P0.05/AIN3 15 P0.06 14 | DCCH VDD SWDIO

37 | RESET | MSV3_sch[5E] RESET

REV. SHT. DWG. NO.

DATE | PROJECT | * * APPROVALS * *

ENG: *
CHK: * | | TITLE *

DSN: * | | PROJECT REVISION: | DOCUMENT REVISION: | DESIGN ITEM:
