samam624/ProjectTreebeard/(list of files, drawings)

Other design files:
hardware/altium/Treebeard_Passives/Treebeard_Passives.PcbLib
hardware/altium/Treebeard_Passives/Treebeard_Passives.SchLib
