samam624/ProjectTreebeard/DisplayCenter/arduino/Treebeard_ESP32_Display_Runtime/Treebeard_ESP32_Display_Runtime.ino

/*********************************************************************
  MSV2 ESP32 BLE advertisement display runtime.

  Flash this sketch once. After that, update the screen layout by pushing
  ui.json over WiFi:

    python scripts/push_display_ui.py --file ui/display_default.json

  Arduino library requirements:
    - ESP32 board package
    - GFX Library for Arduino
    - ArduinoJson
    - XPT2046_Touchscreen

  The board starts an access point named MSV2-Display by default:
    SSID:     MSV2-Display
    password: none
    updater:  http://192.168.4.1/ui
    status:   http://192.168.4.1/data
*********************************************************************/

// Bring-up stage:
//   0 = serial-only safe boot
//   1 = display-only smoke test
//   2 = display + WiFi updater runtime, BLE off
//   3 = full runtime with BLE scanning
#define TREEBEARD_BRINGUP_STAGE 3

#define TREEBEARD_SAFE_BOOT (TREEBEARD_BRINGUP_STAGE == 0)
#define TREEBEARD_DISPLAY_TEST (TREEBEARD_BRINGUP_STAGE == 1)
#define TREEBEARD_ENABLE_DISPLAY (TREEBEARD_BRINGUP_STAGE >= 1)
#define TREEBEARD_ENABLE_WIFI (TREEBEARD_BRINGUP_STAGE >= 2)
#define TREEBEARD_ENABLE_BLE (TREEBEARD_BRINGUP_STAGE >= 3)
#define TREEBEARD_SAFE_BOOT_LED_PIN 2
#define TREEBEARD_SAFE_BOOT_BLINK_MS 500
// 2026-09-02: build-tag prefix changed MSV2 -> Treebeard with the project rename. Given its
// own date/suffix rather than reusing the 2026-08-31 one, so the two prefixes never describe
// the same tag - every historical record at or before 2026-08-31 legitimately reads
// "MSV2 runtime build ..." because that is what those binaries actually reported.
#define TREEBEARD_BUILD_TAG "Treebeard runtime build 2026-11-10 tls-psram-v1"

#ifndef TREEBEARD_FORCE_WIFI_SETUP
#define TREEBEARD_FORCE_WIFI_SETUP 0
#endif

#include <Arduino.h>
#include "esp_heap_caps.h"
#include <math.h>

#if TREEBEARD_ENABLE_WIFI
#include <FS.h>
using fs::FS;
using fs::File;
#endif

#if TREEBEARD_ENABLE_DISPLAY
#include <Arduino_GFX_Library.h>
#include <SPI.h>
#include <XPT2046_Touchscreen.h>
#include "PlantSpriteCatalog.h"
#endif

#if TREEBEARD_SAFE_BOOT || TREEBEARD_DISPLAY_TEST

void setup()
{
  pinMode(TREEBEARD_SAFE_BOOT_LED_PIN, OUTPUT);
  digitalWrite(TREEBEARD_SAFE_BOOT_LED_PIN, LOW);

  Serial.begin(115200);
  uint32_t startMs = millis();
  while (millis() - startMs < 5000)
  {
    Serial.println("[Treebeard safe boot] waiting for serial");
    digitalWrite(TREEBEARD_SAFE_BOOT_LED_PIN, !digitalRead(TREEBEARD_SAFE_BOOT_LED_PIN));
    delay(250);
  }

  Serial.println();
  Serial.println("[Treebeard safe boot] setup reached");
#if TREEBEARD_DISPLAY_TEST
  // Backlight is gated by Q2 (2N7002) on GPIO11, non-inverted -- see
  // Treebeard_ESP32_Backlight_Test. Arduino_GFX doesn't drive this pin itself,
  // so it has to be switched on explicitly or the panel stays dark even
  // though SPI init/draw succeeds.
  Serial.println("[Treebeard display test] enabling 75% backlight PWM (GPIO11)");
  if (!ledcAttach(11, 1000, 10))
  {
    Serial.println("[Treebeard display test] backlight PWM attach failed");
  }
  ledcWrite(11, 575); // 75%^2 perceived-brightness curve, 10-bit duty

  Serial.println("[Treebeard display test] initializing Arduino_GFX");
  Arduino_DataBus* testBus = new Arduino_ESP32SPI(14, 16, 12, 13, -1);
  Arduino_GFX* testGfx = new Arduino_ST7796(testBus, 15, 1, false, 320, 480);
  if (testBus == nullptr || testGfx == nullptr)
  {
    Serial.println("[Treebeard display test] allocation failed");
    return;
  }
  Serial.println("[Treebeard display test] allocation complete");

  Serial.println("[Treebeard display test] calling begin()");
  testGfx->begin();
  Serial.println("[Treebeard display test] begin() complete");

  Serial.println("[Treebeard display test] drawing");
  testGfx->setRotation(1);
  testGfx->fillScreen(0x0000);
  testGfx->setTextColor(0xFFFF, 0x0000);
  testGfx->setCursor(8, 8);
  testGfx->setTextSize(2);
  testGfx->println("MSV2 display test");
  testGfx->setTextColor(0x07E0, 0x0000);
  testGfx->setCursor(8, 32);
  testGfx->setTextSize(1);
  testGfx->println("If you see this, display works.");
  Serial.println("[Treebeard display test] init/draw complete");
#else
  Serial.println("[Treebeard safe boot] no display, WiFi, BLE, LittleFS, or ArduinoJson loaded");
#endif
  Serial.println("[Treebeard safe boot] GPIO 2 heartbeat active if your board has that LED");
  Serial.flush();
}

void loop()
{
  static uint32_t lastPrintMs = 0;
  static uint32_t lastBlinkMs = 0;
  static bool blinkState = false;
  uint32_t now = millis();

  if (now - lastBlinkMs >= TREEBEARD_SAFE_BOOT_BLINK_MS)
  {
    lastBlinkMs = now;
    blinkState = !blinkState;
    digitalWrite(TREEBEARD_SAFE_BOOT_LED_PIN, blinkState ? HIGH : LOW);
  }

  if (now - lastPrintMs >= 1000)
  {
    lastPrintMs = now;
    Serial.print("[Treebeard safe boot] alive ms=");
    Serial.println(now);
  }
}

#else

#include <ArduinoJson.h>
#if TREEBEARD_ENABLE_BLE
#include <BLEDevice.h>
#include <BLEScan.h>
#include "BleScanFlush.h"
#endif
#include <esp_system.h>
#include <string.h>
#if TREEBEARD_ENABLE_WIFI
#include <LittleFS.h>
// 2026-08-31: for the postErrno diagnostic in runCloudSnapshotUploader() - lwIP sets errno on
// the failing socket call even though NetworkClientSecure collapses its return to -1.
#include <errno.h>
#include "MobileAppPage.h"
#include <DNSServer.h>
#include <HTTPClient.h>
#include <WebServer.h>
#include <WiFi.h>
#include <WiFiClientSecure.h>
#include <mbedtls/platform.h>
#if __has_include("WiFiCredentials.h")
#include "WiFiCredentials.h"
#endif

// Trusted root CAs used instead of secureClient.setInsecure() so outbound cloud calls actually
// validate the server certificate, rather than accepting anything. Pinning the ROOT (not the
// leaf/intermediate Supabase presents) means this survives routine cert rotation -- roots change
// on a timescale of years/decades, not weeks. Two roots are included because Supabase's edge
// currently presents a GTS Root R4 cross-signed by the long-lived GlobalSign Root CA (for older
// trust stores) rather than the modern self-signed GTS Root R4; either one alone completes a
// chain that the other configuration would need.
static const char TREEBEARD_TRUSTED_ROOT_CA_PEM[] PROGMEM = R"PEM(
-----BEGIN CERTIFICATE-----
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
-----END CERTIFICATE-----
-----BEGIN CERTIFICATE-----
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
HMUfpIBvFSDJ3gyICh3WZlXi/EjJKSZp4A==
-----END CERTIFICATE-----
)PEM";
#endif

const char AP_SSID[] = "MSV2-Display";
const char AP_PASSWORD[] = "";
const char LOCAL_CONFIG_SOURCE[] = "receiver-local";

#ifndef WIFI_SSID
#define WIFI_SSID ""
#endif

#ifndef WIFI_PASSWORD
#define WIFI_PASSWORD ""
#endif

#ifndef TREEBEARD_CLOUD_BOOTSTRAP_URL
#define TREEBEARD_CLOUD_BOOTSTRAP_URL "https://lyemomfpzkawqecpfufm.supabase.co/functions/v1/receiver-bootstrap"
#endif

#ifndef TREEBEARD_HOSTED_APP_URL
#define TREEBEARD_HOSTED_APP_URL "https://msv2-plants.netlify.app/"
#endif

const char UI_PATH[] = "/ui.json";
const char WIFI_CONFIG_PATH[] = "/wifi.json";
const char FORCE_WIFI_SETUP_UNLOCK_PATH[] = "/wifi-setup-unlock-v2.flag";
const char WIFI_RETRY_STATE_PATH[] = "/wifi-retry.json";
const char DEVICE_CONFIG_PATH[] = "/device.json";
const char CLOUD_CONFIG_PATH[] = "/cloud.json";
const char DISPLAY_SETTINGS_PATH[] = "/display.json";
const char TOUCH_CALIBRATION_PATH[] = "/touch-calibration.json";
const char SOUND_SETTINGS_PATH[] = "/sound.json";
const char AUTOCAL_CACHE_PATH[] = "/autocal-cache-v1.json";
const char AUTOCAL_CACHE_TEMP_PATH[] = "/autocal-cache-v1.tmp";
const char TEMPERATURE_COMPENSATION_CACHE_PATH[] = "/temp-comp-v3.json";
const char TEMPERATURE_COMPENSATION_CACHE_TEMP_PATH[] = "/temp-comp-v3.tmp";
const uint16_t MSV2_COMPANY_ID = 0xFFFF;
const uint8_t MSV2_MAGIC[] = { 'M', 'S', 'V', '2' };
const uint8_t MAX_SENSOR_ID = 16;

// ---- Bench probes: MSV3 bring-up firmware, deliberately a DIFFERENT magic ----
//
// MSV3_Probe_Bringup_Test.ino advertises "MSV3" instead of "MSV2" so that a production receiver
// drops its packets before it ever looks at sensorId. That is a SAFETY PROPERTY, not an
// oversight: a bench probe sitting in air next to a running receiver must never be able to
// contribute a fabricated reading to a real plant's history or to the cloud.
//
// The Bench page opts back in to seeing those packets, and it does so through a SEPARATE parse
// path (parseBenchAdvertisement) writing a SEPARATE array (benchProbes). That path must never
// touch sensors[], the history staging buffer, the durable outbox, or the cloud snapshot. If a
// future change makes a bench packet reach any of those, the safety property above is gone.
const uint8_t MSV3_BENCH_MAGIC[] = { 'M', 'S', 'V', '3' };
// Bench firmware before the 2026-09-21 widening sent 17 bytes and no format version. Both
// lengths are accepted so an older bring-up image still appears on the page, with the v1-only
// fields (mux code, FDC status) shown as unavailable rather than decoded from absent bytes.
const size_t MSV3_BENCH_PACKET_MIN_LEN = 17;
const size_t MSV3_BENCH_PACKET_V1_LEN = 23;
// Byte [19] in the bench layout. Production sends the low byte of an always-zero legacy field at
// this offset, so any nonzero value here is unambiguous evidence of versioned bench firmware.
// See the bench packet ABI comment above bleStartAdv() in MSV3_Probe_Bringup_Test.ino -- keyed
// on this version exactly so a reused byte can never be decoded against the wrong build, which
// is the mistake CLAUDE.md records being made four times during the DFU work.
const uint8_t MSV3_BENCH_FORMAT_VERSION_1 = 1;
#define BENCH_ADV_FLAG_CHARGING        (1U << 0)
#define BENCH_ADV_FLAG_BOARD_TEMP_OK   (1U << 2)
#define BENCH_ADV_FLAG_OTA_POWER_OK    (1U << 4)
#define BENCH_ADV_FLAG_READING_INVALID (1U << 5)
#define BENCH_ADV_FLAG_LIVE_MODE       (1U << 7)
// Five fits the page's list area at a readable row height. A bench rarely has more than two or
// three probes on it at once; the slot table evicts the stalest entry rather than growing.
const uint8_t BENCH_SLOT_COUNT = 5;
const uint32_t BENCH_STALE_MS = 15000;

// ---- Bench command beacon: receiver -> probe, connectionless ----
//
// ABI shared with benchCommandScanCallback() in MSV3_Probe_Bringup_Test.ino; that function's
// comment is the authoritative description, including why the direction is receiver-advertises /
// probe-scans rather than the other way round, and the explicit statement that this channel is
// unauthenticated and therefore carries nothing but a light.
//
// "TBCM" is a third magic, distinct from both "MSV2" and "MSV3", so a command can never be
// parsed as sensor data nor sensor data as a command.
const uint8_t BENCH_CMD_MAGIC[] = { 'T', 'B', 'C', 'M' };
const uint8_t BENCH_CMD_TARGET_ALL = 0xFF;
const uint8_t BENCH_CMD_OP_IDENTIFY = 0x01;
const size_t BENCH_CMD_PACKET_LEN = 14;
// How long one command stays on air. Long enough that a probe scanning at 50% duty cannot miss
// it, short enough that the radio is back to plain scanning almost immediately.
const uint32_t BENCH_CMD_BROADCAST_MS = 2500;
uint32_t benchCommandUntilMs = 0;
uint32_t benchCommandCounter = 0;
bool benchCommandAdvertising = false;
// Randomised once, lazily, on the first command after boot. The probe compares the counter only
// within one session, because the counter alone restarts at 1 on every receiver boot and would
// then collide with the last value a probe already acted on -- measured 2026-09-21, and it made
// the first identify after a receiver reflash silently do nothing. See
// benchCommandScanCallback()'s comment in MSV3_Probe_Bringup_Test.ino.
uint16_t benchCommandSessionId = 0;

// MSV3 receiver-side temperature compensation. The probe continues to transmit only raw
// observables; this model lives here so raw history is never replaced and the correction can
// be revised/audited without reflashing every probe. It estimates log(Cconnected/Cbare), removes
// the part that covaries with a 2-hour effective board temperature, and retains a 48-hour
// moisture baseline.
//
// Model v3 (2026-09-14) fixes a defect that made v2 actively harmful on some probes. v2 seeded
// every probe with a POSITIVE gain and then rejected any fit that came back negative. Probe 8's
// real coefficient is negative, so all four of its 24-hour fits were rejected, its gain stayed
// pinned at the seed forever, and it applied a wrong-signed correction that made its daily swing
// 2.5x WORSE than no compensation at all. Measured against 10 days of real history:
//
//   probe 8 daily peak-to-peak   uncorrected 0.907%   v2 2.289%   v3 0.701%
//   probe 4 daily peak-to-peak   uncorrected 10.385%  v2 9.334%   v3 9.422%
//
// The three changes are: seed the gain at zero so an unlearned probe corrects nothing rather
// than guessing; accept negative gains, because the sign is a physical property that differs
// between probes; and adopt the first accepted fit outright instead of blending it 3:1 against
// a seed that carries no information. See
// MSV3/docs/MSV3_AM_VS_FM_SENSING_THERMAL_SELECTIVITY_2026-09-13.md for why the sign varies:
// the thermal term is a difference of competing effects whose balance depends on soil wetness.
const uint8_t TEMPERATURE_COMPENSATION_MODEL_VERSION = 3;
const float TEMPERATURE_COMPENSATION_DEFAULT_REFERENCE_C = 22.0f;
const float TEMPERATURE_COMPENSATION_PROBE_4_REFERENCE_C = 22.34f;
const float TEMPERATURE_COMPENSATION_TEMP_TAU_SECONDS = 2.0f * 60.0f * 60.0f;
const float TEMPERATURE_COMPENSATION_MOISTURE_TAU_SECONDS = 48.0f * 60.0f * 60.0f;
// Zero, deliberately. A probe that has not yet earned a fit must not apply a correction whose
// sign it cannot know. The gain is a per-probe physical property, not a fleet constant.
const float TEMPERATURE_COMPENSATION_DEFAULT_SEED_GAIN_PER_C = 0.0f;
const float TEMPERATURE_COMPENSATION_PROBE_4_SEED_GAIN_PER_C = 0.0f;
// Symmetric bound. v2 used 0.0f as the lower limit, which silently discarded every correctly
// fitted negative gain instead of applying it.
const float TEMPERATURE_COMPENSATION_MIN_GAIN_PER_C = -0.04f;
const float TEMPERATURE_COMPENSATION_SEED_PHASE_OFFSET = 0.0000496f;
const uint32_t TEMPERATURE_COMPENSATION_FIT_BLOCK_MS = 24UL * 60UL * 60UL * 1000UL;
const uint32_t TEMPERATURE_COMPENSATION_PERSIST_INTERVAL_MS = 15UL * 60UL * 1000UL;
const uint16_t TEMPERATURE_COMPENSATION_MIN_FIT_SAMPLES = 120;
const float TEMPERATURE_COMPENSATION_MIN_TEMP_SPAN_C = 2.0f;
const float TEMPERATURE_COMPENSATION_MIN_FIT_R2 = 0.40f;
const uint8_t TEMPERATURE_COMPENSATION_REQUIRED_FITS = 2;
// Consecutive-sample jumps above these bounds are handling/configuration changes, not an
// ordinary watering. Probe 4's measured watering step was below 1%; its cup-immersion and
// insertion/removal steps were many percent. Resetting at the latter prevents an EMA or fit
// from blending two physically incompatible epochs.
const float TEMPERATURE_COMPENSATION_MAX_CONNECTED_STEP_FRACTION = 0.03f;
const float TEMPERATURE_COMPENSATION_MAX_BARE_STEP_FRACTION = 0.0035f;

enum TemperatureCompensationMode : uint8_t
{
  TEMPERATURE_COMPENSATION_OFF = 0,
  TEMPERATURE_COMPENSATION_LEARNING = 1,
  TEMPERATURE_COMPENSATION_ACTIVE = 2,
};
// 2026-07-28: probes were reworked to send raw, uncalibrated readings (raw oscillator kHz,
// raw battery mV, raw charging flag) instead of interpreting them on-device - see
// MSV2_Moisture_BLE_Sleep.ino and calibrateRawMoisture()/calibrateRawBattery() below. That
// widened the packet from 13 to 15 bytes, which doubles as a format-version check: probes
// still running pre-rework firmware send the shorter legacy packet with already-calibrated
// values, handled as a fallback in Msv2AdvertisedDeviceCallbacks::onResult().
const size_t MSV2_RAW_PACKET_MIN_LEN = 15;
// 2026-08-22: MSV3 probes (arduino/MSV3_Moisture_BLE_Sleep/) send a real
// sensor - the FDC2214, a 28-bit LC-tank frequency counter - instead of
// MSV2's RC-oscillator kHz count, so the raw field at byte 10 is widened
// from 2 bytes to 4 (real values on the bench are ~18-22 million, nowhere
// near fitting in uint16_t). Same magic/company-id/sensorId/wake layout as
// the narrow raw packet (bytes 0-9 identical), just a wider raw-value field
// and battery mV/charging shifted two bytes later - see
// Msv2AdvertisedDeviceCallbacks::onResult() below, which MUST check this
// (wider) length threshold before MSV2_RAW_PACKET_MIN_LEN, since a wide
// packet also satisfies the narrower >= check and would otherwise be
// misparsed with the old field offsets.
const size_t MSV2_RAW_PACKET_WIDE_LEN = 17;
// 2026-08-25: MSV3_Moisture_BLE_Sleep.ino's software-only board-temperature/bare-tank-reference
// addition widens the wide packet again, 17 -> 23 bytes (byte 16 gains phase/validity flag bits,
// bytes 17-18 are signed board temp in quarter-degrees C, bytes 19-22 are the bare-tank FDC
// count). The 2026-09-14 capless policy keeps that length, zeros/invalidates the retired bare
// field, and uses flag bit6 to select the capless scale. See the probe firmware's wire-format
// comment above startAdv() for the exact layout. A
// packet is wideRaw at length>=17 same as before (first 17 bytes are unchanged, so an older
// receiver parses those fields identically); it additionally carries these diagnostics only at
// length>=23. Named "diagnostic" rather than folded into wideRaw's own meaning because a shorter
// wide packet (an MSV3 probe running older firmware) must keep working exactly as today with no
// diagnostics, not be misparsed or rejected.
const size_t MSV3_DIAGNOSTIC_PACKET_LEN = 23;
// Version the receiver-derived numeric scale written to history. Scale 1 covers the
// existing legacy/MSV2 mappings. Scale 2 is MSV3 with the original 270pF C17 tank capacitor.
// Scale 3 is the 2026-09-14 capless/no-bare-reference MSV3 policy. The probe marks scale 3 with
// flag bit6, allowing old and reworked probes to coexist during rollout. The cloud uses a version
// change to start a fresh calibration epoch without deleting older measurements or mixing
// incompatible numeric ranges.
const uint8_t MSV2_MOISTURE_SCALE_VERSION = 1;
const uint8_t MSV3_MOISTURE_SCALE_VERSION = 2;
const uint8_t MSV3_CAPLESS_MOISTURE_SCALE_VERSION = 3;
// 2026-10-06: MSV4 probes (MSV4/arduino/MSV4_Moisture_BLE_Sleep) keep the 23-byte MSV3 layout and
// set flag bit7. The sensor fields then mean something else entirely: bytes 10-13 are the fitted
// soil resistance in 0.1 ohm (not an FDC count), bytes 17-18 are the blade-tip NTC temperature
// (not die temperature), and bytes 19-22 hold fit diagnostics (not a bare-tank count).
// They travel through the SAME SensorReading/PendingHistoryReading fields as their MSV3
// counterparts so the durable history record and the cloud columns do not change; scale 4 is
// what tells every consumer which meaning applies. See that sketch's layout comment above
// startAdv() -- the packet is an ABI with this parser.
const uint8_t MSV4_MOISTURE_SCALE_VERSION = 4;
const uint8_t MSV4_ADV_FLAG = 0x80;
// The probe saturates Rsoil here (400 kohm): with its 1 kohm source resistor it cannot tell
// larger values apart, and in air the fit runs off to 1e14 ohm. Below 1 ohm is the fit collapsing
// with nothing to conduct, which the probe already marks invalid.
const uint32_t MSV4_RSOIL_DECIOHM_MIN = 10UL;
const uint32_t MSV4_RSOIL_DECIOHM_MAX = 4000000UL;
// Soil conductivity rises about 2 %/C, the standard EC correction. The probe sends Rsoil
// uncorrected with the tip temperature beside it, so the correction lives here with every other
// calibration.
const float MSV4_EC_TEMPCO_PER_C = 0.02f;
const float MSV4_EC_REFERENCE_C = 25.0f;
// Presentation units per decade of resistance; see calibrateMsv4Moisture().
const float MSV4_MOISTURE_UNITS_PER_DECADE = 10000.0f;
// The BQ25504 stops charging this cell at VBAT_OV and switches the load off at VBAT_OK falling
// (nominal resistor values, MSV4/docs/MSV4_PROBE_BOM_2026-09-16.md), so an MSV4 battery only ever
// moves through that slice of the LiPo curve.
const float MSV4_BATTERY_EMPTY_MV = 3369.0f;
// The nominal VBAT_OV is 3889 mV, but the BQ25504 tapers the charge current as it nears that
// ceiling and the cell parks lower: board 1 sat at a median of 3806-3820 mV (max 3832-3857) on
// 10-09..10-12 with the harvester finished. 3820 mV is that plateau, so a charged cell reads 100 %.
const float MSV4_BATTERY_FULL_MV = 3820.0f;
// MSV3 (scale 2/3) probes with the 2026-09-14 VBAT_OV rework: nominal ceiling 3897 mV, but probe 4
// (the one with a panel) plateaus at p95 3866-3869 / max 3879 mV for days. The curve is scaled so
// that plateau is 100 %; the bottom of the curve is untouched so the low-battery flag still fires
// where it did.
const float MSV3_BATTERY_FULL_MV = 3870.0f;
// Probe 7 was NOT reworked (R11 5.62M / R14 4.42M, ceiling ~4.26 V) and floats near 4.2 V, so it
// keeps the plain curve. Mirrored in MobileAppPage.h.
const uint8_t MSV3_UNREWORKED_SENSOR_ID = 7;
// MSV4 application version 262150 grew the packet from 23 to 26 bytes: bytes 23-24 are the
// nRF52840 die temperature (quarter-degrees C, the board end of the probe, not the soil) and
// byte 25 is a second flags byte whose bit0 marks that temperature valid. The 23-byte packet
// from 262148 stays valid; the tail is optional.
const size_t MSV4_EXTENDED_PACKET_LEN = 26;
const uint8_t MSV4_ADV_FLAG2_DIE_TEMP = 0x01;
// History keeps that die temperature in the record's rawMoistureKHz slot, which an MSV4 row
// otherwise leaves empty, offset so 0 still means "absent" as it does for every use of the slot.
// It reaches the cloud's raw_moisture_khz column as plain quarter-degrees.
const int16_t MSV4_DIE_TEMP_HISTORY_OFFSET = 1000;
// MSV4 application version 262152 ("layout B", flags2 bit1). Rsoil never needs more than 22 bits
// (it saturates at 4,000,000), so the top byte of the 32-bit field now carries the fit residual,
// and the two bytes that used to hold Cp and the residual hold Cd, the direct plate capacitance,
// in 0.01 pF (0 = not sent). Cd is the one fitted quantity that is still a live measurement with
// the blade in air, where Rsoil is only its ceiling and Cm is zero. Cp left the packet; it is a
// per-boot constant and the probe publishes it in its DIS hardware revision string.
//
// Whatever the packet's layout, an MSV4 reading is STORED in one form: rawFdcCounts is the
// resistance alone, rawBareTankFdcCounts is Cm | Cd << 16, and the residual travels beside them
// (msv4FitRmsE4; in the history record, the top byte of rawFdcCounts). A layout A packet is
// converted on arrival, so history never has to know which firmware sent a row.
const uint8_t MSV4_ADV_FLAG2_LAYOUT_B = 0x02;
const uint32_t MSV4_RSOIL_MASK = 0x00FFFFFFUL;
// 2026-10-15: the MSV4 raw sweep, Service Data in the probe's scan response from application
// version 262172. Layout (an ABI with the comment above SWEEP_RSP_LEN in
// MSV4_Moisture_BLE_Sleep.ino and with MSV4/scripts/msv4_adv_scan.py): UUID 0x4D34, then
// [0] layout 1, [1] sensor ID, [2] the advertisement counter's low byte, [3-26] 8 points x 3 bytes.
// The points are forwarded untouched; the cloud and the PC decode them.
const uint16_t MSV4_SWEEP_UUID16 = 0x4D34;
const uint8_t MSV4_SWEEP_LAYOUT = 1;
const size_t MSV4_SWEEP_POINT_BYTES = 24;
const size_t MSV4_SWEEP_DATA_LEN = 3 + MSV4_SWEEP_POINT_BYTES;
// A sweep older than this is not sent; the cloud rejects older ones too (raw-sweeps.ts).
const uint32_t MSV4_SWEEP_MAX_AGE_MS = 60UL * 60UL * 1000UL;
// Keep a passive scan session alive long enough that advertisements from several probes do
// not repeatedly collide with stop/clear/restart gaps. Results are still cleared between
// sessions, bounding NimBLE's discovered-device storage, but the allocator churn now happens
// twice per minute instead of roughly eighteen times per minute.
const uint32_t BLE_SCAN_SECONDS = 30;
const uint32_t BLE_SCAN_IDLE_MS = 50;
// 2026-08-13: back down from 3900s (65 min). That value was sized for a 30-minute
// probe wake/advertise cadence that's since been superseded (see 2026-08-09 in
// docs/STATUS_HANDOFF.md) - probes are back on the same ~10s-measure/60s-advertise
// bench cadence 90s was originally tuned for, with immediate advertises on a big
// moisture swing making steady-state gaps typically shorter than 60s, not longer.
// 180s tolerates two fully missed 60s advertises (packet loss or a bad scan window)
// plus margin before a card actually goes stale, while still flagging a truly
// dead/dead-battery probe within a few minutes instead of over an hour.
const uint32_t DEFAULT_STALE_SECONDS = 180;
const uint8_t BATTERY_UNKNOWN = 255;
const uint8_t MAX_ART_SLOTS = 16;
const uint32_t SENSOR_RENDER_INTERVAL_MS = 2000;
// 2026-08-30: self-healing backstop for the tap-to-expand diagnostic view. Confirmed live
// (real hardware, real photo): a touch-triggered draw can occasionally leave a stuck, partial
// repaint (observed: only the "Age" stat visible, rest of the card otherwise normal) that
// persists indefinitely - by design, the data-only redraw path never revisits pixels it
// believes are already correct, so a one-off corrupted write never self-corrects. Confirmed
// user-side that tapping the card again (which forces collapsePlantCardInPlace's full clear)
// fixes it immediately and the corruption itself is intermittent, not a state-machine bug -
// consistent with a transient SPI-bus timing issue on hardware with a documented history of
// touch/display bus contention, not a logic error in expandedCardSlot tracking. This doesn't
// fix the root SPI-timing cause (see the 2026-08-30 touch-gesture-redesign comments for the
// mitigation already applied there); it bounds the damage: while a card is expanded, a full
// (not data-only) redraw of the detail view fires periodically regardless of whether anything
// is known to have changed, so any stuck corruption clears itself within this window instead
// of lasting until someone happens to tap it.
const uint32_t DETAIL_FULL_RESYNC_MS = 15000;
const uint32_t CLOUD_BOOTSTRAP_FIRST_TRY_MS = 15000;
const uint32_t CLOUD_BOOTSTRAP_RETRY_MS = 300000;
const uint32_t CLOUD_SYNC_DEFAULT_SECONDS = 60;
// The production default before the 2026-08-23 latency fix. loadCloudConfig() always
// prefers a stored value over the compiled default, so lowering CLOUD_SYNC_DEFAULT_SECONDS
// alone would never reach a receiver that already persisted 300 to /cloud.json - see the
// one-time migration in loadCloudConfig().
const uint32_t CLOUD_SYNC_LEGACY_DEFAULT_SECONDS = 300;
const uint32_t CLOUD_SYNC_SOON_MS = 5000;
// BLE callbacks only touch this RAM ingress ring. A checksum-protected RTC mirror preserves
// it across receiver crashes/resets; cloudSyncTask coalesces many observations into one
// LittleFS transaction instead of synchronously programming flash for every probe wake.
// Sixty-four slots cover well over two minutes at the measured five-sensor ingress rate.
const size_t HISTORY_STAGING_CAPACITY = 64;
const size_t HISTORY_JOURNAL_WRITE_BATCH_SIZE = 32;
// Healthy uploads read directly from the RTC-backed ring, so normal operation performs no
// journal writes at all. These are outage-only spillover limits: commit before the ring fills
// or after two minutes without successful acknowledgement. This removes the measured 29-240ms
// periodic flash pause while still retaining a large, power-safe LittleFS backlog in an outage.
const size_t HISTORY_JOURNAL_FLUSH_RECORDS = 56;
const size_t HISTORY_JOURNAL_EMERGENCY_RECORDS = 60;
const uint32_t HISTORY_JOURNAL_MAX_STAGING_MS = 120000;
const uint32_t HISTORY_FLASH_DISPLAY_QUIET_MS = 100;
const size_t HISTORY_QUEUE_CAPACITY = 8192;
// The backend accepts at most 128 rows. Ninety-six drains the measured ~24-row/minute bench
// load with 4x headroom while retaining stack margin in the 16KB cloud task. Compact uploads
// are streamed a row at a time after TLS connects, so this no longer creates a 30-40KB String.
const size_t HISTORY_UPLOAD_BATCH_SIZE = 96;
// Worst-case MSV3 row now includes the separate temperature-compensated shadow channel.
// The streaming encoder reuses one 480-byte allocation for every row.
const size_t HISTORY_JSON_BYTES_PER_ROW = 480;
const char HISTORY_JOURNAL_PATH[] = "/history-outbox-v1.bin";
const char HISTORY_JOURNAL_COMPACT_PATH[] = "/history-outbox-v1.compact";
const char HISTORY_STATE_A_PATH[] = "/history-outbox-v1-state-a.bin";
const char HISTORY_STATE_B_PATH[] = "/history-outbox-v1-state-b.bin";
const uint32_t HISTORY_JOURNAL_COMPACT_HEAD_BYTES = 65536;
// Deliberately not 30s: config/display pulls also run every 30s, and matching retry
// periods phase-locked a failed history connection directly behind another TLS call.
const uint32_t HISTORY_UPLOAD_RETRY_MS = 17000;
// Absolute floor between the start of one snapshot-upload TLS connection and the next,
// regardless of any backlog nudge below. This intentionally matches the minimum allowed
// by the syncIntervalSeconds clamp so a freshly-queued reading can be nudged forward but
// can never recreate the packet-triggered ~15-35s cadence measured to cause BLE/cloud
// task contention on shared core 0 (see docs/BLE_CLOUD_CONTENTION_FIX_2026-08-11.md).
const uint32_t CLOUD_MIN_UPLOAD_SPACING_MS = 60000;
const uint32_t CLOUD_FULL_SNAPSHOT_INTERVAL_MS = 600000;
// Every cloud operation uses the same TLS client and radio. Space auxiliary pulls away from
// one another so a timer collision cannot launch five handshakes in one cloud-task tick.
const uint32_t CLOUD_NETWORK_MIN_GAP_MS = 15000;
// 2026-08-23 hardening: live /device telemetry caught each failed snapshot-upload attempt
// costing real, unrecovered heap (observed 11-44KB per attempt, before/after readings taken
// around the actual POST call) rather than failing cleanly - a known ESP32 WiFiClientSecure/
// mbedTLS behavior when a TLS connection is attempted but never completes its handshake.
// Below this floor, skip the attempt entirely rather than risk losing more ground - the
// queue is untouched either way, only delayed.
//
// First deployed at 40960 (40KB); a live soak then showed "connection refused" failures at
// freeHeapNow values from 26KB up through 91KB, while successes were ALSO observed across
// that same 26-90KB range (e.g. one success at 90384 with largestFreeBlockBytes=31732,
// immediately followed by a failure at 91436 with an essentially identical largestBlock of
// 31732) - total free heap and largest-free-block do NOT cleanly separate success from
// failure here, so this is very likely not primarily a heap problem, despite the real
// per-attempt heap cost measured separately. Raising this blindly to "be safer" (tried:
// 122880) instead blocked 100% of attempts, because normal steady-state free heap on this
// receiver apparently never climbs that high - worse than the failures it was meant to
// prevent. Left at the original conservative floor pending real evidence of what actually
// distinguishes success from failure (see the sibling-function cleanup fix below for the
// current best lead: TCP/TLS session leakage from OTHER cloud calls, not this one's heap).
//
// 2026-08-26: this guard was only ever checked in runCloudSnapshotUploader(). Live /device
// telemetry caught a real crash (resetReason "panic/exception") with minFreeHeapEverBytes
// down to 7448 bytes on a build that already had the cloud-cleanup-v3 fix - cloudSyncTask()
// calls up to five blocking HTTPClient/WiFiClientSecure functions back-to-back in the same
// 1-second tick whenever their periodic timers land together (config pull and display pull
// share the same 30s interval, so this is routine, not rare). Once the guarded snapshot
// upload passes, the four unguarded calls after it (bootstrap, display settings, config
// pull's 12KB DynamicJsonDocument, auto-cal pull) could still each open a fresh TLS session
// and push heap the rest of the way to empty with nothing left to stop them. Now checked at
// the top of all five, so a low reading during the cascade halts the REST of that tick too,
// not just the first call.
const uint32_t CLOUD_UPLOAD_MIN_SAFE_HEAP_BYTES = 40960;
const uint32_t CLOUD_LOW_HEAP_RETRY_MS = 15000;
// Exponential backoff on CONSECUTIVE upload failures (any cause, not just low-heap skips) -
// the fixed 17s retry alone let five-plus failures in a row hammer a connection that was
// already failing, each one compounding the same heap pressure that caused it. Resets to 0
// on the next success. Capped well below cloudSyncIntervalSeconds's own ceiling so a bad
// patch backs off but still eventually retries on its own.
const uint32_t CLOUD_UPLOAD_BACKOFF_MAX_MS = 180000;
// 2026-10-14: every TLS connect failed for 6.7 h (03:05-10:00 PDT) while WiFi, DNS and the server
// were all healthy, with the largest internal free block pinned at 31,732 bytes, and only a reset
// cleared it (DisplayCenter/docs/RECEIVER_TLS_STALL_2026-10-14.md). After this long with no
// successful upload while WiFi has stayed connected, the receiver restarts itself; queued history
// survives (RTC staging + LittleFS journal). A boot caused by such a restart may not do it again
// until it has been up CLOUD_STALL_RESTART_SPACING_MS, so an internet outage costs at most one
// restart per spacing window, and that boot skips the startup chime.
const uint32_t CLOUD_STALL_RESTART_AFTER_MS = 30UL * 60UL * 1000UL;
const uint32_t CLOUD_STALL_RESTART_SPACING_MS = 6UL * 60UL * 60UL * 1000UL;
const uint32_t CLOUD_STALL_RESTART_MAGIC = 0x544C5352; // "TLSR"
// 2026-08-29: relaxed from 30000 (both) to cut Supabase Edge Function invocations - at 30s
// these two polls alone were ~5,760/day (~173,000/month) from a single receiver, ~38% of the
// free-tier 500,000/month invocation quota. A cloud-pushed config/display change now takes up
// to ~2 minutes to reach the receiver instead of ~30s - confirmed acceptable for how this
// feature is actually used (see chat log). If a future receiver relies on near-real-time
// cloud-pushed display updates, lower this back down rather than removing the tradeoff note.
const uint32_t CLOUD_CONFIG_PULL_INTERVAL_MS = 120000;
const uint32_t CLOUD_DISPLAY_PULL_INTERVAL_MS = 120000;
const uint32_t CLOUD_DISPLAY_FAILURE_BACKOFF_MAX_MS = 300000;
const uint32_t CLOUD_AUTOCAL_PULL_INTERVAL_MS = 600000; // 10 min - learned range/schedule changes slowly
const uint32_t CLOUD_AUTOCAL_RETRY_MS = 30000;
// Cloud HTTP/TLS and BLE scanning intentionally stay off the render/WebServer core.
// BLE gets the higher application-task priority so a due cloud request cannot delay the
// next scan window. The ESP32 BLE host/controller tasks retain their own higher priorities.
const UBaseType_t CLOUD_SYNC_TASK_PRIORITY = 1;
const UBaseType_t BLE_SCAN_TASK_PRIORITY = 2;
// 2026-09-02: stack sizes named rather than inlined at the xTaskCreate call sites, so
// /device can report size alongside high-water and a reader can see the real margin
// instead of having to cross-reference two places. Values unchanged from what was already
// being passed - only the loopTask size below is actually new.
const uint32_t CLOUD_SYNC_TASK_STACK_BYTES = 16384;
const uint32_t BLE_SCAN_TASK_STACK_BYTES = 8192;
// Arduino's loopTask default. It runs the WebServer, display rendering, touch handling and
// WiFi maintenance, and was the only task with no stack telemetry until 2026-09-02.
// Briefly raised to 12288 that day on the theory that sensorDataJson()'s
// StaticJsonDocument<8192> sat on this stack. It does not: ArduinoJson 7 (7.4.3 here)
// allocates JsonDocument on the HEAP, and StaticJsonDocument is only a deprecated alias.
// Measurement then showed loopTask peaking at 3,608 bytes with the default 8192 already
// giving ~56% headroom, so this was reverted - task stacks come out of the same heap that is
// this receiver's real constraint. Left as a named constant so /device can report it.
const uint32_t TREEBEARD_LOOP_TASK_STACK_BYTES = 8192;
const uint8_t WIFI_CONNECT_REBOOT_RETRIES = 2;
const uint32_t WIFI_HEALTH_CHECK_INTERVAL_MS = 1000;
const uint32_t WIFI_RECONNECT_MIN_DELAY_MS = 5000;
const uint32_t WIFI_RECONNECT_MAX_DELAY_MS = 60000;
const uint8_t WIFI_RECONNECT_RADIO_RESET_EVERY = 5;

// Buzzer output on GPIO38 through PCB transistor Q3, driven with LEDC PWM (never left
// continuously high). Duty/envelope numbers are bench-tested on the assembled unit, not
// calculated - see docs/DISPLAY_CENTER_BUZZER_SOUND_DESIGN.md. The replacement buzzer
// soldered onto real units is an unknown-spec passive part (the original TDK piezo did
// not work), so don't "improve" these from a datasheet; they were picked by ear.
const uint8_t BUZZER_PIN = 38;
const uint8_t BUZZER_PWM_RESOLUTION_BITS = 8;
const uint16_t BUZZER_PWM_MAX = (1U << BUZZER_PWM_RESOLUTION_BITS) - 1U;
const uint8_t BUZZER_DUTY_PERCENT = 4; // 8% was audibly harsher/louder on the bench unit
const uint16_t BUZZER_ENVELOPE_MS = 8; // attack/release ramp; suppresses PWM switching clicks
// How often the water-warning re-fires while a plant stays critically low. The bench
// audition looped every 60s indefinitely; shipped behavior is once immediately on the
// critical transition, then hourly until watered, to avoid nagging.
const uint32_t BUZZER_WATER_ALERT_REPEAT_MS = 3600000UL;

struct BuzzerStep
{
  uint16_t frequencyHz;
  uint16_t toneMs;
  uint16_t silenceMs;
};

// Ascending major triad, played once after setup() reaches a ready state.
const BuzzerStep BUZZER_STARTUP_SOUND[] = {
  { 1047, 55, 22 },
  { 1319, 60, 22 },
  { 1568, 115, 0 },
};

// Minimal double buzz; serviceWaterAlert() repeats this 3x with a 350ms gap per alert.
const BuzzerStep BUZZER_WATER_WARNING[] = {
  { 2400, 48, 72 },
  { 2400, 58, 0 },
};

// Keep this first helper below BuzzerStep. Arduino inserts generated prototypes immediately
// before the first .ino function definition; moving a function above this struct makes those
// prototypes refer to BuzzerStep before the type exists (see the preprocessor warning at EOF).
static inline uint8_t moistureScaleVersion(bool wideRaw, bool caplessTank, bool msv4)
{
  if (!wideRaw) return MSV2_MOISTURE_SCALE_VERSION;
  if (msv4) return MSV4_MOISTURE_SCALE_VERSION;
  return caplessTank ? MSV3_CAPLESS_MOISTURE_SCALE_VERSION : MSV3_MOISTURE_SCALE_VERSION;
}

// The stored form of an MSV4 reading's diagnostics (see MSV4_ADV_FLAG2_LAYOUT_B): Cm in 0.1 pF
// in the low half of rawBareTankFdcCounts, Cd in 0.01 pF in the high half. bareTankValid stays
// false so nothing mistakes the word for a tank reference.
static inline uint16_t msv4CmDeciPf(uint32_t packed) { return (uint16_t)(packed & 0xFFFFUL); }
static inline uint16_t msv4CdCentiPf(uint32_t packed) { return (uint16_t)(packed >> 16); }

// The MSV4-only raw fields for the hand-built JSON paths. Rsoil itself is already out as
// raw.fdcCounts and the tip temperature as raw.boardTempQuarterC, which is how they reach the
// existing cloud columns.
static inline uint32_t historyFdcCountsField(uint32_t rawFdcCounts, uint8_t moistureScale)
{
  return moistureScale == MSV4_MOISTURE_SCALE_VERSION ? (rawFdcCounts & MSV4_RSOIL_MASK) : rawFdcCounts;
}

// The 24 packed sweep bytes as 48 lower-case hex digits, NUL-terminated.
static void msv4SweepHex(const uint8_t* sweep, char* out)
{
  static const char digits[] = "0123456789abcdef";
  for (size_t i = 0; i < MSV4_SWEEP_POINT_BYTES; i++)
  {
    out[2 * i] = digits[sweep[i] >> 4];
    out[2 * i + 1] = digits[sweep[i] & 0x0F];
  }
  out[2 * MSV4_SWEEP_POINT_BYTES] = '\0';
}

// The sweep goes out only while it is younger than MSV4_SWEEP_MAX_AGE_MS.
static inline bool msv4SweepSendable(bool valid, uint32_t atMs, uint32_t nowMs)
{
  return valid && (uint32_t)(nowMs - atMs) <= MSV4_SWEEP_MAX_AGE_MS;
}

// sweep is non-null only for the latest-value cache (latestPlants), never for history rows.
static void appendMsv4RawJson(String& output, uint32_t packed, uint8_t fitRmsE4, uint8_t cpDeciPf,
                              bool dieTempValid, int16_t dieTempQuarterC,
                              const uint8_t* sweep = nullptr, uint32_t sweepWake = 0, uint32_t sweepAgeMs = 0)
{
  output += F(",\"msv4\":{\"cmDeciPf\":");
  output += msv4CmDeciPf(packed);
  output += F(",\"fitRmsE4\":");
  output += fitRmsE4;
  if (msv4CdCentiPf(packed) != 0)
  {
    output += F(",\"cdCentiPf\":");
    output += msv4CdCentiPf(packed);
  }
  if (cpDeciPf != 0)
  {
    output += F(",\"cpDeciPf\":");
    output += cpDeciPf;
  }
  if (dieTempValid)
  {
    output += F(",\"dieTempQuarterC\":");
    output += dieTempQuarterC;
  }
  if (sweep != nullptr)
  {
    char hex[2 * MSV4_SWEEP_POINT_BYTES + 1];
    msv4SweepHex(sweep, hex);
    output += F(",\"sweep\":{\"wake\":");
    output += (unsigned long)sweepWake;
    output += F(",\"ageMs\":");
    output += (unsigned long)sweepAgeMs;
    output += F(",\"hex\":\"");
    output += hex;
    output += F("\"}");
  }
  output += '}';
}

static inline uint16_t msv4EncodeDieTemp(bool valid, int16_t quarterC)
{
  return valid ? (uint16_t)(quarterC + MSV4_DIE_TEMP_HISTORY_OFFSET) : 0;
}

static inline bool msv4DecodeDieTemp(uint16_t encoded, int16_t& quarterC)
{
  if (encoded == 0) return false;
  quarterC = (int16_t)((int32_t)encoded - MSV4_DIE_TEMP_HISTORY_OFFSET);
  return true;
}

// The history-record form: the die temperature comes out of the rawMoistureKHz slot and the
// residual out of the top byte of rawFdcCounts. Cp is not kept in history.
static void appendMsv4HistoryRawJson(String& output, uint32_t packed, uint16_t encodedDieTemp,
                                     uint32_t rawFdcCounts)
{
  int16_t dieTempQuarterC = 0;
  const bool dieTempValid = msv4DecodeDieTemp(encodedDieTemp, dieTempQuarterC);
  appendMsv4RawJson(output, packed, (uint8_t)(rawFdcCounts >> 24), 0, dieTempValid, dieTempQuarterC);
}

uint16_t buzzerDutyRaw()
{
  return (uint16_t)((BUZZER_PWM_MAX * BUZZER_DUTY_PERCENT + 50U) / 100U);
}

// Five samples are enough to reject two isolated spikes while adding only four packets
// of warm-up. The center, not either envelope of the noise cloud, feeds the low-pass.
constexpr uint8_t MOISTURE_CENTER_WINDOW = 5;

struct SensorReading
{
  bool seen = false;
  uint32_t wake = 0;
  // Presentation moisture is deliberately separate from the latest real measurement.
  // Every display/web surface uses moisture; measuredMoisture remains untouched by the
  // centered presentation filter and is what the cloud stores in the original history column for
  // diagnostics and auto-calibration. The filter state is receiver-local and therefore
  // applies uniformly to legacy, MSV2 raw-kHz, and MSV3 FDC packet formats.
  uint16_t moisture = 0;
  uint16_t measuredMoisture = 0;
  uint16_t moistureCenterWindow[MOISTURE_CENTER_WINDOW] = {};
  uint8_t moistureCenterCount = 0;
  uint8_t moistureCenterNext = 0;
  // Q8 fixed point prevents a symmetric 1/8 EMA from rounding every small correction
  // toward one side. `moisture` is the rounded integer presentation of this accumulator.
  uint32_t moistureFilteredQ8 = 0;
  // Counts consecutive robust-center readings above the watering threshold. The robust
  // center already needs three of the last five packets to move, and this second gate
  // prevents a short burst from being presented as watering.
  uint8_t moistureWateringStreak = 0;
  // MSV4 drying hold (2026-10-28): millis() since the tracked value has sat above the held
  // display; 0 while it has not. See smoothMoistureForDisplay().
  uint32_t moistureHoldAboveSinceMs = 0;
  uint8_t batteryPercent = BATTERY_UNKNOWN;
  int rssi = 0;
  uint32_t lastSeenMs = 0;
  uint32_t missed = 0;
  uint32_t received = 0;
  uint32_t missedTotal = 0;
  // Raw, uncalibrated values as transmitted by 2026-07-28-rework probes (see
  // calibrateRawMoisture()/calibrateRawBattery()) - kept alongside the calibrated fields
  // above instead of being discarded after use, specifically so the raw sensed signal
  // stays visible for troubleshooting instead of only ever being seen through whatever
  // calibration transform happened to apply. hasRaw is false for probes still on
  // pre-rework firmware (legacy packet, no raw fields to show).
  bool hasRaw = false;
  uint16_t rawMoistureKHz = 0;
  uint16_t rawBatteryMv = 0;
  bool rawCharging = false;
  // 2026-08-22: MSV3's FDC2214 raw reading (~18-22 million on this board) -
  // does not fit in rawMoistureKHz (uint16_t, and that field's own display
  // formatting hardcodes a "kHz" suffix that would be actively wrong for an
  // LC-tank frequency-counter value). wideRaw distinguishes which of the two
  // raw fields is populated; moisture/batteryPercent above are always the
  // calibrated values regardless of which wire format produced them.
  bool wideRaw = false;
  uint32_t rawFdcCounts = 0;
  // 2026-08-25: present only on a >=23-byte MSV3 diagnostic packet (see
  // MSV3_DIAGNOSTIC_PACKET_LEN). Board (die) temperature and bare-tank FDC reference are
  // separate raw observables, NOT a computed/compensated moisture value - never derive or
  // display a "soil temperature" from these here; that interpretation is deliberately deferred
  // to the receiver/cloud side later. validity booleans, not zero, represent an invalid/absent
  // reading, since 0 is itself a plausible raw value for either field.
  bool hasMsv3Diagnostics = false;
  bool boardTempValid = false;
  int16_t rawBoardTempQuarterC = 0;
  bool bareTankValid = false;
  uint32_t rawBareTankFdcCounts = 0;
  // Probe flag bit6. C17 is physically absent and firmware never selects mux code 2/3, so the
  // bare field must be invalid and the capless presentation scale/calibration epoch must be used.
  bool caplessTank = false;
  uint8_t tankPhase = 0;
  // Probe flag bit7: an MSV4 conductance packet. rawFdcCounts is then Rsoil in 0.1 ohm,
  // rawBoardTempQuarterC is the blade-tip NTC, rawBareTankFdcCounts is Cm | Cd << 16
  // (see msv4CmDeciPf()), and tankPhase is 1 on the wake the probe actually measured and 0 on
  // the wakes that repeat that measurement. See MSV4_MOISTURE_SCALE_VERSION.
  bool msv4 = false;
  // MSV4 26-byte packets only: nRF52840 die temperature. Kept apart from rawBoardTempQuarterC,
  // which on an MSV4 is the tip thermistor.
  bool msv4DieTempValid = false;
  int16_t msv4DieTempQuarterC = 0;
  // MSV4 fit RMS residual in 1e-4 of drive, and Cp in 0.1 pF when the packet still carried it
  // (layout A; 0 = not sent). rawFdcCounts above is the resistance alone.
  uint8_t msv4FitRmsE4 = 0;
  uint8_t msv4CpDeciPf = 0;
  // MSV4 raw sweep from the probe's scan response (probe 262172 onward), kept as the 24 packed
  // bytes it arrived as, with the full wake it belongs to and when it arrived. Forwarded to the
  // cloud as raw.msv4.sweep; see handleMsv4SweepScanResponse().
  bool msv4SweepValid = false;
  uint32_t msv4SweepWake = 0;
  uint32_t msv4SweepAtMs = 0;
  uint8_t msv4Sweep[MSV4_SWEEP_POINT_BYTES] = {};
  // Receiver-derived shadow channel. This never overwrites rawFdcCounts or the original
  // measuredMoisture. In Active mode (and only after two accepted daily fits), the equivalent
  // corrected count may feed the presentation filter; cloud history still receives both.
  bool temperatureCompensationValid = false;
  int32_t temperatureCompensatedLogRatioPpm = 0;
  uint16_t temperatureCompensatedEquivalentMoisture = 0;
  uint8_t temperatureCompensationModelVersion = 0;
  uint8_t temperatureCompensationConfiguredMode = TEMPERATURE_COMPENSATION_LEARNING;
  uint8_t temperatureCompensationEffectiveMode = TEMPERATURE_COMPENSATION_LEARNING;
  uint8_t temperatureCompensationConfidencePercent = 0;
  float temperatureCompensationGainPerC = TEMPERATURE_COMPENSATION_DEFAULT_SEED_GAIN_PER_C;
  float temperatureCompensationReferenceC = TEMPERATURE_COMPENSATION_DEFAULT_REFERENCE_C;
  uint32_t temperatureCompensationEpoch = 0;
  // Set when the probe advertised but reported its FDC read as failed (flag bit5), or when
  // the count it sent is implausible. The probe is reachable; the number is not a measurement.
  bool sensorFault = false;
};

// Immutable copy of one unique probe wake as received by BLE. The live sensors[] array
// remains the latest-value cache used by the display; this separate queue prevents each
// new wake from overwriting history before the next cloud snapshot. capturedMs is turned
// into queuedAgeMs at upload time, allowing the Edge Function to reconstruct the actual
// observation timestamp instead of assigning every row in a batch the same server time.
struct PendingHistoryReading
{
  // Stored with the row (rather than read from the current boot) so an observation keeps
  // the same idempotency key after a reset and can safely be uploaded again.
  uint32_t bootId = 0;
  uint32_t sequence = 0;
  uint32_t capturedMs = 0;
  uint64_t observedAtMs = 0;
  uint32_t wake = 0;
  uint32_t rawFdcCounts = 0;
  uint16_t moisture = 0;
  uint16_t measuredMoisture = 0;
  uint16_t rawMoistureKHz = 0;
  // Raw battery voltage/charging-state as sent by the probe, alongside the receiver's own
  // presentation percent above - lets the History chart re-derive/re-tune battery smoothing
  // from the original signal instead of only ever seeing what the receiver's filter baked in
  // at ingest time. Only meaningful when hasRaw is true, same as rawMoistureKHz/rawFdcCounts.
  uint16_t rawBatteryMv = 0;
  bool rawCharging = false;
  int16_t rssi = 0;
  uint8_t sensorId = 0;
  uint8_t moistureScale = MSV2_MOISTURE_SCALE_VERSION;
  uint8_t batteryPercent = BATTERY_UNKNOWN;
  bool hasRaw = false;
  bool wideRaw = false;
  // Same meaning/validity convention as SensorReading's fields of the same name - see there.
  bool hasMsv3Diagnostics = false;
  bool boardTempValid = false;
  int16_t rawBoardTempQuarterC = 0;
  bool bareTankValid = false;
  uint32_t rawBareTankFdcCounts = 0;
  uint8_t tankPhase = 0;
};

// Per-sensor online learner. The 4-term daily regression is:
//   logRatio = intercept + dryDownSlope*timeDays + gain*(Eslow*(Teffective-Tref))
//              + phaseOffset*tankPhase
// A slow moisture baseline keeps the thermal term proportional to the amount of capacitance
// actually present in the pot, while the time term prevents ordinary dry-down from being
// mistaken for temperature response. Two independent 24-hour fits are required before Active
// mode can influence the user-facing value.
struct TemperatureCompensationState
{
  bool emaReady = false;
  float effectiveTempC = TEMPERATURE_COMPENSATION_DEFAULT_REFERENCE_C;
  float slowLogRatio = 0.0f;
  float gainPerC = TEMPERATURE_COMPENSATION_DEFAULT_SEED_GAIN_PER_C;
  float referenceTempC = TEMPERATURE_COMPENSATION_DEFAULT_REFERENCE_C;
  float phaseOffset = TEMPERATURE_COMPENSATION_SEED_PHASE_OFFSET;
  uint32_t lastUpdateMs = 0;
  uint32_t blockStartMs = 0;
  uint32_t restoredBlockElapsedMs = 0;
  uint32_t lastConnectedCounts = 0;
  uint32_t lastBareCounts = 0;
  uint32_t epoch = 0;
  uint32_t sampleCount = 0;
  float minTempC = 1000.0f;
  float maxTempC = -1000.0f;
  double normal[4][4] = {};
  double rhs[4] = {};
  double sumY = 0.0;
  double sumYSquared = 0.0;
  uint8_t acceptedFits = 0;
};

struct TemperatureCompensationResult
{
  bool valid = false;
  int32_t logRatioPpm = 0;
  uint16_t equivalentMoisture = 0;
  uint8_t configuredMode = TEMPERATURE_COMPENSATION_LEARNING;
  uint8_t effectiveMode = TEMPERATURE_COMPENSATION_LEARNING;
  uint8_t confidencePercent = 0;
  float gainPerC = TEMPERATURE_COMPENSATION_DEFAULT_SEED_GAIN_PER_C;
  float referenceTempC = TEMPERATURE_COMPENSATION_DEFAULT_REFERENCE_C;
  uint32_t epoch = 0;
};

// Fixed-version envelope around each append. A checksum lets startup discard only a torn
// power-loss tail instead of treating the whole journal as corrupt. The state is separate
// and double-buffered; losing the newest head update can only replay already-accepted rows,
// which the cloud observation-id uniqueness constraint handles idempotently.
struct HistoryJournalRecord
{
  uint32_t magic = 0;
  uint16_t version = 0;
  uint16_t payloadSize = 0;
  PendingHistoryReading reading;
  uint32_t checksum = 0;
};

struct HistoryJournalState
{
  uint32_t magic = 0;
  uint16_t version = 0;
  uint16_t size = 0;
  uint32_t generation = 0;
  uint32_t headOffset = 0;
  uint32_t dropped = 0;
  uint32_t highWaterMark = 0;
  uint32_t checksum = 0;
};

// RTC slow memory survives watchdog/panic/software resets without touching flash. It closes
// the durability gap introduced by batching LittleFS writes: a crash between commits restores
// the exact ingress ring on the next boot. A cold power loss still relies on the last journal
// commit, as expected for memory that has no independent power source.
struct RtcHistoryStaging
{
  uint32_t magic = 0;
  uint16_t version = 0;
  uint16_t size = 0;
  uint8_t head = 0;
  uint8_t count = 0;
  uint16_t reserved = 0;
  PendingHistoryReading readings[HISTORY_STAGING_CAPACITY];
  uint32_t checksum = 0;
};

// Arduino's sketch preprocessor otherwise emits these prototypes above the custom
// struct definitions, where their parameter types do not exist yet.
uint32_t historyChecksum(const void* data, size_t length);
bool validHistoryJournalRecord(const HistoryJournalRecord& record);
bool validHistoryJournalState(const HistoryJournalState& state);
bool readHistoryJournalState(const char* path, HistoryJournalState& state);
bool persistHistoryJournalState();
bool replaceHistoryJournalPrefix(uint32_t validBytes);
bool enqueueHistoryReading(uint8_t sensorId, const SensorReading& reading);
size_t copyHistoryUploadBatch(PendingHistoryReading* destination, size_t capacity);
size_t acknowledgeHistoryUploadBatch(const PendingHistoryReading* uploaded, size_t count);
bool initializeHistoryJournal();
bool restoreHistoryStagingFromRtc();
void checkpointHistoryStagingToRtcLocked();
void serviceHistoryJournal();
bool compactHistoryJournal();
String historyOutboxJson(const PendingHistoryReading* historyBatch, size_t historyCount);
String historyOutboxPrefixJson(uint32_t serializedAtMs);
void appendHistoryOutboxRowJson(String& output, const PendingHistoryReading& pending,
                                uint32_t serializedAtMs, bool prependComma);
String snapshotJsonWithHistory(const PendingHistoryReading* historyBatch, size_t historyCount);
bool copySensorReading(uint8_t sensorId, SensorReading& destination);
void cacheTemperatureCompensationModes(JsonVariantConst config);
bool loadTemperatureCompensationModes();
bool loadTemperatureCompensationModels();
bool saveTemperatureCompensationModels();
void serviceTemperatureCompensationPersistence();
void resetTemperatureCompensationFit(TemperatureCompensationState& state, uint32_t nowMs);
void resetTemperatureCompensationEpoch(
    TemperatureCompensationState& state, uint8_t sensorId, uint32_t nowMs,
    float boardTempC, float logRatio, uint32_t connectedCounts, uint32_t bareCounts,
    const char* reason);
TemperatureCompensationResult updateTemperatureCompensation(
    uint8_t sensorId, uint32_t connectedCounts, uint32_t bareCounts,
    int16_t boardTempQuarterC, uint8_t tankPhase, uint32_t nowMs,
    bool probeRestarted);

// Cached result of the periodic /autocal cloud pull (see runCloudAutoCalPull) - a
// self-learned moisture range per sensor, replacing manually-guessed dry/wet
// thresholds. "ready" gates whether there's enough history (min sample count + min
// elapsed days, enforced server-side in receiver-snapshot's autocal=1 branch) to trust
// the learned bounds yet; until then, callers should fall back to the manual/default
// thresholds instead of using dryBound/wetBound.
struct AutoCalState
{
  bool ready = false;
  int dryBound = 0;
  int wetBound = 0;
  float daysSinceLastWatering = -1.0f; // informational only - no longer drives any alert
  // Epoch ms of the last detected watering event, -1 if none observed yet. Kept alongside
  // daysSinceLastWatering (a rolling float, blind to calendar-day boundaries) because only
  // a real timestamp lets a client render a correct "today"/"yesterday"/"Nd ago" label in
  // its own local timezone - see MobileAppPage.h's wateredAgoText(). Not consumed by
  // firmware itself, just piped through to the local /data endpoint.
  double lastWateredAtMs = -1.0;
  // Retained for compatibility with older cloud responses. Watering-cycle calibration
  // no longer uses the rolling-percentile floor clamp, so new responses leave this false.
  bool dryBoundTrendingLower = false;
  // 2026-10-11: dryBound/wetBound are the cloud's "water now" region (receiver-snapshot's
  // region.ts, asked for with region=1): wetBound is the level the pot settled at after its
  // last watering and dryBound the top of the region the user waters in. Only then does a card
  // say WATER NOW below 0 %. On the older learned range 0 % was wherever the last waterings
  // happened, and saying so there would be a guess.
  bool region = false;
};

AutoCalState autoCal[MAX_SENSOR_ID + 1];
bool copyAutoCalState(uint8_t sensorId, AutoCalState& destination);
bool loadAutoCalCache();
bool saveAutoCalCache();

#if TREEBEARD_ENABLE_DISPLAY
const int TFT_SCK = 12;
const int TFT_MOSI = 13;
const int TOUCH_IRQ = 7;
const int TOUCH_MISO = 8;
const int TOUCH_CS = 9;
const int TFT_MISO = 10; // Wired for optional ST7796S reads; runtime SPI input uses TOUCH_MISO.
const int TFT_BACKLIGHT = 11;
const int TFT_DC = 14;
const int TFT_RST = 15;
const int TFT_CS = 16;
const uint32_t BACKLIGHT_PWM_FREQUENCY_HZ = 1000;
const uint8_t BACKLIGHT_PWM_RESOLUTION_BITS = 10;
const uint16_t BACKLIGHT_PWM_MAX = (1U << BACKLIGHT_PWM_RESOLUTION_BITS) - 1;
const uint8_t DEFAULT_BRIGHTNESS_PERCENT = 75;
// XPT2046_Touchscreen's polling-mode update() (see the comment on touchScreen below)
// performs a real SPI transaction on every touched() call, forever, whether or not a
// finger is present - this is new bus traffic since touch was added, interleaved with
// display writes on every loop() iteration. Widened from 16ms to reduce how often the
// bus switches devices per second; still comfortably responsive for a slider drag (30Hz).
const uint32_t TOUCH_POLL_INTERVAL_MS = 32;
// 2026-08-30 gesture redesign: open the receiver brightness controls with a long-press
// (hold, no lift) anywhere on the dashboard, replacing the old double-tap-anywhere gesture.
// The double-tap version required this resistive panel to reliably tell "two clean release
// events" apart from ordinary contact bounce, which it did not do well in practice (field
// report: it mostly just registered as a single tap on whatever plant card it landed on).
// A long-press only needs "is a contact still present", which this hardware handles far
// more reliably - no second-touch coordination, no bounce-as-second-tap risk. This also
// lets a genuine short tap on a plant card act immediately (see handleTouchInput()) instead
// of every tap being deferred for up to 650ms (the old double-tap window) to see if a second
// one followed - that mandatory wait, with no tap-feedback on screen, was the leading suspect
// for taps "freezing" rather than opening a card's diagnostic view.
const uint32_t TOUCH_LONG_PRESS_MS = 550;
// 2026-08-30, same-day follow-up: a raw touch-up sample is not immediately trusted as a real
// release - handleTouchInput() requires it to hold for this long first. Removing the old
// double-tap design's 650ms deferral (above) made ordinary taps instant, but that deferral
// had also been absorbing resistive-panel contact bounce as a side effect the whole time -
// this codebase's own prior comment on the removed TOUCH_DOUBLE_TAP_MIN_GAP_MS said bounce on
// this exact panel can span up to ~120ms between release events. Without an equivalent
// safeguard, a single physical tap could fire the tap/collapse action 2-3 times in rapid
// succession, corrupting the expand/collapse sequence (confirmed field symptom: a card stuck
// half-drawn, or a tap silently toggling back to its prior state). 160ms = the ~120ms bounce
// ceiling plus one TOUCH_POLL_INTERVAL_MS (32ms) of polling-phase margin, rounded up - still
// far below the old 650ms, so a genuine tap still feels immediate.
const uint32_t TOUCH_RELEASE_STABLE_MS = 160;
// 2026-08-30 IRQ-primary redesign, phone-a-friend consultation "display-touch-corruption-
// 2026-08-30": confirmed by isolation test (touch SPI fully disabled -> zero card-art
// corruption over an extended watch) that touch SPI transactions during active gestures, not
// idle polling, are the actual corruption trigger. The gesture logic above (long-press hold +
// release-stability) was correct in shape but implemented by re-calling touchScreen.touched()
// every TOUCH_POLL_INTERVAL_MS the whole time a finger was down or just lifted - a plain tap
// cost 5-20+ SPI transactions clustered right around the TFT writes that follow. handleTouchInput
// now treats the T_IRQ GPIO level (free, no SPI) as the primary down/up signal and only spends a
// real SPI transaction (touchScreen.getPoint()) when coordinates are actually needed: once per
// gesture at the confirmed initial press, and repeatedly only while actively dragging the
// brightness slider. This constant is the settle window enforced after every such SPI read,
// on both the down and release side, before trusting the T_IRQ level again - XPT2046's PENIRQ
// can glitch/deassert during and immediately after a conversion (this is documented ADC
// behavior, not a hardware fault), so a release must never be evaluated from a GPIO sample
// taken inside this window. Value = TOUCH_POLL_INTERVAL_MS (one full poll's worth of margin).
const uint32_t TOUCH_POST_SPI_BLACKOUT_MS = 32;
const int TOUCH_TARGET_MARGIN = 48;
// Arduino_GFX defaults an ESP32 SPI bus to 40MHz. That was fine when the ST7796S was the
// only device on the bus; now XPT2046 is electrically tapped onto the same SCK/MOSI traces
// (deselected via TOUCH_CS between reads, but still an extra chip's input capacitance on
// the line). Dropped 40MHz -> 20MHz -> 10MHz; neither step fixed the reported animation-art
// corruption (stray colored pixels, "two frames superimposed" look), which is evidence
// against a purely clock-speed-driven signal integrity cause. Left at 10MHz since it's still
// a reasonable margin and isn't implicated as having made anything worse. See
// docs/DISPLAY_ANIMATION_ART_CORRUPTION_2026-08-12.md for the full investigation - this bug
// is UNRESOLVED, do not assume this constant is the fix.
const uint32_t DISPLAY_SPI_HZ = 10000000;

uint16_t color565(uint8_t r, uint8_t g, uint8_t b)
{
  return ((r & 0xF8) << 8) | ((g & 0xFC) << 3) | (b >> 3);
}

// Every full-screen state (WiFi setup/calibration/error screens) and the touch overlay
// draw against this fixed palette instead of the ui.json theme, since it renders before
// - or on top of - ui.json is loaded. Values are the exact web dashboard tokens
// (web/plant-dashboard/index.html :root) so the physical display never looks like a
// different app from the PWA and the themed plant cards in renderUi().
const uint16_t TFT_BLACK = color565(0x0E, 0x14, 0x1B);    // --bg
const uint16_t TFT_SURFACE = color565(0x17, 0x21, 0x2B);  // --panel
const uint16_t TFT_SURFACE_2 = color565(0x1D, 0x2A, 0x35); // --panel-2, nested controls
const uint16_t TFT_MUTED = color565(0x8F, 0xA3, 0xAD);    // --muted
const uint16_t TFT_WHITE = color565(0xF5, 0xF7, 0xFA);    // --ink
const uint16_t TFT_DANGER = color565(0xFF, 0x5A, 0x5F);   // --danger
const uint16_t TFT_ACCENT = color565(0x20, 0xC9, 0x97);   // --accent
const uint16_t TFT_WARNING = color565(0xFF, 0xB0, 0x20);  // --warn

Arduino_DataBus* busPtr = nullptr;
Arduino_GFX* gfxPtr = nullptr;
SPIClass displaySpi(FSPI);
// Poll pressure over SPI instead of allowing the library to gate all reads behind T_IRQ.
// This board exposes T_IRQ for diagnostics, but a missed/floating IRQ edge otherwise leaves
// XPT2046_Touchscreen's isrWake false forever and makes every later touch look absent.
XPT2046_Touchscreen touchScreen(TOUCH_CS);
#endif
#if TREEBEARD_ENABLE_WIFI
WebServer* serverPtr = nullptr;
DNSServer* dnsServerPtr = nullptr;
#endif
#if TREEBEARD_ENABLE_BLE
BLEScan* bleScan = nullptr;
// The scan's callbacks, kept so the scan task can hand them the reports a session still holds;
// see BleScanFlush.h.
BLEAdvertisedDeviceCallbacks* bleScanCallbacks = nullptr;
TaskHandle_t bleScanTaskHandle = nullptr;
volatile bool cloudRadioExclusive = false;
// 2026-08-31 diagnostic, live-hardware investigation into intermittent snapshot-upload
// "connection refused" failures: cloudSyncTask runs at a deliberately LOWER FreeRTOS priority
// than bleScanTask (see CLOUD_SYNC_TASK_PRIORITY's own comment - intentional, so cloud work
// can never delay a BLE scan window) on the same core, and the BLE host/controller tasks
// underneath both of them run higher still. beginCloudRadioSlot() calls bleScan->stop() and
// waits a fixed 75ms before letting the cloud task proceed, on the assumption that's enough
// time for any in-flight scan to actually quiesce - these fields capture whether that
// assumption held on each real attempt, correlated against that attempt's upload outcome via
// /cloud's own lastAttemptMs, without changing any actual scheduling/timing behavior.
uint32_t lastRadioSlotAtMs = 0;
bool lastRadioSlotWasScanning = false;
bool lastRadioSlotStillScanningAfterSettle = false;
uint32_t lastRadioSlotStopCallMs = 0;
#endif
SensorReading sensors[MAX_SENSOR_ID + 1];
TemperatureCompensationState temperatureCompensation[MAX_SENSOR_ID + 1];
uint8_t temperatureCompensationMode[MAX_SENSOR_ID + 1];
volatile bool temperatureCompensationPersistPending = false;
volatile bool temperatureCompensationPersistUrgent = false;
uint32_t lastTemperatureCompensationPersistMs = 0;
PendingHistoryReading pendingHistory[HISTORY_STAGING_CAPACITY];
uint8_t pendingHistoryHead = 0;
uint8_t pendingHistoryCount = 0;
uint32_t pendingHistoryOldestStagedAtMs = 0;
RTC_NOINIT_ATTR RtcHistoryStaging rtcHistoryStaging;
size_t durableHistoryCount = 0;
uint32_t historyJournalHeadOffset = 0;
uint32_t historyJournalValidBytes = 0;
uint32_t historyJournalStateGeneration = 0;
bool historyJournalReady = false;
uint32_t historyJournalStorageErrors = 0;
// Latest outage-spill journal cost. Healthy uploads bypass LittleFS and acknowledge the
// RTC-backed ring directly, so these values should remain unchanged during ordinary online
// operation; they expose the rarer flash cost when WiFi/backend downtime forces spillover.
uint32_t lastJournalWriteAtMs = 0;
uint32_t lastJournalWriteDurationMs = 0;
uint32_t lastJournalWriteRecords = 0;
uint32_t lastJournalCompactDurationMs = 0;
bool lastJournalCompactedThisWrite = false;
uint32_t pendingHistorySequence = 0;
uint32_t pendingHistoryDropped = 0;
uint32_t pendingHistoryHighWaterMark = 0;
uint32_t historyQueueBootId = 0;
uint64_t cloudTimeAnchorEpochMs = 0;
uint32_t cloudTimeAnchorMillis = 0;
portMUX_TYPE historyQueueMux = portMUX_INITIALIZER_UNLOCKED;
// Guards every sensors[] read/write. Readers take a short value copy and release the
// lock before rendering or JSON allocation; the BLE callback publishes one complete
// record while holding the same lock. This prevents logical packet tearing without
// keeping interrupts disabled around slow display/network operations.
portMUX_TYPE sensorsMux = portMUX_INITIALIZER_UNLOCKED;
// Model persistence/config changes run on the main/cloud tasks while BLE updates the learner.
// Copy state under this short lock, do floating-point work outside it, then publish atomically.
portMUX_TYPE temperatureCompensationMux = portMUX_INITIALIZER_UNLOCKED;
// runCloudAutoCalPull() writes on the cloud task while rendering, /data serialization,
// and BLE presentation filtering read on other tasks/cores. Treat each state as one
// record for the same reason as sensors[].
portMUX_TYPE autoCalMux = portMUX_INITIALIZER_UNLOCKED;

// ---- Bench probe table -------------------------------------------------------------------
//
// Written by parseBenchAdvertisement() on the BLE scan task, read by the Bench page on
// loopTask. Same one-record-under-one-short-lock discipline as sensors[], and for the same
// reason: a half-updated row would render a count from one packet beside a wake counter from
// another and look exactly like a real measurement discontinuity.
//
// Kept entirely separate from sensors[] by design - see MSV3_BENCH_MAGIC's comment.
struct BenchProbe
{
  bool seen;
  uint8_t sensorId;          // 99 on an untargeted bring-up build, the fleet id on a targeted one
  uint32_t wake;
  uint32_t fdcCounts;
  bool readingValid;         // false = the probe advertised a placeholder, not a measurement
  uint16_t batteryMv;
  bool charging;
  bool otaPowerOk;
  bool liveMode;             // probe is in `bench on`, refreshing ~4x/s
  bool boardTempValid;
  int16_t boardTempQuarterC;
  uint8_t formatVersion;     // 0 = pre-versioning bench firmware; mux/status below are absent
  uint8_t muxCode;
  uint16_t fdcStatus;
  int rssi;
  uint32_t lastSeenMs;
  uint32_t received;
};
BenchProbe benchProbes[BENCH_SLOT_COUNT];
portMUX_TYPE benchMux = portMUX_INITIALIZER_UNLOCKED;
// Set by the BLE task when any bench row changes. The /bench web page polls rather than
// subscribing, so nothing in firmware consumes this today; it is kept because it is the natural
// hook for a future push/SSE endpoint and costs one byte.
volatile bool benchDataDirty = false;

// Manual prototypes for every bench function whose signature names the struct above.
// REQUIRED, not stylistic: the .ino preprocessor inserts auto-generated prototypes immediately
// before the file's first function definition (color565(), far above these declarations), so an
// auto-generated one would reference BenchProbe before it exists and fail to compile. Declaring them here suppresses that generation - the same reason the PlantArtSlot
// prototype block further down exists. See this file's closing comment for the full account.
void benchSnapshotAll(BenchProbe* out);
bool benchSlotIsFresh(const BenchProbe& probe, uint32_t nowMs);

#if TREEBEARD_ENABLE_DISPLAY
// Defined with the rest of the touch/display state below. Journal commits avoid an active
// touch acquisition and the short post-render SPI settling window whenever capacity permits.
extern volatile bool touchAcquisitionPending;
extern volatile uint32_t lastDisplaySpiActivityMs;
#endif

bool copySensorReading(uint8_t sensorId, SensorReading& destination)
{
  if (sensorId == 0 || sensorId > MAX_SENSOR_ID)
  {
    return false;
  }
  portENTER_CRITICAL(&sensorsMux);
  destination = sensors[sensorId];
  portEXIT_CRITICAL(&sensorsMux);
  return true;
}

bool copyAutoCalState(uint8_t sensorId, AutoCalState& destination)
{
  if (sensorId == 0 || sensorId > MAX_SENSOR_ID)
  {
    return false;
  }
  portENTER_CRITICAL(&autoCalMux);
  destination = autoCal[sensorId];
  portEXIT_CRITICAL(&autoCalMux);
  return true;
}

static_assert(HISTORY_UPLOAD_BATCH_SIZE <= HISTORY_QUEUE_CAPACITY,
              "history upload batch must fit inside the receiver queue");
static_assert(sizeof(PendingHistoryReading) * HISTORY_UPLOAD_BATCH_SIZE <= 8192,
              "history upload batch must leave margin on the cloud task stack");
static_assert(HISTORY_JOURNAL_WRITE_BATCH_SIZE <= HISTORY_STAGING_CAPACITY,
              "journal write batch must fit inside the staging ring");
static_assert(sizeof(RtcHistoryStaging) <= 6144,
              "RTC history staging must leave room for reset checkpoints");

const uint32_t HISTORY_RECORD_MAGIC = 0x31545348UL; // "HST1" little-endian
const uint32_t HISTORY_STATE_MAGIC = 0x31535348UL;  // "HSS1" little-endian
const uint32_t HISTORY_RTC_MAGIC = 0x31525448UL;    // "HTR1" little-endian
const uint16_t HISTORY_JOURNAL_VERSION = 1;

uint32_t historyChecksum(const void* data, size_t length)
{
  // FNV-1a is compact and sufficient here: this is torn-write/corruption detection, not
  // authentication. Authentication remains the receiver bearer token over TLS.
  const uint8_t* bytes = static_cast<const uint8_t*>(data);
  uint32_t hash = 2166136261UL;
  for (size_t i = 0; i < length; i++)
  {
    hash ^= bytes[i];
    hash *= 16777619UL;
  }
  return hash;
}

void checkpointHistoryStagingToRtcLocked()
{
  // checksum is written last. If a reset interrupts this copy, restore rejects the partial
  // mirror instead of replaying a mixture of old and new ring state.
  rtcHistoryStaging.magic = HISTORY_RTC_MAGIC;
  rtcHistoryStaging.version = HISTORY_JOURNAL_VERSION;
  rtcHistoryStaging.size = sizeof(RtcHistoryStaging);
  rtcHistoryStaging.head = pendingHistoryHead;
  rtcHistoryStaging.count = pendingHistoryCount;
  rtcHistoryStaging.reserved = 0;
  for (size_t i = 0; i < HISTORY_STAGING_CAPACITY; i++)
  {
    rtcHistoryStaging.readings[i] = pendingHistory[i];
  }
  rtcHistoryStaging.checksum = historyChecksum(
      &rtcHistoryStaging, offsetof(RtcHistoryStaging, checksum));
}

bool restoreHistoryStagingFromRtc()
{
  const bool valid = rtcHistoryStaging.magic == HISTORY_RTC_MAGIC &&
                     rtcHistoryStaging.version == HISTORY_JOURNAL_VERSION &&
                     rtcHistoryStaging.size == sizeof(RtcHistoryStaging) &&
                     rtcHistoryStaging.head < HISTORY_STAGING_CAPACITY &&
                     rtcHistoryStaging.count <= HISTORY_STAGING_CAPACITY &&
                     rtcHistoryStaging.checksum == historyChecksum(
                         &rtcHistoryStaging, offsetof(RtcHistoryStaging, checksum));

  portENTER_CRITICAL(&historyQueueMux);
  pendingHistoryHead = 0;
  pendingHistoryCount = 0;
  memset(pendingHistory, 0, sizeof(pendingHistory));
  if (valid)
  {
    pendingHistoryHead = rtcHistoryStaging.head;
    pendingHistoryCount = rtcHistoryStaging.count;
    for (size_t i = 0; i < HISTORY_STAGING_CAPACITY; i++)
    {
      pendingHistory[i] = rtcHistoryStaging.readings[i];
    }
    // capturedMs belongs to the previous boot's millis() epoch. Start a fresh spill timer
    // instead of interpreting that timestamp against this boot and forcing an immediate
    // flash commit during startup.
    pendingHistoryOldestStagedAtMs = pendingHistoryCount > 0 ? millis() : 0;
  }
  else
  {
    memset(&rtcHistoryStaging, 0, sizeof(rtcHistoryStaging));
    pendingHistoryOldestStagedAtMs = 0;
  }
  checkpointHistoryStagingToRtcLocked();
  portEXIT_CRITICAL(&historyQueueMux);

  if (valid && pendingHistoryCount > 0)
  {
    Serial.print("[Treebeard history] restored RTC-staged rows=");
    Serial.println(pendingHistoryCount);
  }
  return valid;
}

bool loadAutoCalCache()
{
  File file = LittleFS.open(AUTOCAL_CACHE_PATH, FILE_READ);
  if (!file)
  {
    return false;
  }
  DynamicJsonDocument doc(2048);
  DeserializationError error = deserializeJson(doc, file);
  file.close();
  if (error || (doc["schema"] | 0) != 1)
  {
    return false;
  }

  AutoCalState restored[MAX_SENSOR_ID + 1];
  JsonArray ranges = doc["ranges"].as<JsonArray>();
  for (JsonObject row : ranges)
  {
    uint16_t sensorId = row["sensor"] | 0;
    if (sensorId == 0 || sensorId > MAX_SENSOR_ID)
    {
      continue;
    }
    const int dry = row["dry"] | 0;
    const int wet = row["wet"] | 0;
    const bool ready = row["ready"] | false;
    restored[sensorId].ready = ready && dry >= 0 && wet > dry && wet <= 65535;
    restored[sensorId].dryBound = dry;
    restored[sensorId].wetBound = wet;
    restored[sensorId].dryBoundTrendingLower = row["trend"] | false;
    restored[sensorId].region = row["region"] | false;
  }

  portENTER_CRITICAL(&autoCalMux);
  for (uint8_t sensorId = 1; sensorId <= MAX_SENSOR_ID; sensorId++)
  {
    autoCal[sensorId] = restored[sensorId];
  }
  portEXIT_CRITICAL(&autoCalMux);
  Serial.println("[Treebeard cloud] restored cached auto-calibration ranges");
  return true;
}

bool saveAutoCalCache()
{
  DynamicJsonDocument doc(2048);
  doc["schema"] = 1;
  JsonArray ranges = doc.createNestedArray("ranges");
  for (uint8_t sensorId = 1; sensorId <= MAX_SENSOR_ID; sensorId++)
  {
    AutoCalState learned;
    copyAutoCalState(sensorId, learned);
    JsonObject row = ranges.createNestedObject();
    row["sensor"] = sensorId;
    row["ready"] = learned.ready;
    row["dry"] = learned.dryBound;
    row["wet"] = learned.wetBound;
    row["trend"] = learned.dryBoundTrendingLower;
    row["region"] = learned.region;
  }

  String nextJson;
  serializeJson(doc, nextJson);
  if (LittleFS.exists(AUTOCAL_CACHE_PATH))
  {
    File current = LittleFS.open(AUTOCAL_CACHE_PATH, FILE_READ);
    if (current)
    {
      String currentJson = current.readString();
      current.close();
      if (currentJson == nextJson)
      {
        return true;
      }
    }
  }

  File temp = LittleFS.open(AUTOCAL_CACHE_TEMP_PATH, FILE_WRITE);
  if (!temp)
  {
    return false;
  }
  const bool complete = temp.print(nextJson) == nextJson.length();
  temp.flush();
  temp.close();
  if (!complete)
  {
    LittleFS.remove(AUTOCAL_CACHE_TEMP_PATH);
    return false;
  }
  LittleFS.remove(AUTOCAL_CACHE_PATH);
  if (!LittleFS.rename(AUTOCAL_CACHE_TEMP_PATH, AUTOCAL_CACHE_PATH))
  {
    LittleFS.remove(AUTOCAL_CACHE_TEMP_PATH);
    return false;
  }
  return true;
}

const char* temperatureCompensationModeName(uint8_t mode)
{
  if (mode == TEMPERATURE_COMPENSATION_ACTIVE) return "active";
  if (mode == TEMPERATURE_COMPENSATION_LEARNING) return "learning";
  return "off";
}

uint8_t parseTemperatureCompensationMode(const char* value)
{
  if (value != nullptr && strcmp(value, "active") == 0) return TEMPERATURE_COMPENSATION_ACTIVE;
  if (value != nullptr && strcmp(value, "off") == 0) return TEMPERATURE_COMPENSATION_OFF;
  return TEMPERATURE_COMPENSATION_LEARNING;
}

float temperatureCompensationSeedGain(uint8_t sensorId)
{
  // Both seeds are zero since v3, so this is currently a no-op kept for shape: a probe with a
  // genuinely measured per-probe gain could be seeded here. It must never be used to hand a
  // probe a fleet-average gain, because the sign is not a fleet property. Probe 4 fits about
  // +0.013 and probe 8 about -0.004 in the same week, and v2 shipping probe 8 a positive seed
  // it could never fit its way out of is the exact defect v3 exists to fix.
  return sensorId == 4
      ? TEMPERATURE_COMPENSATION_PROBE_4_SEED_GAIN_PER_C
      : TEMPERATURE_COMPENSATION_DEFAULT_SEED_GAIN_PER_C;
}

float temperatureCompensationSeedReferenceC(uint8_t sensorId)
{
  return sensorId == 4
      ? TEMPERATURE_COMPENSATION_PROBE_4_REFERENCE_C
      : TEMPERATURE_COMPENSATION_DEFAULT_REFERENCE_C;
}

void cacheTemperatureCompensationModes(JsonVariantConst config)
{
  uint8_t nextModes[MAX_SENSOR_ID + 1];
  for (uint8_t sensorId = 0; sensorId <= MAX_SENSOR_ID; sensorId++)
  {
    // Shadow learning is safe for existing configurations because it never changes the
    // presentation value. Users must explicitly choose Active before it can do so.
    nextModes[sensorId] = TEMPERATURE_COMPENSATION_LEARNING;
  }

  JsonArrayConst cards = config["cards"].as<JsonArrayConst>();
  for (JsonObjectConst card : cards)
  {
    uint8_t sensorId = card["sensor"] | 0;
    if (sensorId == 0 || sensorId > MAX_SENSOR_ID) continue;
    JsonObjectConst moisture = card["moisture"].as<JsonObjectConst>();
    nextModes[sensorId] = parseTemperatureCompensationMode(
        moisture["temperatureCompensation"] | "learning");
  }

  portENTER_CRITICAL(&temperatureCompensationMux);
  memcpy(temperatureCompensationMode, nextModes, sizeof(nextModes));
  portEXIT_CRITICAL(&temperatureCompensationMux);
}

bool loadTemperatureCompensationModes()
{
  portENTER_CRITICAL(&temperatureCompensationMux);
  for (uint8_t sensorId = 0; sensorId <= MAX_SENSOR_ID; sensorId++)
  {
    temperatureCompensationMode[sensorId] = TEMPERATURE_COMPENSATION_LEARNING;
  }
  portEXIT_CRITICAL(&temperatureCompensationMux);
  File file = LittleFS.open(UI_PATH, FILE_READ);
  if (!file)
  {
    return false;
  }
  DynamicJsonDocument doc(12288);
  DeserializationError error = deserializeJson(doc, file);
  file.close();
  if (error) return false;
  cacheTemperatureCompensationModes(doc.as<JsonVariantConst>());
  return true;
}

bool loadTemperatureCompensationModels()
{
  File file = LittleFS.open(TEMPERATURE_COMPENSATION_CACHE_PATH, FILE_READ);
  if (!file) return false;
  DynamicJsonDocument doc(24576);
  DeserializationError error = deserializeJson(doc, file);
  file.close();
  if (error || (doc["schema"] | 0) != TEMPERATURE_COMPENSATION_MODEL_VERSION) return false;

  size_t restored = 0;
  JsonArray models = doc["models"].as<JsonArray>();
  for (JsonObject row : models)
  {
    uint8_t sensorId = row["sensor"] | 0;
    float gain = row["gainPerC"] | temperatureCompensationSeedGain(sensorId);
    float referenceTempC = row["referenceTempC"] |
        temperatureCompensationSeedReferenceC(sensorId);
    float phaseOffset = row["phaseOffset"] | TEMPERATURE_COMPENSATION_SEED_PHASE_OFFSET;
    float effectiveTempC = row["effectiveTempC"] |
        temperatureCompensationSeedReferenceC(sensorId);
    float slowLogRatio = row["slowLogRatio"] | 0.0f;
    uint8_t acceptedFits = row["acceptedFits"] | 0;
    bool emaReady = row["emaReady"] | false;
    uint32_t epoch = row["epoch"] | 0;
    uint32_t blockElapsedMs = row["blockElapsedMs"] | 0;
    uint32_t sampleCount = row["sampleCount"] | 0;
    uint32_t lastConnectedCounts = row["lastConnectedCounts"] | 0;
    uint32_t lastBareCounts = row["lastBareCounts"] | 0;
    float minTempC = row["minTempC"] | 1000.0f;
    float maxTempC = row["maxTempC"] | -1000.0f;
    double sumY = row["sumY"] | 0.0;
    double sumYSquared = row["sumYSquared"] | 0.0;
    if (sensorId == 0 || sensorId > MAX_SENSOR_ID || !isfinite(gain) ||
        gain < TEMPERATURE_COMPENSATION_MIN_GAIN_PER_C || gain > 0.04f ||
        !isfinite(referenceTempC) || referenceTempC < -40.0f || referenceTempC > 85.0f ||
        !isfinite(phaseOffset) || fabsf(phaseOffset) > 0.01f ||
        !isfinite(effectiveTempC) || effectiveTempC < -40.0f || effectiveTempC > 85.0f ||
        !isfinite(slowLogRatio) || slowLogRatio < -0.2f || slowLogRatio > 1.0f ||
        blockElapsedMs > TEMPERATURE_COMPENSATION_FIT_BLOCK_MS ||
        sampleCount > 100000UL || (sampleCount > 0 && !emaReady) ||
        (sampleCount > 0 && (lastConnectedCounts == 0 || lastConnectedCounts > 0x0FFFFFFFUL ||
                             lastBareCounts == 0 || lastBareCounts > 0x0FFFFFFFUL ||
                             !isfinite(minTempC) || !isfinite(maxTempC) ||
                             minTempC < -40.0f || maxTempC > 85.0f || minTempC > maxTempC)) ||
        !isfinite(sumY) || !isfinite(sumYSquared))
    {
      continue;
    }
    double normal[4][4] = {};
    double rhs[4] = {};
    bool partialValid = true;
    if (sampleCount > 0)
    {
      JsonArray normalValues = row["normal"].as<JsonArray>();
      JsonArray rhsValues = row["rhs"].as<JsonArray>();
      partialValid = normalValues.size() == 16 && rhsValues.size() == 4;
      for (uint8_t i = 0; partialValid && i < 16; i++)
      {
        const double value = normalValues[i].as<double>();
        if (!isfinite(value)) partialValid = false;
        else normal[i / 4][i % 4] = value;
      }
      for (uint8_t i = 0; partialValid && i < 4; i++)
      {
        const double value = rhsValues[i].as<double>();
        if (!isfinite(value)) partialValid = false;
        else rhs[i] = value;
      }
    }
    if (!partialValid) continue;

    portENTER_CRITICAL(&temperatureCompensationMux);
    TemperatureCompensationState& state = temperatureCompensation[sensorId];
    state.gainPerC = gain;
    state.referenceTempC = referenceTempC;
    state.phaseOffset = phaseOffset;
    state.effectiveTempC = effectiveTempC;
    state.slowLogRatio = slowLogRatio;
    state.acceptedFits = acceptedFits;
    state.emaReady = emaReady;
    state.epoch = max(1UL, epoch);
    state.restoredBlockElapsedMs = sampleCount > 0 ? blockElapsedMs : 0;
    state.sampleCount = sampleCount;
    state.lastConnectedCounts = lastConnectedCounts;
    state.lastBareCounts = lastBareCounts;
    state.minTempC = sampleCount > 0 ? minTempC : 1000.0f;
    state.maxTempC = sampleCount > 0 ? maxTempC : -1000.0f;
    memcpy(state.normal, normal, sizeof(normal));
    memcpy(state.rhs, rhs, sizeof(rhs));
    state.sumY = sumY;
    state.sumYSquared = sumYSquared;
    // millis() starts a new epoch after reset. Re-anchor the saved elapsed duration on the
    // first new sample; do not count the unobserved outage as training time or EMA input.
    state.lastUpdateMs = 0;
    state.blockStartMs = 0;
    portEXIT_CRITICAL(&temperatureCompensationMux);
    restored++;
  }
  if (restored > 0)
  {
    Serial.print("[Treebeard temp-comp] restored models=");
    Serial.println(restored);
  }
  return restored > 0;
}

bool saveTemperatureCompensationModels()
{
  const uint32_t nowMs = millis();
  DynamicJsonDocument doc(24576);
  doc["schema"] = TEMPERATURE_COMPENSATION_MODEL_VERSION;
  JsonArray models = doc.createNestedArray("models");
  for (uint8_t sensorId = 1; sensorId <= MAX_SENSOR_ID; sensorId++)
  {
    TemperatureCompensationState state;
    portENTER_CRITICAL(&temperatureCompensationMux);
    state = temperatureCompensation[sensorId];
    portEXIT_CRITICAL(&temperatureCompensationMux);
    if (!state.emaReady && state.acceptedFits == 0) continue;
    JsonObject row = models.createNestedObject();
    row["sensor"] = sensorId;
    row["gainPerC"] = state.gainPerC;
    row["referenceTempC"] = state.referenceTempC;
    row["phaseOffset"] = state.phaseOffset;
    row["effectiveTempC"] = state.effectiveTempC;
    row["slowLogRatio"] = state.slowLogRatio;
    row["acceptedFits"] = state.acceptedFits;
    row["emaReady"] = state.emaReady;
    row["epoch"] = state.epoch;
    row["blockElapsedMs"] = state.blockStartMs != 0
        ? (uint32_t)(nowMs - state.blockStartMs)
        : state.restoredBlockElapsedMs;
    row["sampleCount"] = state.sampleCount;
    row["lastConnectedCounts"] = state.lastConnectedCounts;
    row["lastBareCounts"] = state.lastBareCounts;
    row["minTempC"] = state.minTempC;
    row["maxTempC"] = state.maxTempC;
    row["sumY"] = state.sumY;
    row["sumYSquared"] = state.sumYSquared;
    JsonArray normalValues = row.createNestedArray("normal");
    JsonArray rhsValues = row.createNestedArray("rhs");
    for (uint8_t r = 0; r < 4; r++)
    {
      for (uint8_t c = 0; c < 4; c++) normalValues.add(state.normal[r][c]);
      rhsValues.add(state.rhs[r]);
    }
  }
  if (doc.overflowed()) return false;

  File temp = LittleFS.open(TEMPERATURE_COMPENSATION_CACHE_TEMP_PATH, FILE_WRITE);
  if (!temp) return false;
  const size_t written = serializeJson(doc, temp);
  temp.flush();
  temp.close();
  if (written == 0)
  {
    LittleFS.remove(TEMPERATURE_COMPENSATION_CACHE_TEMP_PATH);
    return false;
  }
  LittleFS.remove(TEMPERATURE_COMPENSATION_CACHE_PATH);
  if (!LittleFS.rename(TEMPERATURE_COMPENSATION_CACHE_TEMP_PATH,
                       TEMPERATURE_COMPENSATION_CACHE_PATH))
  {
    LittleFS.remove(TEMPERATURE_COMPENSATION_CACHE_TEMP_PATH);
    return false;
  }
  return true;
}

void serviceTemperatureCompensationPersistence()
{
  const uint32_t nowMs = millis();
  bool shouldSave = false;
  portENTER_CRITICAL(&temperatureCompensationMux);
  if (temperatureCompensationPersistPending &&
      (temperatureCompensationPersistUrgent || lastTemperatureCompensationPersistMs == 0 ||
       (uint32_t)(nowMs - lastTemperatureCompensationPersistMs) >=
           TEMPERATURE_COMPENSATION_PERSIST_INTERVAL_MS))
  {
    shouldSave = true;
    temperatureCompensationPersistPending = false;
    temperatureCompensationPersistUrgent = false;
  }
  portEXIT_CRITICAL(&temperatureCompensationMux);
  if (!shouldSave) return;

  if (saveTemperatureCompensationModels())
  {
    lastTemperatureCompensationPersistMs = nowMs;
  }
  else
  {
    portENTER_CRITICAL(&temperatureCompensationMux);
    temperatureCompensationPersistPending = true;
    temperatureCompensationPersistUrgent = true;
    portEXIT_CRITICAL(&temperatureCompensationMux);
  }
}

bool solveTemperatureCompensationNormal(const double normal[4][4], const double rhs[4],
                                        double solution[4])
{
  double augmented[4][5];
  for (uint8_t row = 0; row < 4; row++)
  {
    for (uint8_t column = 0; column < 4; column++) augmented[row][column] = normal[row][column];
    augmented[row][4] = rhs[row];
  }
  for (uint8_t pivot = 0; pivot < 4; pivot++)
  {
    uint8_t best = pivot;
    for (uint8_t row = pivot + 1; row < 4; row++)
    {
      if (fabs(augmented[row][pivot]) > fabs(augmented[best][pivot])) best = row;
    }
    if (fabs(augmented[best][pivot]) < 1e-10) return false;
    if (best != pivot)
    {
      for (uint8_t column = pivot; column < 5; column++)
      {
        double swap = augmented[pivot][column];
        augmented[pivot][column] = augmented[best][column];
        augmented[best][column] = swap;
      }
    }
    double divisor = augmented[pivot][pivot];
    for (uint8_t column = pivot; column < 5; column++) augmented[pivot][column] /= divisor;
    for (uint8_t row = 0; row < 4; row++)
    {
      if (row == pivot) continue;
      double factor = augmented[row][pivot];
      for (uint8_t column = pivot; column < 5; column++)
      {
        augmented[row][column] -= factor * augmented[pivot][column];
      }
    }
  }
  for (uint8_t row = 0; row < 4; row++) solution[row] = augmented[row][4];
  return true;
}

void resetTemperatureCompensationFit(TemperatureCompensationState& state, uint32_t nowMs)
{
  state.blockStartMs = nowMs;
  state.restoredBlockElapsedMs = 0;
  state.sampleCount = 0;
  state.minTempC = 1000.0f;
  state.maxTempC = -1000.0f;
  memset(state.normal, 0, sizeof(state.normal));
  memset(state.rhs, 0, sizeof(state.rhs));
  state.sumY = 0.0;
  state.sumYSquared = 0.0;
}

void resetTemperatureCompensationEpoch(
    TemperatureCompensationState& state, uint8_t sensorId, uint32_t nowMs,
    float boardTempC, float logRatio, uint32_t connectedCounts, uint32_t bareCounts,
    const char* reason)
{
  const uint32_t nextEpoch = state.epoch == UINT32_MAX ? 1 : state.epoch + 1;
  state = TemperatureCompensationState();
  state.gainPerC = temperatureCompensationSeedGain(sensorId);
  state.referenceTempC = temperatureCompensationSeedReferenceC(sensorId);
  state.phaseOffset = TEMPERATURE_COMPENSATION_SEED_PHASE_OFFSET;
  state.effectiveTempC = boardTempC;
  state.slowLogRatio = logRatio;
  state.emaReady = true;
  state.epoch = max(1UL, nextEpoch);
  state.lastUpdateMs = nowMs;
  state.lastConnectedCounts = connectedCounts;
  state.lastBareCounts = bareCounts;
  resetTemperatureCompensationFit(state, nowMs);
  if (reason != nullptr)
  {
    Serial.print("[Treebeard temp-comp] sensor=");
    Serial.print(sensorId);
    Serial.print(" new epoch=");
    Serial.print(state.epoch);
    Serial.print(" reason=");
    Serial.println(reason);
  }
}

TemperatureCompensationResult updateTemperatureCompensation(
    uint8_t sensorId, uint32_t connectedCounts, uint32_t bareCounts,
    int16_t boardTempQuarterC, uint8_t tankPhase, uint32_t nowMs,
    bool probeRestarted)
{
  TemperatureCompensationResult result;
  if (sensorId == 0 || sensorId > MAX_SENSOR_ID) return result;

  TemperatureCompensationState state;
  uint8_t configuredMode;
  portENTER_CRITICAL(&temperatureCompensationMux);
  state = temperatureCompensation[sensorId];
  configuredMode = temperatureCompensationMode[sensorId];
  portEXIT_CRITICAL(&temperatureCompensationMux);
  result.configuredMode = configuredMode;
  result.effectiveMode = configuredMode;
  result.gainPerC = state.gainPerC;
  result.referenceTempC = state.referenceTempC;
  result.epoch = state.epoch;
  if (configuredMode == TEMPERATURE_COMPENSATION_OFF) return result;

  const uint32_t maxFdcCount = 0x0FFFFFFFUL;
  if (connectedCounts == 0 || connectedCounts > maxFdcCount ||
      bareCounts == 0 || bareCounts > maxFdcCount || tankPhase > 1)
  {
    return result;
  }
  const float boardTempC = boardTempQuarterC / 4.0f;
  const float logRatio = 2.0f * (logf((float)bareCounts) - logf((float)connectedCounts));
  if (!isfinite(logRatio) || logRatio < -0.2f || logRatio > 1.0f) return result;

  const float connectedStep = state.lastConnectedCounts > 0
      ? fabsf((float)connectedCounts / state.lastConnectedCounts - 1.0f) : 0.0f;
  const float bareStep = state.lastBareCounts > 0
      ? fabsf((float)bareCounts / state.lastBareCounts - 1.0f) : 0.0f;
  const char* resetReason = nullptr;
  if (probeRestarted) resetReason = "probe-restart";
  else if (state.emaReady && connectedStep > TEMPERATURE_COMPENSATION_MAX_CONNECTED_STEP_FRACTION)
    resetReason = "connected-count-step";
  else if (state.emaReady && bareStep > TEMPERATURE_COMPENSATION_MAX_BARE_STEP_FRACTION)
    resetReason = "bare-count-step";

  bool epochResetThisUpdate = false;
  if (!state.emaReady || resetReason != nullptr)
  {
    resetTemperatureCompensationEpoch(
        state, sensorId, nowMs, boardTempC, logRatio, connectedCounts, bareCounts,
        resetReason);
    epochResetThisUpdate = resetReason != nullptr;
  }

  float deltaSeconds = 0.0f;
  if (state.lastUpdateMs != 0)
  {
    deltaSeconds = (uint32_t)(nowMs - state.lastUpdateMs) / 1000.0f;
    // A receiver that was suspended for days should rewarm gradually instead of treating the
    // entire outage as one perfectly observed interval.
    deltaSeconds = min(deltaSeconds, 6.0f * 60.0f * 60.0f);
  }
  state.lastUpdateMs = nowMs;
  if (deltaSeconds > 0.0f)
  {
    const float tempAlpha = 1.0f - expf(-deltaSeconds / TEMPERATURE_COMPENSATION_TEMP_TAU_SECONDS);
    const float moistureAlpha = 1.0f - expf(-deltaSeconds / TEMPERATURE_COMPENSATION_MOISTURE_TAU_SECONDS);
    state.effectiveTempC += tempAlpha * (boardTempC - state.effectiveTempC);
    state.slowLogRatio += moistureAlpha * (logRatio - state.slowLogRatio);
  }

  state.lastConnectedCounts = connectedCounts;
  state.lastBareCounts = bareCounts;
  if (state.blockStartMs == 0)
  {
    if (state.sampleCount > 0 && state.restoredBlockElapsedMs > 0)
    {
      // Unsigned subtraction deliberately re-anchors across millis()'s new boot epoch; the
      // subsequent unsigned difference recovers exactly the persisted observed duration.
      state.blockStartMs = nowMs - state.restoredBlockElapsedMs;
      state.restoredBlockElapsedMs = 0;
    }
    else
    {
      resetTemperatureCompensationFit(state, nowMs);
    }
  }
  const uint32_t blockElapsedMs = (uint32_t)(nowMs - state.blockStartMs);
  const double timeDays = blockElapsedMs / (double)TEMPERATURE_COMPENSATION_FIT_BLOCK_MS;
  const float slowExcess = expf(state.slowLogRatio) - 1.0f;
  const double feature[4] = {
    1.0,
    timeDays,
    slowExcess * (state.effectiveTempC - state.referenceTempC),
    (double)tankPhase,
  };
  for (uint8_t row = 0; row < 4; row++)
  {
    state.rhs[row] += feature[row] * logRatio;
    for (uint8_t column = 0; column < 4; column++)
    {
      state.normal[row][column] += feature[row] * feature[column];
    }
  }
  state.sumY += logRatio;
  state.sumYSquared += (double)logRatio * logRatio;
  state.sampleCount++;
  state.minTempC = min(state.minTempC, state.effectiveTempC);
  state.maxTempC = max(state.maxTempC, state.effectiveTempC);

  bool fitAcceptedThisUpdate = false;
  if (blockElapsedMs >= TEMPERATURE_COMPENSATION_FIT_BLOCK_MS)
  {
    double coefficients[4];
    bool accepted = false;
    if (state.sampleCount >= TEMPERATURE_COMPENSATION_MIN_FIT_SAMPLES &&
        state.maxTempC - state.minTempC >= TEMPERATURE_COMPENSATION_MIN_TEMP_SPAN_C &&
        solveTemperatureCompensationNormal(state.normal, state.rhs, coefficients))
    {
      double sse = state.sumYSquared;
      for (uint8_t i = 0; i < 4; i++) sse -= coefficients[i] * state.rhs[i];
      const double sst = state.sumYSquared - state.sumY * state.sumY / state.sampleCount;
      const double r2 = sst > 1e-10 ? 1.0 - max(0.0, sse) / sst : -1.0;
      const float candidateGain = (float)coefficients[2];
      const float candidatePhase = (float)coefficients[3];
      if (isfinite(candidateGain) && candidateGain >= TEMPERATURE_COMPENSATION_MIN_GAIN_PER_C &&
          candidateGain <= 0.04f &&
          isfinite(candidatePhase) && fabsf(candidatePhase) <= 0.01f &&
          r2 >= TEMPERATURE_COMPENSATION_MIN_FIT_R2)
      {
        // The first accepted fit is taken outright. Blending it 3:1 against the seed only makes
        // sense if the seed carries information, and since v3 the seed is deliberately zero.
        // Blending against zero would leave a probe applying a quarter of its own measured gain
        // for several days, which is a worse error than applying none.
        if (state.acceptedFits == 0)
        {
          state.gainPerC = candidateGain;
          state.phaseOffset = candidatePhase;
        }
        else
        {
          state.gainPerC = 0.75f * state.gainPerC + 0.25f * candidateGain;
          state.phaseOffset = 0.75f * state.phaseOffset + 0.25f * candidatePhase;
        }
        if (state.acceptedFits < 0xFF) state.acceptedFits++;
        accepted = true;
      }
      Serial.print("[Treebeard temp-comp] sensor=");
      Serial.print(sensorId);
      Serial.print(" fit r2=");
      Serial.print(r2, 3);
      Serial.print(" candidateGain=");
      Serial.print(candidateGain, 6);
      Serial.print(" accepted=");
      Serial.println(accepted ? "yes" : "no");
    }
    resetTemperatureCompensationFit(state, nowMs);
    fitAcceptedThisUpdate = accepted;
  }

  const float correctedLogRatio = logRatio -
      state.gainPerC * slowExcess * (state.effectiveTempC - state.referenceTempC) -
      state.phaseOffset * tankPhase;
  const float equivalentCounts = bareCounts / expf(correctedLogRatio * 0.5f);
  if (isfinite(correctedLogRatio) && correctedLogRatio >= 0.0f && correctedLogRatio <= 0.65534f &&
      isfinite(equivalentCounts) && equivalentCounts >= 1.0f && equivalentCounts <= maxFdcCount)
  {
    result.valid = true;
    result.logRatioPpm = (int32_t)lroundf(correctedLogRatio * 1000000.0f);
    result.equivalentMoisture = calibrateMsv3Moisture((uint32_t)lroundf(equivalentCounts));
  }
  const uint32_t progress = min(49UL,
      (uint32_t)(((uint64_t)(nowMs - state.blockStartMs) * 50ULL) /
                 TEMPERATURE_COMPENSATION_FIT_BLOCK_MS));
  result.confidencePercent = (uint8_t)min(100UL,
      (uint32_t)state.acceptedFits * 50UL + progress);
  if (configuredMode == TEMPERATURE_COMPENSATION_ACTIVE &&
      state.acceptedFits < TEMPERATURE_COMPENSATION_REQUIRED_FITS)
  {
    result.effectiveMode = TEMPERATURE_COMPENSATION_LEARNING;
  }
  result.gainPerC = state.gainPerC;
  result.referenceTempC = state.referenceTempC;
  result.epoch = state.epoch;

  portENTER_CRITICAL(&temperatureCompensationMux);
  temperatureCompensation[sensorId] = state;
  temperatureCompensationPersistPending = true;
  if (fitAcceptedThisUpdate || epochResetThisUpdate) temperatureCompensationPersistUrgent = true;
  portEXIT_CRITICAL(&temperatureCompensationMux);
  return result;
}

bool validHistoryJournalRecord(const HistoryJournalRecord& record)
{
  return record.magic == HISTORY_RECORD_MAGIC &&
         record.version == HISTORY_JOURNAL_VERSION &&
         record.payloadSize == sizeof(PendingHistoryReading) &&
         record.checksum == historyChecksum(&record, offsetof(HistoryJournalRecord, checksum));
}

bool validHistoryJournalState(const HistoryJournalState& state)
{
  return state.magic == HISTORY_STATE_MAGIC &&
         state.version == HISTORY_JOURNAL_VERSION &&
         state.size == sizeof(HistoryJournalState) &&
         state.checksum == historyChecksum(&state, offsetof(HistoryJournalState, checksum));
}

bool readHistoryJournalState(const char* path, HistoryJournalState& state)
{
  File file = LittleFS.open(path, FILE_READ);
  if (!file)
  {
    return false;
  }
  const bool complete = file.read(reinterpret_cast<uint8_t*>(&state), sizeof(state)) == sizeof(state);
  file.close();
  return complete && validHistoryJournalState(state);
}

bool persistHistoryJournalState()
{
  HistoryJournalState state = {};
  state.magic = HISTORY_STATE_MAGIC;
  state.version = HISTORY_JOURNAL_VERSION;
  state.size = sizeof(state);
  state.generation = historyJournalStateGeneration + 1;
  portENTER_CRITICAL(&historyQueueMux);
  state.headOffset = historyJournalHeadOffset;
  state.dropped = pendingHistoryDropped;
  state.highWaterMark = pendingHistoryHighWaterMark;
  portEXIT_CRITICAL(&historyQueueMux);
  state.checksum = historyChecksum(&state, offsetof(HistoryJournalState, checksum));

  const char* path = (state.generation & 1U) != 0 ? HISTORY_STATE_A_PATH : HISTORY_STATE_B_PATH;
  File file = LittleFS.open(path, FILE_WRITE);
  if (!file)
  {
    historyJournalStorageErrors++;
    return false;
  }
  const bool complete = file.write(reinterpret_cast<const uint8_t*>(&state), sizeof(state)) == sizeof(state);
  file.flush();
  file.close();
  if (!complete)
  {
    historyJournalStorageErrors++;
    return false;
  }

  HistoryJournalState verified = {};
  if (!readHistoryJournalState(path, verified) || verified.generation != state.generation)
  {
    historyJournalStorageErrors++;
    return false;
  }
  historyJournalStateGeneration = state.generation;
  return true;
}

bool replaceHistoryJournalPrefix(uint32_t validBytes)
{
  File source = LittleFS.open(HISTORY_JOURNAL_PATH, FILE_READ);
  File compact = LittleFS.open(HISTORY_JOURNAL_COMPACT_PATH, FILE_WRITE);
  if (!compact)
  {
    if (source) source.close();
    return false;
  }

  uint8_t buffer[256];
  uint32_t copied = 0;
  bool ok = true;
  while (source && copied < validBytes)
  {
    size_t wanted = min((size_t)(validBytes - copied), sizeof(buffer));
    size_t got = source.read(buffer, wanted);
    if (got != wanted || compact.write(buffer, got) != got)
    {
      ok = false;
      break;
    }
    copied += got;
  }
  if (source) source.close();
  compact.flush();
  compact.close();
  if (!ok || copied != validBytes || !LittleFS.rename(HISTORY_JOURNAL_COMPACT_PATH, HISTORY_JOURNAL_PATH))
  {
    LittleFS.remove(HISTORY_JOURNAL_COMPACT_PATH);
    return false;
  }
  return true;
}

bool initializeHistoryJournal()
{
  historyJournalReady = false;

  HistoryJournalState stateA = {};
  HistoryJournalState stateB = {};
  const bool hasA = readHistoryJournalState(HISTORY_STATE_A_PATH, stateA);
  const bool hasB = readHistoryJournalState(HISTORY_STATE_B_PATH, stateB);
  HistoryJournalState recoveredState = {};
  if (hasA && (!hasB || (int32_t)(stateA.generation - stateB.generation) > 0))
  {
    recoveredState = stateA;
  }
  else if (hasB)
  {
    recoveredState = stateB;
  }

  if (!LittleFS.exists(HISTORY_JOURNAL_PATH))
  {
    File created = LittleFS.open(HISTORY_JOURNAL_PATH, FILE_WRITE);
    if (!created)
    {
      historyJournalStorageErrors++;
      return false;
    }
    created.close();
  }

  File file = LittleFS.open(HISTORY_JOURNAL_PATH, FILE_READ);
  if (!file)
  {
    historyJournalStorageErrors++;
    return false;
  }
  const uint32_t fileBytes = (uint32_t)file.size();
  uint32_t validBytes = 0;
  HistoryJournalRecord record = {};
  while (validBytes + sizeof(record) <= fileBytes)
  {
    if (file.read(reinterpret_cast<uint8_t*>(&record), sizeof(record)) != sizeof(record) ||
        !validHistoryJournalRecord(record))
    {
      break;
    }
    validBytes += sizeof(record);
  }
  file.close();

  if (validBytes != fileBytes)
  {
    Serial.print("[Treebeard history] removing torn journal tail bytes=");
    Serial.println(fileBytes - validBytes);
    if (!replaceHistoryJournalPrefix(validBytes))
    {
      historyJournalStorageErrors++;
      return false;
    }
  }

  uint32_t recoveredHead = (hasA || hasB) ? recoveredState.headOffset : 0;
  if (recoveredHead > validBytes || recoveredHead % sizeof(HistoryJournalRecord) != 0)
  {
    // Replaying from zero is lossless and safe because observation ids are idempotent.
    recoveredHead = 0;
  }
  portENTER_CRITICAL(&historyQueueMux);
  historyJournalHeadOffset = recoveredHead;
  historyJournalValidBytes = validBytes;
  durableHistoryCount = (validBytes - recoveredHead) / sizeof(HistoryJournalRecord);
  pendingHistoryDropped = (hasA || hasB) ? recoveredState.dropped : pendingHistoryDropped;
  pendingHistoryHighWaterMark = max((uint32_t)(durableHistoryCount + pendingHistoryCount),
                                    (hasA || hasB) ? recoveredState.highWaterMark : 0U);
  portEXIT_CRITICAL(&historyQueueMux);
  historyJournalStateGeneration = (hasA || hasB) ? recoveredState.generation : 0;
  historyJournalReady = true;
  if (!(hasA || hasB))
  {
    persistHistoryJournalState();
  }
  Serial.print("[Treebeard history] durable outbox ready queued=");
  Serial.print(durableHistoryCount);
  Serial.print(" bytes=");
  Serial.println(validBytes);
  return true;
}

size_t queuedHistoryCount()
{
  portENTER_CRITICAL(&historyQueueMux);
  size_t count = durableHistoryCount + pendingHistoryCount;
  portEXIT_CRITICAL(&historyQueueMux);
  return count;
}

uint32_t droppedHistoryCount()
{
  portENTER_CRITICAL(&historyQueueMux);
  uint32_t count = pendingHistoryDropped;
  portEXIT_CRITICAL(&historyQueueMux);
  return count;
}

uint32_t historyQueueHighWaterMark()
{
  portENTER_CRITICAL(&historyQueueMux);
  uint32_t mark = pendingHistoryHighWaterMark;
  portEXIT_CRITICAL(&historyQueueMux);
  return mark;
}

// Preserve the v1 journal record size: rawMoistureKHz is otherwise unused for wide/MSV3 rows,
// so it carries a compact shadow-channel value while queued. Zero remains the legacy/absent
// sentinel; one count represents 10 log-ratio ppm, covering the physically useful 0..655,340
// ppm range without invalidating already-journaled rows after a firmware update.
uint16_t encodeTemperatureCompensatedLogRatioPpm(int32_t ppm)
{
  int32_t quantized = (ppm + 5) / 10;
  quantized = constrain(quantized, 0L, 65534L);
  return (uint16_t)(quantized + 1);
}

bool decodeTemperatureCompensatedLogRatioPpm(uint16_t encoded, int32_t& ppm)
{
  if (encoded == 0)
  {
    return false;
  }
  ppm = (int32_t)(encoded - 1U) * 10;
  return true;
}

bool enqueueHistoryReading(uint8_t sensorId, const SensorReading& reading)
{
  PendingHistoryReading pending;
  pending.bootId = historyQueueBootId;
  pending.capturedMs = reading.lastSeenMs;
  // Once any authenticated cloud response supplies server time, later records carry an
  // absolute timestamp. That remains correct across a reset; pre-anchor rows retain the
  // legacy queued-age fallback and are never assigned an invented wall-clock value.
  portENTER_CRITICAL(&historyQueueMux);
  if (cloudTimeAnchorEpochMs != 0)
  {
    pending.observedAtMs = cloudTimeAnchorEpochMs +
                           (uint32_t)(reading.lastSeenMs - cloudTimeAnchorMillis);
  }
  portEXIT_CRITICAL(&historyQueueMux);
  pending.wake = reading.wake;
  pending.rawFdcCounts = reading.rawFdcCounts;
  if (reading.msv4)
  {
    pending.rawFdcCounts |= ((uint32_t)reading.msv4FitRmsE4 << 24);
  }
  pending.moisture = reading.moisture;
  pending.measuredMoisture = reading.measuredMoisture;
  pending.rawMoistureKHz = reading.wideRaw && reading.temperatureCompensationValid
      ? encodeTemperatureCompensatedLogRatioPpm(reading.temperatureCompensatedLogRatioPpm)
      : reading.rawMoistureKHz;
  if (reading.msv4)
  {
    pending.rawMoistureKHz = msv4EncodeDieTemp(reading.msv4DieTempValid, reading.msv4DieTempQuarterC);
  }
  pending.rawBatteryMv = reading.rawBatteryMv;
  pending.rawCharging = reading.rawCharging;
  pending.rssi = (int16_t)constrain(reading.rssi, -32768, 32767);
  pending.sensorId = sensorId;
  pending.moistureScale = moistureScaleVersion(reading.wideRaw, reading.caplessTank, reading.msv4);
  pending.batteryPercent = reading.batteryPercent;
  pending.hasRaw = reading.hasRaw;
  pending.wideRaw = reading.wideRaw;
  pending.hasMsv3Diagnostics = reading.hasMsv3Diagnostics;
  pending.boardTempValid = reading.boardTempValid;
  pending.rawBoardTempQuarterC = reading.rawBoardTempQuarterC;
  pending.bareTankValid = reading.bareTankValid;
  pending.rawBareTankFdcCounts = reading.rawBareTankFdcCounts;
  pending.tankPhase = reading.tankPhase;

  portENTER_CRITICAL(&historyQueueMux);
  if (durableHistoryCount + pendingHistoryCount >= HISTORY_QUEUE_CAPACITY ||
      pendingHistoryCount >= HISTORY_STAGING_CAPACITY)
  {
    pendingHistoryDropped++;
    portEXIT_CRITICAL(&historyQueueMux);
    return false;
  }

  pending.sequence = ++pendingHistorySequence;
  if (pendingHistoryCount == 0)
  {
    pendingHistoryOldestStagedAtMs = reading.lastSeenMs;
  }
  uint8_t tail = (pendingHistoryHead + pendingHistoryCount) % HISTORY_STAGING_CAPACITY;
  pendingHistory[tail] = pending;
  pendingHistoryCount++;
  const size_t totalQueued = durableHistoryCount + pendingHistoryCount;
  if (totalQueued > pendingHistoryHighWaterMark)
  {
    pendingHistoryHighWaterMark = totalQueued;
  }
  checkpointHistoryStagingToRtcLocked();
  portEXIT_CRITICAL(&historyQueueMux);
  return true;
}

void serviceHistoryJournal()
{
  if (!historyJournalReady && !initializeHistoryJournal())
  {
    return;
  }

  const uint32_t now = millis();
  size_t pendingCountSnapshot = 0;
  uint32_t oldestCapturedMs = 0;
  portENTER_CRITICAL(&historyQueueMux);
  pendingCountSnapshot = pendingHistoryCount;
  if (pendingCountSnapshot > 0)
  {
    oldestCapturedMs = pendingHistoryOldestStagedAtMs;
  }
  portEXIT_CRITICAL(&historyQueueMux);
  if (pendingCountSnapshot == 0)
  {
    return;
  }

  const bool capacityEmergency =
      pendingCountSnapshot >= HISTORY_JOURNAL_EMERGENCY_RECORDS;
  const bool ageDue = (uint32_t)(now - oldestCapturedMs) >= HISTORY_JOURNAL_MAX_STAGING_MS;
  if (!capacityEmergency &&
      pendingCountSnapshot < HISTORY_JOURNAL_FLUSH_RECORDS && !ageDue)
  {
    return;
  }

#if TREEBEARD_ENABLE_DISPLAY
  // A normal commit can wait for a quiet display/touch window. Capacity emergencies cannot:
  // dropping a row is worse than one bounded pause, and the larger RTC staging ring makes
  // this branch exceptional rather than the steady-state path.
  if (!capacityEmergency &&
      (touchAcquisitionPending ||
       (uint32_t)(now - lastDisplaySpiActivityMs) < HISTORY_FLASH_DISPLAY_QUIET_MS))
  {
    return;
  }
#endif

  PendingHistoryReading staged[HISTORY_JOURNAL_WRITE_BATCH_SIZE];
  size_t stagedCount = 0;
  portENTER_CRITICAL(&historyQueueMux);
  stagedCount = min((size_t)pendingHistoryCount, HISTORY_JOURNAL_WRITE_BATCH_SIZE);
  for (size_t i = 0; i < stagedCount; i++)
  {
    staged[i] = pendingHistory[(pendingHistoryHead + i) % HISTORY_STAGING_CAPACITY];
  }
  portEXIT_CRITICAL(&historyQueueMux);
  if (stagedCount == 0)
  {
    return;
  }

  uint32_t writeStartMs = millis();
  File file = LittleFS.open(HISTORY_JOURNAL_PATH, FILE_APPEND);
  if (!file)
  {
    historyJournalStorageErrors++;
    historyJournalReady = false;
    return;
  }
  size_t written = 0;
  for (; written < stagedCount; written++)
  {
    HistoryJournalRecord record = {};
    record.magic = HISTORY_RECORD_MAGIC;
    record.version = HISTORY_JOURNAL_VERSION;
    record.payloadSize = sizeof(PendingHistoryReading);
    record.reading = staged[written];
    record.checksum = historyChecksum(&record, offsetof(HistoryJournalRecord, checksum));
    if (file.write(reinterpret_cast<const uint8_t*>(&record), sizeof(record)) != sizeof(record))
    {
      break;
    }
  }
  file.flush();
  file.close();
  lastJournalWriteAtMs = millis();
  lastJournalWriteDurationMs = lastJournalWriteAtMs - writeStartMs;
  lastJournalWriteRecords = written;
  lastJournalCompactedThisWrite = false;

  portENTER_CRITICAL(&historyQueueMux);
  size_t removed = 0;
  while (removed < written && pendingHistoryCount > 0 &&
         pendingHistory[pendingHistoryHead].bootId == staged[removed].bootId &&
         pendingHistory[pendingHistoryHead].sequence == staged[removed].sequence)
  {
    pendingHistoryHead = (pendingHistoryHead + 1) % HISTORY_STAGING_CAPACITY;
    pendingHistoryCount--;
    durableHistoryCount++;
    historyJournalValidBytes += sizeof(HistoryJournalRecord);
    removed++;
  }
  if (removed > 0)
  {
    pendingHistoryOldestStagedAtMs = pendingHistoryCount > 0 ? millis() : 0;
  }
  const size_t totalQueued = durableHistoryCount + pendingHistoryCount;
  if (totalQueued > pendingHistoryHighWaterMark)
  {
    pendingHistoryHighWaterMark = totalQueued;
  }
  checkpointHistoryStagingToRtcLocked();
  portEXIT_CRITICAL(&historyQueueMux);

  if (written != stagedCount || removed != written)
  {
    historyJournalStorageErrors++;
    // A short write can leave a partial tail. Startup recovery is reused on the next tick
    // before another append, preventing corruption from ever being buried mid-file.
    historyJournalReady = false;
  }
}

size_t copyHistoryUploadBatch(PendingHistoryReading* destination, size_t capacity)
{
  if (destination == nullptr || capacity == 0)
  {
    return 0;
  }

  size_t durableAvailable = 0;
  uint32_t headOffset = 0;
  portENTER_CRITICAL(&historyQueueMux);
  durableAvailable = durableHistoryCount;
  headOffset = historyJournalHeadOffset;
  portEXIT_CRITICAL(&historyQueueMux);
  const size_t durableWanted = min(durableAvailable, capacity);

  size_t copied = 0;
  if (durableWanted > 0)
  {
    if (!historyJournalReady)
    {
      return 0;
    }
    File file = LittleFS.open(HISTORY_JOURNAL_PATH, FILE_READ);
    if (!file || !file.seek(headOffset))
    {
      if (file) file.close();
      historyJournalStorageErrors++;
      return 0;
    }
    for (; copied < durableWanted; copied++)
    {
      HistoryJournalRecord record = {};
      if (file.read(reinterpret_cast<uint8_t*>(&record), sizeof(record)) != sizeof(record) ||
          !validHistoryJournalRecord(record))
      {
        historyJournalStorageErrors++;
        break;
      }
      destination[copied] = record.reading;
    }
    file.close();
  }

  // Append an immutable snapshot of the RTC-backed ingress prefix. New BLE readings can join
  // the tail during HTTPS without changing any row copied here; acknowledgement below removes
  // only exact bootId/sequence matches from the head.
  portENTER_CRITICAL(&historyQueueMux);
  const size_t stagedWanted = min((size_t)pendingHistoryCount, capacity - copied);
  for (size_t i = 0; i < stagedWanted; i++)
  {
    destination[copied + i] =
        pendingHistory[(pendingHistoryHead + i) % HISTORY_STAGING_CAPACITY];
  }
  portEXIT_CRITICAL(&historyQueueMux);
  return copied + stagedWanted;
}

bool compactHistoryJournal()
{
  if (!historyJournalReady)
  {
    return false;
  }
  size_t remaining = 0;
  uint32_t oldHead = 0;
  portENTER_CRITICAL(&historyQueueMux);
  remaining = durableHistoryCount;
  oldHead = historyJournalHeadOffset;
  portEXIT_CRITICAL(&historyQueueMux);

  File source = LittleFS.open(HISTORY_JOURNAL_PATH, FILE_READ);
  File compact = LittleFS.open(HISTORY_JOURNAL_COMPACT_PATH, FILE_WRITE);
  if (!source || !compact || !source.seek(oldHead))
  {
    if (source) source.close();
    if (compact) compact.close();
    LittleFS.remove(HISTORY_JOURNAL_COMPACT_PATH);
    historyJournalStorageErrors++;
    return false;
  }

  uint8_t buffer[256];
  const uint32_t bytesToCopy = remaining * sizeof(HistoryJournalRecord);
  uint32_t copied = 0;
  bool ok = true;
  while (copied < bytesToCopy)
  {
    size_t wanted = min((size_t)(bytesToCopy - copied), sizeof(buffer));
    size_t got = source.read(buffer, wanted);
    if (got != wanted || compact.write(buffer, got) != got)
    {
      ok = false;
      break;
    }
    copied += got;
  }
  source.close();
  compact.flush();
  compact.close();
  if (!ok || copied != bytesToCopy)
  {
    LittleFS.remove(HISTORY_JOURNAL_COMPACT_PATH);
    historyJournalStorageErrors++;
    return false;
  }

  // Persisting head=0 first can at worst replay rows if power fails before rename. Reversing
  // the order could point past the compacted file and lose rows, so the ordering matters.
  portENTER_CRITICAL(&historyQueueMux);
  historyJournalHeadOffset = 0;
  portEXIT_CRITICAL(&historyQueueMux);
  if (!persistHistoryJournalState() ||
      !LittleFS.rename(HISTORY_JOURNAL_COMPACT_PATH, HISTORY_JOURNAL_PATH))
  {
    portENTER_CRITICAL(&historyQueueMux);
    historyJournalHeadOffset = oldHead;
    portEXIT_CRITICAL(&historyQueueMux);
    persistHistoryJournalState();
    LittleFS.remove(HISTORY_JOURNAL_COMPACT_PATH);
    historyJournalStorageErrors++;
    return false;
  }
  historyJournalValidBytes = bytesToCopy;
  return true;
}
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
