samam624/ProjectTreebeard/MSV4/arduino/variants/msv4_e73/variant.h

/*
  Copyright (c) 2014-2015 Arduino LLC.  All right reserved.
  Copyright (c) 2016 Sandeep Mistry All right reserved.
  Copyright (c) 2018, Adafruit Industries (adafruit.com)

  This library is free software; you can redistribute it and/or
  modify it under the terms of the GNU Lesser General Public
  License as published by the Free Software Foundation; either
  version 2.1 of the License, or (at your option) any later version.
  This library is distributed in the hope that it will be useful,
  but WITHOUT ANY WARRANTY; without even the implied warranty of
  MERCHANTABILITY or FITNESS FOR A PARTICULAR PURPOSE.
  See the GNU Lesser General Public License for more details.
  You should have received a copy of the GNU Lesser General Public
  License along with this library; if not, write to the Free Software
  Foundation, Inc., 51 Franklin St, Fifth Floor, Boston, MA  02110-1301  USA
*/

// Project Treebeard MSV4 probe (E73-2G4M08S1C on the MSV4 PCB).
//
// Derived from Adafruit nRF52 core 1.7.0 variants/pca10056. This file is TRACKED in the repo and
// selected with `--build-property build.variant.path=<this folder>` by
// MSV4/scripts/arduino_msv4_probe.ps1. It deliberately does not touch the installed core's
// pca10056 variant, which MSV3/scripts/arduino_msv3_probe.ps1 rewrites to USE_LFRC before every
// MSV3 build. The two generations need opposite LFCLK sources and must never share a variant file.
//
// Differences from pca10056, each for a board reason:
// - USE_LFXO: Y1 (32.768 kHz, SC-32S) is populated on P0.00/XL1 and P0.01/XL2 on MSV4. MSV3 has no
//   crystal; building an MSV3 sketch against this variant would reproduce the RTC1 hang in
//   MSV3/docs/MSV3_LFCLK_RTC1_HANG_2026-08-21.md, which is why MSV3 sketches #error on USE_LFXO.
// - LED is P1.10, active HIGH (R10 470R -> D1). The dev-kit LEDs on P0.13-P0.16 are gone: on
//   MSV4, P0.13 is SWAP_CTRL and P0.15 is SWAP_nOE, and pca10056's initVariant() drove them.
// - No QSPI flash, buttons or Serial2 pin assignments. On this PCB those pins are READ_CNTL (P0.17),
//   READ_nOE (P0.20), TEMP_READ (P0.12) and VBAT_DIV_EN (P0.06).

#ifndef _VARIANT_MSV4_E73_
#define _VARIANT_MSV4_E73_

// Sketches assert on this so a build that silently fell back to the installed pca10056 variant
// fails at compile time instead of on the bench.
#define MSV4_VARIANT 1

/** Master clock frequency */
#define VARIANT_MCK       (64000000ul)

#define USE_LFXO    // Board uses 32khz crystal for LF (Y1, populated on MSV4)
// define USE_LFRC  // NEVER on MSV4 -- see header comment

/*----------------------------------------------------------------------------
 *        Headers
 *----------------------------------------------------------------------------*/

#include "WVariant.h"

#ifdef __cplusplus
extern "C"
{
#endif // __cplusplus

// Number of pins defined in PinDescription array
#define PINS_COUNT           (48)
#define NUM_DIGITAL_PINS     (48)
#define NUM_ANALOG_INPUTS    (6)
#define NUM_ANALOG_OUTPUTS   (0)

// LEDs -- one real LED, P1.10 (Arduino pin 42), active high.
#define PIN_LED1             (42)
#define PIN_LED2             (42)

#define LED_BUILTIN          PIN_LED1
#define LED_CONN             PIN_LED2

#define LED_RED              PIN_LED1
#define LED_BLUE             PIN_LED2

#define LED_STATE_ON         1         // State when LED is litted
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
