samam624/ProjectTreebeard/(commit log)

2026-07-02 Add QR auto-connect claim flow
2026-07-07 Security hardening pass: lock down RPC access, TLS validation, XSS, CSP
    Closes the 6 critical + 8 high findings from the full-repo security
    review without touching the QR/claim-code onboarding flow:
    - Revoke anon/authenticated execute on every Supabase RPC (migration
    011) so they're only reachable through the edge functions, closing
    the direct-PostgREST bypass that let anyone read/write cross-
    household data or claim someone else's receiver.
    - Remove the shared master-token bypass and fleet-wide snapshot
    listing in receiver-snapshot; every request now needs its own
    verified per-device token.
    - Rate-limit registration/claim attempts per receiver_id and hash
    claim codes at rest (t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
2026-07-07 Update docs for the 2026-07-07 security hardening pass
    STATUS_HANDOFF.md: add the dated writeup (what shipped, the migration
    011->012 correction, the migration-history drift and how it was
    repaired, the config-wipe incident and recovery path).
    SUPABASE_SETUP.md: drop the now-removed shared MSV2_RECEIVER_TOKEN
    setup steps, add migrations 010-012 to the walkthrough, document the
    migration-repair pattern for when SQL gets applied by hand instead of
    through db push, update the PowerShell test section to use per-device
    bootstrap tokens instead of the removed master token.
    ESP32_DISPLAY_FLASHING.md: note the TLS validation and admin
    grace-window behavior changes, and flag that POST /ui fully rep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
2026-07-24 Add moisture probe RC sensing, cloud history pipeline, and display History tab
    First real end-to-end pass on the capacitive moisture probe: standalone RC test
    sketch, calibrated battery reading, verified BLE packet loss (1.00% over 10min),
    and a precharge-tuning saga that landed on a validated 10ms value after finding
    USB tethering itself was injecting measurement noise into the floating sense pin.
    Adds durable cloud-side history (Supabase migrations 013/014 + receiver-snapshot
    updates) so overnight readings survive the laptop being off, a paginated History
    tab on the display's local app to view it, and new scripts/log_sensor_readings.py,
    plot_sensor_readings.py, fetch_supabase_history.py f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
2026-07-24 Add working moisture sensor firmware (free-running oscillator) + debugging report
    Replaces the one-shot precharge/discharge RC timing approach (fragile,
    saturated at both 10k and 10M pulldowns) with a free-running relaxation
    oscillator + frequency counting, modeled on the validated MSV1 555-timer
    proof-of-concept. Bench-verified with a 100k pulldown: stable, responsive
    readings with no jumping or saturation. Also adds periodic wake/sleep,
    an A1 LED burst indicator, and median-of-5 outlier rejection to keep
    active measurement time down to 5ms per reading.
    Report documents the full debugging path and the key numbers needed to
    port this into MSV2_Moisture_BLE_Sleep.ino next.
2026-07-25 Port oscillator moisture sensing, add auto-calibration mode, fix History tab freeze and silent save failures
    The one-shot RC precharge/discharge sensing (validated 2026-07-24) turned out
    fundamentally unfixable once in real soil - no resistor value survives variable
    conductivity with a single timed discharge. Replaces it with free-running
    oscillator + frequency counting (median-of-5 x 1ms bursts), matching the
    project's own MSV1 555-timer proof-of-concept. Adds a self-calibrating "auto
    mode" (percentile-based learned range + watering-interval prediction) so
    thresholds don't need hand-tuning every time the sensing scale shifts, which
    happened twice today alone.
    Also: History tab now fetches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
2026-07-27 Fix receiver freeze root causes, correct Alocasia SENSOR_ID, overhaul battery curve
    - Move cloud bootstrap/config-pull/auto-cal-pull/snapshot-upload onto their own
    FreeRTOS task instead of running inline in loop(), so the blocking HTTPClient
    calls (~1.6-2.1s each, config pull firing every ~30s) stop stalling the shared
    render/WebServer loop.
    - Rate-limit the moisture probe's swing-triggered advertise so a noisy/disconnected
    probe can't force a 6x jump in BLE traffic that was re-triggering cloud sync faster
    than it could clear.
    - Fix wake-counter-gap underflow when a probe reboots mid-run (wake resets to a small
    value instead of ~16M packets actually being missed).
    - Replace the p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
2026-07-27 Fix moisture drift with dual-plate bipolar drive, restore range with register access
    Root-caused the steady upward moisture drift to the single-plate design pushing
    the same net DC field across the sensor every cycle (consistent with dielectric
    polarization under sustained one-directional drive). Reworked the probe to two
    independently-addressable plates (10k pulldown each) and alternate which one
    drives vs reads every cycle, so the net field averages toward zero.
    Moving to 10k plates compressed the measurable range almost flat under Arduino's
    pinMode()/digitalWrite()/digitalRead() overhead (~88% of each cycle at 10k), so
    countOscCycles() was rewritten to direct nRF52840 GPIO register acces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
2026-07-28 Add MSV2_ESP32_DisplayCenter enclosure CAD/print files
    STEP/3MF source, sliced gcode.3mf, and per-part STLs (base, display,
    arms) for the display receiver enclosure, exported from Altium.
2026-07-28 Move probe calibration math to the receiver; probe now sends raw values
    Probe (MSV2_Moisture_BLE_Sleep.ino) no longer interprets anything it
    measures: readAveragedMoisture()'s ceiling-inversion, the LiPo curve,
    charge-current IR compensation/taper, and battery EMA smoothing are all
    gone. It now transmits the raw median oscillator cycle count (kHz), raw
    battery mV, and a raw charging flag - median-of-5 outlier rejection stays
    on the probe since it's noise cleanup on the raw signal, not calibration.
    Widened the BLE payload 13 -> 15 bytes to carry the extra fields. Also
    drops the on-probe low-moisture LED alert, since evaluating "is this low"
    needs a calibrated range the probe no longer compute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
2026-07-28 Surface raw sensor values in /data instead of discarding after calibration
    The previous raw-values commit calibrated incoming raw readings but then
    threw the raw numbers away, defeating the actual point of that rework
    (observing the sensed signal without abstraction for troubleshooting).
    SensorReading now keeps rawMoistureKHz/rawBatteryMv/rawCharging alongside
    the calibrated fields, and /data exposes them under a "raw" sub-object
    when present. Absent entirely (not zeroed) for probes still on legacy
    firmware, so the field's presence signals which protocol a sensor is on.
2026-07-31 Add antenna and AFE bench-test rigs, sensor-3 AFE calibration entry
    New bench-test sketches/scripts for comparing the bit-banged oscillator
    probe against an antenna range test and an off-the-shelf analog-front-end
    capacitive sensor, ahead of migrating the moisture sensing front end.
    Receiver gains sensor-3's provisional AFE calibration entry plus a
    temporary debug print for the erratic-battery-reading investigation.
2026-07-31 Fix RTC-tick quantization in moisture oscillator; document FDC2212 migration plan
    countOscCycles()'s 1ms sampling gate was landing on RTC1's ~30.5us hardware
    tick granularity, ~3% of the window - all 5 median samples in a reading
    inherit the same tick-phase offset (each burst starts where the last one's
    tick-aligned exit left off), so the artifact showed up as stable plateaus
    jumping cleanly between levels rather than continuous jitter. Confirmed via
    6-day Supabase history: the raw-value distribution is a comb with ~7-16 unit
    (avg ~11-12) peak spacing, constant across the whole range - the fingerprint
    of a fixed time quantum, not soil physics. Widened OSC_SAMPLE_WINDOW_MS 1ms
    -> 5ms and adde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
2026-07-31 Add salt/conductivity compensation plan to FDC2212 front-end doc
    Revises the electrode-swap switching hardware from 74HC4053 to 74HC4052
    (dual 4-channel mux) once the conductivity-check circuit is folded in -
    each electrode needs 4 destinations (tank sense, tank reference, VDD,
    divider node), not 2. Documents why reading CH0_IDRIVE back isn't a live
    conductivity signal (static R/W register, not closed-loop), the chosen
    brief-pulse resistive EC measurement sharing the same mux and swap-phase
    timing as the polarization mitigation, and why the existing fixed 56kOhm
    pulldowns can't stay permanently wired once the LC tank is in place.
2026-08-09 Fix QSPI power-down bug draining probe batteries; confirm VDD-coupling in moisture sensing
    Both field probes were running a 150mAh cell dry in 4-6 days instead of
    the expected 100s of days at their 30min-sleep/500ms-advertise duty cycle.
    Root cause: Adafruit_SPIFlashBase::begin() enables the QSPI peripheral
    before checking its hardcoded device table, and the XIAO nRF52840 Sense's
    actual flash (Puya P25Q16H) isn't in that table (GD25Q/S25FL/W25Q/AT25/
    MB85RS only) - so flash.begin() always failed, and the old
    `if (!flash.begin()) return;` guard in powerDownExternalFlash() meant the
    QSPI peripheral was left enabled and the flash chip never got its 0xB9
    deep-power-down command, every single boo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
2026-08-12 Add 2026-08-11 display center backlight bring-up handoff doc
    Documents today's session: the ESP32-S3 display panel rendered over SPI
    but showed no backlight because the board's backlight wiring moved from
    tied-to-3.3V to a GPIO11-gated FET switch that the firmware never drove.
    Includes the exact diffs and toolchain steps needed to reproduce the fix
    on another local checkout, since the firmware changes themselves are
    still uncommitted local working-tree state.
2026-08-12 Add tap-to-expand plant diagnostics and touch/brightness UX fixes to the display; repair QR pairing scanner
    Display receiver (arduino/MSV2_ESP32_Display_Runtime):
    - Tap-to-expand plant card detail view: tapping a card replaces it in place with a
    diagnostics readout (signal quality, RSSI, age, wake/received/missed counters, packet
    loss, moisture range, and raw oscillator/charging state where the probe sends it) scaled
    to the tapped card's actual size, reusing the same region the plant sprite would occupy.
    Tapping again collapses it. New drawPlantCardDetail()/drawPlantCardDetailDataOnly()
    function pair, PlantArtSlot gained a cached plant name plus per-row diagnostic caches.
    - New st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
2026-08-13 Move updated display enclosure files into hardware folder
2026-08-14 Full-repo hostile review pass: fix ~35 bugs across firmware, backend, and web
    8 parallel review agents covered every area of the repo (both probe sketches, the
    display receiver, the phone-facing app HTML/JS, secondary bench-test sketches,
    Python tooling, Supabase SQL, edge functions, web dashboard); findings triaged and
    fixed below. Every edited Arduino sketch recompiled clean; every edited Python
    script passed py_compile; JS/TS/TOML changes were syntax/balance-checked (no local
    Deno/tsc). Full triage record in this session's memory
    (msv2_full_repo_review_2026-08.md) for future reference.
    Probe firmware:
    - MSV2_Moisture_BLE_Sleep_Alocasia.ino was missing the charge-settle poll-loop fix
    i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
2026-08-15 Remove WiFi.setSleep(false) starving BLE reception on the display receiver
    The 2026-08-13 wifi-self-heal commit disabled WiFi modem sleep on every
    station connect/reconnect to make reconnects feel snappier. BLE and WiFi
    share one radio on the ESP32, and coexistence hands BLE its scan slices
    out of WiFi's modem-sleep windows - disabling that sleep produced exactly
    "good RSSI, huge miss%" on live probes. Confirmed fixed on hardware
    (COM16) after reflashing without it.
2026-08-15 Wire the bench-tested buzzer sounds into the normal display runtime
    Implements the startup chime and water-warning double-buzz from
    docs/DISPLAY_CENTER_BUZZER_SOUND_DESIGN.md (bench-tested 2026-08-14) in
    the actual receiver firmware, which the doc noted had not been done yet.
    - Non-blocking LEDC-based tone sequencer (GPIO38, 4% duty, 8ms envelope)
    driven entirely off millis() deadlines - no delay(), since it shares
    loop() with BLE-derived rendering, touch, and the WebServer.
    - Startup sound plays once per successful boot/reset.
    - Water-warning reuses the same overdue/critical condition that already
    drives the visual blink alert, so sound and blink always agree. Fires
    once on the tra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
2026-08-17 Make Netlify moisture colors match the display; remove Netlify brightness control
    The Netlify dashboard never received auto-calibration bounds or the overdue
    watering flag from the receiver's cloud upload, so it fell back to static
    manual/preset dry/wet thresholds while the physical display and local app used
    learned bounds - causing the two to show different colors for the same plant.
    snapshotJson() now includes autoCal per sensor and the moisture.auto flag per
    card; the Netlify app mirrors the same resolveMoistureColor logic instead of a
    bare percent threshold.
    Also removes the Netlify brightness slider/preset/power control and retires
    its backend route (share-display) and RPCs, per the p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
2026-08-20 Add MSV3 enclosure designs and calibration updates
2026-08-20 Add print-ready STL exports for MSV3 brain enclosure and solar arms
2026-08-20 Update solar panel frame STL and add 3mf/gcode print files
2026-08-21 Add ESP32-S3 SWD flasher for nRF52840 bootloader recovery
    Bit-bangs ARM SWD from an ESP32-S3 to reflash the nRF52840 bootloader
    on bare E73-2G4M08S1C modules (MSV3) or XIAO nRF52840 Sense boards,
    no external debug probe needed. Bench-validated end to end on a bare
    E73 module: mass erase, bootloader install, and boot into NRF52BOOT
    confirmed, then MSV3_E73_LED_Test compiled/UF2'd and run to prove the
    new bootloader can accept and run application firmware.
2026-08-21 MSV3 probe: BLE + whole-board sleep/wake, and three real measurement bugs
    Bench session on the real MSV3 probe PCB. Everything here was flashed and
    verified on hardware unless noted.
    Firmware (arduino/MSV3_Probe_Bringup_Test/):
    - Port MSV2's advertise-only BLE and its wake/measure/advertise/sleep cycle
    onto this board as console commands (blestart/blestop/blecycle). Uses a
    distinct "MSV3" magic and sensor id 99 so a production MSV2 receiver, which
    matches on its own magic before reading sensorId, can never ingest bench
    traffic as real plant data. Confirmed end to end: a PC received live
    advertisements through full sleep cycles at exact 10s spacing.
    - Whole-board sleep/wake sequenc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
2026-08-21 Add MSV3 bench test plan as a repo doc
    The checklist existed only as a published Artifact, which needs a login and a
    network connection -- no good at a lab bench. This is the offline copy:
    renders on GitHub with checkboxes, greppable, and versioned alongside the
    firmware it tests.
    Covers battery validation (which closes the three measurement bugs that are
    still unproven for want of an attached cell), sleep current with a predicted
    per-IC budget and failure triage, the solar harvester's cold-start threshold,
    tank ringdown incl. the internal-oscillator calibration trick, the EC-check
    bridge, and re-checking wake settle in wet soil.
2026-08-21 Pull in msv3-bringup-sleep-2026-08-21 branch content
    Brings MSV3_Probe_Bringup_Test (BLE + whole-board sleep/wake), bench
    test plan and LFCLK/RTC1 hang writeups, PCB reference docs/datasheets/
    netlist, the pcb-reference skill, agent-supervisor tooling, and .gitignore
    /SWD_FLASHER.md/ble_periodic_reader.py updates from the branch pushed
    earlier today, so this checkout has the same content as that branch.
2026-08-22 MSV3 bring-up: fix real 65uA sleep-current leak, add vbat/blestart fixes
    Root cause of the ~65-71uA sleep-current excess: probeSleep() released
    VBAT_DIV_EN via plain pinMode(INPUT) instead of gpioDisconnect() -- on
    this core INPUT leaves the digital input buffer connected, letting the
    divider float toward VBAT and burn CMOS shoot-through current. Same gap
    existed for VBAT_DIV and charger STAT/PG. Fixed all four; measured
    result dropped to 10-15uA, matching the ~4.1uA predicted floor much
    more closely and restoring real (if unconfirmed) solar margin.
    Also fixes two independent, confirmed-real bugs found along the way:
    - readVbatMv()'s pre-read settle delay (5ms) was exactly one R29||R30/
    C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
2026-08-22 Improve adaptive moisture calibration and alerts
2026-08-24 Ship MSV3 production stack and printable enclosure
    Add the blended M2 enclosure closure with complete Bambu/Orca slicer pack, production firmware and receiver history updates, dashboard and sprite refreshes, Supabase migrations, documentation, and agent-supervisor billing safeguards.
2026-08-25 Fix History tab never finishing a >14-day load
    The 30s auto-refresh timer fired unconditionally, even mid-pagination,
    so a wide range needing 14-30 sequential Supabase page fetches kept
    getting restarted before it could finish - looked like the tab resetting
    and reloading forever. A historyLoadInFlight flag now makes the
    auto-refresh skip its tick while a load is already running; manual
    triggers (tab click, dropdown change) still cancel-and-restart
    immediately as before.
2026-08-25 Add MSV3 board-temp/bare-tank reference sensing; carry moisture-smoothing work
    MSV3: two new raw observables with zero hardware change (no blade
    reshape, no new wire) - nRF52840 die temperature via a properly
    HFXO-balanced sd_temp_get() call, and a bare-tank FDC2214 reference
    reading taken once per advertising wake with the mux on EC-check
    code 2/3. Neither is soil temperature; neither is compensated or
    computed anywhere yet - both are raw values carried through to the
    receiver and Supabase (migration 035), with the eventual compensation
    formula documented but deliberately left unused. Full design and
    required bench-validation checklist in
    docs/MSV3_SOFTWARE_TEMPERATURE_TANK_REFERENCE_2026-0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
2026-08-25 Add MSV3 four-board assembly pull list
2026-08-29 MSV3 four-board SWD bring-up + EC-check analog fix
    All 4 fresh MSV3 boards taken through SWD bootloader install and USB DFU
    bring-up flash, all confirmed alive with no hangs. Added a one-shot
    --bootloader mode to the SWD flasher requiring 3s of continuous stable
    contact before erasing, after a single-read check proved insufficient on
    real hardware. Moved DIV_NODE/VDIV to the AIN-capable P0.03 per the
    existing fix plan and made it a real analogRead(); found and fixed a bug
    this introduced (old P0.00 trace still live in parallel, left
    unconfigured instead of disconnected). Found a dead mux on one board and
    a separate VDIV-pegged-high fault on another; closed the bench test
    plan's open real-bri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
2026-08-29 Add mux settle margin to MSV3 production firmware before solar test
    Electrode-swap mux-during-shutdown timing was never hardware-verified,
    and BLE advertising (the only remote telemetry for the unattended
    solar-recovery test) is gated on a clean FDC read. Adds a 300ms
    MUX_SWITCH_SETTLE_MS delay after every setMux() that precedes a
    probeWake(), reusing the bring-up sketch's own bench-proven live-switch
    settle figure rather than trusting the unverified assumption.
2026-08-29 Extract agent-supervisor and LaTeX tooling out of this repo
    Both are reusable dev tools, not moisture-sensor project content, and
    the user wants this repo scoped to just that. Moved to standalone,
    version-controlled folders on Desktop (agent-supervisor, latex-tools),
    each verified working from their new location before this removal:
    agent-supervisor's own typecheck/test suite passes standalone, and the
    IEEE paper still compiles clean via the relocated tex_compile.ps1.
    CLAUDE.md/AGENTS.md updated so the agent-instructions no longer claim
    the collaboration harness lives inside this repo. scripts/tex_compile.ps1
    and tex_import_figures.ps1 were never committed here (added and removed
    within the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
2026-08-29 Update .gitignore/CLAUDE.md/AGENTS.md for the agent-supervisor extraction
    Follow-up to the previous commit's tools/agent-supervisor removal --
    this piece didn't stage correctly the first time (git add silently
    aborted on an unrelated bad pathspec in the same invocation). Drops the
    now-irrelevant tools/agent-supervisor/.env and dist/ ignore lines, and
    updates the agent-instructions sections so they no longer claim the
    Claude-Codex collaboration harness lives inside this repo.
2026-08-29 Add MSV evolution IEEE paper, slide deck, and planning docs
    Converts the existing outline/draft/fact-check docs into a compiling
    IEEEtran paper (docs/paper/) and a 35-slide Google-Slides-ready deck
    (generated/), correcting a factual error present in all five source
    docs along the way: Alocasia was documented as dual-plate/56kOhm,
    matching Thaumatophyllum's architecture, but the probe's own firmware
    source (arduino/MSV2_Moisture_BLE_Sleep_Alocasia) says single-plate/
    100kOhm three separate times. Fixed in the paper/slides and in the
    outline doc; the draft doc is mid-edit by a concurrent Codex session
    and was left alone.
    Also carries forward docs/MSV3_MULTI_DAY_FDC_DRIFT_FOLLOWUP_2026-08-28.m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
2026-08-29 Reorganize repo into MSV1/MSV2/MSV3/DisplayCenter/cloud (Project Treebeard)
    Splits what had grown into a single flat "MSV2" repo by actual ownership:
    - MSV1/ original 555-timer analog prototype (reference PDF only)
    - MSV2/ XIAO nRF52840 moisture probe (arduino/, docs/, scripts/)
    - MSV3/ E73-2G4M08S1C custom-PCB probe (arduino/, hardware/, docs/,
    scripts/, procurement/ -- LCSC order CSVs, previously excluded
    from git entirely by an overly broad *.csv gitignore rule,
    now tracked)
    - DisplayCenter/ the shared ESP32-S3 receiver/display BOTH probe generations
    report to (arduino/, hardware/, docs/, scripts/, ui/,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
2026-08-31 Fix DisplayCenter touch/display SPI corruption and brightness overlay bugs
    Root-caused card-art corruption during active touch gestures to touch SPI
    traffic itself (confirmed via isolation test), not idle polling or redraw
    logic as previously assumed. Rewrote handleTouchInput() to use the T_IRQ
    GPIO level as the primary down/up signal, cutting a plain tap to one SPI
    transaction instead of 5-20+, plus a bidirectional bus-turnaround guard so
    that transaction never lands adjacent to a display write.
    Also fixed four separate brightness-overlay bugs found along the way: full
    modal repaints instead of targeted redraws, a stale-digit slider text
    artifact, rapid-mashing misfiring the overlay closed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
2026-08-31 Fix brightness-slider SPI corruption, MSV2 sensor-fault reporting, and cloud validation gaps
    DisplayCenter: the touch/SPI bus-turnaround guard from the prior commit exempted the
    brightness slider's drag path, so every ~32ms sample during a drag still did a touch SPI
    read immediately followed by a display SPI write with no settle gap - field-confirmed as
    the source of ongoing glitching. Split each read/paint pair across two polls via a new
    sliderPaintPending state machine, moved to its own fast path so the real elapsed-time
    blackout isn't rounded up to the next 32ms-quantized poll, and fixed several lastTouchSpiMs/
    lastDisplaySpiActivityMs stamps that were using the pre-transaction clock snap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
2026-08-31 Invalidate MSV3 EC-check (soldermask blocks it); four-board mux/tank triage clean
    EC-check (resistive soil-conductivity divider) was root-caused this session down to
    body leakage, then TMUX1109 ESD-diode injection on unpowered switch pins (verified
    against the real datasheet's absolute-max rating), then finally the actual blocker:
    soldermask over the electrodes prevents the galvanic contact a DC measurement needs,
    and conformal coating would make it worse. No resistor value fixes a missing
    conductive path, so EC-check is invalidated at the design level. R17 was still sized
    (100k -> 500M Ohmite HVC0805Z5006JET) and added to the BOM since it's cheap, but it
    doesn't make EC-check work. TMUX1109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
2026-09-03 Bench-tune MSV3 IDRIVE, solve f_INT, fix bring-up DRDY regression
    Closes Test 4 of the MSV3 bench plan and tunes DRIVE_CURRENT_CH0 against a
    real oscilloscope for the first time.
    f_INT solved: 44.27 MHz for this chip, from a paired scope frequency
    (3.30 MHz dry) and DATA_CH0 (20,012,154) captured at the same moment with
    probes attached. Every DATA_CH0 on this board now converts to absolute
    capacitance, so the +/-23% internal-oscillator spread no longer propagates
    into every derived number. True unprobed stray + electrode capacitance is
    ~59 pF, superseding the ~75 pF estimate that assumed f_INT = 43.4 MHz.
    IDRIVE 0x8000 (code 16) -> 0xC800 (code 25) in both sketches. Code 16 ran at
    ~0.5 Vpk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
2026-09-03 Re-verify MSV3 wake settle after the IDRIVE retune
    The bring-up sketch requires wakeprofile be re-run whenever the tank or IDRIVE
    changes, since drive current affects how fast the oscillator settles after a
    cold wake. IDRIVE moved code 16 -> 25 today, so this closes that requirement.
    No transient. Sample [0] sits 0.8 sigma from the [6]-[11] steady-state mean
    against the 274-count within-level SD measured from 175 samples the same
    session, and sample [5] is HIGHER than [0] -- a settling transient decays
    monotonically, this does not. BLE_WAKE_DISCARD_CONVERSIONS = 2 stays valid.
    Also confirms code 25 is live on the hardware rather than only in source:
    the readback reports code 25 and DATA_CH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
2026-09-03 Add BLE OTA to the MSV3 production sketch, proven on hardware
    Step 2 of MSV3_BLE_OTA_PROOF_2026-09-02.md's adoption sequence. The production
    sensing sketch now registers ResetSafeBLEDfu and has been updated end-to-end
    over BLE on real hardware.
    The DFU service is registered in GATT only, never advertised: startAdv()'s
    static_assert shows Flags(3)+TxPower(3)+mfg header(2)+mfg(23) is exactly the
    31-byte legacy PDU limit, so there is no room for a service UUID. Updaters find
    the probe by DEVICE_NAME in the scan response. The manufacturer payload is
    byte-for-byte unchanged, verified live over the air.
    Registering the service alone would have been decorative. At the original 500ms
    advertising w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
2026-09-03 WIP: MSV3 recoverable signed bootloader -- board in BLE recovery, app not booting
    Checkpoint of unfinished work so it can be resumed elsewhere. The bench board is
    SAFE but has no running application. Full state, evidence and resume steps are in
    MSV3/docs/MSV3_OTA_BOOTLOADER_HANDOFF_2026-09-03.md -- read that first.
    Adds a board-specific Adafruit nRF52 bootloader build (SIGNED_FW, DUALBANK_FW,
    DEFAULT_TO_OTA_DFU, real P1.10 status LED, no phantom DFU buttons), a reproducible
    release/signing pipeline, and OTA power/reliability changes to both sketches.
    PROVEN on hardware: the bootloader's BLE recovery mode works. The board currently
    has no application at all and is sitting in OTA DFU adverti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
2026-09-04 Build MSV3 bootloader release 1.0.1 (single-bank)
    Release 1.0.0 enabled DUALBANK_FW=1, which is not Adafruit's tested
    configuration. On real hardware it accepted and validated a signed
    application transfer at every DFU control-point step and then failed
    bank-0 boot validation, so the board returned to BLE recovery instead of
    running the app. Confirmed independent of image size: a 21KB image failed
    identically to a 131KB one.
    1.0.1 is the same build with DUALBANK_FW=0. Single-bank is Adafruit's
    default and proven path, and the property that actually prevents bricking
    -- no valid app implies BLE recovery -- comes from DEFAULT_TO_OTA_DFU,
    not from dual-bank.
    Also here:
    - The build now fails w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
2026-09-04 Record the MSV3 24h water immersion and air recovery
    Sensor 4 sat fully immersed in tap water for ~24 hours, then in open air.
    Normalized capacitance-above-bare went ~23-24% (air) -> ~118% (immersed)
    -> 23.8% (air), a 4.96x change in electrode-contributed capacitance.
    The informative part is the absence of a recovery tail: baseline returns
    within about one sample. Water that had wicked into the FR-4 laminate or
    under the soldermask would dry out over hours as an exponential tail on
    the connected channel, and after 24 hours of immersion none appeared.
    That addresses the ingress concern in
    MSV3_SOIL_INGRESS_AND_COATING_REMEDIATION_2026-08-30.md for the
    clean-water case only; it does not repla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
2026-09-04 Make MSV3 BLE OTA work end to end, and move the flashers to the root
    A conformal-coated probe in soil can now be updated with no cable and no
    SWD. Proven on probe 4 in its pot on battery: jump -> bootloader ->
    signed transfer -> application boot in ~34s, costing 13mV of battery
    (3983 -> 3970).
    Two root causes, both found by recording checkpoints inside the authorize
    callback and printing them from the application loop afterwards. Three
    prior theories -- prepared writes, Bleak version, the Windows GATT cache
    -- were each plausible, each cost a test cycle, and each was wrong.
    Firmware: a write authorize reply carrying BLE_GATT_STATUS_SUCCESS must
    also set update=1 and hand offset/len/p_data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
2026-09-05 Add the MSV3 fleet registry and a fail-closed OTA preflight
    SENSOR_ID is a hand-edited constant and the flasher targeted a raw BLE address;
    nothing connected the two, so an image built for one probe could be sent to
    another and silently mix two plants' data in the receiver. MSV3/fleet.json now
    binds each probe's sensor ID to the addresses it may appear on, the bootloader
    installed on it, and the public-key fingerprint that bootloader trusts.
    ble_ota_update.py resolves --probe through it and refuses any address, package
    identity or signing key that disagrees.
    Every check runs before the radio is touched, because a jump takes a live sensor
    off the air for the length of a transfer and a coated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
2026-09-05 Keep a faulted probe reachable, and make the FDC watchdog flag able to fire
    Two firmware changes land together because they touch the same file, and one
    campaign of evidence for each.
    GUARD 1 -- a sensor fault must not close the radio.
    bool shouldAdvertise = measurementOk && (intervalElapsed || bigSwing);
    measurementOk is false when the FDC fails to wake, fails to read over I2C, or
    reports ERR_WD. So a dead sensor, a stuck bus or water in the connector silently
    closed the only channel through which a coated probe can be reached or updated: a
    hardware fault became an unrecoverable probe. The probe now always advertises and
    marks the reading instead, and the receiver stores nothing for a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
2026-09-05 Make the MSV3 probe identity a build parameter, not a line to edit
    SENSOR_ID was a constant edited in place. Committed source sat at id 5 -- a probe
    that cannot even accept an OTA -- so every build for the deployed id-4 probe began
    with an uncommitted edit that then had to be reverted from memory, and
    ENABLE_SERIAL_LOGS worked the same way.
    That cost is not hypothetical. Probe 4's running firmware cannot be rebuilt from
    this repository: it came from a working tree no commit describes, and its package
    went to the gitignored .arduino-build/ path that later builds overwrote. The
    registry now records that provenance gap against probe 4 rather than leaving it
    implied.
    Identity, serial logging a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
2026-09-05 Groom the backlog into decisions instead of rankings
    "Suggested Next Work" had grown four superseded layers dating back to 2026-07-25,
    each one kept by ranking rather than by decision, and most of it was overtaken by
    the OTA campaign. A list where nothing is ever closed stops being a list.
    Every item now has a verdict: do next (in order), blocked with the reason named,
    dropped with the reason, or converted from an open question into a decided fact.
    The old text is archived inline rather than deleted.
    Two items were mis-filed as blocked and are not:
    - Migrating bench boards 1-3 off the stock bootloader needs USB, not SWD. Those
    boards keep USB CDC precisely because they are still on the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
2026-09-05 Measure rollback: the bootloader installs an older signed image
    The mutated-image work left replay as the one untested class, with the leading
    hypothesis that it would be accepted. Tested on probe 99 and it is.
    Two packages built from one source tree at SENSOR_ID=99, differing only in build
    tag and package version -- deliberately synthesised rather than reusing an
    archived release, because both archived releases carry identity MSV3-MOISTURE-005
    and flashing one to the bench board would reproduce the sensor-5 data pollution
    already on record. The board was installed with version 65540 and its build id
    read back over BLE, then offered 65539. It transferred in 35 s and booted it; the
    readback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
2026-09-08 Make the SWD erase prove it happened, and install bootloader 1.0.2 on probe 99
    A mass erase reported success and erased nothing. Probe 99 came back running its
    own two-day-old firmware after a "successful" 1.0.2 install, and the follow-on BLE
    seed failed against a board that was never in the state the tooling believed it was.
    Everything here follows from that.
    WHY THE ERASE FAILED. Not the first two hypotheses, both of which were measured and
    refuted. NVMC ERASEALL is ACKed at the SWD layer and then FAULTS on the AHB bus:
    DP CTRL/STAT reads 0xF0000060 with STICKYERR set, NVMC never asserts busy (READY==1
    on all 64 samples across 65 ms), flash untouched. CONFIG was confirmed EEN by reading
    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
2026-09-13 Find out why the 50-cent sensor beats the FDC, and plan the test that settles it
    Same-pot measurement across all three generations confirms the premise: the
    v1.2 amplitude sensor extracts moisture with far less thermal contamination
    than either of ours. Probe 4 sits at -0.387 %/C with r = -0.928 over five
    consecutive clean days; the v1.2 on the same days is 10-50x quieter. Its own
    bare tank accounts for only ~10% of that slope, so the rest is the
    electrode-soil path.
    Mechanism: FM puts the soil inside an oscillator, where frequency is set by a
    phase-balance condition whose tightness is set by Q -- and the soil sets Q. A
    tank Q near 2 predicts 0.212 %/C against 0.194 %/C measured. AM makes t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
2026-09-13 Compensate MSV3 temperature in the receiver, and keep the raw observation
    An MSV3 probe keeps advertising exactly what it measures: connected FDC count,
    die temperature, bare-tank count, and tank phase. DisplayCenter derives and
    stores the compensated signal separately, so the raw number is never
    overwritten and a bad model can be revised after the fact rather than losing
    the data it was fitted to.
    The causal model removes the bare-tank reference first, which needs no learned
    coefficient, then applies a temperature term whose gain scales with a slow
    estimate of capacitance excess. Both filters are causal and hold only a few
    scalars, so it runs on the ESP32-S3. On held-out data it removes ab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
2026-09-13 Replace the boot guard that could not survive a watchdog reset, and prove the archive
    Guard 2 used GPREGRET2 and failed the real watchdog-hang acceptance test on
    probe 99: its linker-reserved record did not survive the reset it existed to
    detect. Bootloader 1.0.3 moves the counter into retained RAM and the guard now
    passes that test. Probes 5 through 8 run it; probe 4 does not, and its fleet
    entry records that its bootloader does not reserve the record.
    Separately, verify_msv3_release_archive.py compared the bytes on disk against
    both tracked integrity records and found SHA256SUMS.txt and
    release-manifest.json disagreeing with the bytes and with each other. Several
    packages had been rebuilt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
2026-09-13 Record the probe diagnostics that have no tool, and the bring-up path that does
    Three investigations are written down because the next person deserves the dead
    ends rather than having to re-walk them. Probe 7's TMUX1109 gets a root-cause
    test plan that explicitly forbids reflowing or removing the mux until the
    electrical evidence is captured, because pulling the part destroys the only
    evidence of why it failed. Probe 4 gets an experiment designed to separate
    FDC2214 per-conversion settling from a longer cold-wake transient, which the
    existing telemetry cannot distinguish. Identifying which physical probe sits on
    which Windows COM port gets a page of pitfalls and no script, because the
    approa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
2026-09-14 Stop the temperature compensation from making probe 8 worse than no compensation
    v2 seeded every probe with a positive gain and then rejected any fit that came
    back negative. Probe 8's real coefficient is negative, so across ten days of
    real history it produced four fits, all four were rejected, its gain stayed
    pinned at a seed it could never fit its way out of, and it applied a
    wrong-signed correction the whole time.
    Measured daily peak-to-peak, per-day detrended:
    probe 8 uncorrected 0.907% v2 2.289% v3 0.701%
    probe 4 uncorrected 10.385% v2 9.334% v3 9.422%
    v2 was two and a half times worse than doing nothing on probe 8. The live
    cloud rows show it plainly: that probe's co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
2026-09-14 Refuse to sign a fleet image that cannot be recovered over the air
    Probe 6's signed post-coating diagnostic v65561 had a USB dfu command but no
    application-side GATT DFU service and no automatic advertisement. After its
    sensitivity test, BLE-only restore was impossible even though bootloader 1.0.3
    was intact, and the board had to be reached by USB data to enter recovery. On a
    probe whose USB and SWD access may already be under coating, that is a brick.
    The rule is now enforced rather than remembered. arduino_msv3_probe.ps1 inspects
    every build made with -SensorId and refuses it unless it contains the reset-safe
    BLE DFU service, DIS build identification, a periodic bounded advertising
    cadenc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
2026-09-14 Lower MSV3 BQ25504 VBAT_OV to a ~3.90V storage ceiling
    Field probes were reading 4.27V on the battery node, above the 4.20V LiPo
    cell spec. That matched the as-built OV divider: R11=5.62M / R14=4.42M
    programs VBAT_OV to ~4.26V. A solar-floated cell sits near the ceiling
    continuously, so this is a float/calendar-aging duty, not a cycling one.
    Swap R11 5.62M->4.42M and R14 4.42M->4.12M, moving the harvester charge
    ceiling to ~3.90V (3.887V at VBIAS 1.25V typ; ~3.897V using the 1.2532V
    backed out of the board's own 4.27V reading). Divider sum drops
    10.04M->8.54M, still inside TI's <=10M rule. Both values were already in
    stock and already used elsewhere on the board (R9=4.42M, R15=4.12M), so
    no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
2026-09-15 Archive Probe 7 repair and USB OTA follow-up
2026-09-15 Put probe 6 on capless firmware, and add the hybrid rig that tests the probe end
    The capless rollout is receiver-first, and DisplayCenter had only ever been
    compile-verified because COM3 was occupied by the v1.2 overnight test. That rig
    is unplugged, so the capless-aware receiver (Treebeard runtime build 2026-09-14
    msv3-capless-scale3) is now actually installed and running on COM16. Probe 6
    then took signed capless production v65564 over BLE in 38 s through its resident
    1.0.3 bootloader.
    The DIS build ID was proven by re-running the SAME package: check_running_build()
    refuses before the jump opcode is written, so the running build is read off the
    live device without taking it off the air an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
2026-09-15 Give a dead MSV3 a wired way back, without touching the DFU state machine
    Bootloader 1.0.4. BUILT AND INSTALLED ON NOTHING: no probe runs it and none may
    until the acceptance list in the requirement document passes on probe 99. A build
    is not evidence about behavior.
    The problem is narrow and it is about coated probes. Stock 0.11.0 brings up one
    transport -- `if (_ota_dfu) ble_stack_init(); else usb_init();` -- and
    DEFAULT_TO_OTA_DFU forces _ota_dfu whenever `!valid_app || dfu_start`. The USB
    branch is unreachable in exactly the case that matters: a dead application on a
    board whose SWD pads are under conformal coating, with BLE as its only way back.
    The first implementation ran both trans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
2026-09-15 Make USB a normal MSV3 transport, with BLE OTA running on top of it
    Supersedes the sequential window in ceedeb1. That version opened USB for a bounded
    10 s and then fell through to BLE, which answered the wrong question: the ask is to
    use USB normally, not to catch a window.
    1.0.4 now runs BOTH transports in one session. Whenever the bootloader is in DFU
    mode and VBUSDETECT shows a cable, USB CDC serial DFU is up for as long as the cable
    is there -- no timer, nothing to miss, no mode to select -- and BLE OTA runs on top
    of it rather than instead of it. Whichever transport a host actually uses performs
    the update. With no cable, usb_init() is never called and behavior is byte-for-byte
    1.0.3,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
2026-09-15 Record how 1.0.4 reaches a board, and why the coated probes are the hard case
    Answers the deployment question by reading the DFU stack rather than assuming.
    Mechanically a bootloader update does not require SWD: dfu_start_pkt_handle()
    dispatches IS_UPDATING_BL() to dfu_activate_bl(), that path is present in the
    single-bank build and not only the banked one, and probe 4 already took a
    SoftDevice + bootloader + application package over the air from the stock loader on
    2026-09-03 with swd_accessible false.
    Two things stand in the way, and neither is a property of 1.0.4 itself. The package
    type does not exist: build_msv3_release.ps1 builds SD+BL+APP only with
    --dev-type 0x0052, a deliberate one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
2026-09-16 Measure the panel at the pin, and let it rewrite the clamp and V4
    VIN_DC moves from datasheet inference to measurement: 5.0 V loaded in
    direct sun, 4.7 V at the deployment window. The window peak was predicted
    from probe 6's own cell voltage before it was measured, and the ceiling
    turns out to be arithmetic -- VBAT = 0.78 x V_OC - 0.3 V reproduces every
    charge observation on file, with VBAT_OV appearing nowhere in it.
    That closes the root cause and changes the fix. A shunt zener clamps the
    open-circuit excursion too, so the BQ samples V_OC = Vz and regulates to
    78% of it; the panel ends up at 2.57 V, not 3.3 V. Dissipation is a
    non-issue once the 16 s / 256 ms MPPT sampling is verified -- t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
2026-09-17 Put probe 7 on capless production and teach the fleet scan its diagnostics
    The fleet scan reported probe 7 as NOT SEEN while it was advertising at
    its registered address. It was running the targeted bring-up image,
    whose heartbeat uses the distinct "MSV3" magic, and the scanner dropped
    every packet that was not production telemetry. The only decoder for
    that format lived privately in ble_ota_update.py.
    That decoder now lives in msv3_fleet.py and marks the packet as
    diagnostic. Flag bits the bring-up layout never defines read None, not
    a misleading False. The scanner reports such a probe as DIAGNOSTIC, never
    shows its 0 as a reading, and flags one that is registered deployed,
    because the rec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
2026-09-17 Size V4 solar from probe 4 recharge data
2026-09-19 Turn probe 4 into the inverted-hybrid rig: MSV3 electronics driving a v1.2 sensor
    A v1.2 sensor jumpered across probe 4's tank at the C17 pads separates "the MSV3 electronics
    swing with temperature" from "the MSV3 electrode/soil interface does".
    - New build flags -HybridV12Tank / -HybridMuxCode 0|2 (default off). The default build is
    byte-identical to HEAD, checked by building both with the same flags. Invalid combinations are
    refused, including a mux code without the hybrid flag.
    - v65566 (mux code 2 only) read ~10.5 MHz, above the FDC2214's range; v65567 (mux code 0, MSV3
    blade held in air as padding) reads ~6.2 MHz. Both were installed over BLE, with the DIS build
    ID and wake pro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
2026-09-19 Add MSV4 BLE bring-up firmware, its LFXO variant, build script and console
    MSV4 has no USB, so bring-up is a Nordic UART console over BLE: vbat, temp, drive, iq, sweep,
    swap, chop, and a multi-frequency `spectrum` impedance fit. A dead 32 kHz crystal escapes to
    the bootloader's BLE DFU instead of bricking the board. The variant is tracked and selected
    with build.variant.path, so it never fights MSV3's LFRC rewrite of the installed core. The
    ADC pins follow the final layout. The script refuses to sign with MSV3's device type unless
    told to. Not yet run on hardware.
2026-09-19 Audit the MSV4 layout against its netlist and model the electrode physics
    - The IPC-2581 layout audit found floating copper, copper under the crystal, a floating Q1
    gate, a lost U1 component record and stale ADC pins; all were resolved. The final netlist
    matches the layout pin for pin.
    - A 2D complex-permittivity field solve of the drawn electrode shows the geometry is sound (about
    5x MSV3's depth). At 1-4 MHz in moist soil the reading is conductance- and interface-
    dominated, so Rsoil is the moisture proxy, Cm is a contact-quality channel, and soil
    permittivity is not identifiable.
    - The measured polarity chain shows every shared-pot rig reads drier when warm; the damping-sign
    c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
2026-09-19 Order MSV4 x5 and make LCSC orders deterministic
    - MSV4/procurement: the 5-board LCSC upload (every line on a verified C-number, MSV3 and
    DigiKey leftovers subtracted, DisplayCenter #2 shortfalls included), the full-BOM mapping,
    and a Markdown pull-from-stock checklist that cannot be uploaded by mistake.
    - hardware/procurement/lcsc_verified_parts.csv: C-numbers verified live with dates and known-dead
    alternatives. Fuzzy text matching had picked discontinued parts, backorders, and a 10 milliohm
    shunt for "10M".
    - New lcsc-bom-order skill. Treebeard_Passives regenerated through Altium (verifier passed): the
    resistor Comment carries " ohm", and Procurement Class says to freeze the LCS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
2026-09-19 Record the 09-15..09-19 notes: VIN_DC clamp, probe 7 zener, V4 BOM/solar, paper, handoff
    Maintainer edits carried in the working tree, plus the 2026-09-18/19 handoff section:
    bring-up firmware status, layout audit, electrode physics, probe 4's hybrid state and its
    role as the shared pot's temperature reference, and the orders placed.
2026-09-20 Fix probe 5 firmware, clean probe 4 history, and score the 2x2 thermal rigs
    Probe 5 was placed in the shared Alocasia pot as the MSV3-blade + FDC arm but
    was running pre-capless v65555 on C17-removed hardware, computing moisture=0
    with a 65.5M out-of-range bare-tank channel. Installed signed capless v65564
    (2026-09-14-capless-prod5) over BLE in 32 s; DIS proven via the
    already-running-build refusal so the probe never left the air. Its 116M phase
    gap was insertion transients, 47,934 once settled.
    Deleted the 18 out-of-range v65566 rows from msv2_sensor_history (sensor 4,
    2026-09-18 23:39:31-23:59:21 UTC) with a full-column backup and a tracked audit
    note. Corrected probe 4's history split po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
2026-09-20 Repair five stale doc links and record the repo review findings
    TREEBEARD_ADAPTIVE_MOISTURE_CALIBRATION.md became
    MSV2/docs/MSV2_ADAPTIVE_MOISTURE_CALIBRATION.md in the f9fe74d reorganisation
    and five references were never updated, one of them also pointing at the wrong
    directory. Found by resolving every markdown link relative to its own file
    rather than by basename.
    REPO_REVIEW_FINDINGS_2026-09-19.md records the rest, split into fixed, open,
    and checked-and-cleared. Open items needing a decision: BATTERY_CURVE still
    maps 4200 mV to 100 percent so a reworked probe caps near 63 percent, and one
    shared curve can no longer serve both the reworked and as-built populations;
    the raw-probes-v6555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
2026-09-20 Bring edc9705 onto this branch and upgrade the divider finding to a spec violation
    Cherry-picked edc9705 so MSV3_VBAT_OV_STORAGE_REWORK_2026-09-14.md is readable
    from this branch. Its absence caused two errors earlier today: a threshold
    quoted as a 3.89 V crossing when the restart envelope is ~3.77-3.92 V, and a
    documented maintainer record downgraded to a hypothesis.
    Both conflicting hunks resolved in favour of this branch, which carries the
    later 2026-09-15/16 corrections. Specifically NOT reintroduced: edc9705's claim
    that the reworked 8.54 MOhm divider sum is "still inside TI's <=10 MOhm
    recommendation". Section 7.3 gives MIN 9 / NOM 10 / MAX 11 MOhm, so 4.42 + 4.12
    = 8.54 MOhm is 0.46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
2026-09-20 Make fleet.json the single source of physical state, verified by the maintainer
    Physical state was being inferred from dated documents that are never retro-
    edited when hardware moves. That produced repeated errors: an electrode type
    mislabelled, a probe misidentified, probe 6 analysed as a solar test while
    sitting on a desk with no sun, and probe 4's zener missed entirely.
    fleet.json now carries, with a verified date and a source:
    - probes[].physical_state: location, pot, room, power, the electrode ACTUALLY
    in the soil, readout, and mods (divider swap, zener, coating, C17)
    - non_msv3_nodes: sensors 1, 2, 3 and 9 report to the same receiver but are not
    MSV3 probes, so they had no entry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
2026-09-20 Record the probe 4 zener and re-baseline the handoff against verified state
    The maintainer confirmed probes 4 AND 7 both have an SP+ shunt zener. Today's
    charging analysis assumed only probe 7 did, and so treated "VBAT_OV working"
    and "dead harvester" as the only two explanations for probe 4's lost charging
    ramp. Probe 4 changed two things at once, divider and clamp, so a third
    hypothesis is now recorded: the zener clamping SP+ too low for the harvester to
    work. On probe 7 the temporary 1N4728A was measured holding SP+ below 2.2 V in
    direct sun, so this is expected soft-knee behaviour rather than a remote case.
    The 3.89 V crossing still separates "VBAT_OV working" from the other two, but
    it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
2026-09-20 Record the power-topology confound: probe 4 is the only isolated rig
    Confirmed with the maintainer: sensors 3 and 9 are ESP32-powered and probe 5 is
    USB from the computer, all on ONE shared mains outlet. Probe 4 is battery only.
    (An earlier answer putting probe 4 on the power strip was a slip; its telemetry
    agrees, since it has been falling at -53.6 mV/day with no charging.)
    That means three of the four electrode x readout corners share an outlet and
    the fourth does not -- and the fourth, probe 4, is the quietest rig by 4-5x.
    "Probe 4 is quiet because it is galvanically isolated" explains the headline as
    well as any electrode or readout mechanism, and this data cannot separate them.
    Sensor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
2026-09-20 Elevate the power confound in the thermal doc
    Section 4 now states the full topology and its consequence: probe 4 is the
    quietest rig by 4-5x and is also the only galvanically isolated one, so
    "isolated, therefore quiet" explains the headline as well as any electrode or
    readout mechanism. The results table carries the same warning inline.
    Marked clean: the within-AM comparison, since sensors 3 and 9 are both
    ESP32-powered on the same outlet so power cancels. Marked confounded: probe 4
    against either AM rig, and the FDC pair. Moving probe 5 to battery is promoted
    to the cheapest available fix, and is the only corner that can be fixed at all
    since the AM rigs cannot run on battery.
    Co-Author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
2026-09-20 Demote the power confound: same-outlet rigs differ 2.9x in thermal response
    The maintainer pointed out that sensor 3 is hardwired and is nonetheless the
    most temperature-immune rig they can see in the data. That is the control this
    analysis already had and did not use.
    Sensors 3 and 9 are both ESP32-powered on the same outlet, so their mains
    exposure is identical. Per-day against probe 6's room reference, s3 runs
    8.04/9.86/7.54 mV/C against s9's 20.35/21.41/31.20 mV/C -- about 2.9x apart,
    consistent with the 3.16x measured on the single clean day. Mains coupling
    therefore does not explain which rigs are thermally quiet on this bench.
    So "probe 4 is quiet because it is battery-isolated", wh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
2026-09-20 Record the maintainer's two-factor measurement model
    The question this repository has been circling -- is the thermal artifact in the
    electrode or the readout -- is the wrong question. The maintainer's physical
    reading is that both contribute, separably: FDC readout is low-noise but
    temperature-susceptible; the v1.2 driving circuit is noisy but has low
    temperature susceptibility; the MSV3 blade electrode is VERY
    temperature-susceptible; the v1.2 electrode is not.
    That resolves what the single-factor analysis could not. The apparent electrode
    effect measured 1.36x within the AM pair and about 4x within the FDC pair
    because the readout adds its own temperature term on top, so neither number w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
2026-09-20 Supersede the single-factor framing in the thermal document
    Adds the two-factor model as a header on MSV3_ELECTRODE_VS_READOUT_THERMAL and
    revises the probe 5 prediction to match it: blade plus FDC stacks the very
    temperature-susceptible electrode with the temperature-susceptible readout, so
    it should show the largest thermal response of the four corners and, being
    low-noise, show it cleanly.
    The measurements in that document stand -- the numbers, the offset trap, the
    units problem, the autocorrelation limits, the clean-window derivation. Only the
    framing that one factor must win is superseded.
2026-09-20 Test the two-factor hypothesis and record the decomposition
    Probe 4's own history gives one board, one readout and three electrode
    conditions, which sidesteps the AM-vs-FDC units problem entirely: bare tank with
    the electrode disconnected, blade in soil, and v1.2 in soil.
    Supported: the FDC readout carries its own temperature term, r=-0.994 at
    -0.041 %/C with no electrode attached, real and almost perfectly thermal but
    about 8x smaller than the blade's contribution. And the blade is far more
    susceptible than v1.2 -- isolated electrode terms of -0.346 vs +0.094 %/C, a
    3.7x ratio with opposite sign, against an independent 2.9x from the AM readout.
    Two measurement chains in two different units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
2026-09-20 Withdraw the 3.7x electrode ratio as cross-pot
    The maintainer flagged that a probe's data is not 1:1 across a pot change.
    The decomposition subtracted across exactly that boundary: probe 4's blade term
    came from its own pot (09-05..09-09) and its v1.2 term from the shared pot
    (09-19). Different soil on each side of the subtraction, so the 3.7x ratio
    between them is not evidence of an electrode property.
    This also re-explains what was recorded as a board reproducibility problem.
    Probe 4's blade figure was its own pot and probe 8's was the shared pot, so the
    opposite signs are two pots rather than two boards -- which the 09-13 thermal
    document already stated.
    Surviving: the readout term, -0.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
2026-09-20 Verify the 2.9x window and add the post-insertion settling caveat
    Maintainer confirmed the insertion dates for the shared Alocasia pot: sensor 3
    has been in it throughout with no pot change, sensor 2 likewise, sensor 9 went
    in 2026-09-14 about 18:30, probe 4 on 09-18 20:53 and probe 5 on 09-19 about
    20:24.
    That verifies the within-AM 2.9x as clean -- both rigs were in this pot, in the
    same soil, on the same days, well before the 09-17..09-19 window. It is now the
    only surviving electrode evidence in the decomposition document.
    It also puts a caveat on probe 4's own v1.2 figure. The +0.053 %/C comes from
    the first ~18 hours after its insertion, while soil was still closing around the
    sensor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
2026-09-20 Consistency sweep: fix stale claims that contradict the verified state
    Swept all 113 markdown files for claims contradicting the physical state
    verified with the maintainer on 2026-09-19. Most hits were correction notices
    quoting stale text, which is intended. Four were real.
    STATUS_HANDOFF claimed probe 6 still has the as-built OV divider and charges to
    4.26 V. That contradicts both fleet.json and line ~516 of the same file, which
    says probe 6 charged with a 3.887 V ceiling programmed. Probe 6 was reworked;
    every field probe except probe 7 was.
    MSV4_FRONT_END_ARCHITECTURE still asserted "the electrode redesign is the fix"
    below the DISPUTED block added earlier. Superseded: the electrode i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
2026-09-20 Bring the README up to date with September's work
    The README described the project as of 2026-08-30. Since then MSV3 became an
    over-the-air-updatable fleet, the bare-tank reference channel was retired, the
    coating failure was re-explained as electrode geometry, and MSV4 was designed
    and ordered.
    - Add MSV4: its own section, a row in the evolution table, a repository-tour
    entry, and a doctor command. Stated as ordered 2026-09-19 with no hardware
    built and no firmware yet run.
    - Add a "Where things stand" table carrying the 2026-09-19 verification date
    and the real probe disposition.
    - Replace the claim that MSV3 packets carry a disconnected bare-tank
    reference. That channel is gone;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
2026-09-21 MSV3 bootloader 1.0.24: make wired DFU work again, the way stock does
    Probe 8 now flashes over USB with the UNMODIFIED stock client -- what the
    Arduino IDE upload button runs -- and over BLE OTA. Verified by a full
    259-frame "Device programmed", then independently by scan and by a DIS read
    of the exact build tag the cable delivered.
    The cause was ours. Stock 0.11.0 brings up exactly one transport:
    if (_ota_dfu) { mbr_init_sd(); ble_stack_init(); } // SoftDevice ENABLED
    else { usb_init(serial_only_dfu); } // wired: never enabled
    so a stock wired session has no SoftDevice, synchronous flash, and an
    application-bank erase that completes before dfu_start_pkt_handle()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
2026-09-21 MSV3 tooling: a tracked DFU trace reader, and bootloader-package support
    msv3_read_dfu_trace.py reads the bootloader's retained decision record out of a
    PASSIVE BLE scan. Passive matters: the failure under investigation was in the USB
    endpoint, and opening a GATT connection to ask would perturb the thing being
    measured.
    The scan-response layout is an ABI shared with scan_response_init() in
    dfu_transport_ble.c, and three bytes have been reused across builds, so every
    reused byte is keyed on build_id. Four readings were mislabelled before that was
    done -- an inverted transport constant reported a serial record as BLE, and a
    withdrawn build's field name printed a confident conclusion about a f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
2026-09-21 Record the wired DFU resolution, and the two habits that made it expensive
    fleet.json is the source of physical state, so it carries the verified result:
    probe 8 on msv3-1.0.24 / v65589, both flashing paths proven, plus the warnings a
    future session needs -- that the scan-response layout is an ABI with three reused
    bytes, and that the nonce and build_id must be checked before anything else in
    the record is believed.
    MSV3_WIRED_DFU_RESOLVED_2026-09-21.md is the technical account: the 1.0.4 origin,
    the four defects and which were measured rather than inferred, how a wired
    session reconfigures itself, why the lease is a safety property, and an honest
    split of which of the twenty-odd releases w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
2026-09-22 MSV3 bench probe live readout + LED identify, in the app's Bench tab
    Adds a Bench tab to the receiver's mobile app (MobileAppPage.h), showing a
    live FDC2214 readout from MSV3 bring-up probes: raw counts, board temp,
    battery, mux code, FDC STATUS, RSSI, wake counter, packets and age. Backed
    by a new GET /bench-data endpoint, polled at 2Hz only while the tab is
    visible. Also adds an Identify button per probe, backed by POST
    /bench-identify, which drives a new connectionless command beacon: the
    receiver advertises a "TBCM"-magic packet and the bring-up firmware scans
    for it (BLEScanner), blinking the status LED on the addressed probe only.
    Two earlier shapes of this were rejected and are recor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
2026-09-22 fleet.json: probe 8 bench firmware v65594, Alocasia pot re-verified 2026-09-21
    Probe 8: installed_application_version -> 65594 (bench-session-fix build),
    diagnostic_state updated to describe the bench live-broadcast mode and
    command beacon added today - see the Bench-tab commit for the firmware
    side.
    Separately, the maintainer re-confirmed 2026-09-21 that the shared
    Alocasia pot's sensors, electrodes, power connections and pot assignment
    are unchanged since the 2026-09-19 verification (probes 2, 3, 5, 7, 9).
    Records a probe 5 clarification: no battery is attached, and its
    battery-mV telemetry rising when the host PC sleeps is a
    power-state artifact of the USB supply, not a real battery read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
2026-09-22 arduino_msv3_probe.ps1: signed wired USB upload path (-Action upload)
    Adds -ApplicationVersion and -PackageOnly, and makes -Action upload sign
    the compiled sketch (device_type 0x3356, matching the anti-rollback
    version into the init packet) and deliver it with the stock
    `python -m nordicsemi dfu serial` client instead of `arduino-cli upload`.
    The Arduino IDE upload button and plain arduino-cli both run the Adafruit
    recipe, which builds an unsigned package tagged with stock device type
    0x0052. This bootloader is SIGNED_FW and bound to 0x3356, so it must
    refuse that image - and because single-bank DFU erases the application
    before authenticating the init packet, a rejected upload costs the pr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
2026-09-22 DisplayCenter enclosure: move antenna inside, close the rear bulkhead hole
    The antenna is now internal to the enclosure rather than folding out
    through a rear opening. Closes the former 10mm rear bulkhead through-hole
    with the full 2.6mm rear-wall thickness, removes the now-obsolete external
    antenna reference STEP, and updates validate_desktop_enclosure.js to
    assert that file is gone rather than checking its geometry.
    README updated to say the antenna's exact placement and cable routing
    must be checked against the physical PCB before assembly, since the
    antenna itself is not modeled in the enclosure STEP files.
    Regenerated STEP/STL outputs and design/validation reports from the
    updated gen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
2026-09-22 MSV3: Alocasia pot thermal checkpoint and analysis script (2026-09-21)
    Adds analyze_alocasia_thermal.py, which summarizes a same-pot Alocasia
    thermal run from raw history CSV exports (cloud/scripts/fetch_supabase_
    history.py --raw), and the checkpoint doc recording its output against
    the pot/electrode/readout state fleet.json describes as of 2026-09-21.
2026-09-22 MSV4 PIN_NET_REFERENCE: record a future-revision candidate for U3/U4 power gating
    U3/U4 (FSUSB42 analog switches) already draw at most ~2uA combined while
    disabled (both /OE HIGH) on the current board - about 0.048 mAh/day - so
    this is not a rework candidate for boards already built. Documents what a
    future revision would need to add a GPIO-controlled high-side power gate
    (SW_AFE_3V3) instead, including the R21/R23 control-input rail change
    this requires and the five preconditions (default-OFF at reset, sleep/wake
    sequencing order, and the FSUSB42's residual +-2uA IOFF per port even when
    gated) that would have to hold for it to be safe.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
2026-09-25 Add MSV4 printable enclosure variants
2026-09-25 MSV3: multi-probe pot test - watering review, audit, data findings, probe 7 flip
    The 2026-09-22 watering review, then an audit of it against the raw data and a
    model-free look at every rig through 2026-09-24 22:55 PDT.
    - The daily artifact is the noon sun reaching the shelf (~11:50-12:10 PDT),
    acting mainly on sensor 9 (blade + AM) and probe 7 (Begonia). Probes 4/5 and
    sensor 3 move ~0.8% of a watering per sun pulse.
    - The review's soil-water/sign-flip section and its probe 7 ratios do not
    survive audit; the electrode x readout interaction does (tested correctly
    on differences). Probe 7 did register the watering (+5.1 logC%).
    - fleet.json: maintainer statements recorded (uniform sat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
2026-09-25 DisplayCenter V2 enclosure: P1S 0.4 mm PLA v1 print pack
    Printer-ready release under output/p1s_0p4_pla_v1: two pre-sliced Bambu Studio
    3MF projects (front + stand, rear shell with its own build-plate-only tree
    supports), print STLs, PRINT_IN_BAMBU_STUDIO.md, and the P1S/PLA filament and
    process profiles. Regenerated STEP/STL outputs, design and validation reports,
    renders, CAD and slicer zip packs with SHA-256 sums. The validator passes:
    all parts fit the P1S bed, all meshes watertight and non-degenerate.
2026-09-25 MSV4: conductance-only spectrum fit, lab UI, electrode comparison
    - Bring-up firmware: drop Cs from the spectrum fit. The four-parameter model
    has three observables, so Rsoil moved up to 5.7% with the optimiser seed.
    The three-parameter fit is exactly determined and seed-stable. Adds the
    temperature-corrected `moisture` command; the 4 MHz point is dropped.
    Compiles clean through arduino_msv4_probe.ps1 (variant, linker, map checks OK).
    - test_msv4_spectrum_fit.py proves the degeneracy and the seed stability (ident
    passes). Field-solve output saved under MSV4/generated.
    - MSV4 Lab: local-only browser UI over the BLE console with session export
    (test_msv4_lab.py passes), plus the co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
2026-09-25 MSV3 bootloader: archive generated artifacts 1.0.4-1.0.17
    Release artifacts (signed OTA packages, recovery hex, SHA-256 manifests) for
    the intermediate bootloader builds from the 2026-09-20/21 wired-DFU
    investigation, plus the 1.0.3 sensor-8 bring-up diagnostic package. They go
    under generated/<version>/ per MSV3/bootloader/README.md. All are superseded
    by 1.0.24; kept as the record the wired-DFU resolution doc refers to. The
    withdrawn 1.0.18-1.0.20 are not included.
2026-10-01 MSV3: Alocasia electrode-vs-circuit analysis; fleet.json teardown 2026-09-30
    fleet.json
    - Alocasia pot re-verified 2026-09-29 (nothing moved since 09-24, no
    watering since 09-22).
    - 2026-09-30, maintainer: the Alocasia test is disassembled and every
    sensor leaves every pot except sensor 1 (Thaumatophilum). Probes 4, 5, 7
    and sensors 2, 3, 9 are marked out of soil with their previous
    installation kept under last_soil_installation; telemetry after
    2026-09-30 is not soil data. Which "both ESP32s" were reclaimed (AM rigs
    or DisplayCenter receivers) is recorded as not stated.
    - Probe 5 had the tightest soil fit of all on removal (maintainer).
    Analysis (2026-09-29)
    - MSV3_ALOCASIA_ELE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
2026-10-01 MSV4: sensing-depth derivation, electrode figures, board build checklist
    - MSV4_SENSING_DEPTH_DERIVATION_2026-09-30.{tex,pdf}: Laplace/Fourier
    derivation of the lambda/2pi field depth, the energy share
    1 - exp(-4 pi d/lambda), and the exact soil-over-air share
    (1+rho) tanh(kd) / (1 + rho tanh(kd)), compared with the 2D field solve.
    Build: pdflatex --disable-installer (geometry.sty is not installed).
    - msv4_sensing_depth_figure.py: equation vs field-solve penetration curves
    and median depths (MSV3 0.23, v1.2 1.39, MSV4 1.01 mm by the solve).
    - msv4_electrode_cross_sections.py: to-scale annotated cross-sections of
    v1.2, MSV3 and MSV4 with lambda and lambda/2pi (print PDF/PNG).
    - Bo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
2026-10-01 MSV4 enclosures v5.1: centered solar lead passages for the 2.5 V panel
    Regenerated outputs from generate_enclosures.mjs (working-tree changes from
    2026-09-30 ~23:05, not made in the session that committed them): the two
    1.6 mm solar lead passages become a centered pair 4.0 mm apart, matching
    the rear terminals on the new 2.5 V panels, on the integrated lid, the
    minimum-profile lid and the arm panel frame. STEP/STL outputs, slicer and
    CAD packs, renders, design/validation reports and validator updated;
    SHA256SUMS_MSV4_v5.txt verified against all four packs before commit.
2026-10-02 MSV4 board 1 bring-up: die temperature, Lab Rsoil display, session record
    First MSV4 board flashed and brought up. Every console-reachable bring-up
    check passes after three reworked solder faults (U4 /OE-to-3V3 bridge, A/B
    electrode short, tombstoned part under U4 shorting DRV to SENSE).
    - Firmware: `temp` appends the nRF52840 die temperature (DIE=) via
    sd_temp_get. Installed on board 1 as v262147.
    - MSV4 Lab: parse DIE= as die_c with a Chip temperature card. Show Rsoil as
    open (dry) / no fit and chart it on a log axis capped at 1 MOhm, so the
    10^14+ Ohm air fits no longer flatten the real readings.
    - Docs: board 1 bring-up record (flashing gotchas incl. PSELRESET cleared by
    mass er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
2026-10-02 SWD flasher resets over SWD; MSV4 lock-in walkthrough and notes
    SWD flasher
    - swd_flash_hex.py now ends a flash with SYSRESETREQ over SWD (the
    adapter's `run`) instead of the GPIO7 nRESET pulse, then reads DHCSR
    back and passes only if S_RESET_ST is set and S_HALT is clear. The
    pulse needs a RESET wire and UICR.PSELRESET, and mass erase clears
    PSELRESET: on MSV4 board 1 the pulse and a tweezer short did nothing.
    Exits 2 when the reset is not confirmed. Tested against a simulated
    adapter (7 cases); not yet run on hardware.
    - Flasher help text and SWD_FLASHER.md: `run` is a reset, not a resume.
    - Board 1 bring-up doc: open item annotated. What re-armed PSELRESET is
    unexplained (C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
2026-10-06 MSV4 enclosures v5.2: 7 mm cavity, single wire exit, one 3MF per variant; board 1 scope pass
    Enclosures:
    - Raise the board-to-roof cavity from 4.0 to 7.0 mm on all three variants for
    the 3 mm 301020-class cell that rests on top-side components. Lid tops rise
    3 mm; case screws become M2x10 (arm) and M2x12 (integrated).
    - Arm lid: replace the two 1.6 mm side holes, which stopped 0.05 mm short of
    the PCB compression rail, with one 3.0 mm exit for both panel leads.
    - Raise the arm panel pivot 3 mm to keep panel height over the taller lid.
    - Tie the lid compression rails into the cavity wall above the gasket groove.
    - Export the arm lid by rotation instead of mirroring; the mirrored STL was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
2026-10-07 MSV4 production firmware, BLE OTA tooling, receiver/cloud/History support; outdoor solar test
    Probe (MSV4/arduino/MSV4_Moisture_BLE_Sleep):
    - First unattended MSV4 image: wakes every 60 s, reads battery, tip thermistor and
    die temperature, advertises a 5 s connectable window, sleeps. Spectrum sweep and
    fit on every 10th wake. Hardware layer copied from the bring-up console; duty
    cycle, OTA hold and packet framing follow MSV3 production.
    - Packet reuses the 23-byte MSV3 layout with flag bit7 (v262148), extended to 26
    bytes with die temperature in v262150 by dropping the TX Power AD structure.
    - Cp is calibrated at every boot; boot counter carries only across watchdog,
    software and l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
2026-10-07 MSV4: send Cd, stop presenting an open circuit as readings; console diagnosis of flat History values
    The History page showed sensor 10 flat at moisture 0, Rsoil 400,000, Cm 0 and a constant
    Cp. The bring-up console was put back on board 1 for fourteen minutes to read the raw
    sweep in place. Measured: the electrodes are switched in and measured (phase -20.1 deg
    connected vs -8.6 deg floating at 2.67 MHz), and the fit is 13.0 pF of direct
    capacitance with no conduction, i.e. the blade in air. Production packets agreed with
    the console to the digit, so nothing was lost in transport; in air most of the packet
    simply is not a measurement. Cd is, repeatable to about 0.02 pF, and was not being sent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
2026-10-07 MSV4: recalibrate the ADC offset every wake; record the per-boot battery offset and the window test
    The battery reading stepped up about 13 mV after the 21:41-21:55 firmware gap, in the
    dark. Boot-by-boot means for the same cell: 3826 and 3823 mV (262148, 262150), 3838 mV
    (262152), 3821 mV once the offset was recalibrated (262153). The SAADC offset was
    calibrated once at boot, and the 262152 boot's calibration was about 7 LSB off; that
    image was also the first to run it earlier in setup(). Whether the position or chance
    caused it is not established.
    - Probe v262153 calibrates at the start of every wake, with OVERSAMPLE forced to bypass.
    Scatter is unchanged. Board 1 is on it; DIS reads pr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
2026-10-07 MSV4 v262154: lighter advertising, 1 ms sweep settle, cheaper fit; DC/DC regulator findings
    Probe:
    - The full 5 s connectable window is opened only on measurement wakes (every tenth) and
    the first three wakes after a boot. Other wakes send the same packet as a 4 s
    non-connectable burst at 250 ms, marked with flags2 bit2: about 16 events instead of
    about 56 and no receive slot after each.
    - Sweep settle 5 ms -> about 1 ms (delay(2): the tick-based delay ends on a tick boundary).
    - The divider model is evaluated in real arithmetic; identical to 3e-16 over 200,000 cases.
    - The radio-stall watchdog limit is 20 minutes, twice the connectable-window spacing.
    Host tools:
    - msv4_ble_ota.py an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
2026-10-07 MSV4: E73 module's main-stage DC/DC inductor is inferred present
    Replaces "not established" in the production firmware doc with the
    evidence: Ebyte's module current table is only reachable in DC/DC mode,
    DCC/DEC4 are not on module pads, the nRFMicro designer's notes, and ZMK
    enabling REG1 DC/DC by default on two boards built on this module. Notes
    that the 2017 "no inductors" measurement was Ebyte's nRF52832 module and
    that the high-voltage stage's inductor is absent. Nothing measured on a
    Treebeard board; DC/DC is still not enabled.
2026-10-09 MSV4 v262155-262161: DC/DC on, warm-start fit, Cp calibrated only on a sane air reading, one-minute test cadence; solar test concluded; first soil reading
    Firmware (MSV4_Moisture_BLE_Sleep):
    - 262155: nRF52840 DC/DC regulator on after the first wake, read back in flags 2 bit 3.
    - 262157: warm-start fit (one fit from the last full fit's answer, four cold starts as the
    fallback), flags 2 bit 4.
    - 262158: discharge burn test build (-BurnFloorMv), flags 2 bit 5; 262159 is 262157 relabelled.
    - 262160: Cp is no longer calibrated at boot. The moisture reading comes first and Cp is
    measured only after a sane reading in air (valid, nothing conducting, residual < 0.0255),
    once per boot; until th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
2026-10-09 README: plain-language rewrite, brought up to 2026-10-08
    The README still described 2026-09-19: MSV4 as ordered with nothing built, and MSV3 as the
    probe currently in the soil. It now opens with what the probe, receiver and dashboard are in
    everyday terms, states where each generation stands (first MSV4 board running, solar-verified
    and in a pot since 2026-10-08; MSV3 out of the soil since the comparison test ended
    2026-09-30), describes MSV4 as built (conductance fit over eight frequencies, one 2 V panel),
    trims the findings to three with links to their write-ups, and lists the real open items. The
    top link no longer points at the handoff file frozen on 2026-09-19.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
2026-10-09 MSV4 enclosures v5.3: back-entry screws, flat arm mounts, chamfered edges
    Case screws on the integrated and arm variants now enter from the base back
    into recessed countersinks and thread into inserts in the lid; the gasket
    groove moves to the base seam face to make room. The arm pivot bosses and
    panel-frame lugs end on their back planes so both parts print flat. The outer
    back and top perimeters of all three variants are chamfered.
2026-10-12 MSV4: experimental moisture readings, first watering and the competition against the pot's weight; build 262163 pending
    - Soil-coupled capacitance (Cm + Cd - air) and the signal-relative fit residual: analysis script,
    History cards on the receiver page, per-boot air baselines.
    - First watering of an MSV4 probe (2026-10-10 19:14, pot 4674 -> 5135 g): watering test PASS,
    +100.76 pF against 8.00 pF needed.
    - Competition script: seven candidates scored in grams against the pot's weighings in
    MSV3/fleet.json, with a between-weighings table. First morning weighing 2026-10-11 (5060 g).
    - Soil thermal records for 10-09 and 10-10; Bode, pole/zero and soil-path figures.
    - Probe sketch at 262163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
2026-10-12 MSV4 v262163-262165: checked ADC calibration, daily mask check, battery saver, measurement LED; tip NTC against die temperature
    Board 1 runs 262165 since 2026-10-11 13:03 PDT on the one-minute test cadence.
    262163 added a DC leak check of the solder mask and an ADC offset calibration
    checked against its own zero; 262165 recentres that check on this board's zero,
    runs the mask check once a day, adds a battery saver below 3500 mV, two LED
    blinks before each measurement, and a five-way calibration experiment that is
    to come out once it has answered. The packet ABI gate, the scanner and the power
    budget follow. The NTC-against-die record and the watering test results for the
    experimental reading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
2026-10-12 Moisture percent: a water-now region replaces the learned range on the receiver
    The learned dry/wet range took 0 % from where the last waterings happened and
    100 % from the peak of the pour, so watering early moved 0 % up and one
    fertilized watering stretched the range. Replayed on stored history and in a
    closed-loop simulation (cloud/docs/MOISTURE_PERCENT_RANGE_AND_FERTILIZER_2026-10-11.md).
    The region takes 100 % from the level the pot settles at 12-24 h after each
    watering and puts the watering line a fixed drop below it, learned once from the
    first two waterings after a calibration reset and then stored. A fertilizing
    moves the region with the scale; a knocked probe gets no region until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
2026-10-12 Receiver water-now-region-v2: the water-now range marked under the meter
    A region-calibrated card gets a small bracket under its moisture meter, from
    the overdue line (-21 %) to the watering line (0 %, the dotted marker): the
    stretch in which the card says WATER NOW. The maintainer picked it from two
    mock-ups (DisplayCenter/docs/WATER_NOW_METER_MOCKUP_2026-10-11.png).
    - display: drawWaterNowRange() draws below drawBar()'s rectangle, in the two
    full draws of a regular card and inside the two value-changed clears, which
    reach three rows further down to cover it; compact cards have no room for it
    - the receiver page and the dashboard bundle (app.v17.js) draw the same bracket
    - the alert-th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
2026-10-12 MSV4: isolate measurement sweep from LED load
2026-10-12 Track October 11 evening pot weight
2026-10-12 Scale battery percent to the measured charge plateau for MSV3 and MSV4
    BQ25504 tapers charging near VBAT_OV, so cells park below the nominal
    ceiling. MSV3 (sensor 4 plateau ~3870 mV) was unscaled; MSV4 used the
    nominal 3889 mV instead of the observed ~3820 mV. Probe 7 (divider not
    reworked) keeps the plain curve.
2026-10-13 MSV4 bring-up: live stream, LED signatures, Lab live panel, SWD --app
    Bring-up sketch: `live [a|b]` streams a 1 MHz conductance/capacitance index
    about six times a second, `moisture loop` repeats the calibrated fit, and
    `stop` sets a flag the sweeps do not clear so it cannot be lost between
    readings. The LED now shows one long flash at boot, two once advertising is
    up, and an 80 ms heartbeat.
    MSV4 Lab: Live response panel (big readouts, zero, 60 s strip chart), parser
    keys for the LIVE and moisture lines, `moisture` in the capture list, 300 ms
    poll.
    swd_flash_hex.py: `--app <hex>` writes an application after the bootloader in
    the same contact hold, refusing any hex outside 0x26000-0xF4000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
2026-10-13 MSV4 batch build guide and LCSC stock refresh
    Repo copy of the batch build guide for the next MSV4 boards, and stock, MOQ
    and price re-checked on 2026-10-11 for the 1 nF C0G, FSUSB42UMX and the
    32.768 kHz crystal.
2026-10-13 Track pot weight through October 13 and plot moisture candidates against it
    fleet.json: Alocasia pot weighings for 10-12 (10:30, 15:39, 19:49, 21:30) and
    10-13 08:22 (median 4905 g), the standing dry-saucer statement, and the MSV4
    inventory (10 PCBs, parts for 5, 5 more builds planned).
    msv4_moisture_plot.py overlays every moisture candidate on the scale curve in
    grams of water; msv4_moisture_tempcorr.py fits a per-candidate temperature
    coefficient on a settled dry day (provisional: one day, not reproduced on the
    second). Plots from each weighing are under data/sensor_logs.
2026-10-14 SWD flash waits on progress, not 60 s; record the first batch MSV4 board
    The 177 KB MSV4 bring-up app hit the fixed 60 s program+verify budget at 95 %
    verified and was reported as a segment failure the adapter never printed. The
    wait now resets on every adapter line (30 s idle, 600 s cap) and a real timeout
    says HOST TIMEOUT. fleet.json records the first finished batch board: R15 =
    3.3 kOhm, flashed with bootloader 1.0.3 + bring-up v262152, running.
2026-10-14 MSV4 Lab: Live response buttons send their commands
    Clicks were delegated from the command console's quick-actions row only, so
    Start live, Live B, Stop and Calibrated stream in the separate Live response
    panel did nothing. Listen at document level for any [data-command] button.
    fleet.json: the first batch board is MSV4-BU-6528 at CB:23:3B:C2:65:28.
2026-10-14 MSV4 Lab: survive OneDrive locking session.json
    A session.json replace that landed while OneDrive was syncing raised
    PermissionError in the console reader thread, killing it mid-stream so every
    later command hung. Retry briefly, then skip: session.json is only metadata.
2026-10-17 Diagnose the moisture candidates' miss against the scale; refit the capacitance temperature term
    Weighings for the shared Alocasia pot from 10-13 22:00 to 10-16 22:46 go into fleet.json.
    The "high when dry, low when wet" pattern is mostly a one-way shift across the 10-10 watering.
    At the same water (0 vs 28 g) and tip temperature (25.4 vs 25.8 C), the candidates read
    +48 to +246 g wetter now. That shift tilts the all-weighing line.
    Temperature is second. Fitted from the weighing intervals, every capacitance candidate needs
    +7.4 to +9.7 g/C, where the dry-day fit gave about 2.5x less. With the new term, the derived
    soil and direct capacitances follow changes between weighings to about 10 g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
2026-10-17 Probe 11: first day of cloud raw sweeps, scored model by model
    121 of 122 sweeps from 10-15 20:36 to 10-16 16:46. The one missing sweep fell inside the
    receiver's v3 flash. The CPE fit is below the firmware's lumped fit on every sweep, with a median
    residual of 60 against 141 (1e-4 of drive). That is at the air floor of 55-63.
    The CPE's series R is not identified: it sits at the 0.1 ohm bound on 49 of 121 sweeps, so the
    375 ohm from the 10-15 capture is not a stable number.
    A step at 11:16-11:26 on 10-16 hit probe 11 only (mask C -11 %, R +10 %). Its cause is not
    known. Temperature coefficients from this one day are provisional.
    Adds the cloud-sweep fetch/fit tool and the electrode models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
2026-10-19 Water-now region: every watering recalibrates; disturbed almost never fires
    Probe 7 lost its region the day after a watering: the noon drydown fell
    502 in an hour (22 % of its scale) and the 20 % rule called it disturbed.
    Underneath, each of its waterings since 10-11 had been held as a shift on
    an older range. That hold resolved only against two earlier first days,
    and a held cycle never added one, so probe 7 never had two and would
    have read overdue 31 h after watering.
    The maintainer wants calibration kept between waterings above all, and
    the user can see a knocked or pulled probe:
    - A settled level at or above the one in force is the new scale at once,
    in both modes. A lower one still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
2026-10-19 Receiver: recover from a TLS stall on its own; relay MSV4 raw sweeps
    On 2026-10-14 every cloud upload failed for 6.7 h while WiFi, DNS and
    the server were healthy; only a reset cleared it
    (DisplayCenter/docs/RECEIVER_TLS_STALL_2026-10-14.md). The receiver now
    records the real TLS error code and heap state for each failed connect
    (/cloud upload.lastTlsFailure) and restarts itself after 30 min with no
    successful upload, at most once per 6 h.
    It also scans actively so it can read MSV4 probes' raw sweeps from their
    scan responses and forward them to the cloud. BleScanFlush.h hands over
    the reports a NimBLE session still holds when a scan is stopped for an
    upload; without it a distant probe lost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
2026-10-19 Cloud: store MSV4 raw sweeps (migration 042)
    receiver-snapshot takes the latest raw sweep the receiver relays for each
    MSV4 probe and stores it in msv4_raw_sweeps, best effort and after the
    history acknowledgement, so a failure here never changes what the
    receiver is told about its history. Deployed since 2026-10-15 (now v33).
    raw-sweeps tests pass with the rest of the function's tests.
2026-10-19 MSV4 board 2: per-board R15, a SAADC window for both boards, raw sweeps
    - Board 2 carries a 3.3 kohm R15. Rs only appears as Rs*Y, so a 1 kohm fit
    read its capacitances 3.3x high; builds now take -RsOhms.
    - The grounded-input zero is a board property (board 2 sits near -11 LSB),
    so the battery-read window accepts -15..-1 LSB; retries are oversampled.
    - From v262172 a measuring wake puts the raw averaged 8-point sweep in its
    scan response, so other electrode models can be fitted to stored data.
    msv4_adv_scan.py decodes it; the Lab and console follow.
    This source built v262172 (prod-rawsweep-rs3300), running on board 2 since
    2026-10-15. MSV4 Lab tests pass (8).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
2026-10-19 MSV4: board 2 bring-up, cup water and salt test, raw-sweep model fits; moisture vs pot weight through 10-18
    - Board 2 (sensor 11) bring-up, its cup test (filtered, tap and salted
    water, a warm bath) and the first electrode-model fits to raw sweeps:
    water and soil rank the models oppositely (a CPE fits soil best).
    - The Alocasia pot's moisture candidates scored against kitchen-scale
    weighings through 2026-10-18. One plot file is kept and replaced on each
    run instead of a dated copy per weighing.
2026-10-19 Fleet registry through 2026-10-18
    Pot weighings for the Alocasia through 10-18 (4613 g, the driest yet),
    probe 7 back in soil and watered (pot not stated), its build read back
    over BLE as 2026-09-14-capless-prod7-restore, and MSV4 board 2's record.
2026-10-19 README: ready for public viewing
    - Who did what, stated once: the hardware, front ends, electrodes,
    enclosures and tests by Sam Amezcua; the firmware and software he
    specified and validated were implemented with AI coding agents.
    - Engineering highlights for a reviewer, each linked to its write-up.
    - Status and milestones as of 2026-10-18 (from MSV3/fleet.json), and what
    comes next.
    - All rights reserved; the repository is public to be read.
2026-10-19 Hardware for every board: schematics, layouts, Gerbers and photos
    From the Altium projects and the summer presentation deck:
    - A fabrication zip per board (Gerbers, drill, pick-and-place, BOM where
    exported): MSV1, MSV2, MSV3 (4 layers), MSV4, DisplayCenter controller.
    - The MSV3 schematic PDF (2026-07-26 export, labelled as predating the
    2026-08-10 sheet edits), schematic overviews decoded from Altium's
    preview images for MSV4 and the receiver, and circuit close-ups.
    - Layout and 3D views, and photos: MSV3 assembly and in its pot, the
    five-probe pot, the MSV2 probe outdoors, the receiver running.
    - A short page per board, and a hardware section near the top of the
    README. Photos r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
2026-10-19 Photo of four assembled MSV4 boards
    From the maintainer's photo (HEIC), cropped and re-encoded as JPEG with
    no EXIF, so no location data. Shown first on the README, the hardware
    section and the MSV4 board page; recorded under the MSV4 batch in
    fleet.json (which board numbers they are was not stated).
2026-10-19 README pass for consistency; a front page for every top-level folder
    The README had grown in layers: MSV4 was described in five places, the
    solar overvoltage and electrode findings in three, with two link lists,
    three overlapping status lists and mixed image sizes and spelling. It is
    now one sequence (how it works, the hardware, four generations,
    engineering highlights, status and next steps, repository guide,
    building, about) with each fact in one place.
    - Every board block and board page uses the same layout: description,
    main parts, board page / schematic / Gerbers, one row of images.
    - MSV1, MSV2, MSV3, MSV4 and cloud get a front page in one format
    (hardware, firmware, tools, write-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
2026-10-19 Second Alocasia watering; weigh the pot without its saucer from now on
    2026-10-19 00:36: 2 cups, 4605 -> 5068 g (463 g, saucer water included);
    sensor 10 stepped 15,837 -> 23,629 within the minute. About 100 g of
    standing saucer water was dumped (4968 g with the emptied dish).
    From here the pot is weighed alone. Log entries now say what was on the
    scale ("weighed": pot_and_saucer / pot_only / saucer_only). The
    moisture scripts add back the saucer's 612 g, measured at the switch
    (4968 - 4356, dish alone 608), so old and new weighings share one scale,
    and skip saucer-only weighings. Self-test passes.
2026-10-19 Alocasia weighed 10 h after the second watering: 4946 g with the dish
    2026-10-19 ~10:44: 4951, 4946, 4945 g, pot with its dish (on the
    original pot-and-saucer scale, no offset). 22 g below the 4968 g of
    pot and emptied dish at 00:45; 341 g above the pre-watering 4605 g.
    Plot and competition table regenerated from fresh sensor 10 history.
    Every candidate reads 390-465 g of water in the pot against 341 g on
    the scale, and fell 25-65 g over the same 10 h the scale lost 22 g.
2026-10-19 Sensor 11 is the Begonia card; its 10-18 step is not yet a stated watering
    The maintainer reported the "begonia" card flashing WATER NOW while
    reading at its maximum. Identified as sensor 11 from the chart and the
    live region (the only sensor at its maximum but under 0 %).
2026-10-19 Alocasia 15:42: 4910 g with the dish, 305 g above the pre-watering weight
    4910, 4909, 4910 g at ~15:42 (read as pot with dish from the magnitude),
    36 g below 10:44. Over those five hours the moisture number in use fell
    39 g against the scale's 36; the temperature-fitted candidates fell
    6-9 g as the tip warmed 21.75 -> 27 C. They still read 345-435 g of
    water against 305 g on the scale.
2026-10-20 Alocasia 21:48: 4899 g with the dish, 294 g above the pre-watering weight
    4896, 4899, 4901 g at ~21:48 (read as pot with dish), 11 g below 15:42.
    Over the evening (tip 27 -> 25 C) the scale lost 11 g; the fitted soil
    readings fell 17-21 g, Cm and soil-coupled C 34-37 g, the number in
    use 8.5 g. Readings now put 335-395 g in the pot against 294 g.
2026-10-20 Alocasia 08:33: 4887 g with the dish, 282 g above the pre-watering weight
    4884, 4887, 4889 g at ~08:33 on 10-20 (read as pot with dish), 12 g
    below 21:48. Overnight (tip 24.75 -> 21.75 C) the scale lost 12 g; the
    number in use fell 8.4 g, the fitted resistances 29-30 g and every
    capacitance 44-46 g. Readings now put 316-350 g in the pot against
    282 g.
2026-10-21 Alocasia 18:36: 4855 g with the dish, 250 g above the pre-watering weight
    4853, 4856, 4855 g at ~18:36 on 10-20 (read as pot with dish), 32 g
    below 08:33. Over the day (tip 21.75 -> 24.75 C) the scale lost 32 g;
    the number in use fell 39.6 g, the fitted resistances 21-23 g and the
    capacitances 17-25 g, reversing the overnight pattern. Readings put
    283-326 g in the pot against 250 g. The 36 h trigger forecast has the
    scale at the 4605 g dry point in 4.24 days; the resistance-based
    readings call it 0.1-0.3 d late, the capacitances 0.75-0.8 d early.
2026-10-21 Alocasia 00:16: 4840 g with the dish, 235 g above the pre-watering weight
    4840, 4840, 4839 g at ~00:16 on 10-21 (read as pot with dish), 15 g
    below 18:36. The tip barely moved (24.50 -> 24.75 C): Cm and the
    soil-coupled capacitance fell 14-15 g with the scale, every other
    reading 2-7 g. Readings put 276-306 g in the pot against 235 g. The
    36 h trigger forecast has the scale dry in 4.59 days; the number in
    use now calls it 0.52 d late, the resistance fits 0.07-0.28 d early
    and the capacitances about a day early.
2026-10-21 Sensor 10 reads wetter at the same pot weight in its second cycle
    New MSV4/scripts/msv4_moisture_cycles.py splits the weighings by watering
    cycle. At the same scale grams, cycle 2 reads above cycle 1: the number
    in use and resistance fits by 21-35 g, Cd and Csoil by about 50-70 g, Cm
    and Cm+Cd-air by about 85 g. All decayed for ~30 h after the 10-19
    watering and have held flat since. Sensitivity per gram over the range
    both cycles cover is close (x1.05 number, x1.24 Cm), so this is an offset,
    not a gain change. Within cycle 2 the number in use sits a flat +34..+43 g
    above the scale. Two cycles cannot tell a step from a drift.
2026-10-21 The 10-19 Alocasia watering had no fertilizer
    Maintainer, 2026-10-21: "no fertilizer was added". This rules fertilizer
    out of sensor 10 reading wetter at the same pot weight in cycle 2.
2026-10-21 Alocasia 12:00: 4827 g with the dish, 222 g above the pre-watering weight
    4824, 4827, 4828 g at ~12:00 on 10-21 (read as pot with dish), 13 g
    below 00:16. Tip 24.75 -> 22.50 C: the number in use fell 9 g with the
    scale, the fitted resistances 24 g and the capacitances 34-36 g.
    Readings put 242-267 g in the pot against 222 g. Against cycle 1 at the
    same weight, Cm's offset fell from ~85 g to 55 g; the number in use's
    holds at 33 g. The 36 h trigger forecast swung: number in use 1.08 d
    late, capacitances 0.26-0.42 d early.
2026-10-22 Alocasia 23:38: 4812 g with the dish; a full dry-down before the next watering
    The maintainer will let the pot dry until its weight plateaus. Probe 7 is in
    a Begonia (which pot and since when not stated).
2026-10-22 Water-now region: fixed once taught, never raised by a watering
    Probe 7's line followed each watering's settled level up, 42,623 -> 44,903
    in ten days, and the interval between waterings fell from 3.3 to 2.1 days:
    a watering before the pot dried left it wetter, the line rose with it, and
    the next prompt came sooner. The region is now fixed at the watering that
    completes its teaching and stored (migration 043); a lower settled level
    still lowers it, nothing raises it, and only a calibration reset clears it.
2026-10-22 Retire the ratcheting autocal range; probe 7 set back to its 10-14 region
    Every autocal=1 request now gets the water-now region (receiver-snapshot
    v35), so no calibration that learns 0 % from where waterings happened can
    be served. Probe 7's calibration reset was backdated to 2026-10-11 00:00 PDT
    at the maintainer's word: water now 42,761, 100 % 43,788, as before the
    10-17 watering raised it. No other sensor was reset.
2026-10-22 Two dark days: no solar charge since 10-21, Alocasia water loss down to 20 g/day
    The maintainer reported 10-22 ~14:07: dark and rainy for 2 days, probes in the
    window not charging, plants taking up less water (fleet.json conditions_log).
    Measured: probes 4, 7, 10, 11 each gained 5-42 mV most days through 10-20
    with a 4-11 C afternoon case warm-up; on 10-21 and 10-22 the gain is 0-2 mV
    and the warm-up 0.25-2.25 C. Over two nights, net: probe 7 -63 mV, probe 4
    -22, sensor 10 -23, sensor 11 -5. The Alocasia scale lost 47-65 g per
    full day on every day weighed before, and 20 g/day from 10-21 12:00 to 10-22 14:03,
    with 222 g of water at the start (cycle 1 lost 47 g/day with 137 g).
    Sensor 10's d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
2026-10-23 MSV4 board 1: the 0-ohm R15 fault was a solder short, not a tombstone
    The maintainer confirmed (2026-10-23) that board 1's third fault was a solder
    short under R15 from excess paste; no part tombstoned. Correct the bring-up
    record and the batch build guide, with a dated correction note.
2026-10-24 Alocasia 10:40: 4734 g with the dish, 129 g above the pre-watering weight
    4733, 4735 g at ~10:40 on 10-24 (read as pot with dish); a third value
    came through as '47434' and is not logged. 45 g below 10:25 on 10-23,
    about double the previous ~23 g/day, and the candidates fell 42-53 g
    with it, so the faster drying is in the sensors too. Gap to the scale:
    number in use +23 g, Cm +9 g, Csoil -2 g. Cycle 2 minus cycle 1 at the
    same weight is now about +15 g for every candidate (Cm was +27 g).
    The trigger forecast printed nothing: it needs 3 weighings in 36 h.
2026-10-25 Receiver restored to msv4-raw-sweep-v3 after a mic-array sketch overwrote it
    Another session flashed a microphone-array test sketch (8 MB partition
    table) onto the receiver on COM16. Its 4 MB LittleFS at 0x310000 was
    read back first and was intact, so a normal upload from main restored
    it: hash verified, cloud upload HTTP 200, sensors 4/7/10/11 received,
    /device reports the same receiver ID. Cloud gap 16:13-16:23 PDT.
2026-10-26 MSV4 boards 3 and 4 flashed and bring-up tested; board 5 has a 3V3 short
    Boards 3 (MSV4-BU-5667) and 4 (MSV4-BU-D7D2) took bootloader 1.0.3 plus the
    v262152 bring-up app over SWD on the COM4 flasher, itself reflashed from main.
    Power, crystal, drive and pin checks pass on both. Electrode A reads the same
    as open on both boards; board 3's B is also tied to ground (about 5 ohm through
    the 1 kohm R15). U3 reflow is next on both. temp fails on both; board 3 has no
    NTC fitted (maintainer). Board 5 is unflashed with a suspected 3V3-GND short.
2026-10-26 Alocasia 16:56: 4623 g with the dish, 18 g above the pre-watering weight
    4618, 4623, 4623 g at ~16:56 on 10-26 (read as pot with dish). 30 g
    below 22:48 on 10-25 in 18.1 h. The number in use fell 37 g and the
    other candidates 17-25 g, so the number's gap to the scale narrowed to
    +13 g while the capacitances widened: Cm +33 g, Csoil +22 g. The 22:48
    weighing now pairs 58 readings and reads number +20, Cm +25, Csoil +19.
    Tip 28.0 C, the warmest weighing so far. Cycle 2 minus cycle 1 at 18 g:
    number -5 g, Cm +14 g, Csoil 0 g. Trigger forecast from the last 36 h:
    scale 0.44 days to 4605 g at 41.2 g/day; every candidate calls it
    0.35-1.5 days late. Only 30 readings pair with this weighing (histor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
2026-10-27 Alocasia 08:22: 4614 g with the dish, 9 g above the pre-watering weight
    4615, 4614, 4611 g at ~08:22 on 10-27 (read as pot with dish). 9 g
    below 16:56 on 10-26 in 15.4 h, about 14 g/day against ~41 g/day over
    the previous days; the 9 g is close to the scale's 8 g repeatability.
    Tip 22.5 C, down from 28.0 C at 16:56.
    Temperature-corrected (as on the plot): over the interval the
    capacitances fell 10-11 g with the scale, the resistances 2-4 g, so the
    number's gap to the scale widened to +17 g (R mask +10) while Cm (+27)
    and Csoil (+19) held. The 16:56 weighing now pairs 59 readings and reads
    number +10, Cm +28, Csoil +20. Cycle 2 minus cycle 1 at 9 g: number +1,
    Cm +6, Csoil -5.
    Trigger forec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
2026-10-27 Probe 11: first full watering cycle of raw sweeps, scored model by model
    Probe 11 (MSV4 board 2) went through one complete watering cycle in its own pot: watered
    10-18 ~13:31 (seen in telemetry only), dried for nine days, watered 10-27 ~12:29 (maintainer).
    fleet.json now records the plant as a Begonia (maintainer confirmed) and the 10-27 watering.
    Measured over 1,604 sweeps (95.6 % of measured wakes; the lost ones are scan responses only):
    - The best-fitting model depends on moisture: RC line below 5 kohm and above 16 kohm, CPE in
    between; the firmware's lumped fit is 1.8-2.3x the best everywhere.
    - At the same Rsoil (16-18 kohm) the soil as first inserted and the soil at the end of the c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
2026-10-27 fleet.json: record which MSV2 probe has alternating vs static electrode drive
    Sensor 1 is the reworked two-plate unit whose firmware swaps the driven plate every
    cycle; sensor 2 kept the single plate with its second comb hard-wired to GND. Both
    facts were only in the sketch comments (2026-07-27/31).
2026-10-28 Alocasia 22:54: 4590 g with the dish, 15 g below the pre-watering weight
    4590, 4590, 4590 g at ~22:54 on 10-27 (read as pot with dish). 24 g
    below 08:22 in 14.5 h (~40 g/day, after ~14 g/day overnight); 26 g/day
    over the 30 h since 10-26 16:56, so no plateau yet. Tip 25.25 C, up
    from 22.5 C.
    First weighing under the 4605 g weighed before the 10-19 watering, so
    it is now the dry point: every "water" figure moved up 15 g and every
    candidate line was refit. The trigger forecast no longer prints (the
    pot is at its own dry point), as expected from the script's design.
    Temperature-corrected (as on the plot): the number fell 22 g and
    R mask 19 g against the scale's 24; Cm fell 14, Csoil 5, Cd-air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
2026-10-28 Probe 10: the 2 %/C correction holds against the scale; the wobble is noon drying
    Asked: can the data tell that the temperature coefficient is wrong, and
    would a better one remove the daily wobble? New msv4_tempco_check.py
    fits the soil-resistance coefficient two ways on probe 10's two
    weighed dry-downs:
    - against the scale (weighing intervals): 2.02 +/- 0.16 %/C cycle 1,
    1.59 +/- 0.38 cycle 2, 1.93 +/- 0.18 both;
    - within the day (drying trend + k*tip): 1.08 and 0.52 %/C.
    The scale alone shows 53-54 % of each day's water leaves 11:00-15:00,
    when the tip also warms, so the within-day fit reads the noon drop as
    temperature. The self-test reproduces this: six synthetic pots with a
    true 2.0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
2026-10-28 Probe 10: the late-cycle wobble is a noon drying staircase, plus an evening rebound
    Asked: if the wobble is not temperature, what is it, and why is there
    more of it late in a dry-down than right after a watering?
    New msv4_daily_staircase.py splits each day's drop at 11:00 and 15:00.
    On the sunny days of late cycle 2 (10-23 to 10-26), 71-83 % of the
    day's drop is in those four hours (25-34 g, against 7-11 g over the
    other 20 h); on the two dark days (10-21, 10-22) it is 22-31 %. The
    scale alone agrees: 6.42 g/h in 11-15 against 0.70 g/h otherwise from
    10-23. The step grows as the pot dries because the round-the-clock loss
    shrinks (other-20-h loss 16.9 g on 10-20, 7-11 g later; cycle 1 the
    sa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
2026-10-28 Receiver: MSV4 display no longer rises between waterings (drying hold)
    The maintainer chose a display hold to remove probe 10's evening
    rebound: from 10-23 the 2 %/C tip correction overshoots at midday and
    rebounds 3.5-19 g each evening, because on those days the soil's raw
    resistance did not follow the tip temperature. No coefficient or
    delayed temperature fixed both watering cycles.
    For MSV4 packets only, smoothMoistureForDisplay() now holds the
    presented value: it follows the symmetric tracker down but not up,
    except on a confirmed watering snap or after the tracker stays above
    it for 36 h (a new insertion settling). Unlike the 2026-08-22 ratchet,
    the hold sits on the tracker's output an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
2026-10-28 Alocasia 14:35: 4568 g with the dish, 37 g below the pre-watering weight
    4567, 4568, 4569 g at ~14:35 on 10-28 (read as pot with dish). 22 g
    below 22:54 on 10-27 in 15.7 h (~34 g/day). Over the last 46 h the pot
    lost 55 g (~29 g/day), against 111 g in the 54 h before that
    (~49 g/day): drying has slowed, no plateau yet. Tip 28.25 C, up from
    25.25 C.
    New dry point is 4568 g, so every "water" figure moved up 22 g and
    every candidate line was refit.
    Temperature-corrected (as on the plot): the number and R mask each fell
    31 g against the scale's 22, closing their gaps to +6 and +4 g. The
    capacitances fell 17-21 g and held or widened: Cm +32, Csoil +36,
    Cd-air +37. Uncorrected, the 3 C warming h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
2026-10-28 Plots: mass vs moisture number and vs Cm; sensor 11 single-RC fits
    msv4_mass_vs_value_plot.py puts the scale on the left axis and one reading
    in its own units on the right (moisture number; Cm raw and temperature
    corrected). msv4_single_rc_fit.py fits series RC, series RC + board Cd,
    and parallel RC to every stored sensor 11 sweep beside the lumped, CPE,
    line and two-branch models, through the same measurement model.
2026-10-28 Mass vs reading plots: calibrate each watering on its own jump
    One watering's gain did not fit the other (number 16.5 vs 15.7 units/g,
    Cm 0.204 vs 0.282 pF/g), so the first cycle's jump missed the scale's.
    Each cycle now uses its own pre-watering anchor and its own gain, with
    the after-weight taken from the first weighing with no water standing in
    the dish (23:54 for 10-10, +432 g; 00:45 for 10-19, +363 g).
2026-10-28 Mass vs reading plots: use the pooled drying fit, as msv4_moisture_plot.py does
    The per-watering jump calibration overshot the drying: the readings change
    12-29% more per gram at a watering than while drying. Each reading is now
    converted by one straight line through every dry-dish weighing (42, both
    cycles), then drawn on the scale's own axis.
2026-10-28 Mass vs reading plots: one fitted line per watering cycle
    Each cycle's reading is converted by its own line through its own dry-dish
    weighings, so it is synced to the scale at that cycle's average weight
    (printed on the plot), with its own slope: number 11.7 then 14.74 units/g,
    Cm 0.144 then 0.222 pF/g. The span before the first watering is not drawn.
2026-10-28 Cross-cycle test: grams each reading misses when calibrated on the other cycle
2026-10-28 Slide figure: moisture reading vs pot weight, calibrated on the other cycle
2026-10-28 Begonia (sensor 11): record first weighing, plastic dish alone 45.6 g
2026-10-28 Begonia (sensor 11): first weighing is 1349 g (pot + dish); 45.6 was fl oz, not the dish
2026-10-28 Begonia (sensor 11): the three first readings all gave the same grams (1349)
2026-10-29 Record MSV4 boards 3-5 bring-up and repairs
2026-10-31 Alocasia (sensor 10): 4671 4672 4671 on 10-31 (41 g under the post-watering 4712); includes the 10-30 watering entries
2026-10-31 Begonia (sensor 11): 1193 1194 1193 on 10-31 (57 g under 10-30)
2026-11-01 Begonia (sensor 11): 1174 on 10-31 evening (19 g under the morning 1193)
2026-11-01 Begonia (sensor 11): 1161 on 11-01 morning (13 g under the 10-31 evening 1174)
2026-11-02 Begonia (sensor 11): 1145 on 11-01 evening (16 g under the morning 1161)
2026-11-02 Alocasia (sensor 10): 4610 4609 4610 on 11-01 evening (61 g under the 10-31 morning 4671)
2026-11-02 Sensor logs: one growing cache per sensor, fixed-name latest plots, archive the dated snapshots
2026-11-02 Add Begonia (sensor 11) moisture-candidate scorer against its weighings
2026-11-02 fleet: sensors 10 and 11 share one shelf (maintainer 11-01); sensor 11 desk note was stale
2026-11-02 Alocasia (sensor 10): 4617 4612 4618 on 11-02 morning (7 g over the 11-01 evening 4610, inside scale error)
2026-11-03 MSV4 enclosures v5.5: minimum-profile arm solar variant + floor-tied PCB pads
    New bonded-seam, no-case-screw minimum-profile body with the existing pivot
    bosses, arms and panel frame (one 5-object 3MF, STLs, STEPs, CAD and slicer
    packs, renders). Both minimum-profile bases now carry the PCB on four 3 x 4 mm
    floor-tied pads. Validator passes with no errors. Also refreshes the sensor 10
    vs mass plot for the 11-02 weighing.
2026-11-03 Alocasia (sensor 10): 4586 on 11-02 night (31 g under the morning 4617)
2026-11-03 Alocasia (sensor 10): 4582 on 11-03 afternoon (4 g under the night 4586)
2026-11-03 Begonia (sensor 11): 1106 on 11-03 afternoon (39 g under the 11-01 evening 1145)
2026-11-04 Begonia (sensor 11): 1091 on 11-04 morning (15 g under the 11-03 afternoon 1106)
    Plot: fit note moved to the empty upper-right corner, one pair per line;
    at the bottom-left it had started covering the newest moisture line.
2026-11-04 MSV4: sensor 11 looks cleaner from pot size, not R15 3.3k
    Per-reading Rsoil noise 0.68 % (board 1, 1k) vs 0.62 % (board 2, 3.3k)
    although the divider moves 1.8x further with 3.3k; the Begonia's reading
    moves 1.7-2.2x further per gram of water, which halves the noise in grams.
2026-11-05 Begonia (sensor 11): 1068 pre-watering on 11-05 afternoon (23 g under the 11-04 morning 1091)
    First pre-watering weight for this pot; ends the drying cycle that began
    with the 10-27 watering. Watering time, amount and post-watering weight
    not yet reported.
2026-11-05 Begonia (sensor 11): watered 11-05 ~14:50, 1068 -> 1347 g (+279 g on the scale)
    Probe saw it at the next soil sweep, wake 29981 at 14:57:18 PST:
    13,287 -> 24,044 (10-27 was 13,365 -> 23,198). Six minutes earlier the
    board temperature fell 25.75 -> 20.75 C with no new sweep and the stored
    number rose ~450 on its temperature correction alone (~90 units/C).
    Plot: a watering line per event; the provisional conversion is fitted on
    the first drying cycle only, and a weighing pairs only with readings on
    its own side of a watering (the 30-min window spanned this one). The fit
    note moved outside the axes, since the new cycle climbs to the top right.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
2026-11-06 Begonia (sensor 11): 1333 on 11-05 evening (14 g under the 1347 right after watering)
    About 7 h after the 11-05 ~14:51 watering. Over the same span the stored
    number fell 24,044 -> 23,216 (wake 30402, 21:58 PST), ~28 g on the
    first-cycle conversion, so it still reads ~60 g above the scale.
2026-11-06 Begonia (sensor 11): 1308 on 11-06 morning (25 g under the 11-05 evening 1333)
    About 19.5 h after the 11-05 ~14:51 watering, 39 g under the 1347 right
    after it. Overnight the stored number fell 23,216 -> 21,955 (wake 31144,
    10:20 PST), ~43 g on the first-cycle conversion against 25 g on the
    scale, so the gap above the scale closed from ~60 g to ~45 g.
2026-11-06 MSV4: Begonia fitting methods, inside cycle 1 and across the 11-05 watering
    The scorer paired the 1068 and 1347 weighings with readings from both
    sides of the watering (56-62 g for everything); it now pairs within a
    cycle, starting at the probe's first sweep after the water, and leaves
    the post-watering weighing out of fits.
    Inside cycle 1 (10 weighings, LOO): resistances and RC-line mask C 9-14 g,
    other mask C 18-22, capacitances 28-53, CPE n 122. Fitted on cycle 1 and
    used on cycle 2, every method reads wetter: sweep mask C +19 to +27 g,
    resistances and the number in use +41 to +55, capacitances +60 to +93,
    all shrinking overnight. Only 2 settled weighings, both 7-20 h after the
    watering,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
2026-11-07 Begonia (sensor 11): 1251 on 11-07 (57 g under the 11-06 morning 1308); cross-watering rerun
    1251 1251 1251 at ~11:03 PST, 44 h after the 11-05 watering and 96 g under
    the 1347 right after it. This is the first weighing past 27 h, so the owed
    cross-watering rerun is done and appended to the 11-06 model-transfer record:
    fitted on cycle 1, the resistances and capacitances closed to -5..+14 g (from
    +47..+132 at 11-05 21:59), so their cycle-2 offset was settling; RC-line mask C
    held at +24..+30 g with the drying slope closest to the scale (-87 vs -82 g),
    an offset rather than a gain. The stored number reads +20 g (was +57, +41).
2026-11-09 Begonia (sensor 11): 1154 on 11-09 (97 g under the 11-07 1251)
    1154 1154 1153 at ~12:37 PST, ~94 h after the 11-05 watering and 193 g
    under the 1347 right after it. No plant named; read as the Begonia by
    weight. The stored number (last-hour median 16,916) converts to 1181 g on
    the first-cycle fit, +27 g above the scale (was +20 at 11-07).
2026-11-10 Alocasia (sensor 10): 4424 on 11-10 (96 g under the 4520 before the 10-30 watering)
2026-11-10 Water-now region: a fixed line no longer moves down either
    Rule 7 still lowered a fixed line by half of a lower settled level. Sensor 10's
    small 10-30 watering (+192 g vs ~462 g) dropped its line 15,127 -> 13,657, so the
    card read 3 % with the pot 96 g drier than at any earlier watering. A fixed line
    now stays put whichever way a watering settles; only a calibration reset moves it.
2026-11-10 Water-now record: deployed 11-10, sensor 10 line restored to 15,127
2026-11-10 Dashboard: write the range served to the display onto the stored snapshot
    The dashboard only learned a sensor's range from the receiver's 18 KB full
    snapshot, which fails while the receiver's TLS heap is fragmented (104 mbedTLS
    allocation failures in 11.6 h on 2026-11-10), so it kept showing each card's
    preset 120/175 range. The autocal pull the display already makes every 10 min
    now also writes the same rows onto the stored latest snapshot's plants.
2026-11-10 Receiver: mbedTLS allocates from PSRAM (tls-psram-v1)
    The core pins mbedTLS to internal RAM, where this receiver's largest free block
    sits at 31,732 bytes. On 11-10 that gave 104 MBEDTLS_ERR_SSL_ALLOC_FAILED connects
    in 11.6 h, a 7,680-byte free-heap low-water and two panics in a row, with 8 MB of
    PSRAM unused. mbedtls_platform_set_calloc_free() now puts its buffers in PSRAM with
    an internal fall-back, the runtime equivalent of CONFIG_MBEDTLS_EXTERNAL_MEM_ALLOC.
    /device reports health.tlsAllocator. Flashed to COM16.
2026-11-10 Alocasia (sensor 10): watered 11-10 ~00:35, 4424 -> 4643.5 (+219.5 g)
2026-11-10 Alocasia (sensor 10) plot through the 11-10 00:35 watering
2026-11-11 Alocasia (sensor 10): 4599 on 11-10 ~17:59 (44.5 g under the 4643.5 after the 00:35 watering)
2026-11-11 Alocasia (sensor 10): 4568 on 11-11 ~14:41 (31 g under 4599 of 11-10 17:59; 75.5 g under the 4643.5 after the 11-10 watering)
2026-11-12 DisplayCenter build-two assembly guide
    Bench checklist for soldering the second DisplayCenter receiver: count the
    last-of DigiKey leftovers, kit in placement order (36 SMD + 4 THT, C10 DNP),
    paste/reflow, unpowered checks, first power, flash, bring-up against the
    COM16 receiver, and the V2 enclosure. Repo copy of the published page.
2026-11-13 Alocasia (sensor 10): 4538 on 11-12 ~17:31 (30 g under 4568 of 11-11 14:41; 105.5 g under the 4643.5 after the 11-10 watering)
2026-11-13 Alocasia (sensor 10): 4530 on 11-13 ~10:49 (8 g under 4538 of 11-12 17:31; 113.5 g under the 4643.5 after the 11-10 watering)
2026-11-14 MSV3 M2 enclosure V6: solar leads opposite USB, LED teardrop, chamfered edges
    Routes both solar-panel wires through the positive-X wall (back-view left,
    opposite the USB receptacle) with the matching channeled arm, closes the
    USB-side arm, restores the V1 water-LED teardrop through the base back over
    D2, and adds a 1.75 mm exterior chamfer to the lid top and base bottom.
    Regenerated STEP/STL outputs, validation reports, the V6 slicer pack and
    renders.
2026-11-14 DisplayCenter: buzzer audition sketch and enclosure print files
    Standalone ESP32-S3 sketch that auditions the replacement passive sounder on
    GPIO38 (locked startup chime and water-warning double buzz at 4% duty), plus
    the sliced enclosure prints (P1S gcode.3mf, solo gcode, base_enclosure_bot.3mf).
